ALiReZa4232/SCARA-Robot-Controller/تصاویر پروژه/IMG_20241123_105836.jpg

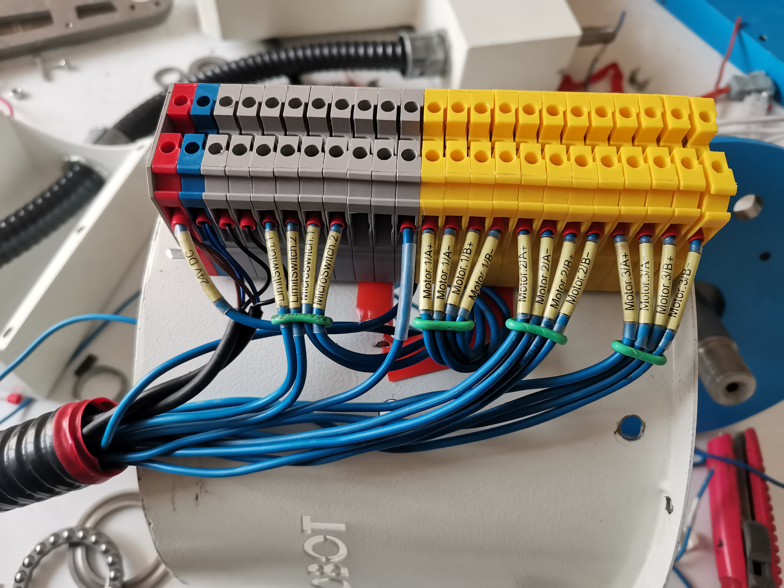
تصاویر پروژه/IMG_20241123_105836.jpg
