ALiReZa4232/SCARA-Robot-Controller/README.md

# SCARA-Robot-Controller
در این پایان‌نامه، به طراحی و پیاده‌سازی یک کنترلر پیشرفته برای ربات اسکارا پرداخته شده است. ربات‌های اسکارا به دلیل دقت و سرعت بالا در انجام وظایف صنعتی، به یکی از پرکاربردترین ربات‌ها در صنایع مختلف تبدیل شده‌اند. هدف اصلی این پروژه طراحی و پیاده‌سازی یک کنترلر پیشرفته برای ربات اسکارا می باشد که باعث افزایش دقت، سرعت، پایداری عملکرد و کارایی ربات در انجام وظایف صنعتی خواهد شد.
کنترلر طراحی شده از یک پردازنده اختصاصی STM32 استفاده می کند این پردازنده به عنوان هسته کنترلی ربات، وظیفه کنترل حرکت و مسیریابی خودکار بصورت خطی و زاویه ای بین موقعیت ها را داراست. همچنین این کنترلر دارای یک نمایشگر برای نمایش اطلاعات کنترلی به صورت محلی و یک وب سرور که امکان کنترل ربات از راه دور را فراهم می‌کند.
کنترلر طراحی شده برای ربات اسکارا یک سیستم الکترونیکی پیشرفته است که وظیفه دارد حرکات دقیق و سریع ربات را کنترل و هماهنگ کند. این کنترلر با استفاده از الگوریتم‌های پیشرفته و تکنیک‌های بهینه‌سازی، توانایی دارد به طور موثر به تغییرات محیطی پاسخ دهد و وظایف تکراری صنعتی را با دقت بالا اجرا کند. هدف اصلی این کنترلر افزایش کارایی، دقت، و پایداری ربات اسکارا در فرآیندهای تولیدی و مونتاژی است.
