ALiReZa4232/SCARA-Robot-Controller/پایان نامه/پایان نامه.pdf

دانشکده شهید منتظری
گروه برق و کنترل

پایان نامه کارشناسی رشته برق گرایش کنترل

عنوان

## طراحی و پیاده سازی کنترلر ربات اسکارا

استاد راهنما
جناب مهندس سید حسین لطفی

نگارش
علیرضا قمصری
محمدجواد محمدزاده

بهمن 1403

فهرست مطالب
فصل اول: معرفی و بررس ی ربات های صنعتی
.3-1 ویژگ ی های انواع ربات های صنعتی 6 |

فصل دوم: معرفی و بررس ی ربات اسکارا

.3-2 ویژگ ی های ربات اسکارا در صنعت 16 |

فصل سوم: معرفی و بررس ی اجزای ربات اسکارا

.2-1-1-3 نحوه تشخیص اتصاالت استپر موتور 26 |

3

فصل چهارم: معرفی و بررس ی کنترلر ربات اسکارا

.2-2-2-4 معرف ی پایه های LCD کاراکتر ی 46 |

4

.4-4 آموزش کار با رابط کاربری کنترلر 63 |
.1-4-4 معرفی منو ی اصلی کنترلر 64 |
.2-4-4 معرفی منو ی تنظیمات پایه 64 |
.3-4-4 معرفی منو ی تنظیمات پیشرفته 67 |
.4-4-4 معرفی منو ی تنظیمات برنامه 69 |
.1-1-5-4 نحوه ارتباط با ماژول 8266ESP 76 |
.2-1-5-4 ویژگی ها ی صفحات وب آنالین 76 |
.3-1-5-4 چالش های صفحات وب آنالین 76 |

5

6

فصل پنجم: س ینماتیک و پروفایلهای حرکتی ربات اسکارا

.2-5 معرفی و بررس ی پروفای ل های حرکتی 100 |
.1-2-5 پروفایل حرکت مثلث ی 100 |
.2-2-5 پروفایل حرکت ذوزنقه ای 101 |
.3-2-5 پروفایل حرکت Curve-S102 |
.4-2-5 مقایسه پروفایل حرکت Curve-S و ذوزنقه ای 104 |
.5-2-5 چالش های پروفایلهای حرکتی 106 |
.6-2-5 پیاده سازی پروفایل حرکت ذوزنقه ای برای استپرموتور 108 |
فصل ششم: برنامه نویسی کنترلر ربات اسکارا
.1-6 پیکربند ی م یکروکنترلر 32STM در محیط IDE Cube114 |
.2-6 معرف ی و بررس ی کتابخانه Configuration SCARA 128 |
.1-2-6 معرفی متغیرهای خارجی130 |
.2-2-6 معرفی متغیرهای داخلی130 |
.3-2-6 معرفی تابع ControllerSetup 130 |
.4-2-6 معرفی تابع ControllerSetting 133 |
.5-2-6 معرفی تابع ReadEncoder 135 |
.6-2-6 معرفی تابع Main137 |

7

.3-6 معرف ی و بررس ی کتابخانه Server 139 |
.1-3-6 معرفی متغیرهای خارجی139 |
.2-3-6 معرفی متغیرهای داخلی139 |
.3-3-6 معرفی تابع extractNumFromCode 140 |
141 | HAL_UART_RxCpltCallback | تابع | معرفی | .4-3-6
.5-3-6 معرفی تابع reseiveSetting142 |
.6-3-6 معرفی تابع reseiveMove145 |
.7-3-6 معرفی تابع reseiveCode146 |
.8-3-6 معرفی تابع sendProgram148 |
.9-3-6 معرفی تابع sendRun 149 |
.10-3-6 معرفی تابع sendPause149 |
.11-3-6 معرفی تابع sendClear151 |
.12-3-6 معرفی تابع sendOk152 |
.13-3-6 معرفی تابع sendSetting 152 |
.4-6 معرف ی و بررس ی کتابخانه Profile Motion153 |
.5-6 معرف ی و بررس ی کتابخانه Setting Basic153 |
.6-6 معرف ی و بررس ی کتابخانه Setting Advanced 153 |
.7-6 معرف ی و بررس ی کتابخانه Setting Program 153 |
.8-6 معرف ی و بررس ی کتابخانه Setting Homing 153 |
فصل هفتم: برنامه نویسی وب سرور کنترلر
.1-7 پیکربند ی ماژول 8266ESP در محیط IDE Arduino 155 |
.2-7 معرفی و بررس ی کدهای آردوینو 158 |
.1-2-7 معرفی تابع setup 158 |
.2-2-7 معرفی تابع loop160 |

8

.3-2-7 معرفی تابع processIncomingSerialData 162 |
.4-2-7 معرفی تابع processOkCommand 163 |
.5-2-7 معرفی تابعtrimDataBuffer 165 |
.6-2-7 معرفی تابع handleReceiveDataRequest166 |
.7-2-7 معرفی تابع handleSendDataRequest 170 |
.8-2-7 معرفی تابع handleCode 171 |
.9-2-7 معرفی تابع handlePositions 174 |
.10-2-7 معرفی تابع handleSetting 176 |
.11-2-7 معرفی تابع sendPositionToController 177 |
.12-2-7 معرفی تابع sendCodeToController 178 |
.13-2-7 معرفی تابع getResentSettingData 181 |
.14-2-7 معرفی تابع getResentPositionsData 182 |
.15-2-7 معرفی تابع extractValueFromCode 183 |
.16-2-7 معرفی تابع saveToEEPROM 184 |
.17-2-7 معرفی تابع readFromEEPROM186 |
.18-2-7 معرفی تابع handleRoot 187 |
.3-7 معرفی و بررس ی کدهای HTML188 |
.4-7 معرفی و بررس ی کدهای Script Java 188 |
.5-7 معرفی و بررس ی کدهای CSS 188 |

## 1 فصل اول: معرفی و بررسی ربات های صنعتی

فصل اول: معرفی و بررسی ربات های صنعتی

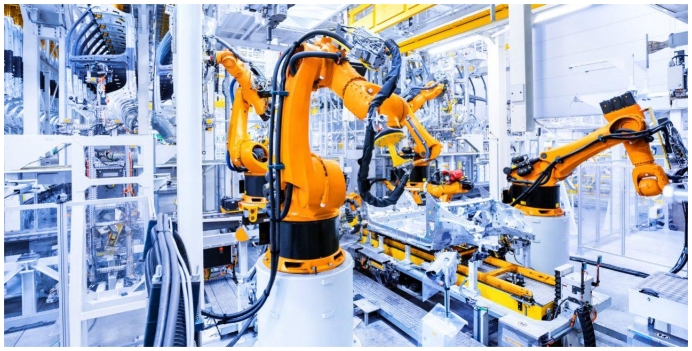
[picture p3: figure]
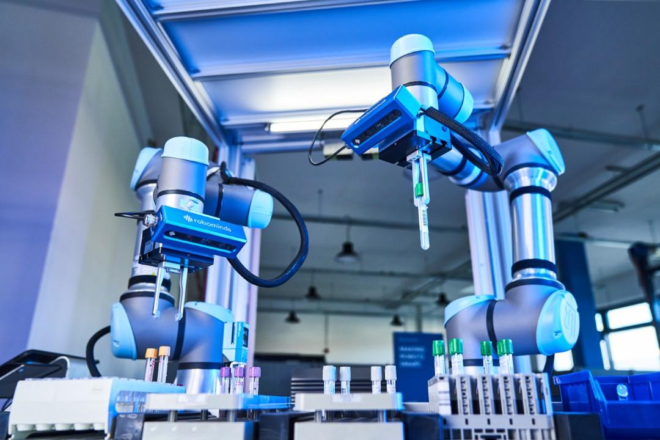
[picture p4: figure]

2

شکل -1 -1 معرفی و بررسی ربات های صنعتی

.1-1 ربات صنعتی چیست؟
رباتهای صنعتی ماشینهای خودکاری هستند که با داشتن قابلیتهای کنترل اتوماتیک، برنامه پذیری و چند منظوره بودن، بیشترین جایگاه را در صنایع گوناگون به خود اختصاص داده است. این رباتها معموالً دارای چندین محور حرکتی هستند و می توانند وظایفی مانند جوشکاری، مونتاژ، بسته بندی و بازرسی را با دقت و سرعت باال انجام دهند . این رباتها اغلب در صنعت و تولید انبوه کاربرد دارند و میتوانند به طور خودکار وظایف تکراری و پیچیده را انجام دهند همچنین آنها وابستگی انسان را کاهش می دهند و بهره وری و ظرفیت فرآیندی را نیز افزایش می دهند .

شکل -1 -2 ربات صنعتی چیست؟

فصل اول: معرفی و بررسی ربات های صنعتی

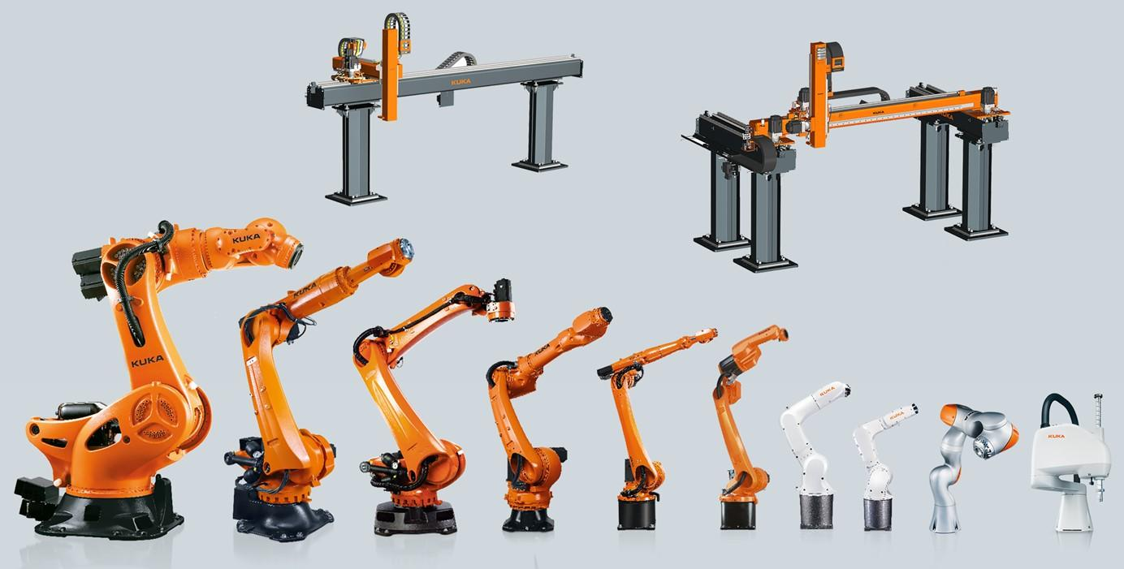
[picture p5: figure]
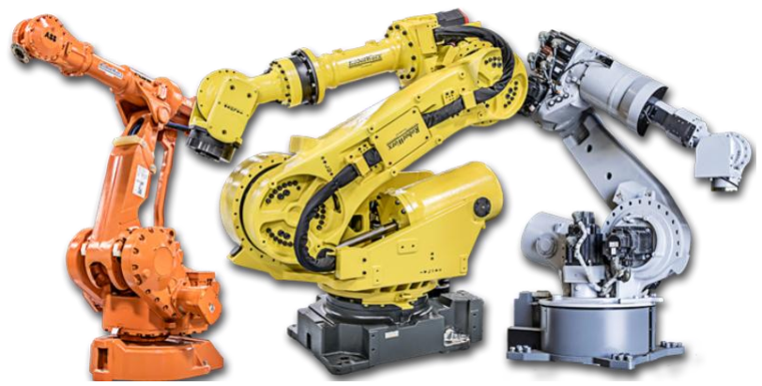
[picture p6: figure]

3

.2-1 انواع ربات های صنعتی
ربات های صنعتی به انواع مختلفی تقسیم می شوند که هر کدام برای کاربردهای خاصی طراحی شدهاند . در این بخش به بررسی مهم ترین انواع ربات های صنعتی می پردازیم:

شکل -1 -3 انواع ربات های صنعتی

.1-2-1 ربات بازویی )Robot Arm) ربات های بازویی یا بازوهای رباتیک، متنوع ترین و پرکاربردترین نوع از انواع ربات های صنعتی هستند . آنها از یک سری اتصاالت چرخشی تشکیل شده اند که توسط موتورهای سروو کار می کنند همچنین این مفاصل، انعطاف پذیری بازوی انسان را تقلید می کنند و فوقالعاده سریع هستند .

شکل -1 -4 ربات بازویی
این ربات ها به طور معمول، میتوانند سه تا شش محور حرکتی داشته باشند که به آنها اجازه می دهد در فضاهای محدود حرکت کنند و کارهای پیچیده را انجام دهند .

فصل اول: معرفی و بررسی ربات های صنعتی

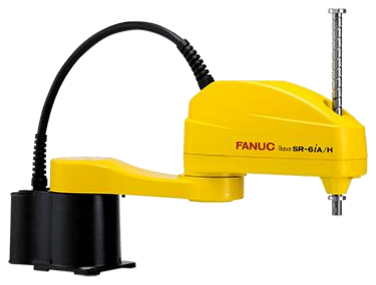
[picture p7: figure]
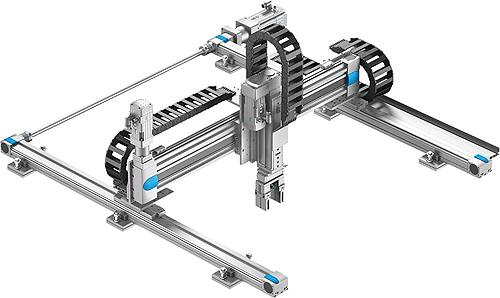
[picture p8: figure]

4

.2-2-1 ربات اسکارا )Robot SCARA) ربات اسکارا یکی از انواع ربات های بازویی می باشد که بدلیل طراحی خاص آن در دسته بندی مجزایی از بازو های رباتیک شناخته می شوند. ربات اسکارا دارای انعطاف پذیری کمتری نسبت به ربات های بازویی است، اما در برخی کاربردها مانند مونتاژ و جابه جایی قطعات کوچک بسیار کارآمد تر هستند.

شکل -1 -5 ربات اسکارا

.3-2-1 ربات کارتزین )Robot Cartesian)
1 | ربات کارتزین که به عنوان رباتهای خطی یا گانتری
نیز شناخته می شود، دارای سه محور خطی
است که به آن اجازه می دهد در یک فضای سه بعدی حرکت کند . هر محور، توسط یک محرک خطی مانند بال اسکرو یا موتور خطی هدایت می شود که امکان حرکت دقیق و مستقل را فراهم می کند .

شکل -1 -6 ربات کارتزین
این بازوها معموالً در کاربردهایی که نیاز به دقت باال و حرکات خطی دارند، مورد استفاده قرار می گیرند .

1 Gantry

فصل اول: معرفی و بررسی ربات های صنعتی

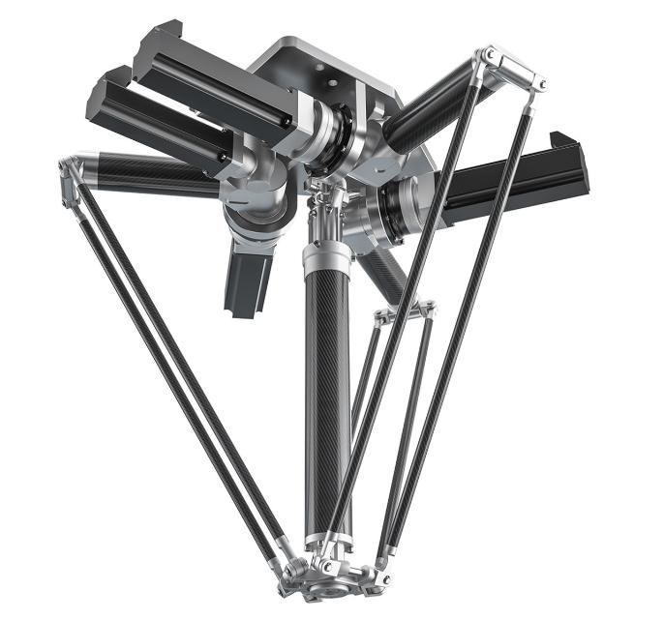
[picture p9: figure]
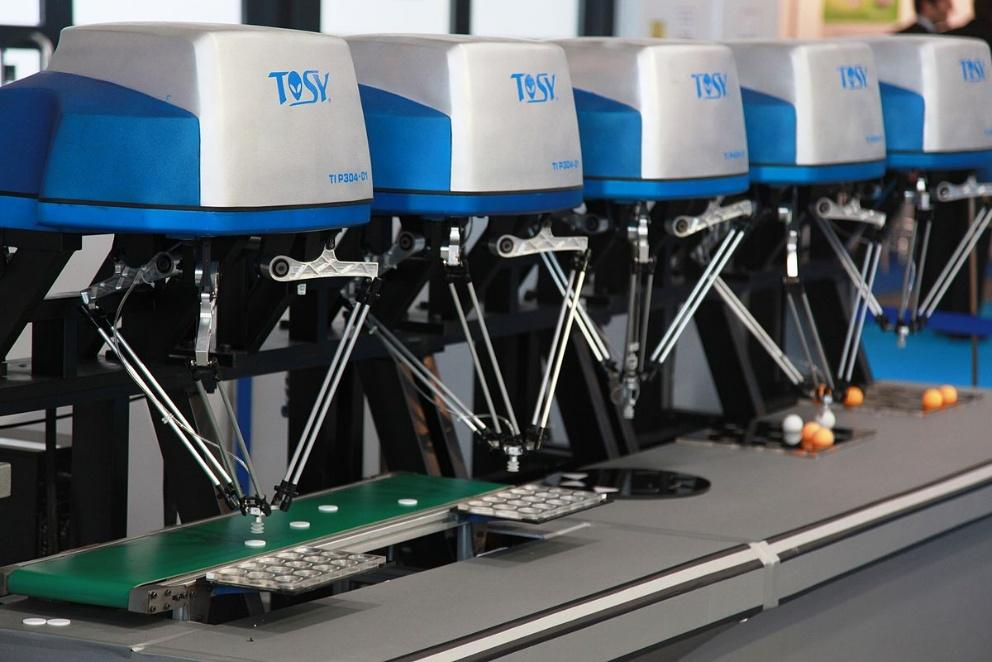
[picture p10: figure]

5

.4-2-1 ربات دلتا یا موازی

1
)Delta Robot(
ربات دلتا گونه ای از انواع ربات های صنعتی هستند که دارای چندین بازوی موازی متصل به یک جایگاه مثلثی شکل می باشند. این جایگاه در باالی محل کار نصب می شود و هر بازو میزبان یک سروو موتور با گشتاور باال می باشد . شفت موتور به بازویی متصل است که در جهت عمود بر محور چرخش موتور امتداد دارد.

شکل -1 -7 ربات دلتا
این بازوها به دلیل سرعت و دقت باال، درکاربردهایی مانند بسته بندی و مونتاژ قطعات کوچک بسیار مفید هستند .

شکل -1 -8 کاربرد ربات دلتا

1 Parallel Robot

فصل اول: معرفی و بررسی ربات های صنعتی

6

.3-1 ویژگی های انواع ربات های صنعتی ربات های صنعتی به دلیل قابلیتهای فراوان و انعطاف پذیری باال، مزایای بسیاری را برای صنایع مختلف به ارمغان می آورند. در این بخش به بررسی مزایای ربات های صنعتی می پردازیم:

- افزایش بهره وری
این ربات ها می توانند وظایف تکراری و زمان بر را با سرعت و دقت باال انجام دهند که منجر به افزایش تولید و کاهش زمان تولید میشود.
- بهبود کیفیت و دقت
این ربات ها میتوانند وظایفی مانند جوشکاری، مونتاژ و بسته بندی را با دقت باال انجام دهند و خطاهای انسانی را به حداقل برسانند .
- کاهش هزینه ها
استفاده از ربات های صنعتی می تواند هزینه های تولید را کاهش دهد . این ربات ها نیاز به استراحت ندارند و می توانند به صورت مداوم کار کنند که منجر به کاهش هزینه های نیروی انسانی و افزایش بهره وری می شود.
- افزایش ایمنی
این ربات ها میتوانند در محیط های خطرناک و با مواد خطرناک کار کنند و خطرات احتمالی را کاهش دهند .
- انعطاف پذیری بال
این ربات ها میتوانند به راحتی برنامه ریزی و تنظیم شوند تا وظایف مختلفی را انجام دهند و به تغییرات محیطی واکنش نشان دهند .
- کاهش زمان توقف
این ربات ها می توانند به صورت مداوم کار کنند و نیاز به تعمیرات و نگهداری کمتری دارند که منجر به افزایش بهره وری و کاهش هزینه ها می شود.
- افزایش سرعت تولید
ربات های صنعتی می توانند وظایف تولیدی را با سرعت باال انجام دهند که منجر به افزایش سرعت تولید و کاهش زمان تولید می شود.

فصل اول: معرفی و بررسی ربات های صنعتی

7

.4-1 چالش های انواع ربات های صنعتی ربات های صنعتی با چالش های متعددی مواجه هستند که می تواند تأثیرات قابل توجهی بر عملکرد و کارایی آنها داشته باشد . در این بخش به بررسی چالش های ربات های صنعتی می پردازیم:

- هزینه های اولیه بال
خرید و نصب ربات های صنعتی نیاز به سرمایه گذاری قابل توجهی دارد که ممکن است برای بسیاری از شرکت ها و صنایع کوچک چالشبرانگیز باشد .
- نیاز به نظارت مداوم
ربات های صنعتی نیاز به نظارت و نگهداری مداوم دارند تا از بروز خطاها و مشکالت مکانیکی جلوگیری شود. این نیاز به نظارت مداوم می تواند هزینه های اضافی برای شرکت ها ایجاد کند و بهره وری را کاهش دهد .
- محدودیت در تطبیق پذیری
ربات های صنعتی نمی توانند به اندازه دست انسان تطبیق پذیر باشند . این محدودیت در تطبیق پذیری
می تواند در برخی کاربردها مشکلساز باشد .
- خطر بیکاری
استفاده گسترده از ربات های صنعتی می تواند منجر به بیکاری کارگران انسانی شود. این موضوع
می تواند تأثیرات اجتماعی و اقتصادی منفی داشته باشد و نیاز به برنامه ریزی دقیق برای مدیریت این تغییرات دارد.
- توقف تولید در صورت خرابی در صورت خرابی ربات های صنعتی، کل خط تولید ممکن است متوقف شود. این توقف تولید می تواند هزینه های زیادی را به شرکتها تحمیل کند و بهره وری را کاهش دهد .
- محدودیت در ظرفیت بار
این محدودیت ها میتوانند در برخی کاربردها مشکل ساز باشند و نیاز به استفاده از ربات های قوی تر و گران تر را ایجاد کنند .
- محدودیت های اتصال
این محدودیت ها می توانند کارایی و انعطاف پذیری بازوها را کاهش دهند و نیاز به استفاده از تکنولوژی های پیشرفته تر را ایجاد کنند .

فصل اول: معرفی و بررسی ربات های صنعتی

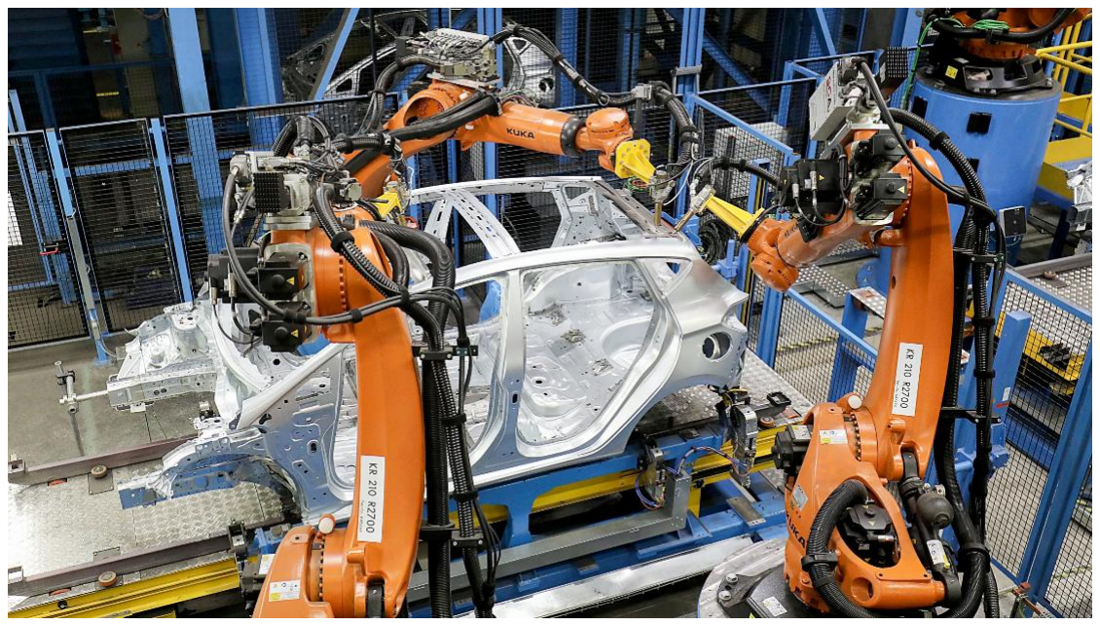
[picture p11: figure]
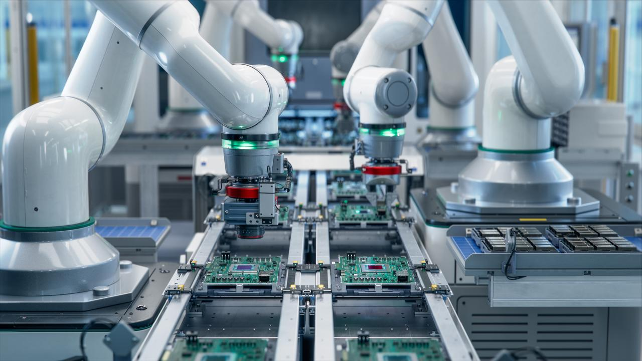
[picture p12: figure]

8

.5-1 کاربردهای ربات های صنعتی ربات های صنعتی به دلیل قابلیتهای فراوان و انعطاف پذیری باال، در صنایع مختلفی بکار گرفته می شوند . در این بخش به بررسی کاربردهای ربات های صنعتی می پردازیم:

- صنعت خودروسازی
این ربات ها می توانند وظایفی مانند جوشکاری، مونتاژ، رنگآمیزی و جابه جایی قطعات را با دقت و سرعت باال انجام دهند .

شکل -1 -9 کاربرد ربات های صنعتی در صنعت خودروسازی
- صنعت الکترونیک
ربات های صنعتی برای مونتاژ قطعات کوچک و حساس بکار می روند . این ربات ها می توانند با دقت باال و بدون خطا، قطعات الکترونیکی را مونتاژ کنند و کیفیت محصوالت نهایی را بهبود بخشند .

شکل -1 -10 کاربرد ربات های صنعتی در صنعت الکترونیک

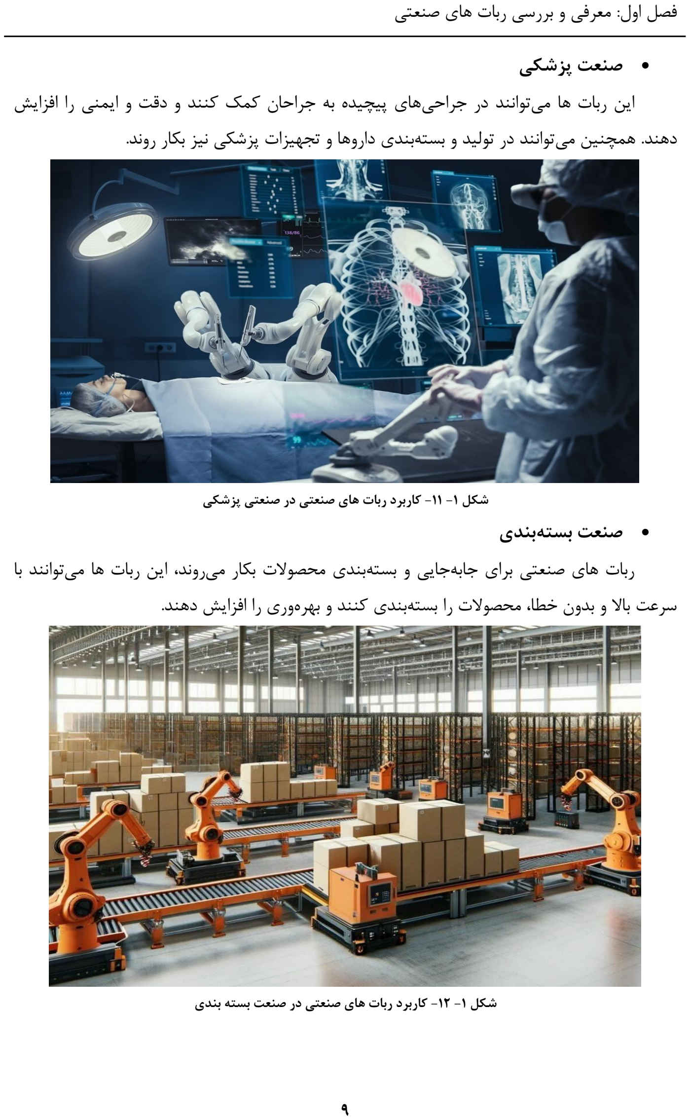
[picture p13: page 17]

فصل اول: معرفی و بررسی ربات های صنعتی

9

- صنعت پزشکی
این ربات ها می توانند در جراحیهای پیچیده به جراحان کمک کنند و دقت و ایمنی را افزایش دهند . همچنین می توانند در تولید و بسته بندی داروها و تجهیزات پزشکی نیز بکار روند .

شکل -1 -11 کاربرد ربات های صنعتی در صنعتی پزشکی
- صنعت بسته بندی
ربات های صنعتی برای جابه جایی و بسته بندی محصوالت بکار می روند ، این ربات ها می توانند با سرعت باال و بدون خطا، محصوالت را بسته بندی کنند و بهرهوری را افزایش دهند .

شکل -1 -12 کاربرد ربات های صنعتی در صنعت بسته بندی

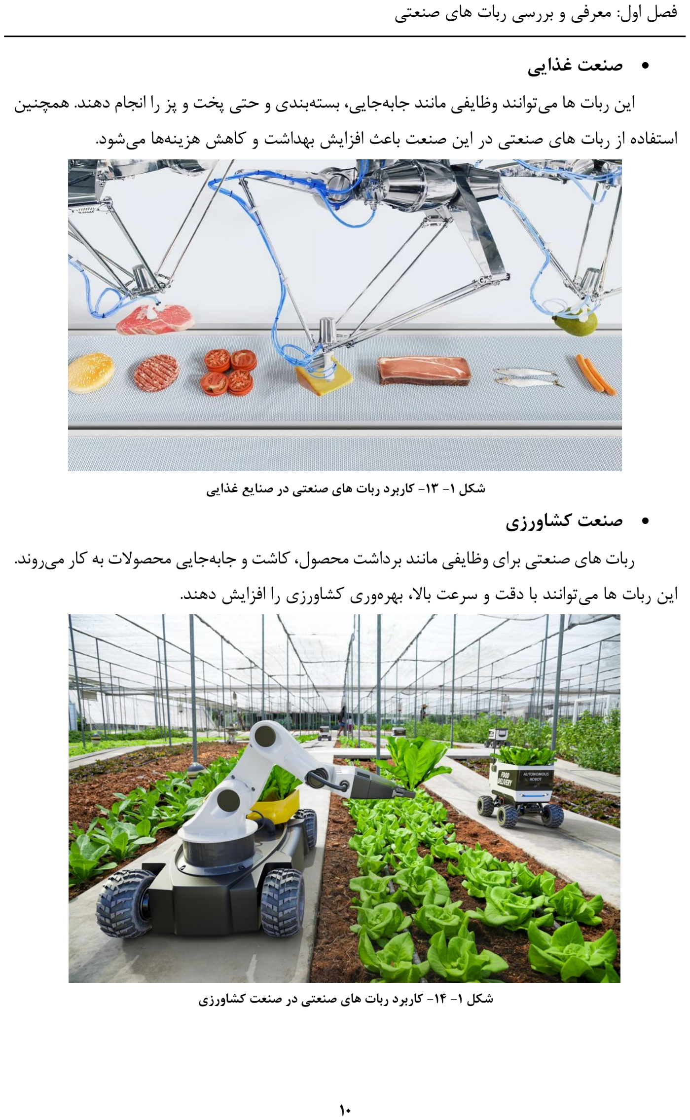
[picture p14: page 18]

فصل اول: معرفی و بررسی ربات های صنعتی

10

- صنعت غذایی
این ربات ها می توانند وظایفی مانند جابه جایی، بسته بندی و حتی پخت و پز را انجام دهند . همچنین استفاده از ربات های صنعتی در این صنعت باعث افزایش بهداشت و کاهش هزینه ها میشود.

شکل -1 -13 کاربرد ربات های صنعتی در صنایع غذایی
- صنعت کشاورزی
ربات های صنعتی برای وظایفی مانند برداشت محصول، کاشت و جابه جایی محصوالت به کار می روند . این ربات ها می توانند با دقت و سرعت باال، بهره وری کشاورزی را افزایش دهند .

شکل -1 -14 کاربرد ربات های صنعتی در صنعت کشاورزی

فصل اول: معرفی و بررسی ربات های صنعتی

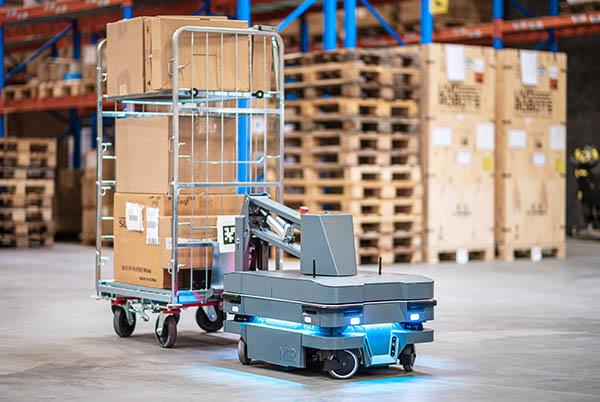
[picture p15: figure]

11

- صنعت حمل و نقل
ربات های صنعتی برای جابه جایی و بارگیری محموله ها به کار می روند . این ربات ها می توانند با دقت و سرعت باال، بهره وری حمل و نقل را افزایش دهند .

شکل -1 -15 کاربرد ربات های صنعتی در صنعت حمل و نقل

## 2 فصل دوم: معرفی و بررسی ربات اسکارا

فصل دوم: معرفی و بررسی ربات اسکارا

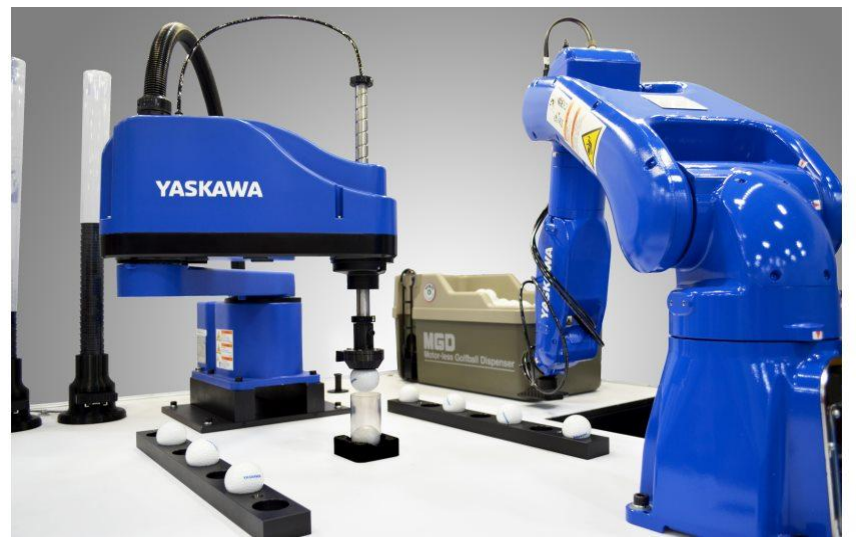
[picture p16: figure]
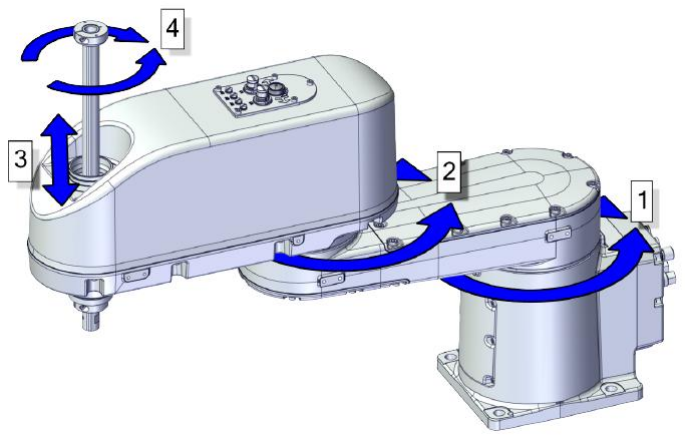
[picture p17: figure]

13

با ظهور فناوری رباتیک، جای تعجب نیست که صنایع بیشتری به ربات ها به عنوان راهی ساده برای افزایش بهره وری و ساده سازی اتوماسیون روی می آورند. از جمله این ربات ها میتوان به ربات اسکارا اشاره کرد که یکی از محبوب ترین و کاربرپسندترین آنها است.

شکل -2 -1 معرفی و بررسی ربات اسکارا
.1-2 ربات اسکارا چیست؟

نام SCARA مخفف Arm Robot Assembly Compliance Selective است به معنی بازوی رباتیک
مونتاژ با تطبیق پذیری انتخابی که به توانایی ربات برای حرکت آزادانه و حفظ صالبت در سه محور در حین سازگاری در محور نهایی اشاره دار د. این ربات ها معموالً دارای سه یا چهار محور هستند که به آنها اجازه می دهد وظایف را با سرعت و
دقت باال انجام دهند .

شکل -2 -2 محورهای ربات اسکارا

فصل دوم: معرفی و بررسی ربات اسکارا

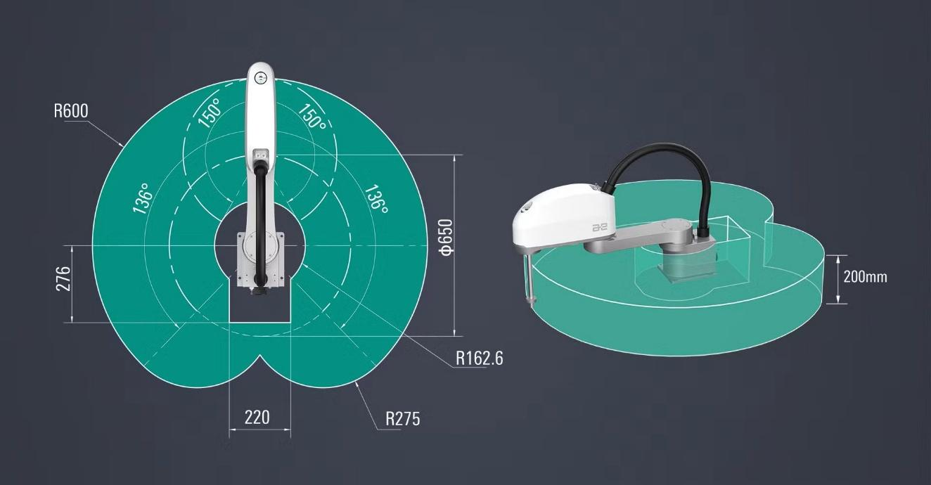
[picture p18: figure]

14

رباتهای اسکارا بدلیل دامنه حرکتی منحصر به فردشان، به ویژه در مختصات XY ، از دیگر رباتهای صنعتی متمایز هستند . این ربات ها می توانند در امتداد محورهای X و Y حرکت کنند این بدین معنا است که آن ها می توانند بین چپ و راست (X (و باال و پایین (Y (حرکت نمایند یا به زبان ساده، می توانند به صورت افقی در هر جهتی در فضای کاری خود حرکت کنن د . همچنین با وجود برخی محدودیت ها می توانند به صورت عمودی حرکت نیز داشته باشند اما در این حالت محور عمودی ثابت خواهد ماند.

شکل -2 -3 دامنه حرکتی ربات اسکارا

این رباتهای مونتاژی، قادر به انجام حرکات انعطاف پذیر و سخت هستند . این نوع انعطافپذیری آنها را برای کارهایی مانند انتخاب و مکان یابی، مرتب سازی و مونتاژ مناسب می کند و استفاده از این نوع ربات، مثل داشتن یک کارگر خط مونتاژ فوق العاده کارآمد است که هیچ وقت خسته نمی شود و اشتباه نمیکند .

فصل دوم: معرفی و بررسی ربات اسکارا

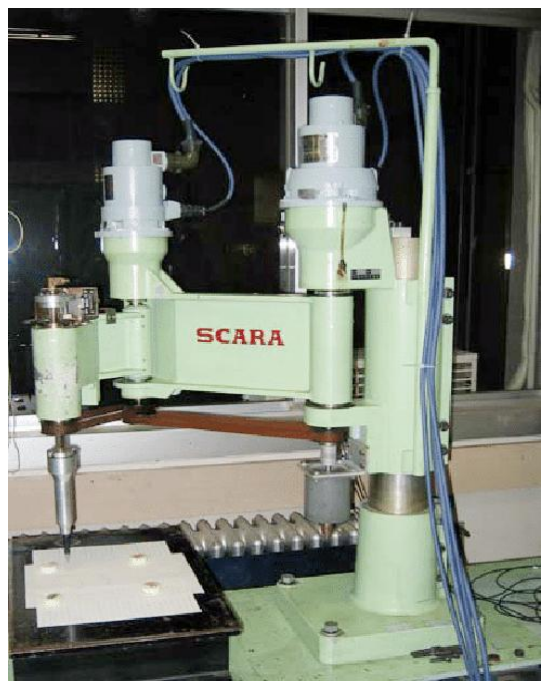
[picture p19: figure]

15

.2-2 تاریخچه ربات اسکارا
1 | رباتهای اسکارا سابقه ای طوالنی و قدیمی دارند . در سال ،1977 پروفسور هیروشی ماکینو
از
دانشگاه یاماناشی در سمپوزیوم بین المللی ربات های صنعتی در توکیو ژاپن شرکت کرد . در این رویداد، او شاهد یک اختراع انقالبی در ربات مونتاژ SIGMA بود. ماکینو با الهام از اولین ربات مونتاژکننده، کنسرسیوم ربات اسکارا را تشکیل داد که شامل 13 شرکت ژاپنی بود. هدف این گروه بهبود بیشتر ربات های مونتاژ از طریق تحقیقات اختصاصی بود. کنسرسیوم به سرعت کارکرد و اولین نمونه اولیه آن ها از ربات اسکارا یک سال بعد و در سال 1978 انجام شد . آن ها ساخته خود را بر روی طیف وسیعی از کاربردهای صنعتی آزمایش کردند و طراحی موجود را بیشتر بهبود بخشیدند و نسخه دوم را دو سال بعد منتشر کردند .

شکل -2 -4 یکی از نمونه های اولیه ربات اسکارا

هنگامی که اولین ربات تجاری اسکارا در سال 1981 عرضه شد، از آن به عنوان یک طراحی رباتیک پیشگامانه استقبال شد . این ربات ارائه شده، نسبت به قیمت، عملکرد بسیار مطلوبی داشت و فرآیندهای تولید صنعتی را در سراسر جهان متحول کرد.

1 Hiroshi Makino

فصل دوم: معرفی و بررسی ربات اسکارا

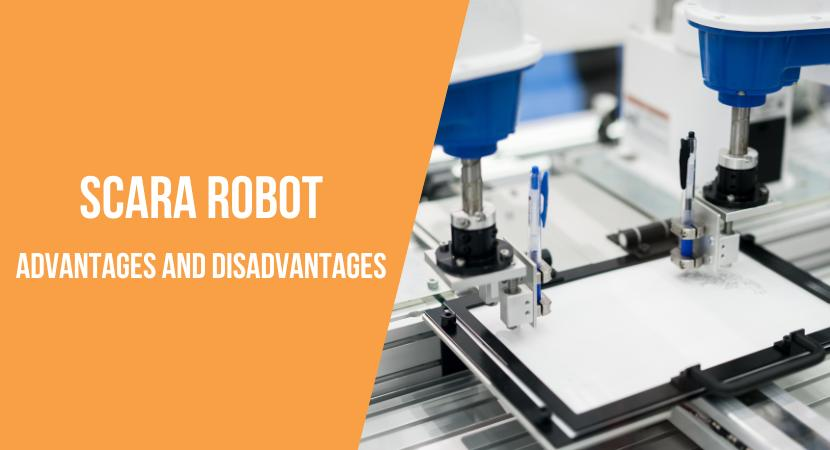
[picture p20: figure]

16

شکل -2 -5 مزایا و معایب ربات اسکارا
.3-2 ویژگی های ربات اسکارا در صنعت رباتهای اسکارا بدلیل قابلیتهایی که دارند، مزایای زیادی می توانند برای استفاده کنندگان داشته باشند . از جمله این مزایا می توان به موارد زیر اشاره کرد:
- دقت بال
ربات اسکارا به دلیل دقت باورنکردنی شناخته می شود که آن را برای کارهایی که نیاز به مونتاژ دقیق دارند، عالی می کند . محور ثابت Z آنها از حرکات غیرضروری باال و پایین جلوگیری میکند و کمک قابل توجهی به این دقت می کند .
- سرعت بال
رباتهای اسکارا از سریع ترین ربات ها در دنیای ربات های صنعتی هستند و پس از رباتهای دلتا در
رتبه دوم از لحاظ سرعت قرار دارند که این سرعت باال برای کارهای تولیدی که نیاز به پردازش سریع دارند مفید است.
- فشرده بودن و حجم کم
ربات اسکارا در مقایسه با سایر ربات ها نسبتاً کوچک است. این ربات محدوده عملیاتی کوچکی دارد
که آنرا برای فضاهای کاری محدودتر منحصر به فرد می کند .

فصل دوم: معرفی و بررسی ربات اسکارا

17

- مقرون به صرفه
یک ربات اسکارا، ارزش بسیار خوبی از نظر هزینه ارائه می دهد . اندازه جمع و جور آن به این معنی
است که به مواد زیادی برای ساخت نیاز ندارد و قطعات متحرک کمتری نسبت به سایر انواع ربات )به عنوان مثال ربات های بازویی( دارد که همه این عوامل باعث کاهش هزینه ها می شود و آن ها را به انتخاب هوشمندانهای برای تولیدکنندگان با بودجه کم، تبدیل میکند .
- ادغام آسان
رباتهای اسکارا میتوانند به راحتی در سیستم های خودکار موجود ادغام شوند و در کنار سایر ماشینها بهخوبی کار کنند . این رباتهای چهار محوره، چه در حال برداشتن و قرار دادن، مونتاژ، مراقبت از ماشینها یا توزیع مواد و غیره همه کارهای هستند که کار را آسان تر و کارآمدتر می کنند .
- برنامه نویسی و راه اندازی آسان عالوه بر این، برنامه نویسی این رباتها نیز بسیار آسان است، به خصوص اگر از نرم افزار RoboDK
به عنوان نرم افزار برنامه نویسی ربات خود استفاده می کنید . کتابخانه این نرم افزار شامل ده ها ربات محبوب اسکارا است.

فصل دوم: معرفی و بررسی ربات اسکارا

18

.4-2 چالش های ربات اسکارا در صنعت با تمام این مزایا، همانطورکه در باال ذکر شد، چالش های زیادی نیز می توانند برای استفاده کنندگان داشته باشند . از جمله این چالش ها را می توان به موارد زیر اشاره کرد:
- دامنه حرکت محدود
این نوع ربات به یک فضای کاری نسبتاً کوچک و خاص محدود می شود. همچنین به اندازه انواع دیگر رباتها مانند رباتهای صنعتی 6 محوره انعطاف پذیر نیستند .
- قابلیت های محدود
1 | از نظر قابلیت استفاده، آن ها بسیار عقبتر از ربات های مدرن )ربات های مشارکتی
( هستند که برای
کار در کنار انسانها طراحی شدهاند و معموالً 6 محور ارائه می دهند .
- ظرفیت بار محدود
با وجود اینکه این ربات ها سرعت باالیی را ارائه می دهند؛ تمایل دارند در اندازه بار خود محدود باشند . باالترین باری که رباتهای اسکارا میتوانند تحمل کنند در حدود 30 تا 50 کیلوگرم است، درحالی که بازوهای ربات های صنعتی 6 محوره می توانند تا 2000 کیلوگرم را تحمل کنند .

این چالش ها انواع وظایفی را که ربات اسکارا برای آنها مناسب است محدود می کنند و آنها را برای کارهایی که به انعطاف پذیری، دامنه حرکت یا سازگاری بیشتری نیاز دارند، نامناسب میسازند .

1 Collaborative Robot - Cobot

فصل دوم: معرفی و بررسی ربات اسکارا

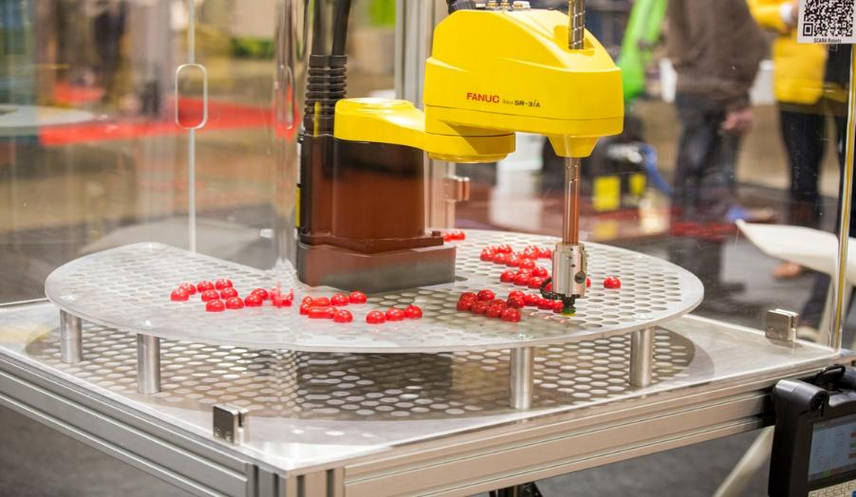
[picture p21: figure]
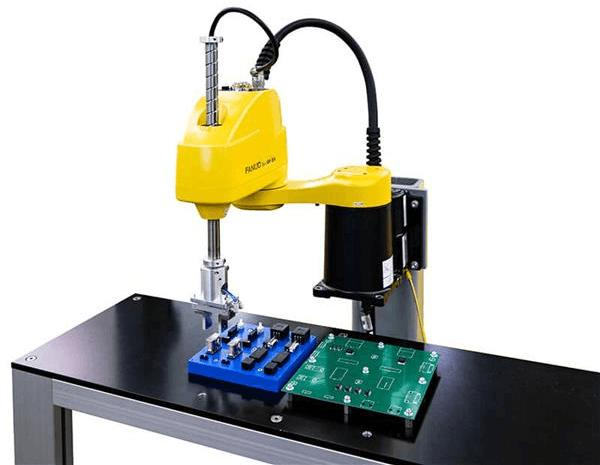
[picture p22: figure]

19

.5-2 کاربردهای ربات اسکارا در صنعت رباتهای اسکارا ماشینهایی هستند که به طور هدفمند ساخته شدهاند و دارای مکانیک منحصر به فردی هستند که آن ها را برای کاربردهای خاص ایده آل میکند . این کاربردها عبارت اند از:
- عملیات انتخاب و جاسازی
وقتی صحبت از مقرون به صرفه بودن و سرعت در کارهای انتخاب و جابه جایی به میان می آید، رباتهای اسکارا بیرقیب هستند . راهاندازی این نوع ربات فوقالعاده آسان است و شما می توانید از آنها انتظار داشته باشید که با استفاده از ابزارهای مختلف اثرگذار، محصوالت را به طرز ماهرانه ای انتخاب کنند .

شکل -2 -6 فرآیند انتخاب و جابجایی توسط ربات اسکارا
- مونتاژ
ربات اسکارا نقش مهمی در تولید و خطوط مونتاژ، از جابه جایی مواد و مرتب سازی اقالم گرفته تا جایگذاری قطعات در کنار هم دارند . آن ها در صنایعی مانند الکترونیک که شامل مونتاژ طرح های پیچیده هستند، بسیار محبوب می باشند .

شکل -2 -7 فرآیند مونتاژ توسط ربات اسکارا

فصل دوم: معرفی و بررسی ربات اسکارا

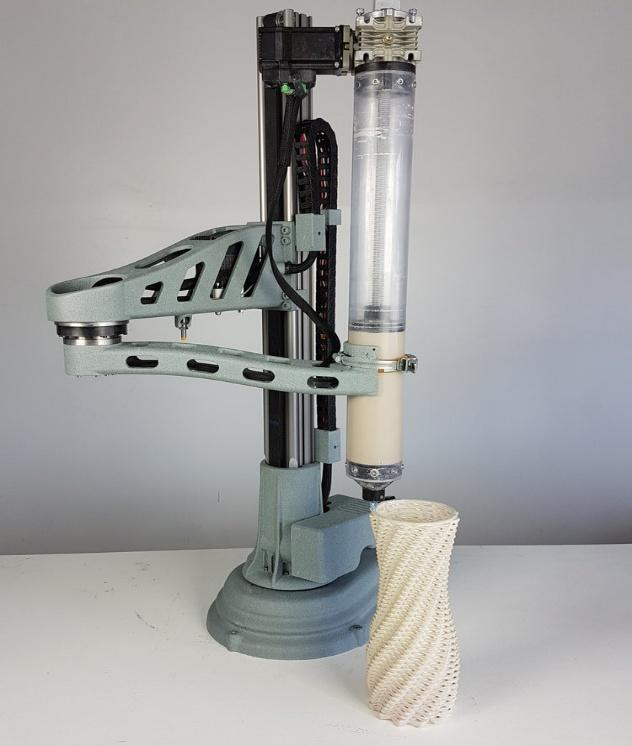
[picture p23: figure]

20

- پرینتر سه بعدی

با معرفی رباتیک، پرینترهای سه بعدی روز به روز در صنایع مختلف به ویژه در تولید، محبوبیت بیشتری پیدا کرده است. در حالی که ربات های 6 محوره اغلب می توانند برای پروژه های پرینت سه بعدی بزرگ تر استفاده می شوند، رباتهای اسکارا برای کاربردهای پرینت سه بعدی در مقیاس کوچک مفید هستند .

شکل -2 -8 فرآیند پرینت سه بعدی توسط ربات اسکارا
- بستهبندی و پالت سازی
عملیات جابهجایی مواد، مانند بسته بندی، پالت گذاری و برچسب زدن، معموالً یکنواخت هستند . رباتهای اسکارا می توانند این وظایف تکراری را به طور خودکار انجام دهند و درعین حال از مدیریت راحت و دقیق فرآیند اطمینان حاصل کنند .
- توزیع و پخش مواد
استفاده از چسبها، رنگ آمیزی، آب بندی، کارهایی است که همه از ربات اسکارا بهره می برند . این رباتها نه تنها این وظایف را بادقت و نتایج کلی بهتر انجام می دهند؛ بلکه به کاهش ضایعات و بهبود دقت کار در طول فرآیند توزیع کمک می کنند .

فصل دوم: معرفی و بررسی ربات اسکارا

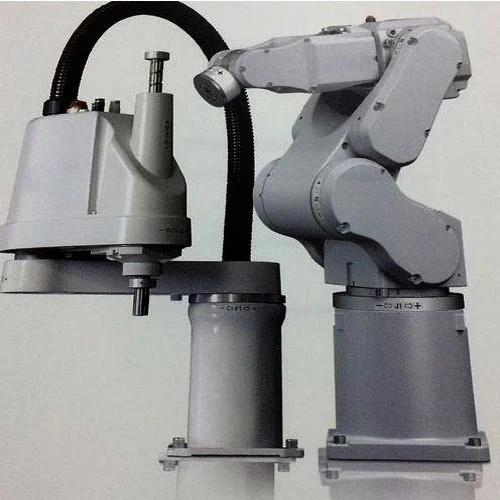
[picture p24: figure]

21

.6-2 تفاوت ربات اسکارا با سایر انواع رباتها رباتهای اسکارا از چند جهت با رباتهای صنعتی استاندارد 6 محوره متفاوت هستند . یکی از تفاوت های اصلی در نحوه طراحی آن ها است.

شکل -2 -9 تفاوت ربات اسکارا با سایر انواع ربات ها

واضحترین تفاوت این است که یک ربات 6 محوره دارای شش محور یا درجه آزادی است که به آن ها امکان می دهد در طیف گسترده ای از جهات حرکت کنند و وظایف خود را در محورهای مختصاتی مختلف انجام دهند؛ اما ربات های اسکار تنها چهار محور یا درجه آزادی دارند . از آنجایی که این رباتها فقط چهار محور برای کنترل دارند، در مقایسه با سایر انواع رباتهای صنعتی بسیار سریع هستند همچنین برنامه ریزی این ربات ها ساده می باشد؛ زیرا سینماتیک معکوس موجود در این رباتها، بسیار ساده تر از بازوهای رباتیک صنعتی با 6 درجه آزادی است. یکی دیگر از تفاوت های کلیدی بین ربات های اسکارا و رباتهای 6 محوره، دامنه حرکت آن ها است. رباتهای اسکارا دامنه حرکت محدودی در صفحه عمودی دارند؛ زیرا بازوی آن ها برای حرکت در درجه اول در صفحه افقی طراحی شده است که این باعث میشود برای کارهایی که نیاز به حرکات دقیق یا جابهجایی قطعات کوچک در یک فضای کاری خاص دارند، مناسب باشند؛ اما برای کارهایی که به دامنه وسیعی از حرکات عمودی یا حرکات پیچیده نیاز دارند، کمتر مناسب هستند . عالوه بر این، ربات های اسکارا معموالً کوچک تر و فشرده تر از رباتهای 6 محوره هستند و ادغام آن ها
در فضاهای کاری کوچک تر را آسانتر می کند . همچنین سریع تر و دقیق تر از ربات های 6 محور هستند که آنها را برای کارهایی که نیاز به مونتاژ با سرعت باال یا جابه جایی قطعات کوچک دارند، مناسب می کند .

## 3 فصل سوم: معرفی و بررسی اجزای ربات اسکارا

فصل سوم: معرفی و بررسی اجزای ربات اسکارا

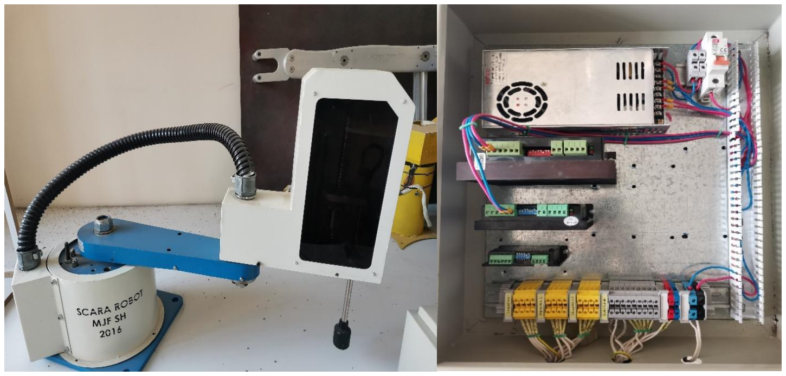
[picture p25: figure]

23

در فصل های پیشین بطور کامل درمورد ربات های صنعتی بخصوص ربات اسکارا بحث شد اما در
این فصل قرار هست بطور تخصصی درمورد ربات ساخته شده در دانشگاه بپردازیم. ربات اسکارا بطور کلی از دو بخش مکانیک ربات و تابلو کنترل یا فرمان ربات تشکیل می شود.

شکل -3 -1 تابلو فرمان و مکانیک ربات اسکارا
.1-3 مکانیک ربات اسکارا
مکانیک یا بدنه اصلی ربات اسکارا متشکل از سه محور می باشد که دو محور آن بصورت چرخشی
یا مفصلی هستند که به یکدیگر متصل شده اند و محور نهایی نیز یک محور خطی می باشد که به عنوان محور Z ربات شناخته می شود. در هر سه محور ربات از موتور های پله ای یا استپر موتور به عنواع محرک استفاده شده است که در
محور اول و دوم به صورت مستقیم کوپل شده است و در محور نهایی نیز از یک بال اسکرو استفاده شده که به واسطه پولی و تسمه به موتور متصل شده است. سنسورهای استفاده شده در این ربات به عنوان تنظیم کننده محدوده مجاز حرکت بازوهای ربات اسکارا می باشند که سنسور محدود کننده محور اول و آخر از نوع میکروسوئیچ می باشد و محور دوم نیز از سنسورهای القایی بهره گرفته شده است. در ادامه به بررسی کامل تری از مشخصات اجزای مکانیک ربات اسکارا می پردازیم. در ابتدا به تعاریف و مفاهیم اولیه این اجزا و سپس مشخصات دقیق هر یک خواهیم پرداخت.

فصل سوم: معرفی و بررسی اجزای ربات اسکارا

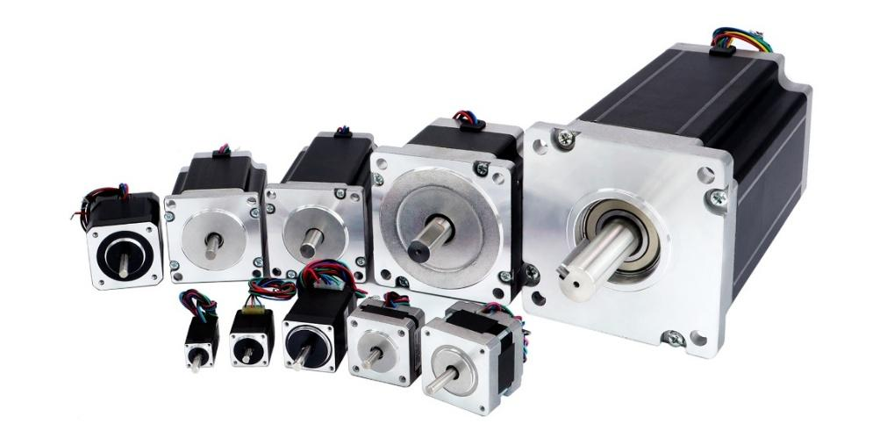
[picture p26: figure]
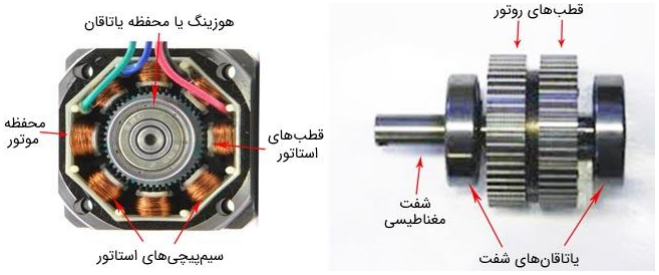
[picture p27: figure]

24

.1-1-3 معرفی و بررسی استپر موتور

1
2 | استپرموتور که به نام موتور پله ای هم شناخته می شود یک موتور براشلس
یا بدون جاروبک است
که یک دورکامل را به تعدادی پله تقسیم می کند و بدلیل وجود این پله ها توانایی حرکت گسسته یا پله به پله را دارد.

شکل -3 -2 معرفی و بررسی استپر موتور
استپر موتور از دو قسمت اصلی روتور و استاتور تشکیل شده است. روتور این موتورها معموال یک
آهن ربای مغناطیس دائم است. این روتورها توسط استاتورهای سیم پیچی شده احاطه شدهاند . هنگامی که سیم پیچها به صورت گام به گام و با یک ترتیب خاص فعال می شوند و جریان درون آنها روانه می شود، باعث خواهد شد استاتورها مغناطیسه شده و قطب های الکترومغناطیسی بر روی آن ایجاد شود و روتور دروان کند. این قطب های مغناطیس شده اساس کار موتورهای استپر می باشند .

شکل -3 -3 ساختار داخلی استپر موتور

1 Stepper Motor
2 BLDC Motor

فصل سوم: معرفی و بررسی اجزای ربات اسکارا

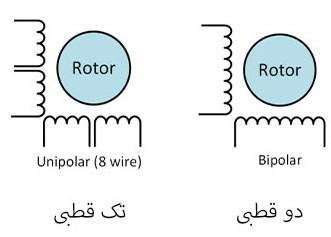
[picture p28: figure]
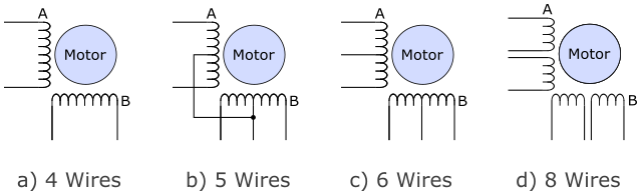
[picture p29: figure]

25

.1-1-1-3 سیم بندی استپر موتور
و تک قطبی | 1 | سیم بندی استپر موتور به دو دسته دو قطبی

2
تقسیم می شود. استپر موتورهای دو
قطبی دو سیم پیچ مجزا دارند که انتهای هر یک از آن ها به صورت دو رشته سیم از موتور بیرون آمده است؛ حال آنکه در موتورهای تک قطبی چهار سیم پیچ مجزا وجود دارند .

شکل -3 -4 انواع سیم بندی استپر موتور
در استپر موتورهای تک قطبی شارش جریان در سیم پیچها همیشه در یک جهت است ولی در استپر موتورهای دو قطبی باید به طور مداوم جهت جریان در سیم پیچها عوض شود و همین امر راه اندازی این گونه موتورها را کمی دشوارتر می کند . استپر موتورهای 4 سیمه را تنها می توان به صورت دو قطبی یا Bipolar راه اندازی کرد ولی موتورهای
5 و 6 و 8 سیمه به هر دو روش قابل راه اندازی هستند. قبل از راه اندازی هر نوع استپر موتور برای اجتناب از اتالف وقت با استفاده از یک اهم متر نحوه اتصاالت استپر موتور را تشخیص دهید .

شکل -3 -5 انواع روشهای اتصال سیمپیچها در استپر موتورها

1 Bipolar
2 Unipolar

فصل سوم: معرفی و بررسی اجزای ربات اسکارا

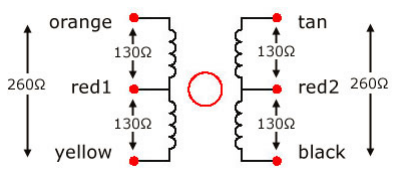
[picture p30: figure]

26

.2-1-1-3 نحوه تشخیص اتصالت استپر موتور در استپر موتورهای 8 سیمه )شکل6-3( که انعطاف پذیر ترین شکل سیم پیچی را دارند دو سر هر چهار سیم پیچ در دسترس می باشد. برای اینکه بفهمید کدام دو سیم مربوط به کدام سیم پیچ است با استفاده از اهم متر دو سر هر زوج سیمی را به طور مجزا به اهم متر وصل کنید در صورت مشاهده مقاومتی بین 10 تا 200 اهم می توان گفت که آن دو سیم مربوط به یک سیم پیچ هستند در غیر این صورت اگر مقدار مقاومت بینهایت یا بسیار زیاد بود آن دو رشته سیم مربوط به یک سیم پیچ نیست.

شکل -3 -6 استپر موتور 8 سیمه

در استپر موتورهای 6 سیمه سیم پیچ ها دو به دو با هم سری شده اند و سر وسط آن ها در دسترس
می باشد. برای تشخیص نحوه اتصاالت در استپر موتورهای 6 سیمه نیز به طریق مشابه می توان با استفاده از اهم متر عمل کرد. فقط توجه شود که در این حالت مقدار مقاوت بین سر مشترک و دو سر یکی از سیم پیچهای سری شده نصف مقدار مقاومت بین دو سر دو سیمپیچ سری شده با هم می باشد . )شکل7-3(

شکل -3 -7 نحوه تشخیص اتصالت در استپر موتور 6 سیمه

فصل سوم: معرفی و بررسی اجزای ربات اسکارا

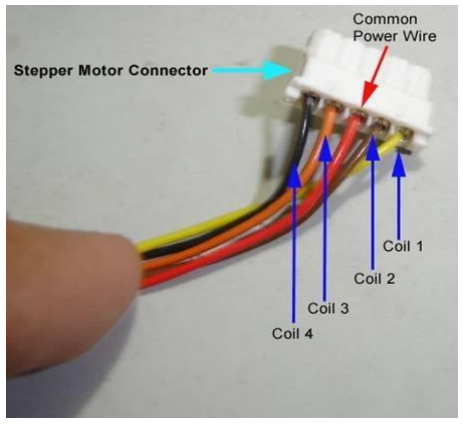
[picture p31: figure]

27

در استپر موتورهای 5 سیمه سرهای مشترک به هم وصل شده و به عنوان سیم پنجم از موتور بیرون کشیده شده است )شکل8-3( در این حالت به طور مشابه میتوان با استفاده از اهم متر اتصاالت را تشخیص داد. توجه کنید که در این حالت نیز مقدار مقاومت بین هر یک از سیم پیچ ها و سر مشترک نصف مقدار مقاومت بین دو سیم پیچ می باشد .

شکل -3 -8 استپر موتور 5 سیمه

در استپر موتورهای 4 سیمه که به صورت دو قطبی سیم بندی می شوند از ساده ترین روش اتصاالت
سیم بندی استپر موتور است. در این مدل استپر موتورها هم می توان با استفاده از اهم متر مقدار مقاومت بین هر یک از سیم پیچ ها را تشخیص داد.

شکل -3 -9 نحوه تشخیص اتصالت در استپر موتور 4 سیمه

همچنین می توان با گذاشتن مولتی متر بر روی تست دیود )حالتی که در صورت وصل کردن دو پراب به هم مولتی متر بوق می زند ( این تشخیص را داد. بد ین صورت که در صورت اتصال مولتی متر به یک س یم پیچ صدای بوق شنیده خواهد شد.

فصل سوم: معرفی و بررسی اجزای ربات اسکارا

28

.3-1-1-3 تعداد فاز استپر موتور در استپر موتورها ممکن است تعداد مختلفی سیم پیچ وجود داشته باشد. اما این سیم پیچ ها ب ه
شکل گروه هایی به نام فاز با هم در ارتباط هستند. تمامی سیم پیچ های یک فاز با یکدیگر شروع بکار می کنند. استپر موتور ها عموما دارای 2 فاز هستند، اما استپر موتورهای 3 فاز و 5 فاز هم موجود هستند. عموما فازهای بیشتر قدرت استپر موتور را بیشتر خواهند کرد.

جدول -3 -1 مقایسه انواع استپر موتورها از نظر تعداد فاز
استپر موتور دو فاز استپر موتور سه فاز استپر موتور پنج فاز
| سرعت کارکرد کم متوسط زیاد
| دقت کارکرد کم متوسط زیاد
| صرفه اقتصادی زیاد متوسط کم
| موجودی بازار زیاد کم متوسط
| گام حرکت پیش فرض 1.8 درجه 1.2 درجه 0.75 درجه

به طور معمول زمانیکه نیاز به دقت و سرعت باال داشته باشیم، از استپ موتور 5 فاز استفاده می کنیم.
زیرا این نوع از موتور پله ای، با درایور معمولی، لرزش بسیار کمی ایجاد می کند و نیازی به درایو میکرو استپ ندارد. از سوی دیگر اگر بخواهیم حرکت هایی با رفت و برگشت زیاد و سریع داشته باشیم، به سراغ استپ موتور 3 فاز می رویم. با این حال استپ موتور 2 فاز با درایور معمولی لرزش زیادی را ایجاد می کند و نیاز به استفاده از درایوهای پیشرفته با قابلیت میکرو استپ می باشد.

.4-1-1-3 سایز استپر موتور
استپر موتورها بر اساس سایز فلنج طبقه بندی می شوند بدین صورت در دو استاندارد قابل بیان
1 | هستند. اولین و پرکاربردترین استاندارد یا نماد تحت عنوان نیما یا
NEMA شناخته می شود که این
استاندارد به ابعاد خارجی فلنج بر حسب اینچ اشاره دارد بطور مثال یک استپر موتور 17 NEMA دارای ابعاد 1.7 اینچ مربع می باشد یا یک استپر موتور 34 NEMA دارای ابعاد 3.4 اینچ مربع می باشد.

1 National Electrical Manufacturers Association

فصل سوم: معرفی و بررسی اجزای ربات اسکارا

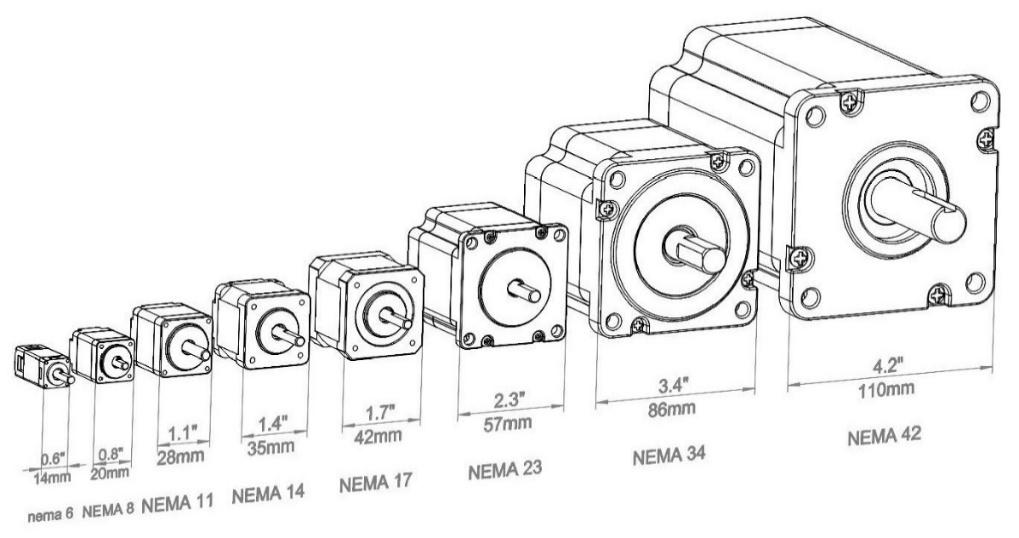
[picture p32: figure]

29

البته این استاندارد ها بر اساس اینچ درکدگذاری محصوالت جدید برندهای مختلف در حال کمتر
شدن می باشد و بیشتر ترجیح می دهند که بر حسب میلی متر آنرا بیان کنند . بطور مثال برای یک استپر موتور 17 NEMA که سایز فلنج آن 1.7 اینچ مربع می باشد با عدد 42 برحسب میلی متر بیان می کنند.

شکل -3 -10 ابعاد و اندازه های مختلف انواع استپر موتورها

.5-1-1-3 گام استپر موتور
منظور از گام، کوچک ترین چرخش قابل کنترل در استپر موتور است که بر حسب زاویه بیان می شود. استپ موتورها بسته به نوع کاربرد با گام های مختلف ی ساخته می شوند . بطور مثال اکثر استپر موتورها دارای گام 1.8 درجه می باشند بدین معنا که هر پله استپر موتور با پله دیگر به میزان 1.8 درجه اختالف زاویه دارد.
از آنجایی که استپر موتور برای چرخش یک دور کامل باید 360 درجه طی کند می توان با تقسیم
این عدد بر میزان گام استپر موتور تعداد پله ها را مشخص کرد در نتیجه می توان گفت یک استپر موتور با گام 1.8 درجه دارای 200 پله می باشد.

.6-1-1-3 گشتاور استپر موتور
1 | در استپر موتور از گشتاور به عنوان گشتاور نگهداری
یاد می شود که به حداکثر گشتاور استپر موتور
در حالت سکون اشاره دارد. این گشتاور در استپر موتور زمانی ایجاد می شود که موتور به درایو متصل است اما موتور حرکتی نمی کند. به همین دلیل مقدار این گشتاور در مقایسه با مقادیری که در زمان حرکت استپر موتور ایجاد می شود، بیشتر خواهد بود.

1 Holding Torque

فصل سوم: معرفی و بررسی اجزای ربات اسکارا

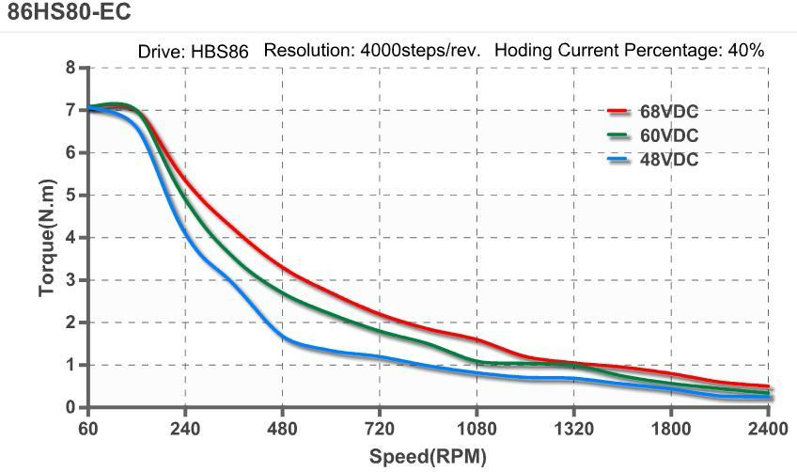
[picture p33: figure]

30

هرچه دور یا سرعت استپر موتور بیشتر شود، گشتاور نگهداری آن کمتر خواهد شد. به عبارت بهتر رابطه میان گشتاور و دور استپر موتورها بر اساس منحنی شکل 4-3 مشخص می شوند .

شکل -3 -11 منحنی گشتاور دور یک نمونه استپر موتور

البته روش اتصال سیم های استپر موتور در کنار ولتاژ اعمال شده بر روی آن، از متغیرهای تاثیرگذار
بر روی این منحنی است. با این حال نکته ای که به وضوح با استفاده از این منحنی به دست می آید، این است که پس از سرعت 200 تا 300 دور، گشتاور تولید شده توسط استپر موتور به شکل قابل توجهی افت پیدا می کند به همین خاطر از استپر موتورها بیشتر در سرعت های پایین استفاده می شود.

فصل سوم: معرفی و بررسی اجزای ربات اسکارا

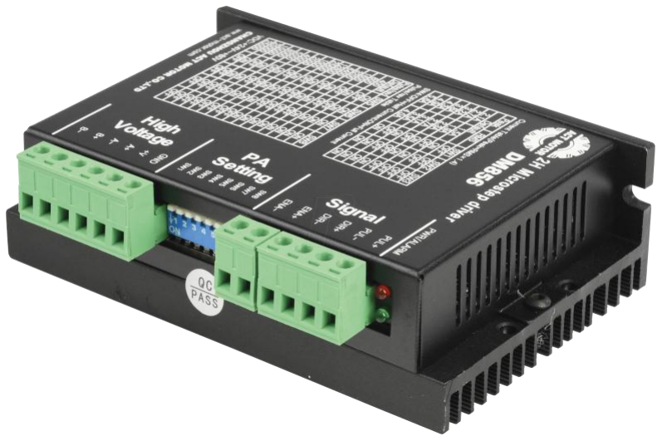
[picture p34: figure]

31

.2-3 تابلو فرمان ربات اسکارا در تابلو فرمان ربات اسکارا تجهیزاتی همچون درایو استپر موتور، منبع تغذیه، ترمینال ها و کنترلر
جای می گیرد که در ادامه به بررسی کامل تری از مشخصات اجزای تابلو فرمان ربات اسکارا می پردازیم. در ابتدا به تعاریف و مفاهیم اولیه این اجزا و سپس مشخصات دقیق هر یک خواهیم پرداخت.

.1-2-3 معرفی و بررسی درایو استپر موتور به منظور افزایش سرعت و دقت استپر موتورها معموالً با درایورهای مخصوصی کنترل میشوند که امکان تنظیم جریان و ولتاژ را فراهم می کنند، به این ترتیب به کاهش لرزش و افزایش گشتاور کمک می کنند .

شکل -3 -12 معرفی و بررسی درایو استپر موتور

درایورهای استپر موتور وظیفه دارند که پالسهای ولتاژ را به گونه ای به فازهای استپر موتور بدهند
که شفت استپر موتور حرکت کند . این پالس ها باید جریان کافی را برای س یم پیچ های موتور فراهم کند تا امکان حرکت استپر موتور با گشتاور کاف ی فراهم گردد. از طرفی هم باید کنترل جریان فازها به نحوی صورت پذ یرد که جر یان موتور بیش از حد زیاد نشود
که منجر به آس یب دیدن استپر موتور شود. عالوه بر این باید امکان رس یدن به حداکثر جریان در زمان کوتاه نیز برای س یم پیچ های موتور فراهم شود. همه این موارد بر عهده درایور استپر موتور می باشد. درایورها در اصل بخش کنترل و یا برنامه ریزی تولید سیگنال کنترل ی نیستند؛ بلکه واسطی برای دریافت سیگنال از کنترلر و تقویت آن در قالب پالس های جریانی به سمت استپر موتور ها هستند . لذا اساس راه اندازی درایورهای استپ موتور در چگونگی برنامه ریزی کنترلر می باشد.

فصل سوم: معرفی و بررسی اجزای ربات اسکارا

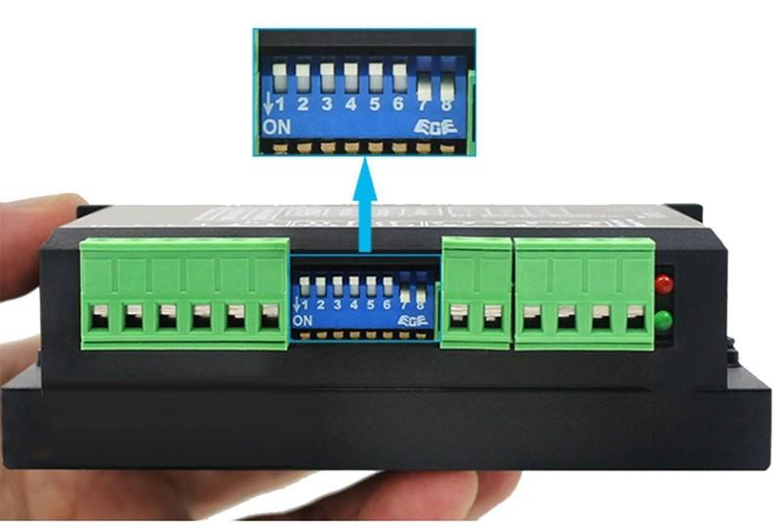
[picture p35: figure]

32

.1-1-2-3 مفهوم میکرو استپ

1
همانطور که می دانید استپر موتورها دارای یک زاویه گام پیشفرض هستند . در صورتیکه دقت حرکتی بیشتر از این مقدار نیاز باشد، می بایست از قابلیت میکرو استپ درایور که به صورت دیپ سوئیچ هایی روی درایور تعبیه شده استفاده نمود و با استفاده از کنترلر، فرمان های حرکتی را به آن منتقل کرد.

شکل -3 -13 دیپ سوئیچ های تنظیم میکرو استپ درایو استپر موتور

بنابراین میکرو استپ تکنیکی است که هر گام کامل استپر موتور را به گام های کوچکتر و دقیق تر تقسیم می کند . در این روش درایور، پالس ها را بین سیم پیچ های مختلف موتور به شکلی تقسیم می کند که استپ موتور توانایی حرکت بین استپ ها ب ه شکل دقیق پیدا می کند. برای مثال برای تقسیم شدن یک پله به 16 پله دیگر به یکی از سیم پیچ ها 1/16 و به سیم پیچ بعدی /16 15 از جریان را اختصاص می دهد، در مرحله بعدی /16 2 و 14/16 اختصاص داده می شود و همین روند ادامه خواهد داشت. درایوی که پله های استپر موتور را به میکرو استپ تبدیل می کند در حقیقت جریان الکتریکی را در محور یک موج سینوسی افزایش و کاهش می دهد. در این روش هیچ قطبی به شکل کامال خاموش یا روشن وجود ندارد. هرچه تعداد میکرو استپ ها بیشتر باشد، دقت حرکت استپر موتور هم باالتر می رود و تا حد زیادی
می توان لرزش ایجاد شده در استپ موتور را کنترل کرد. با این حال استفاده از این روش می تواند گشتاور موتور را کاهش دهد .

1 Micro Stepping

فصل سوم: معرفی و بررسی اجزای ربات اسکارا

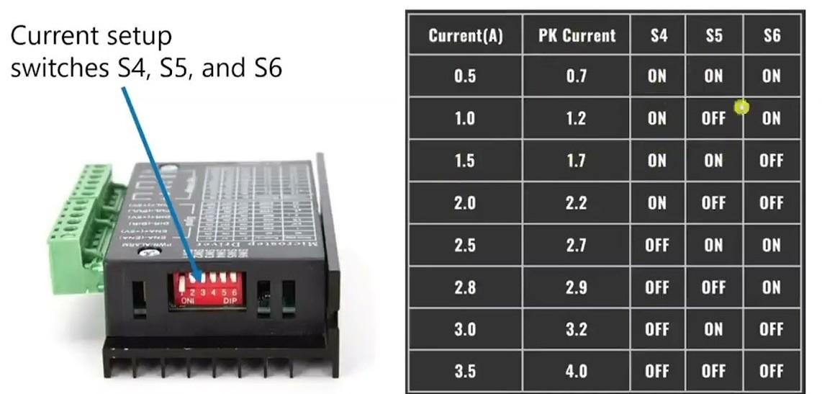
[picture p36: figure]

33

.2-1-2-3 تنظیم حد جریان مجاز برای تولید گشتاور در استپر موتور، باید سیم پیچ ها جریان الکتریکی دریافت کنند، پس جریان مصرفی توسط استپر موتور ارتباط مستقیمی با نوع کارکرد و گشتاور استپ موتور خواهد داشت و یکی از عوامل مهم در تعیین قدرت استپ موتور خواهد بود. همانند قابلیت میکرو استپ درایو برای تنظیم حد جریان استپر موتور نیز می توان از دیپ سوئیچ هایی که در کنار دیپ سوئیچ های تنظیم میکرو استپ درایو قرار دارند استفاده نمود . توجه داشته باشید که همیشه میزان حد جریان تنظیمی از حداکثر جریان قابل تحمل سیم پیچ های استپر موتور کم تر باشد.

شکل -3 -14 تنظیم حد جریان مصرفی استپر موتور

.3-1-2-3 انتخاب منبع تغذیه مناسب برای رسیدن به بهترین کارایی، انتخاب منبع تغذیه مناسب از اهمیت زیادی برخوردار است. اگر سرعت کار استپر موتور باال باشد باید ولتاژ خروجی تا سقف مجاز باال برود که ولتاژ باالتر برای تغذیه، باعث لرزش موتور در سرعت های پایین شده و احتمال خرابی را برای درایو افزایش می دهد اما اگر سرعت مورد نیاز زیاد نیست بهتر است ولتاژ تغذیه پایین تر انتخاب شود که باعث کاهش نویز و حرارت و افزایش کارایی می شود
اگر بار تحمیل شده به استپر موتور زیاد باشد باید جریان خروجی منبع تغذیه باال باشد تا گشتاور بیشتری ایجاد شود که این عوامل باعث گرم شدن زیاد موتور و درایو خواهد شد و سیستم خنک کننده مورد نیاز می باشد.

فصل سوم: معرفی و بررسی اجزای ربات اسکارا

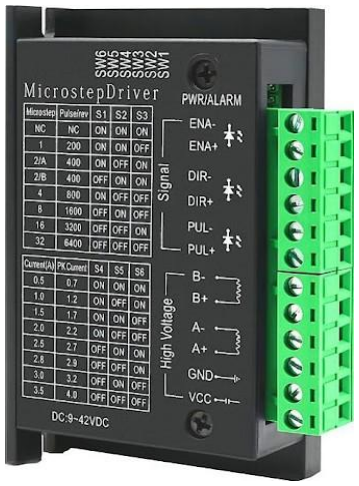
[picture p37: figure]

34

جدول -3 -2 ولتاژ مورد نیاز استپر موتور متناسب با سایز آن
| سایز استپر موتور ولتاژ مورد نیاز
| استپر موتور 8 NEMA الی 17 NEMA VDC 24 – 12
| استپر موتور 23 NEMA VDC 48 – 24
48 – 100 VDC / 30 – 70 VAC | NEMA 34 موتور استپر
| استپر موتور 42 NEMA VAC 220 – 110

.4-1-2-3 ترمینال های سیگنال ورودی درایو ترمینال های درایو استپر موتور در تمامی مدل ها به سه بخش اتصاالت کنترلر و اتصاالت موتور و اتصاالت منبع تغذیه تقسیم بندی می شوند.

شکل -3 -15 ترمینال های درایو استپر موتور
- ترمینال سیگنال ENA
این ورودی برای فعال و غیر فعال کردن درایو استپر موتور کاربر دارد. در صورت دریافت ولتاژ توسط
این ورودی، استپر موتور آزاد خواهد شد و چراغ سبز روی درایو چشمک خواهد زد و در صورت آزاد بود این ترمینال، استپر موتور زیر بار خواهد رفت و چراغ سبز ثابت روشن خواهد بود. سطح صفر پالس بین 0 الی 0.5 ولت بوده و سطح یک پالس نیز بین 4 الی 5 ولت می باشد. اگر ولتاژ ورودی باالتر از 5 ولت باشد باید یک مقاومت محدود کننده جریان بصورت سری با ورودی قرار گیرد.

فصل سوم: معرفی و بررسی اجزای ربات اسکارا

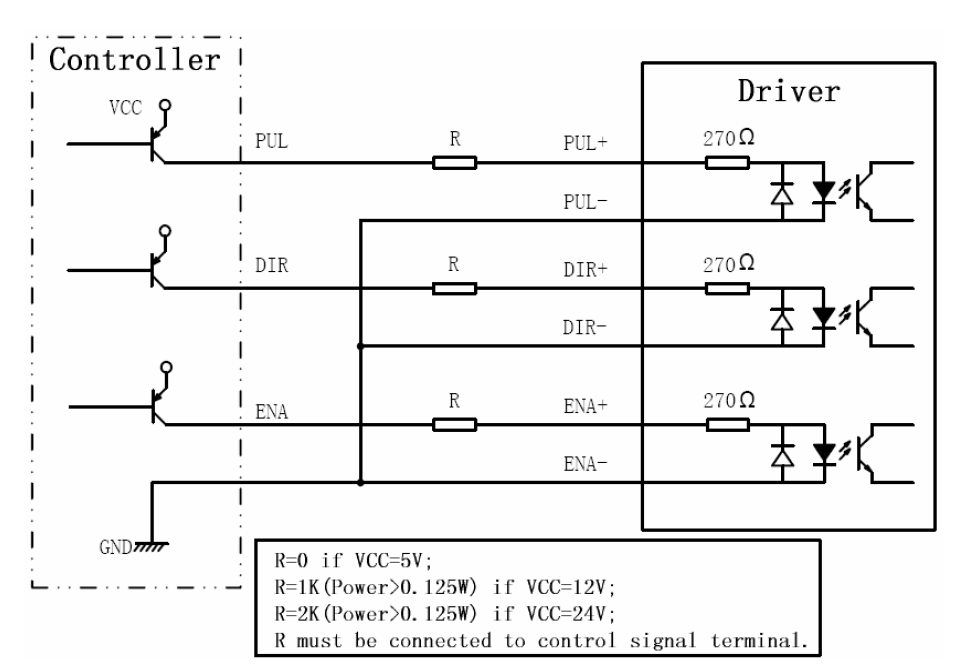
[picture p38: figure]

35

- ترمینال سیگنال DIR
این ورودی برای تعیین و تغییر جهت چرخش استپر موتور کاربرد دارد، برای تغییر جهت چرخش باید این ترمینال یک ولتاژ در محدوده 4 الی 5 ولت دریافت کند که البته جهت مثبت و منفی ولتاژ ورودی باید حتما رعایت شود. اگر ولتاژ ورودی باالتر از 5 ولت باشد باید یک مقاومت محدو د کننده جریان بصورت سری با ورودی قرار گیرد.
- ترمینال سیگنال PUL
این ورودی برای ارسال تعداد پالس الزم از طرف کنترلر برای چرخش استپر موتور می باشد، که با
توجه به سرعت و دقت مورد نیاز فرکانس پالس ورودی و تنظیم میکرو استپ محاسبه می شود. سطح صفر پالس بین 0 الی 0.5 ولت بوده و سطح یک پالس نیز بین 4 الی 5 ولت می باشد. اگر ولتاژ ورودی باالتر از 5 ولت باشد باید یک مقاومت محدود کننده جریان بصورت سری با ورودی قرار گیرد. همچنین برای عملکرد بهتر، پهنای پالس ورودی از 1.5 میکروثانیه کمتر نباشد.

.5-1-2-3 انواع اتصالت کنترلر به درایو بطور کلی دو نوع اتصال بین کنترلر و درایو استپر موتور وجود دارد یکی اتصال PNP و دیگری اتصال
NPN ، حال تفاوتی که بین این دو نوع اتصال وجود دارد به این شکل هست که در اتصال PNP پایه های منفی ترمینال های سیگنال درایو به یکدیگر متصل می شوند و توسط یک سیم مشترک به زمین کنترلر متصل می شود و به پایه های مثبت ترمینال های سیگنال درایو سطح ولتاژ 5 ولت اعمال می شود.

شکل -3 -16 اتصال PNP یا کاتد مشترک

فصل سوم: معرفی و بررسی اجزای ربات اسکارا

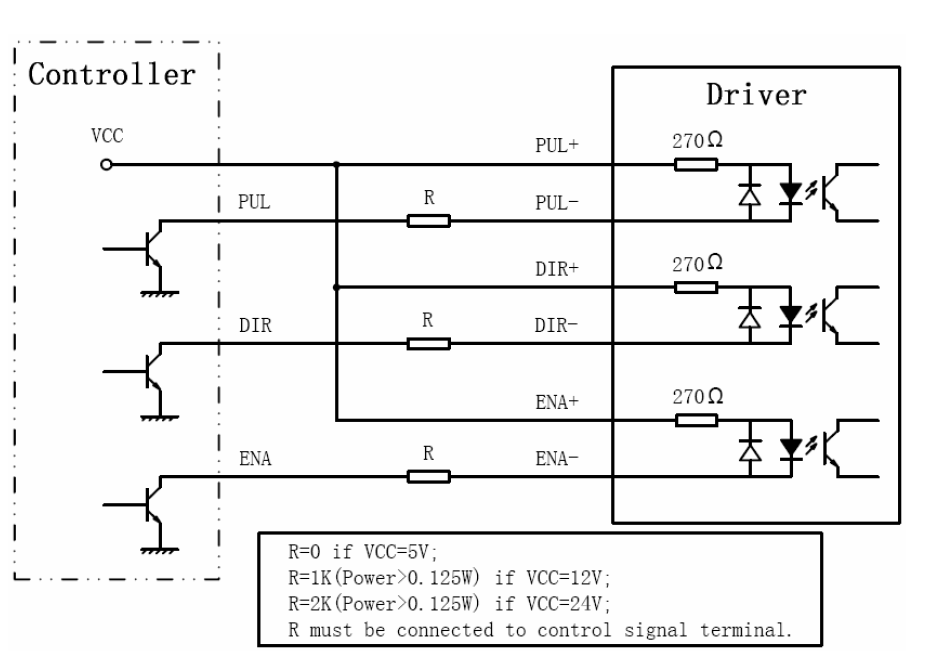
[picture p39: figure]

36

در اتصال NPN پایه های مثبت ترمینال های سیگنال درایو به یکدیگر متصل می شوند و توسط
یک سیم مشترک به 5 ولت کنترلر متصل می شود و به پایه های منفی ترمینال های سیگنال درایو سطح ولتاژ 0 ولت یا زمین اعمال می شود.

شکل -3 -17 اتصال NPN یا آند مشترک

فصل سوم: معرفی و بررسی اجزای ربات اسکارا

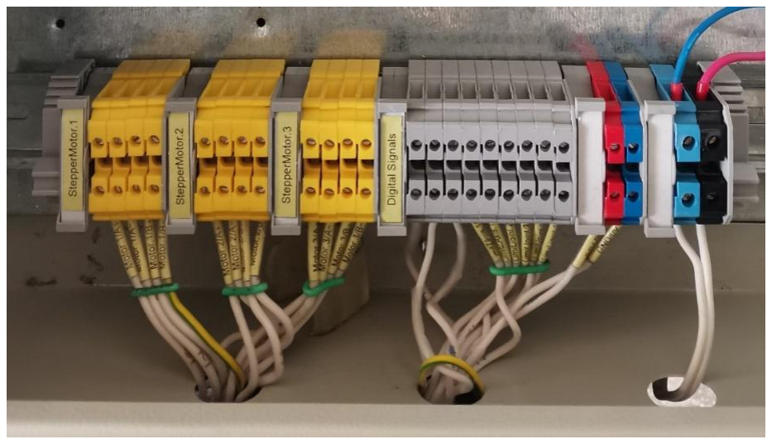
[picture p40: figure]

37

.3-3 اتصالت بین تابلو فرمان و ربات اسکارا اتصاالت بین تابلو فرمان و ربات اسکارا به سه بخش اتصاالت استپر موتور، سنسورها و تغذیه تقسیم
می شود. همانطورکه در شکل -3 18 مشخص است ترمینال های زرد به عنوان اتصاالت استپر موتور به سه بخش تقسیم می شود ک هر بخش مربوط به فازهای استپر موتور می باشد. از آنجایی که استپر موتورهای ربات اسکارا از نوع دو فاز می باشد بنابراین به چهار سیم برای اتصال
هر استپر موتور نیاز خواهیم داشت و در مجموع 12 ترمینال به این عنوان اختصاص داده شده است.

شکل -3 -18 ترمینال های سیگنال و قدرت تابلو فرمان ربات اسکارا

گروه دیگر از ترمینال ها تحت عنوان ترمینال های سیگنال برای اتصاالت سنسورهای ربات اسکارا تعبیه شده است. بر روی هر محور ربات اسکارا دو سنسور تعبیه شده است که هر سنسور دارای یک خروجی سیگنال 24 ولت می باشد و در مجموع 6 خروجی سیگنال 24 ولت از سنسورهای ربات اسکارا به ترمینال های تابلو فرمان متصل شده است. در شکل -3 18 ترمینال های خاکستری به همین عنوان اختصاص داده شده اند که در مجموع 9 ترمینال تعبیه شده و 3 عدد آن به عنوان ترمینال رزرو در نظر گرفته شده است. همچنین در سمت مکانیک ربات اسکارا نیز این ترمینال ها به همین ترتیب تعبیه شده است. در انتها نیز ترمینال های تغذیه قرار داردند که به این ترتیب به دو بخش تغذیه DC و AC تقسیم
بندی می شوند. بخش تغذیه DC با دو ترمینال قرمز و آبی مشخص شده اند که به عنوان ترمینال های 24 ولت در نظر گرفته شده اند و برای مصارف داخلی نظیر تغذیه سنسورها از این ترمینال استفاده می شود. بخش AC نیز تغذیه اصلی تابلو می باشد که با دو ترمینال آبی و مشکی در شکل -3 18 مشخص شده اند که به عنوان ترمینال های فاز و نول در نظر گرفته شده اند.

فصل سوم: معرفی و بررسی اجزای ربات اسکارا

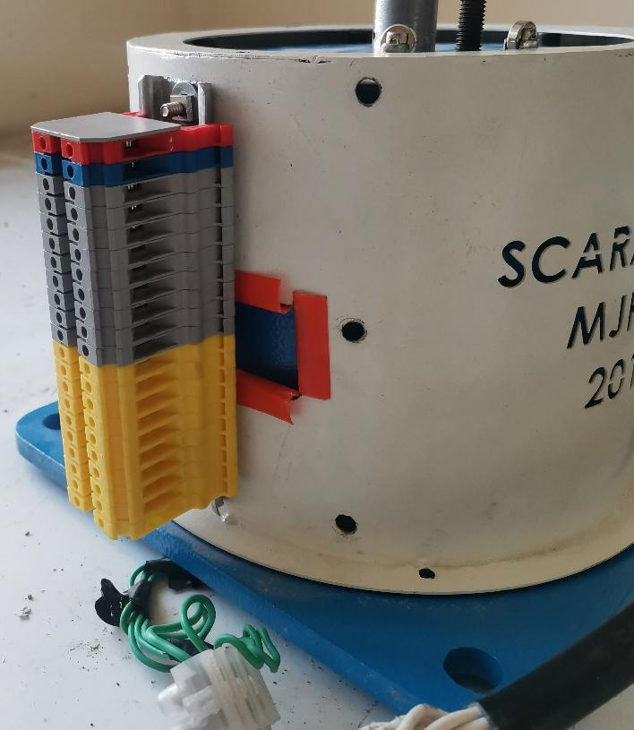
[picture p41: figure]
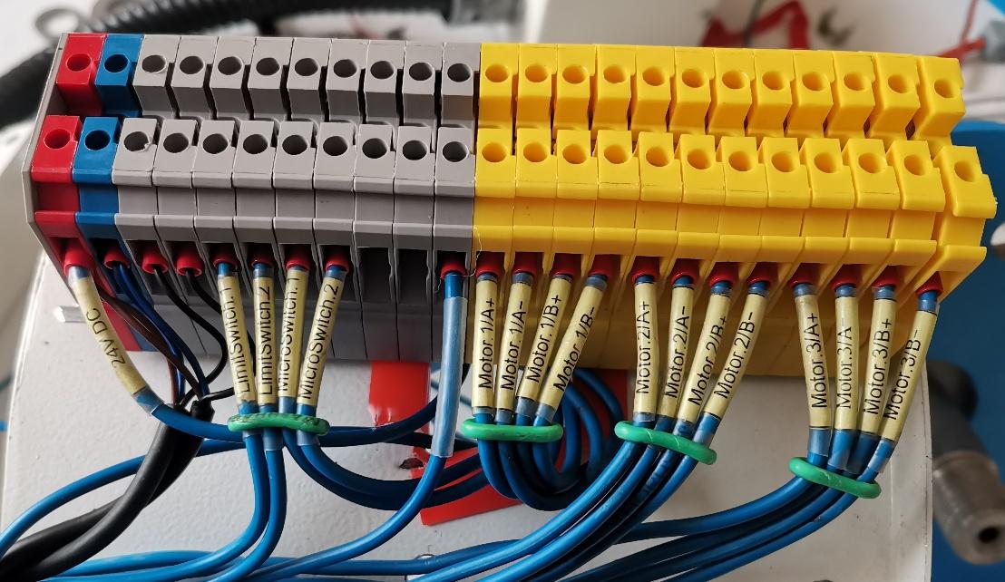
[picture p42: figure]

38

در بخش مکانیک ربات اسکارا نیز به همین ترتیب ترمینال های سیگنال، قدرت و تغذیه که در تابلو فرمان تعبیه شده است در این قسمت نیز در نظر گرفته شده است.

شکل -3 -19 ترمینال های سیگنال، قدرت و تغذیه ربات اسکارا

شکل -3 -20 اتصالت ترمینال های تعبیه شده بر روی ربات اسکارا

## 4 فصل چهارم: معرفی و بررسی کنترلر ربات اسکارا

فصل چهارم: معرفی و بررسی کنترلر ربات اسکارا

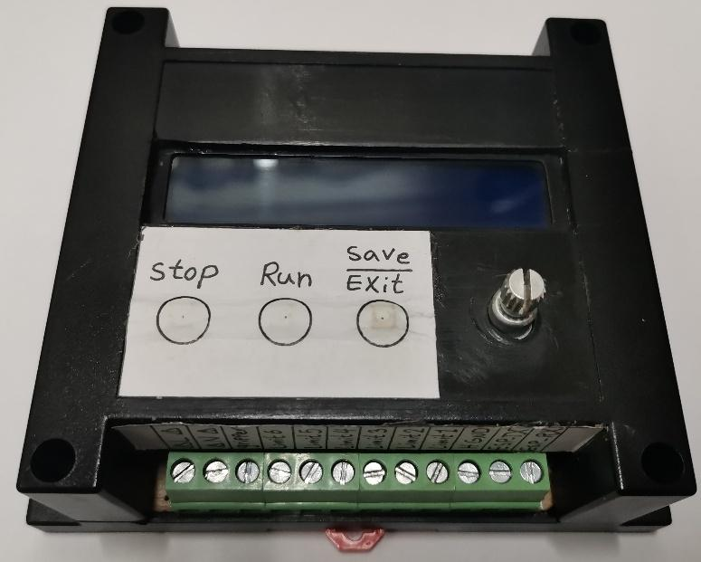
[picture p43: figure]

40

.1-4 معرفی کنترلر ربات اسکارا در این پایاننامه، به طراحی و پیاده سازی یک کنترلر پیشرفته برای ربات اسکارا پرداخته شده است. رباتهای اسکارا به دلیل دقت و سرعت باال در انجام وظایف صنعتی، به یکی از پرکاربردترین رباتها در صنایع مختلف تبد یل شده اند. هدف اصلی این پروژه طراح ی و پیاده سازی یک کنترلر پیشرفته برای ربات اسکارا می باشد که باعث افزایش دقت، سرعت، پایداری عملکرد و کارایی ربات در انجام وظایف صنعتی خواهد شد.
کنترلر طراحی شده از یک پردازنده اختصاصی 32STM استفاده می کند این پردازنده به عنوان هسته کنترلی ربات، وظیفه کنترل حرکت و مسیریابی خودکار بصورت خطی و زاویه ای بین موقعیت ها را
1 | داراست. همچنین این کنترلر دارای یک نمایشگر برای نمایش اطالعات کنترلی به صورت محلی
و یک
وب سرور که امکان کنترل ربات از راه دور

2
را فراهم می کند .

شکل -4 -1 نمونه اولیه کنترلر ربات اسکارا

کنترلر طراحی شده برای ربات اسکارا یک س یستم الکترون یکی پیشرفته است که وظیفه دارد حرکات دقیق و سریع ربات را کنترل و هماهنگ کند. این کنترلر با استفاده از الگوریتم های پیشرفته و تکنیک های بهینه سازی، توانایی دارد به طور موثر به تغییرات مح یطی پاسخ دهد و وظایف تکراری صنعتی را با دقت باال اجرا کند. هدف اصلی این کنترلر افزایش کارایی، دقت، و پایداری ربات اسکارا در فرآیندهای تولیدی و مونتاژی است.

1 Local
2 Remote

فصل چهارم: معرفی و بررسی کنترلر ربات اسکارا

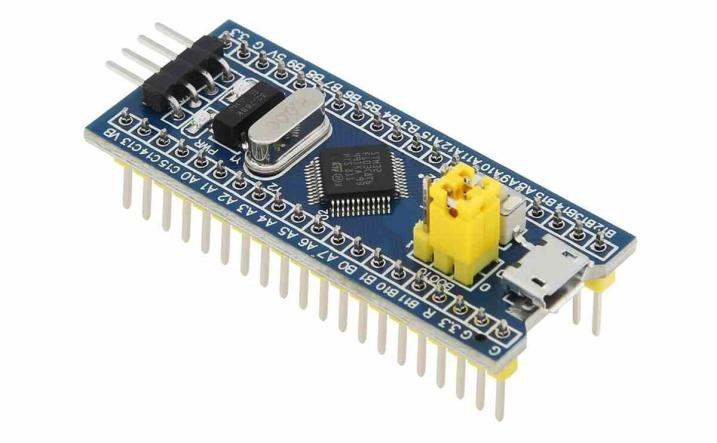
[picture p44: figure]

41

.2-4 اجزای کنترلر ربات اسکارا کنترلر طراحی شده از اجزای مختلفی تشکیل شده است. بطور کلی بخش های اصلی کنترلر شامل موارد زیر می باشد که در ادامه به بررسی کامل تر هر یک خواهیم پرداخت.
STM32 | میکروکنترلر |
- ال س ی د ی کاراکتر ی و رابط C2I
- ماژول وای فای 8266ESP
PC817 | اپتوکوپلر |
- آی سی الین درایو 31LS26AM
- روتاری انکودر ولومی

.1-2-4 معرفی میکروکنترلر 32STM خانواده 32STM میکروکنترلرهای 32 بیتی شرکت ST هستند. این محصول با ترکیب عملکرد بسیار قوی، ولتاژ کاری پایین، پردازش س یگنال دیجیتال و سهولت در توسعه، محبوبیت بس یار زیادی را کسب کرده است.
میکروکنترلرهای 32STM از پروتکل های ارتباطی گسترده ای پشتیبانی می کنند و همچنین میکروکنترلرهای خانواده 32STM شامل زیر مجموعه ها ی مختلفی هستند و به دلیل زیاد بودن تعداد پردانده های این خانواده، فقط میکروکنترلر 6T8C103F32STM را معرفی میکنیم.

شکل -4 -2 برد توسعه میکروکنترلر 6T8C103F32STM
سری 1F32STM جز پردازنده های میان رده این خانواده است، اما این سری دارای قدرت پردازش ی بسیار باالیی می باشد . سری 1F32STM اولین گروه م یکروکنترلرهای 32STM مبتن ی بر هسته ARM

.است Cortex-M3

فصل چهارم: معرفی و بررسی کنترلر ربات اسکارا

42

شکل -4 -3 پردازنده برد توسعه 6T8C103F32STM

سری 1F با افزایش سرعت پردازنده، اندازه حافظه داخلی ، انواع لوازم جانبی با گذشت زمان تکامل یافته است. هرکدام از زیر مجموعه های خانواده 32STM شامل زیر مجموعه های بسیاری می شوند . از محبوب ترین زیر مجموعه این خانواده ، پردازنده های سر ی 6T8C103F32STM می باشد. از ویژگی های این پردازنده می توان به موارد زیر اشاره نمود:
- حداکثر فرکانس کاری 72 مگاهرتز
- 64 کیلوبایت حافظه Flash و 20 کیلوبایت حافطه SRAM
- پشتیبانی از 7 کانال Controller DMA
- پشتیبانی ازپروتکل های ارتباطی SPI و C2I و USART
- پشتیبانی از 4 تایمر خارجی
- دارای 37 پورت GPIO

.1-1-2-4 معرفی محیط های برنامه نویسی 32STM محیط های مختلف ی برای برنامه نویسی میکروکنترلرهای 32STM وجود دارد. MDK Keil و CubeIDE32STM از محبوب ترین محیط های برنامه نو یسی این خانواده از میکروکنترلرها هستند .
- محیط برنامه نویسی MDK Keil نرم افزار MDK Keil یکی از قدرتمندترین محیط های برنامه نویسی برای ویرایش و کامپایل کد است. امکانات جانبی این نرمافزار ازجمله محیط د یباگ، آنالیز زمانی عملکرد میکروکنترلر، ارتباط با پروگرامرهای مختلف، انتخاب کامپایلر و غیره شما را از هر نرم افزار دیگری بی نیاز می کند . این محیط برنامه نویسی نیز به عنوان کامپایلر نیز شناخته می شود چراکه از کامپایلر اختصاصی
خود یعنی Keil بهره می برد همچنین الزم به ذکر است که این محیط برنامه نویسی برای پیکربندی سخت افزار نیاز به یک نرم افزار دیگر تحت عنوان CubeMX32STM دارد که باید آنرا نصب داشته باشد.

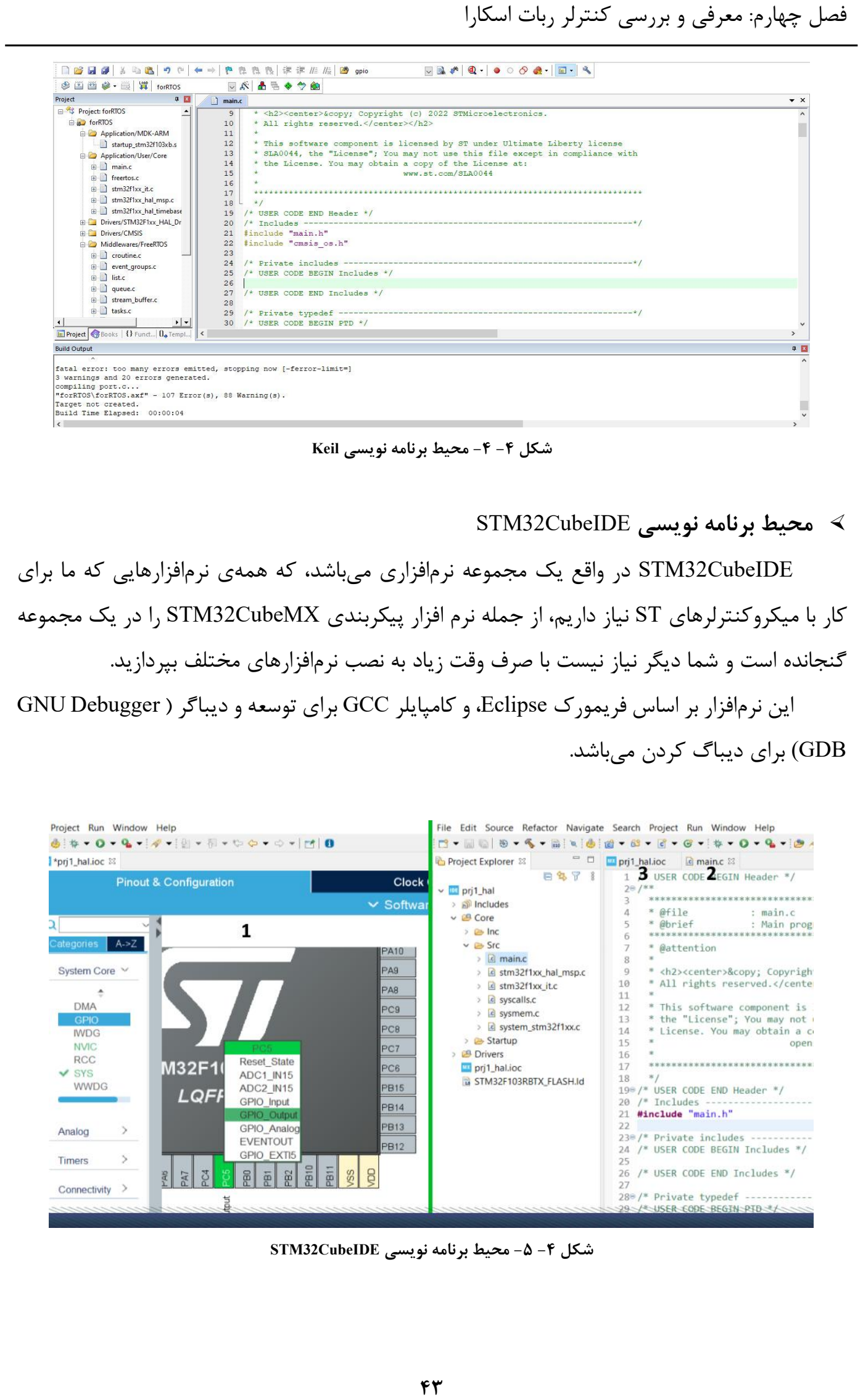
[picture p45: page 51]

فصل چهارم: معرفی و بررسی کنترلر ربات اسکارا

43

شکل -4 -4 محیط برنامه نویسی Keil

- محیط برنامه نویسی CubeIDE32STM CubeIDE32STM در واقع یک مجموعه نرم افزاری می باشد، که همه ی نرم افزارهایی که ما برای
کار با میکروکنترلر های ST نیاز داریم، از جمله نرم افزار پیکربندی CubeMX32STM را در یک مجموعه گنجانده است و شما دیگر نیاز نیست با صرف وقت زیاد به نصب نرم افزارهای مختلف بپردازید . این نرم افزار بر اساس فریمورک Eclipse، و کامپایلر GCC برای توسعه و دیباگر ) Debugger GNU
GDB (برای د یباگ کردن م یباشد .

شکل -4 -5 محیط برنامه نویسی CubeIDE32STM

فصل چهارم: معرفی و بررسی کنترلر ربات اسکارا

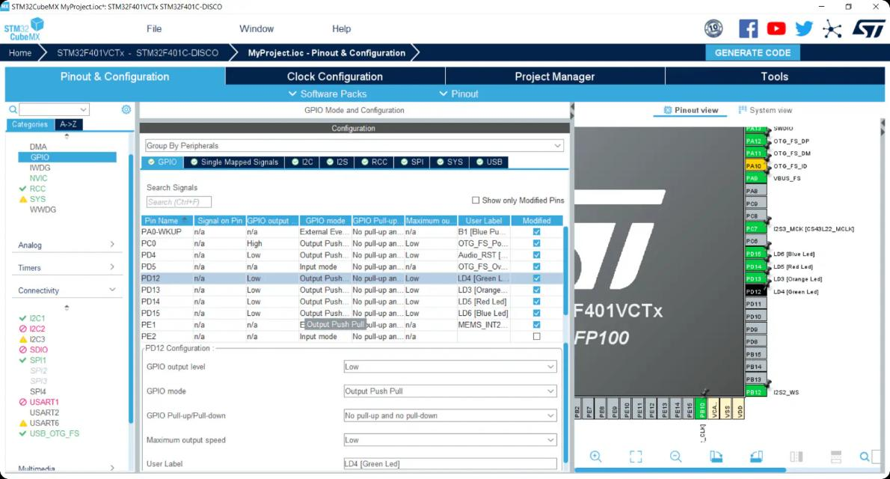
[picture p46: figure]

44

STM32CubeMX | پیکربندی | محیط |
این نرمافزار از سمت شرکت ST برای پیکره بندی اول یه کد در نظر گرفته شده است. نرمافزار CubeMX32STM یک محیط گرافیکی بسیار زیبا و کاربرپسند دارد که فقط با استفاده از چند کلیک می توانید میکروکنترلر خود را پیکره بندی اولیه کنید .

شکل -4 -6 محیط پیکربندی میکروکنترلر 32STM

.2-1-2-4 معرفی پروگرامر 32STM معموال میکروکنترلرهای ST را به دو روش JTAG و SWD پروگرام می کنند . در روش SWD نیاز
به پروگرامر Link-ST و در روش JTAG نیاز به پروگرامر Link-J داریم. البته با پروگرامر Link-J به روش SWD هم م ی توانیم عمل پروگرام را انجام بدهیم. درواقع تفاوت اصلی در این دو روش تعداد س یم هایی است که برا ی پروگرام کردن از آن استفاده
می کنند . پروتکل SWD به تعداد س یم های کمتری برای عمل پروگرام نیاز دارد. JTAG روش
این روش که مخفف Group Action Test Joint است در واقع یک روش استاندارد در ب ین همه میکروکنترلرهای سر ی ARM است که برا ی برنامه ریزی و اشکال زدایی به وس یله دیباگر یا پروگرامر JLINK استفاده می شود.
SWD روش

در روش SWD ما فقط از دو پایه به اسم های SWDIO و SWCLK استفاده می کنیم که در واقع
این پایه ها در پروتکل JTAG هم وجود دارند. در این روش از پروگرمرهای LINK-ST شرکت ST استفاده می کنیم که در مجموع 4 پایه استفاده می شود.

فصل چهارم: معرفی و بررسی کنترلر ربات اسکارا

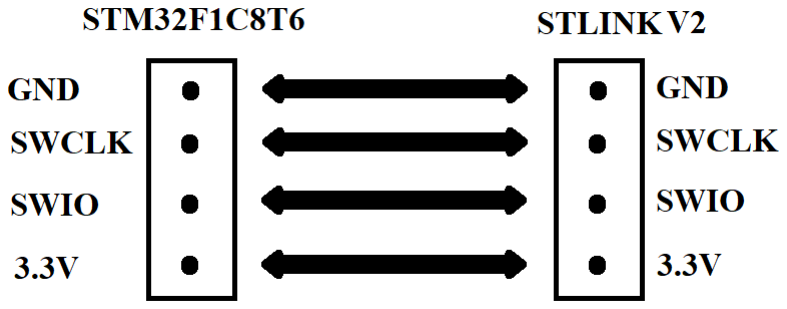
[picture p47: figure]
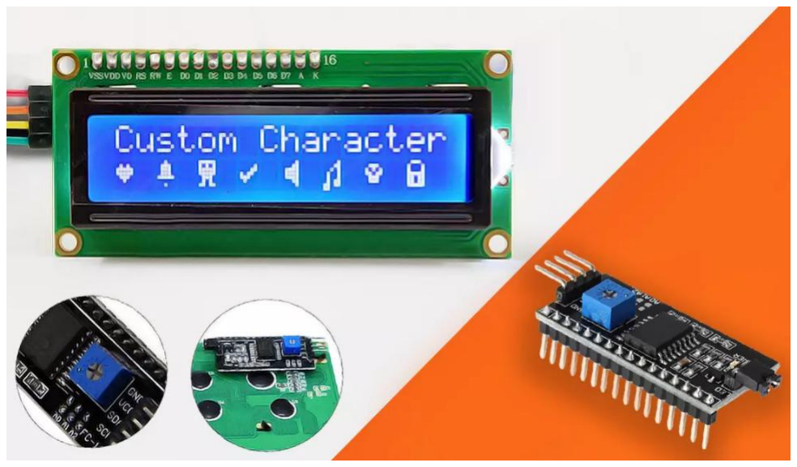
[picture p48: figure]

45

این روش چون از پایه های کمتری استفاده می کند مرسوم تر و محبوب تر است. در شکل -4 7 نحوه اتصال میکروکنترلر به پروگرامر STLINK مشخص شده است.

شکل -4 -7 نحوه اتصال پروگرامر به میکروکنترلر

.2-2-4 معرفی LCD کاراکتری و رابط C2I ال س ی د ی کاراکتری، نمایشگرهای ساده ای هستند که برای نمایش حروف، اعداد و نمادهای ساده طراحی شده اند. این نمایشگرها به دلیل سادگ ی، قیمت مناسب و مصرف کم انرژی، در بسیاری از دستگاههای الکترون یکی روزمره مورد استفاده قرار م ی گیرند .

شکل -4 -8 معرفی LCD کاراکتری و رابط C2I

.1-2-2-4 انواع ال سی د ی کاراکتری از نظر سطر و ستون ال س ی د ی 2×:16 رایجترین نوع ال س ی دی کاراکتری، ال س ی د ی 2×16 است که 2 سطر و 16 ستون دارد. این نوع ال س ی د ی برای نمایش اطالعات ساده و کوتاه بسیار مناسب است. ال س ی د ی 4× :20 این نوع ال س ی د ی دارا ی 4 سطر و 20 ستون است و برای نمایش اطالعات بیشتر نسبت به ال س ی دی 2×16 مناسب است.

فصل چهارم: معرفی و بررسی کنترلر ربات اسکارا

46

.2-2-2-4 معرفی پایه های LCD کاراکتری این نوع ال س ی د ی ها بسته به اینکه دارای نور پشت زمینه باشند یا نه دارای 14 یا 16 پایه هستند
که در جدول زیر این پایه ها معرفی شده اند .

جدول -4 -1 معرفی پایه های LCD کاراکتری
| | توضیح نماد پایه
| | زمین منبع تغذیه VSS 1
| | ولتاژ 5 ولت منبع تغذیه VDD 2
| | ولتاژ کنترل شدت نور صفحه VEE 3
4 | RS | اگر 0 = RS باشد رجیستر دستور انتخاب می شود. اگر 1 = RS باشد رجیستر داده انتخاب می شود.
5 | R/W | 0 = W/R برای نوشتن اطالعات 1 = W/R برای خواندن اطالعات
| | فعال ساز LCD E 6
| | بیت 0 باس داده 0D 7
| | بیت 1 باس داده 1D 8
| | بیت 2 باس داده 2D 9
| | بیت 3 باس داده 3D 10
| | بیت 4 باس داده 4D 11
| | بیت 5 باس داده 5D 12
| | بیت 6 باس داده 6D 13
| | بیت 7 باس داده 7D 14
| | آنود LED پشت زمینه LCD BLA 15
| | کاتود LED پشت زمینه LCD BLK 16

فصل چهارم: معرفی و بررسی کنترلر ربات اسکارا

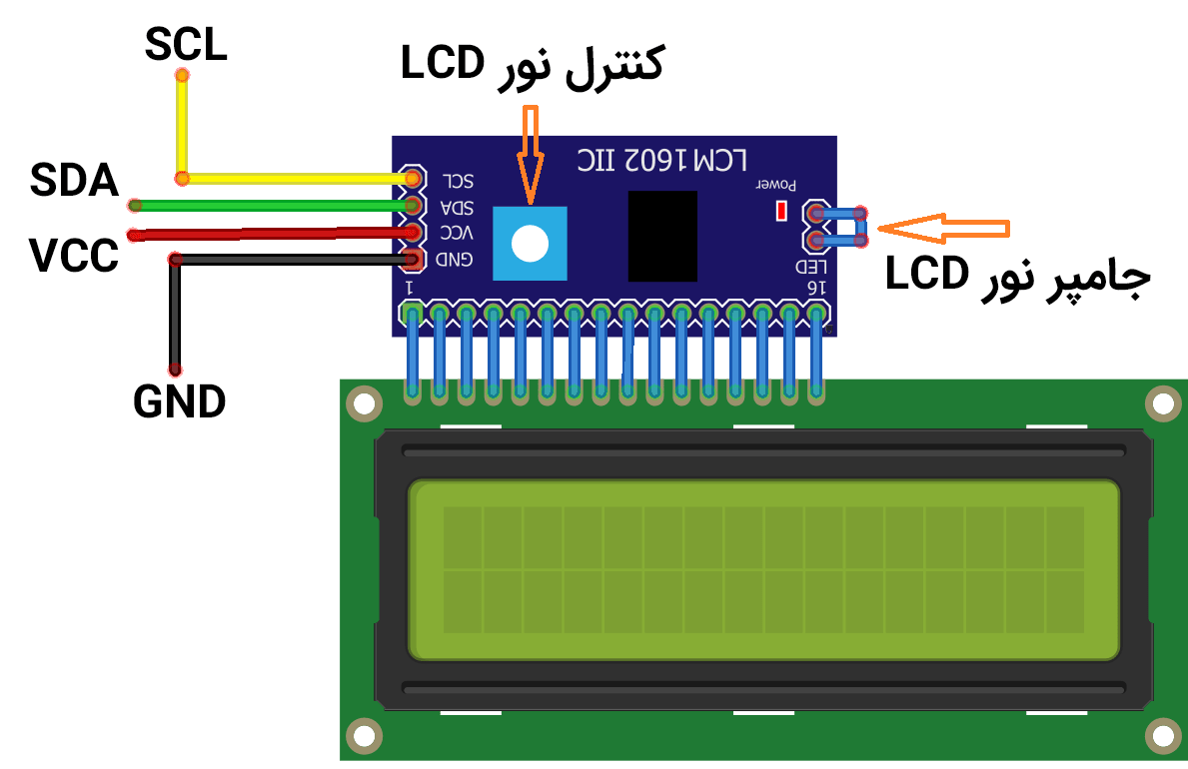
[picture p49: figure]

47

RS پایه
در داخل ال سی دی دو ریجستر وجود دارد که توسط پایه RS انتخاب می شوند. اگر این پایه صفر
1 | شود، ریجستر دستور
انتخاب می شود تا فرمان هایی مانند پیکربندی LCD ، پاک کردن آن، جابجایی
2 | مکان نما و ... برای ال سی دی ارسال می شود. در صورتی که اگر این پایه یک شود، ریجستر داده
انتخاب
می شود تا کاربر بتواند اطالعاتی را که می خواهد روی ال سی دی بنویسد، برای ال سی دی ارسال کند. R/W پایه
به کمک این پایه، کاربر مشخص می کند که می خواهد اطالعات را روی ال سی دی بنویسد یا از
روی آن بخواند. اگر این پایه یک شود، اطالعات از روی ال سی دی خوانده می شود و در صورتی که صفر شود، اطالعات روی آن نوشته می شود. E پایه
اگر در این پایه، پالسی از یک به صفر قرار داده شود، اطالعاتی که روی پایه های 0D تا 7D قرار دارد
درون یکی از ریجستر هایی که توسط پایه RS مشخص می شود جای می گیرد. حداقل زمانی که این پایه باید صفر باشد، 450 نانوثانیه است.

.3-2-2-4 نحوه اتصال LCD به رابط C2I برای اتصال ال سی دی به میکروکنترلر بدلیل اینکه از تعداد پایه های کمتری استفاده نماییم از رابط C2I برای این نوع ال سی دی استفاده می نماییم.

شکل -4 -9 نحوه اتصال LCD به رابط C2I

1
Instruction Register
2 Data Register

فصل چهارم: معرفی و بررسی کنترلر ربات اسکارا

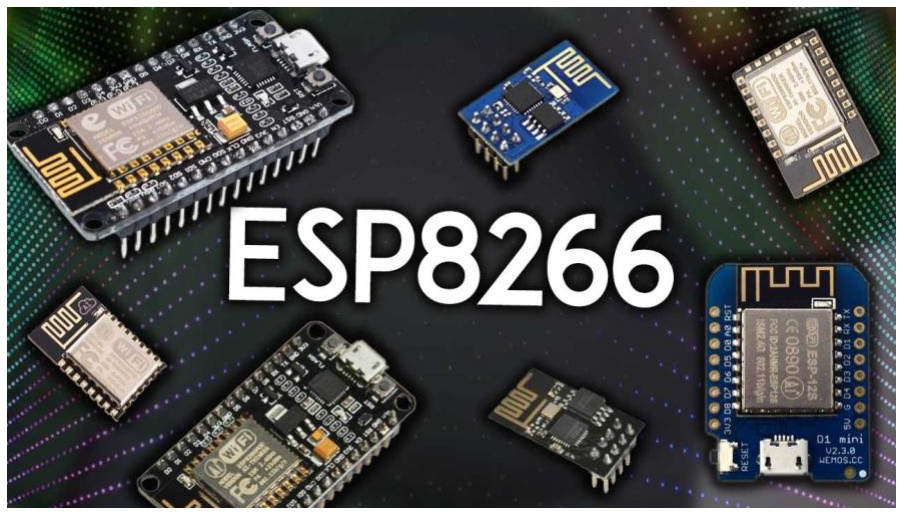
[picture p50: figure]

48

.3-2-4 معرفی ماژول وای فای 8266ESP ماژول 8266ESP در حقیقت نوعی میکروکنترلر با قابل یت برنامه نویسی مستقل است که توسط شرکت Systems Espressif توسعه داده شده است. این ماژول امکان اتصال دستگاه ها به شبکه های بی سیم را فراهم می کند و از معماری کوچک و قدرتمند خود برا ی ایجاد برنامه های قابل اجرا بر روی خود استفاده می کند .

شکل -4 -10 معرفی ماژول وای فای 8266ESP

ماژول 8266ESP دارای یک پردازنده 106LX Xtensa Tensilica با فرکانس 80 مگاهرتز است که
با حافظه فلش داخلی 4 مگابایت قابل برنامه ریزی است. عالوه بر این، این برد دارا ی چیپ Fi-Wi با استاندارد n/g/b 802.11 است که به دستگاهها امکان اتصال به شبکه های بی سیم را م یدهد .

شکل -4 -11 تراشه ماژول 8266ESP

ماژول 8266ESP دارای پورتهای UART، C2I و SPI است که به کاربر امکان اتصال به سنسورها
و ماژول های دیگر را م ی دهد که این قابلیت ها، تعامل با دستگاههای خارجی را برای پروژههای مختلف بسیار آسان می کند . این برد از پروتکل های رمزنگاری 2WPA/WPA و WEP برای اتصال امن به شبکه های بیسیم استفاده م ی کند و قابلیت احراز هویت و رمزگذاری را فراهم م ی کند .

فصل چهارم: معرفی و بررسی کنترلر ربات اسکارا

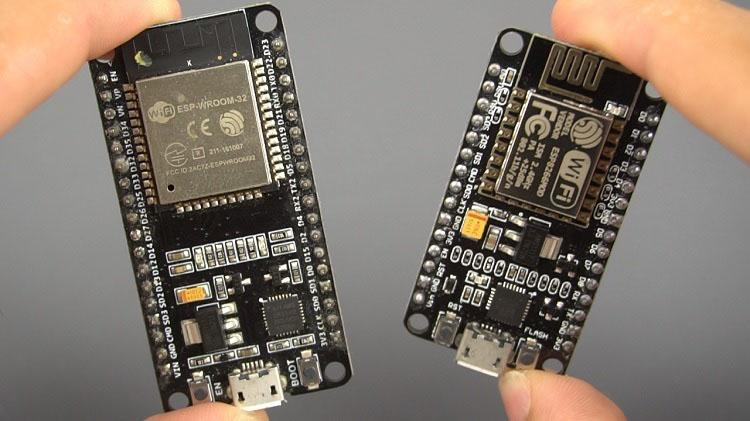
[picture p51: figure]

49

تراشه های خانواده ESP در بردهای مختلفی استفاده شده اند و امروزه کاربرد بسیار گسترده ای را پیدا
1 | کرده اند . برد NodeMCU یکی از پرمصرف ترین بردهای امبدد در زمینه اینترنت اش یاء
هستند . هسته
NodeMCU دارای دو نسخه ی مختلف است. یکی دارا ی چیپ 8266ESP ورژن 12ESP و د یگری دارا ی چیپ 32ESP است.

شکل -4 -12 برد NodeMCU ماژول 8266ESP و 32ESP

.1-3-2-4 تفاوت ماژول های 8266ESP و 32ESP ماژول 8266ESP یک میکروکنترلر با قابلیت Fi-Wi است و ماژول 32ESP عالوه بر قابلیت Fi-Wi دارای قابلیت اتصال بلوتوث نیز است. لذا تفاوت اولیه بین این ماژول ها در نوع میکروکنترلر استفاده شده در آنها است. ماژول 32ESP نسبت به 8266ESP قدرت پردازش بیشتری دارد. بدین معنا که 32ESP قادر به اجرای عملیات پیچیده تر، محاسبات متقدم و پردازش داده های بیشتر است. ماژول 32ESP دارای حافظه فلش و حافظه SRAM بیشتری نسبت به 8266ESP است. بدین معنا
که 32ESP قادر به ذخیره و پردازش حجم بیشتری از دادهها است. 32ESP دارا ی تعداد بیشتری پورت و واحد ارتباطی است که امکان اتصال به سایر ماژول ها را م یدهد . ماژول 32ESP دارای قابلیت بلوتوث است که به شما امکان ارتباط با دستگاههای بلوتوث ی را می دهد .
این ویژگی برا ی کاربردهایی مانند اتصال به دستگاه های پرینتر بلوتوث، سنسورهای بلوتوث و دیگر دستگاههای هوشمند کاربرد دارد. هر دو ماژول 8266ESP و 32ESP دارا ی قابلیت اتصال به شبکه Fi-Wi هستند. اما 32ESP از ویژگیهای پیشرفته تری مانند حالتهای آنتن داخلی و خارجی و پشتیبانی از مد روتر ی پیشرفته )WDS )برخوردار است.

1
Internet of Things (IoT)

فصل چهارم: معرفی و بررسی کنترلر ربات اسکارا

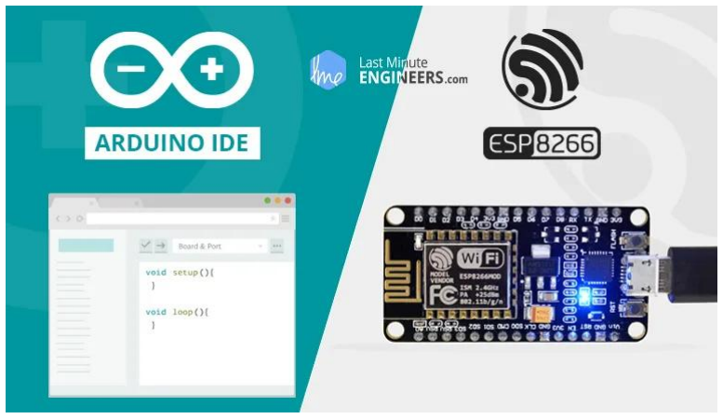
[picture p52: figure]

50

.2-3-2-4 زبان برنامه نویسی ماژول 8266ESP ماژول 8266ESP با استفاده از زبان برنامه نویسی ++C و با استفاده از ابزار توسعه IDE Arduino برنامه ریزی می شود. این زبان برنامه نویسی بر اساس زبان C است و به توسعه دهندگان اجازه می دهد کدهای کامپایل شده را بر روی برد 8266ESP اجرا کنند.

شکل -4 -13 برنامه نویسی ماژول 8266ESP توسط نرم افزار IDE Arduino

ماژول 8266ESP عالوه بر زبان ++C، دارای قابلیت برنامه ریزی با استفاده از زبان های برنامه نویسی دیگری نظ یر MicroPython و Lua نیز است. اما برای برنامه ریزی اصلی و پرکاربرد 8266ESP، استفاده از زبان ++C و IDE Arduino توصیه می شود. با استفاده از IDE Arduino و زبان ++C می توانید کدهای بر نامه ریزی را برای کنترل دستگاهها، ارتباط با شبکه Fi-Wi، خواندن و نوشتن داده ها، کنترل پینها و توابع دیگر بر روی 8266ESP نوشته و اجرا کنید . همچنین، بسته به نیاز پروژه، می توانید از کتابخانه های آماده مربوط به 8266ESP استفاده کنید تا توسعه را سریع تر و آسانتر کنید .

.3-3-2-4 نحوه پروگرام کردن ماژول 8266ESP بردها و تراشه های ESP توسط ارتباط سریال یا همان UART قابلیت اتصال به کامپیوتر را دارند. بنابراین برای پروگرام کردن مستقیم آن ها بایستی از یک م بدل USB به سریال استفاده نمود. در مدل هایی از ESP که صرفا تراشه نیستند و رو ی برد خاصی قرار گرفته اند از جمله بردهای NodeMCU این قابلیت در برد فراهم شده است. کافیست از درگاه USB روی برد استفاده کرده و به کامپیوتر اتصال دهید .

فصل چهارم: معرفی و بررسی کنترلر ربات اسکارا

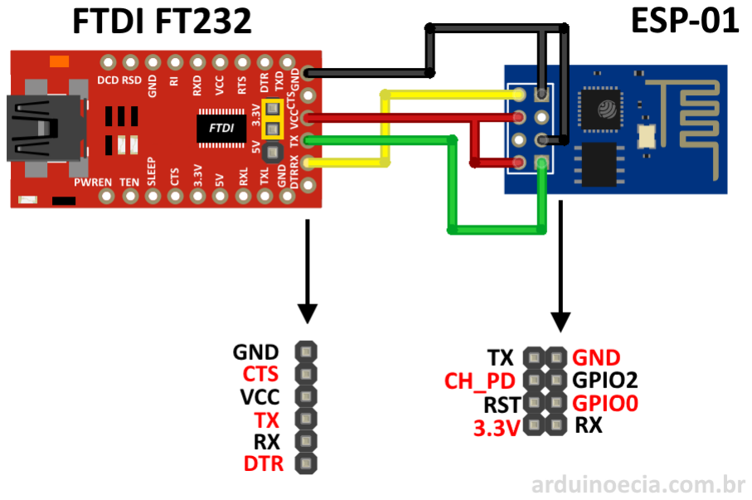
[picture p53: figure]
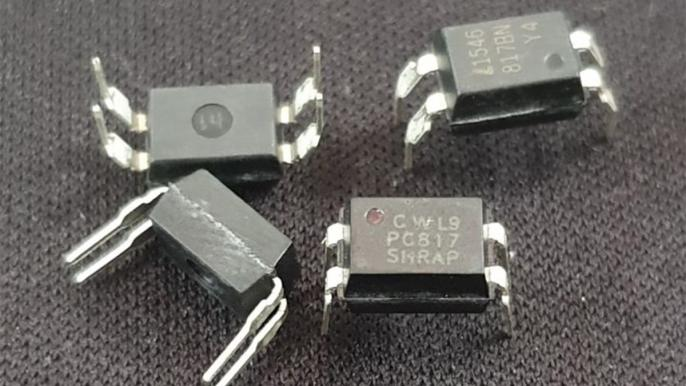
[picture p54: figure]

51

شکل -4 -14 نحوه اتصال مستقیم ماژول 8266ESP به مبدل USB به سریال

برای پروگرام کردن ماژول 8266ESP ابتدا مانند شکل 14-4 اتصاالت بین ماژول و مبدل USB به سریال را برقرار کنید و سپس مبدل را به کامپیوتر خود متصل کنید. در مرحله بعد پایه 0GPIO ماژول را به زمین متصل کرده و سپس پایه RESET ماژول را برای لحظه ای زمین کنید . درنهایت هر دو پایه 0GPIO و RESET را به حالت اولیه برگردانید )از حالت زمین خارج کنید(. در این حالت ماژو ل 8266ESP به حالت بوت یا پروگرام شدن وارد م ی شود و به راحتی با انجام مراحل و اتصاالت باال از طریق نرم افزار آردوینو م ی توانید ماژول را پروگرام نمایید .

.4-2-4 معرفی اپتوکوپلر 817PC 1 اپتوکوپلر
یا اپتوایزوالتور

2
یک قطعه الکترونیکی است که با استفاده از نور، س یگنال های الکتریکی
را بین دو مدار مجزا انتقال م ی دهد و برای جدا کردن و محافظت از مدار در برابر آس یب های الکتریکی یا نویزهای ناخواسته به ویژه در مدارهای با ولتاژ پایین و مدارهای حساس به نویز استفاده می شود.

شکل -4 -15 معرفی اپتوکوپلر 817PC

1 Optocoupler
2 Optoisolator

فصل چهارم: معرفی و بررسی کنترلر ربات اسکارا

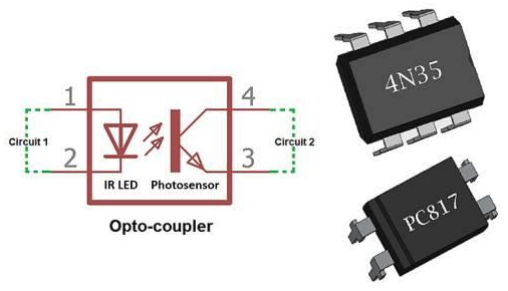
[picture p55: figure]

52

.1-4-2-4 نحوه کار اپتوکوپلر 817PC همانطورکه در شماتیک مربوط به اپتوکوپلر 817PC در شکل 16-4 مشخص است، پین های 1 و 2 مربوط به LED هستند. LED نور مادون قرمز را به سمت یک گیرنده نوری )فوتوترانزیستور( ساطع می کند و فوتوترانزیستور نور ساطع شده از LED را دریافت م ی کند. فوتوترانزیستور شبیه یک ترانزیستور BJT
1 | عمل کرده و مدار خروجی را با استفاده از پایه های کلکتور
2 | و امیتر
سوئیچ می کند .
فضای بین فوتوترانزیستور و LED، از جنس یک ماده شفاف و غیر رسانا ساخته شده که در واقع نارسانای الکتریکی ولی رسانای نوری است مثل ش یشه، هوا یا پالستیک شفاف. این ماده دو مدار مختلف را از نظر الکتریکی از هم جدا و ا یزوله م ی کند. ایزوالسیون الکتریکی به طور معمول در محدوده 10 کیلو ولت یا باالتر است.

شکل -4 -16 نحوه کار اپتوکوپلر 817PC

1 Collector
2 Emitter

فصل چهارم: معرفی و بررسی کنترلر ربات اسکارا

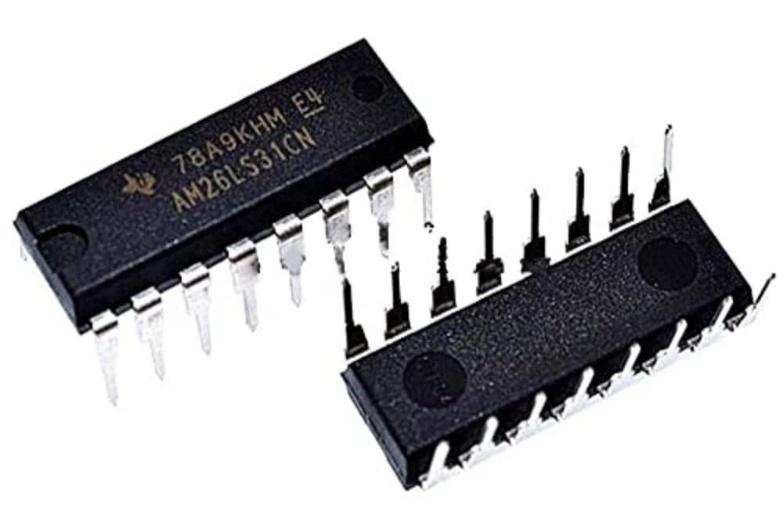
[picture p56: figure]
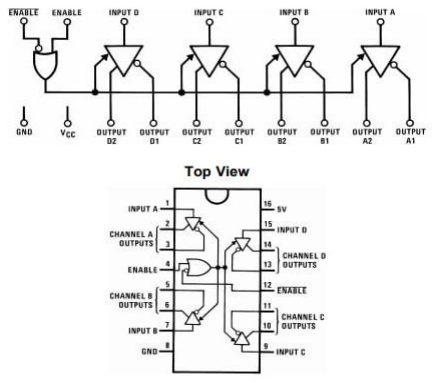
[picture p57: figure]

53

.5-2-4 معرفی آی سی لین درایو 31LS26AM 1 الین درایو
نوعی مدار الکترونیکی است که برای تقویت س یگنالهای ورودی و انتقال آن ها به
فاصلههای طوالنی یا برای تطبیق س یگنالهای مختلف با دستگاههای ورود ی و خروجی دیگر استفاده می شوند . این نوع درایورها معموالً به صورت آ ی س ی های خاصی طراحی می شوند که قادر به تقویت و اصالح س یگنالها هستند تا اطمینان حاصل شود که س یگنال ها به درستی و بدون کاهش کیفیت منتقل می شوند.

شکل -4 -17 آی سی لین درایو 31LS26AM

شکل -4 -18 شماتیک آی سی لین درایو 31LS26AM

1 Line Drive

فصل چهارم: معرفی و بررسی کنترلر ربات اسکارا

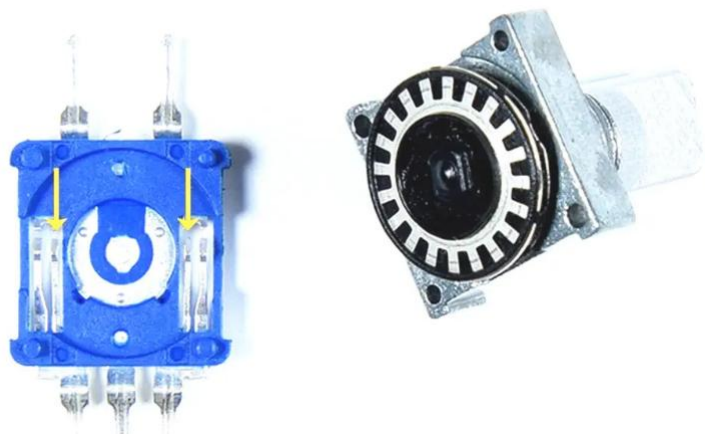
[picture p58: figure]

54

.6-2-4 معرفی روتاری انکودر ولومی روتاری انکودر ولومی نوعی سنسور موقعیت است که موقعیت زاویه شفت را به دیتای د یجیتال تبد یل
می کند . این انکودر از نوع افزاینده بوده که ساده ترین روش برای اندازه گیری موقعیت زاویه ای به شمار می رود. این انکودر همچنین دارای یک سوئیچ است که فشردن شفت را تشخیص می دهد .

شکل -4 -19 یک نمونه روتاری انکودر ولومی

.1-6-2-4 نحوه کار روتاری انکودر ولومی در داخل روتار ی انکودر یک عدد دیسک ش یار دار وجود دارد که این دیسک رسانا است و به پایه
GND روتاری انکودر متصل می شود. همچنین دو عدد پایه بین ش یارها قرار دارند که در حال عادی با دیسک برخوردی ندارند . در شکل 20-4 ساختار داخلی یک روتاری انکودر را مشاهده می ک نید .

شکل -4 -20 ساختار داخلی یک روتاری انکودر ولومی

فصل چهارم: معرفی و بررسی کنترلر ربات اسکارا

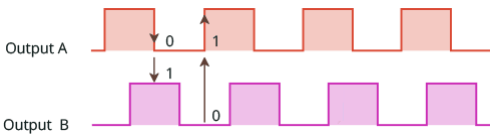
[picture p59: figure]

55

همانطور که در باال گفته شد دو عدد پایه با نام های A و B وجود دارند که با چرخش انکودر یکی
پس از دیگری با دیسک تماس پیدا کرده و یک لحظه سطح ولتاژ آنها صفر می شود که بر اساس همین ترتیب اتصال پایه های A و B به زمین ، جهت چرخش را تشخیص می دهیم.

شکل -4 -21 دیسک شیار دار روتاری انکودر

همان طور که در شکل 21-4 مشاهده می کنید با چرخش دیسک در جهت عقربه های ساعت ابتدا پایه A و سپس پایه B با بخش رسانی دیسک یعنی GND برخورد می کند و در صورت ی که برعکس بچرخد یعنی خالف عقربه های ساعت بچرخد ابتدا پایه B و سپس پایه A با زمین تماس پیدا خواهند کرد. پایه های A و B به ش یوه ای قرار داده شده اند که چرخش شفت روتاری انکودر با ترتیب خاصی به
GND وصل شوند که دو س یگنال خروجی از A و B با یکدیگر اختالف فاز 90 درجه داشته باشند . به عنوان مثال اگر س یگنال پایه A تغییر کند و مقدار خروج ی A با B برابر نباشد یعنی روتاری انکودر در جهت عقربه های ساعت چرخانده شده است.

شکل -4 -22 خروجی پالس انکودر با چرخش در جهت عقربه های ساعت

و اگر س یگنال پایه A تغییر کند و مقدار خروجی A با B برابر باشد یعنی روتاری انکودر در جهت عکس عقربه های ساعت چرخانده شده است

فصل چهارم: معرفی و بررسی کنترلر ربات اسکارا

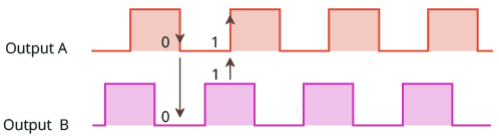
[picture p60: figure]
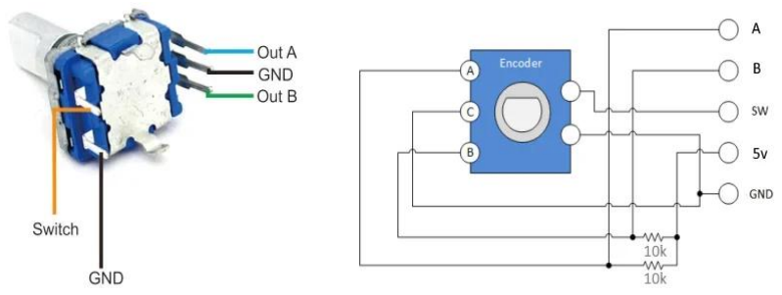
[picture p61: figure]

56

شکل -4 -23 خروجی پالس انکودر با چرخش در جهت عکس عقربه های ساعت

در صورتی که بخواهید از خود قطعه استفاده کن ید ترتیب پایه ها مانند شکل 24-4 می باشد و برای اتصال به 32STM یا هر نوع میکروی دیگری باید طبق شماتیک موجود در تصویر زیر آن را پیاده کنید .

شکل -4 -24 شماتیک روتاری انکودر ولومی

فصل چهارم: معرفی و بررسی کنترلر ربات اسکارا

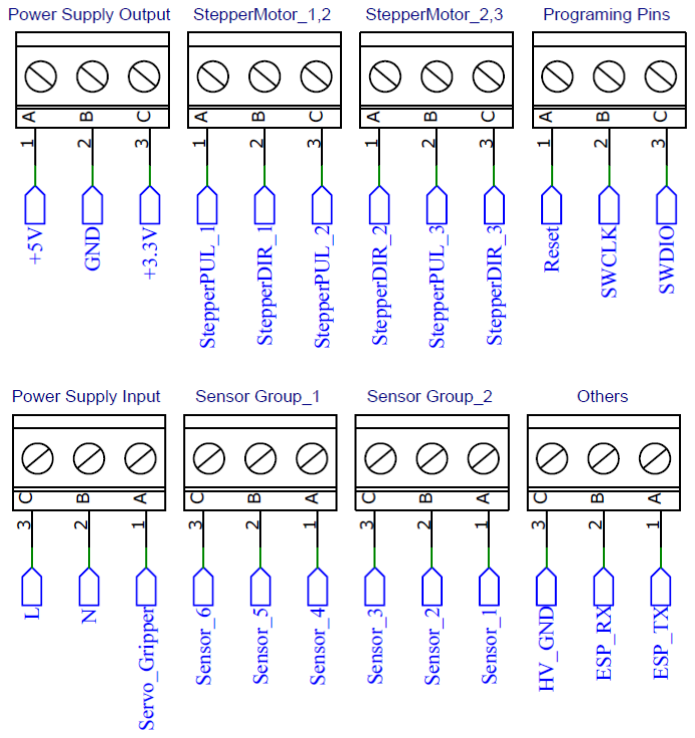
[picture p62: figure]

57

.3-4 بررسی شماتیک کنترلر ربات اسکارا شماتیک کنترلر ربات اسکارا دارای ورودی و خروجی های متعددی می باشد که بخش اعظم آن مربوط به ترمینال خروجی تولید پالس و ترمینال وروردی سیگنال سنسورها است. در شکل 25-4 تمام ترمینال های ورودی و خروجی کنترلر مشخص شده است.

شکل -4 -25 ترمینال های ورودی و خروجی کنترلر

همانطور که در شکل -4 25 مشاهده می کنید ترمینال ها به دو بخش باال و پایین کنترلر تقسیم
شده است که هر بخش شامل 12 ترمینال و در مجموع این کنترلر دارای 24 ترمینال ورودی و خروجی می باشد.

فصل چهارم: معرفی و بررسی کنترلر ربات اسکارا

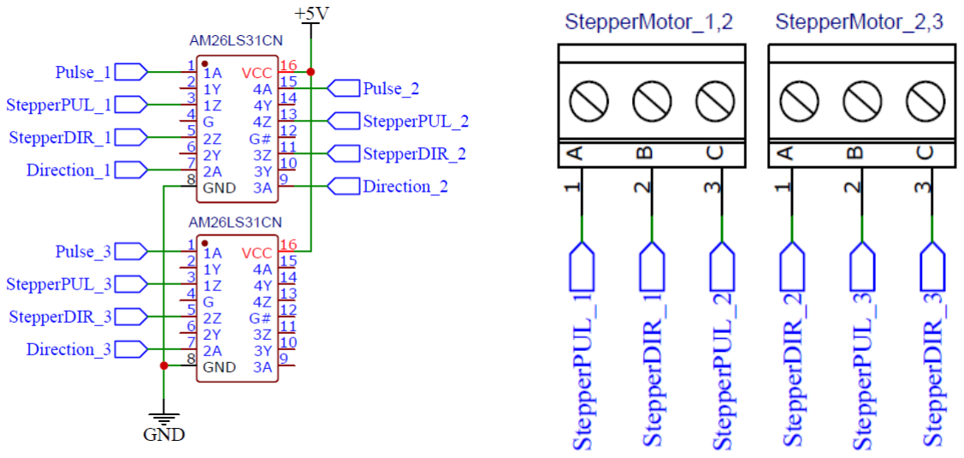
[picture p63: figure]

58

در بخش باالیی کنترلر سه ترمینال برای پروگرام کردن میکروکنترلر 32SM تعبیه شده است که مستقیم به برد توسعه 6T8C103F32STM متصل شده اند.

شکل -4 -26 ترمینال های پروگرام کردن میکرو 32STM

در بخش باالیی کنترلر 6 ترمینال برای کنترل استپر موتورهای سه محور ربات اسکارا تعبیه شده
است که به واسطه آی سی الین درایو 31LS26AM که قبال آنرا معرفی کردیم به برد توسعه
.اند شده | متصل | STM32F103C8T6

شکل -4 -27 ترمینال های کنترل استپر موتور و اتصالت آی سی لین درایو

در بخش باالیی کنترلر سه ترمینال به عنوان منبع تغذیه خروجی برای مصارف خارج از کنترلر تعبیه
شده است که خروجی 3.3 ولت آن از برد توسعه 6T8C103F32STM استفاده شده است و خروجی 5 ولت آن از منبع تغذیه ورودی کنترلر استفاده می کند.

فصل چهارم: معرفی و بررسی کنترلر ربات اسکارا

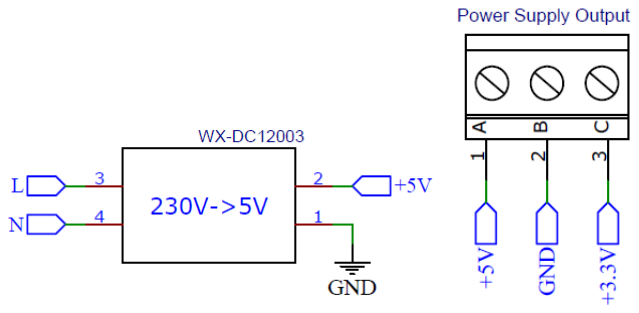
[picture p64: figure]
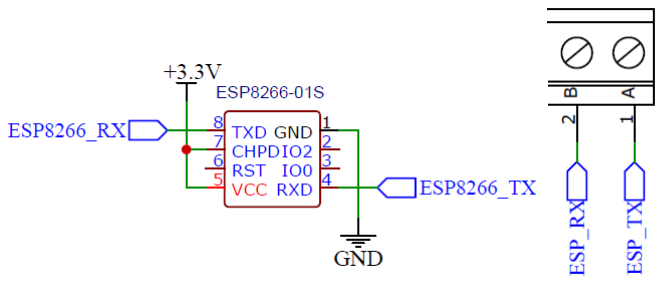
[picture p65: figure]

59

شکل -4 -28 ترمینال منبع تغذیه خروجی و ماژول منبع تغذیه ورودی کنترلر

در بخش پایینی کنترلر دو ترمینال برای اتصال ماژول 8266ESP از طریق پورت سریال تعبیه شده
است که البته این ماژول میتواند در داخل کنترلر تعبیه شود و از این ترمینال ها برای مصارف دیگر استفاده نمود اما در حال حاضر ماژول 8266ESP خارج از کنترلر استفاده شده است و به این دو ترمینال برای ارتباط با کنترلر نیاز مندیم.

شکل -4 -29 ترمینال های ارتباط سریال و اتصالت ماژول 8266ESP

در بخش پایینی کنترلر 7 ترمینال برای دریافت سیگنال خروجی از سنسورهای واقع بر روی ربات اسکارا تعبیه شده است که به واسطه اپتوکوپلرهای 817PC به برد توسعه 6T8C103F32STM متصل شده اند. خروجی های این اپتوکوپلر با مقاومت 10 کیلو اهم با تغذیه 3.3 ولت پول آپ شده اند و آرایش اتصال اپتوکوپلرها به میکروکنترلر بصورت NPN برقرار شده است. به این نکته توجه کنید که ولتاژ ورودی قابل تحمل این اپتوکوپلرها حداکثر 5.5 ولت است و برای اتصال سنسورهای ربات اسکارا بدلیل اینکه سیگنال خروجی آنها 24 ولت است باید حتما از یک مقاومت 2.2 کیلو اهم بصورت سری برای هر ورودی سنسور استفاده نمایید.

فصل چهارم: معرفی و بررسی کنترلر ربات اسکارا

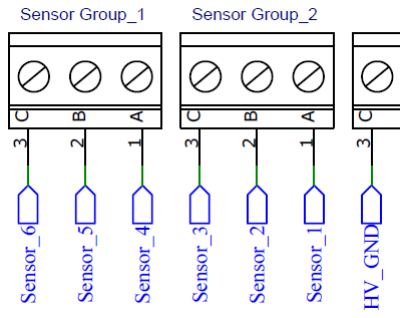
[picture p66: figure]
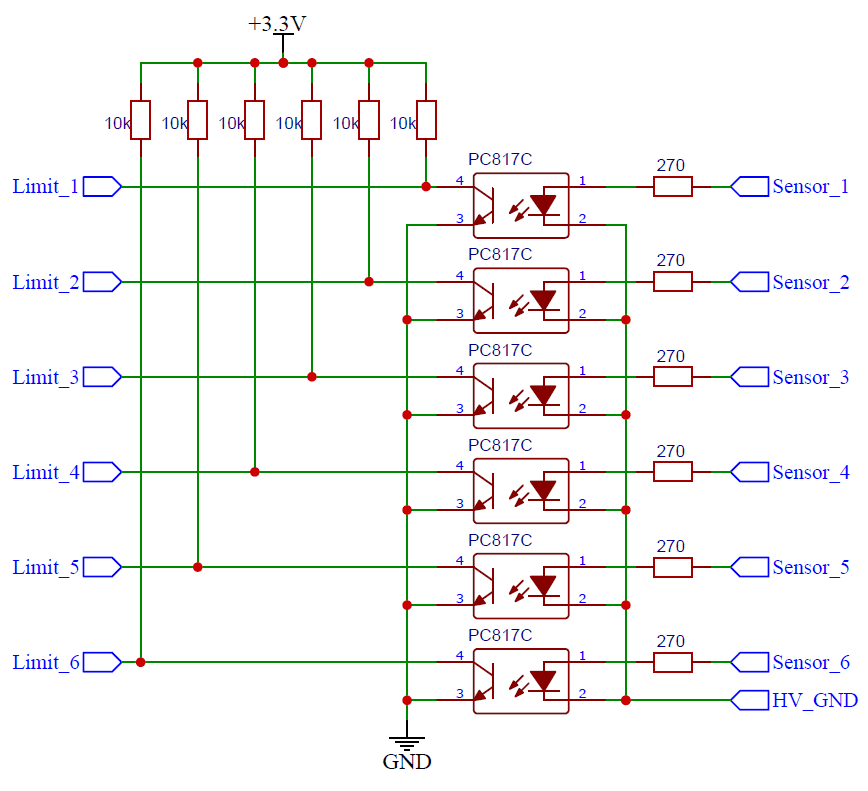
[picture p67: figure]

60

شکل -4 -30 ترمینال های ورودی سنسور

شکل -4 -31 شماتیک اتصالت اپتوکوپلر به برد توسعه 6T8C103F32STM

در بخش پایینی کنترلر سه ترمینال یکی به عنوان کنترل سرو موتور برای اتصال گریپر و دو ورودی
فاز و نول برای منبع تغذیه اصلی کنترلر تعبیه شده است که ترمینال کنترلر سروگریپر به صورت مستقیم به برد توسعه 6T8C103F32STM متصل شده است و دو ورودی فاز و نول به ماژول منبع تغذیه 230 ولت به 5 ولت برای تغذیه میکروکنترلر و دیگر مصارف متصل می شود.

فصل چهارم: معرفی و بررسی کنترلر ربات اسکارا

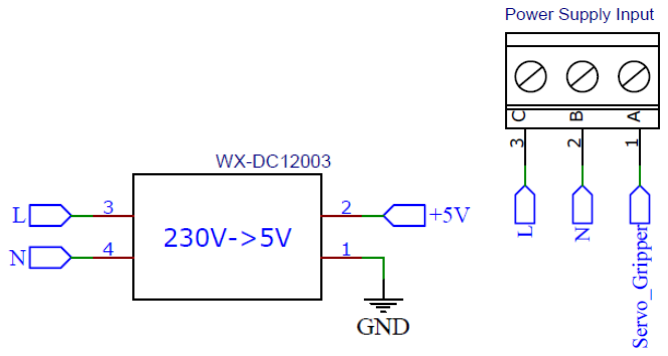
[picture p68: figure]
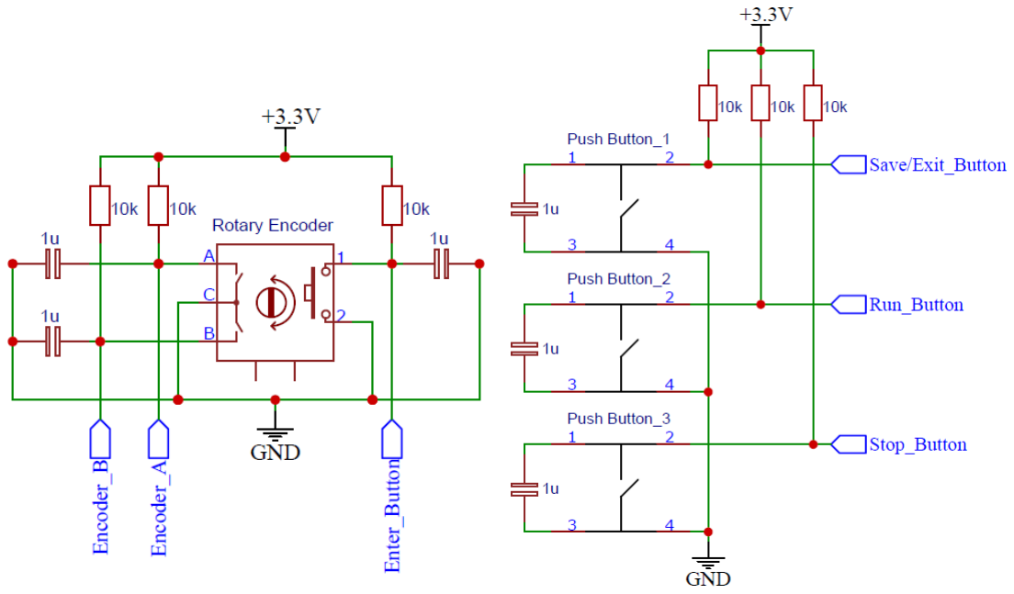
[picture p69: figure]

61

شکل -4 -32 ترمینال کنترل سرو موتور و ورودی منبع تغذیه کنترلر

در بخش داخلی کنترلر ربات اسکارا اتصاالت دکمه ها و روتاری انکودر بصورت پول آپ به برد توسعه 3T8C103F32STM متصل شده است. همچنین از یک خازن 1 میکروفاراد بین پایه ها برای کاهش نویز نیز تعبیه شده است.

شکل -4 -33 شماتیک اتصالت کلیدها و روتاری انکودر به برد توسعه 6T8C103F32STM

همانطور که قبال توضیح دادیم LCD کاراکتری نیز به واسطه یک ماژول رابط C2I به میکروکنترلر متصل شده است. همچنین شماتیک برد توسعه 6T8C103F32STM در شکل 35-4 مشخص شده است.

فصل چهارم: معرفی و بررسی کنترلر ربات اسکارا

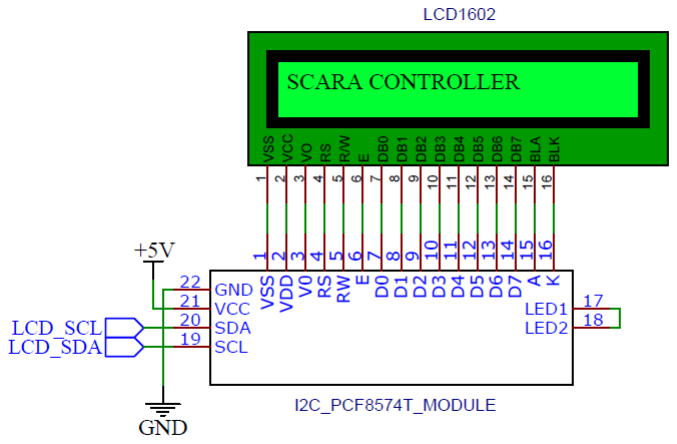
[picture p70: figure]
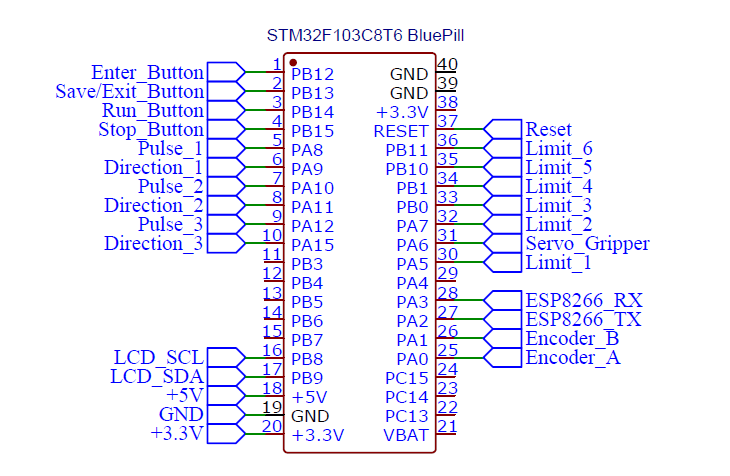
[picture p71: figure]

62

شکل -4 -34 شماتیک اتصال LCD کاراکتری همراه با رابط C2I

شکل -4 -35 شماتیک اتصالت برد توسعه 6T8C103F32STM

فصل چهارم: معرفی و بررسی کنترلر ربات اسکارا

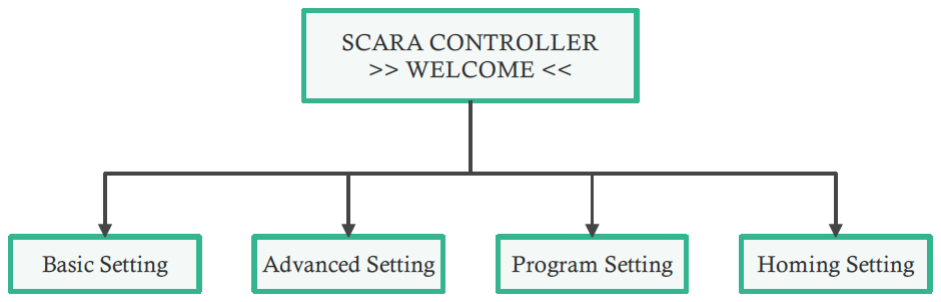
[picture p72: figure]

63

.4-4 آموزش کار با رابط کاربری کنترلر رابط کاربری کنترلر به چهار بخش اصلی تقسیم می شود که کاربر می تواند به راحتی عملکرد دستگاه را مشاهده و تنظیمات الزم را انجام دهد .

شکل -4 -36 منوی اصلی کنترلر ربات اسکارا

عالوه بر این، بر روی کنترلر سه دکمه و یک روتاری انکودر ولومی تعبیه شده است که برای هر یک وظیفه خاصی در نظر گرفته شده است و با استفاده از اینها می توان بین منو ها جابجا شد، وارد تنظیمات هر بخش شد و تغییرات الزم را برای هر یک اعمال نمود.

شکل -4 -37 دکمه های واقع بر روی کنترلر ربات اسکارا

همانطور که در شکل 37-4 مشاهده می نمایید از چپ به راست، دکمه STOP به عنوان یک شستی
1 | استپ اضطراری
در نظر گرفته شده است بدین معنا که با استفاده از این دکمه میتوان ربات را در هر لحظه
از برنامه متوقف نمود اما توجه شود که در صورت استفاده از این دکمه، ربات موقعیت خود را از دست می دهد و نیاز هست که مجدد ربات عملیات Homing را انجام دهد. دکمه RUN به عنوان یک شستی استارت در نظر گرفته شده است بدین معنا که با استفاده از این دکمه میتوان برنامه ای که برای ربات نوشته شده است را اجرا نمود و فقط در منوی Setting Program میتوان از آن استفاده نمود.

1 Emergency Stop

فصل چهارم: معرفی و بررسی کنترلر ربات اسکارا

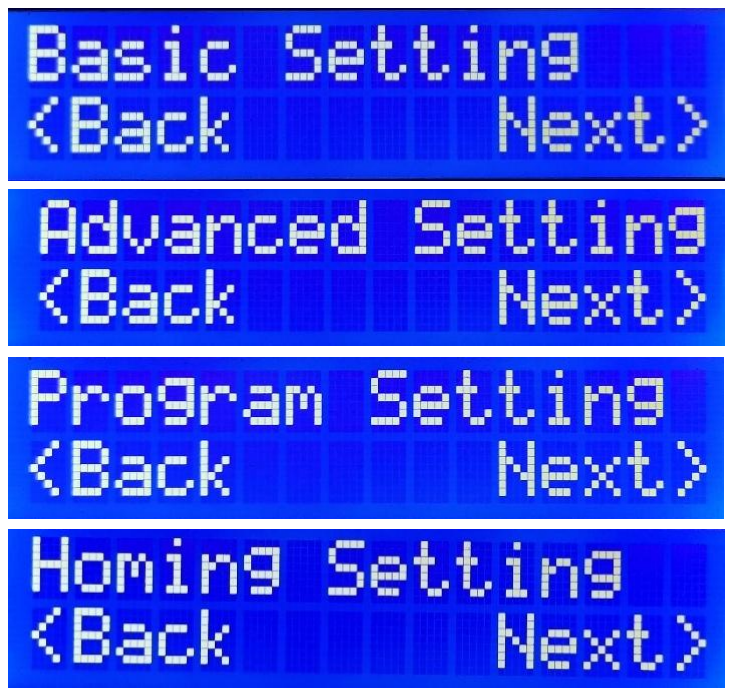
[picture p73: figure]

64

دکمه EXIT / SAVE برای ذخیره اطالعات تنظیم شده در هر بخش و خارج شدن از بخش مربوطه
در نظر گرفته شده است و دکمه ENTER که در واقع همان دکمه فشاری روتاری انکودر ولومی می باشد، میتوان وارد هر بخش از منوی کنترلر شد. همچنین با چرخش روتاری انکودر نیز میتوان بین منوها یا زیر منوها نیز جابجا شد.

.1-4-4 معرفی منوی اصلی کنترلر

1
منوی اصلی کنترلر شامل چهار بخش تنظیمات می باشد که با چرخش روتاری انکودر میتوان بین این تنظیمات جابجا شد و با فشردن دکمه روتاری انکودر نیز میتوان وارد این تنظیمات شد.

شکل -4 -38 معرفی منوی اصلی کنترلر

.2-4-4 معرفی منوی تنظیمات پایه

2
بخش اول منوی اصلی، تنظیمات پایه می باشد که در این بخش میتوان یکسری پارامترها را بصورت
کلی و همگانی تنظیم نمود. در شکل 39-4 تمام زیر مجموعه های این منو را مشاهده می کنید. این منو
3 | شامل سه بخش تنظیم سرعت، انتخاب نوع سینماتیک ربات و تعیین تعداد پالس بر دور
بر اساس میزان
تنظیمی روی درایو استپر موتور می باشد.

1 Main Menu
2 Basic Setting Menu
3 Pulse pre-Revolution

فصل چهارم: معرفی و بررسی کنترلر ربات اسکارا

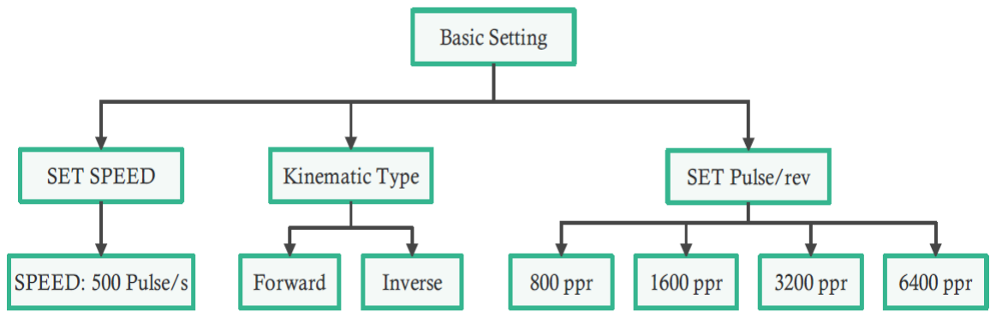
[picture p74: figure]

65

شکل -4 -39 زیر مجموعه های منوی تنظیمات پایه

SET SPEED بخش
در این بخش شما می توانید سرعت حرکت ربات را بر حسب پالس بر ثانیه تعیین کنید این میزان بیانگر فرکانس پالس تولیدی توسط کنترلر می باشد که به واسطه درایو به استپرموتور اعمال می شود.

شکل -4 -40 تنظیم سرعت حرکت ربات

در این بخش سرعت، توسط کاربر می تواند بطور معمول از مقدار حداقلی 10 تا حداکثر 9999 پالس
بر ثانیه تنظیم شود، اما باید توجه کنید که بدلیل محدودیت های مکانیکی ربات، حداقل سرعت قابل تنظیم در این بخش باید 200 هرتز یا پالس بر ثانیه و حداکثر سرعت مجاز نیز باید در محدوده 800 پالس بر ثانیه باشد، در غیر اینصورت موتور دچار لرزش شده و پالس گم می کند. برای تنظیم سرعت باید از روتاری انکودر استفاده نمایید ، بدین صورت که از چرخش آن برای افزایش
و کاهش اعداد و از دکمه فشاری آن برای جابجا شدن بین ارقام که در باال سمت راست با یک ضریب از 10 تا 1000 طبق شکل 40-4 مشخص می شود، استفاده کرد. دقت شود که برای خروج نیز طبق توضیحات پیشین باید از دکمه EXIT / SAVE استفاده نمایید، همچنین باید گفت که این مقدار تنظیمی برای همه استپر موتورهای ربات اسکارا تنظیم می شود.

فصل چهارم: معرفی و بررسی کنترلر ربات اسکارا

66

Kinematic Type بخش
در این بخش شما می توانید نوع سینماتیک ربات را انخاب نمایید. البته الزم به ذکر است که در
فصل بعدی در مورد این موضوع بیشتر توضیح خواهیم داد اما برای شناخت اولیه باید بدانید که ما دو نوع سینماتیک داریم، یکی سینماتیک مستقیم و دیگری سینماتیک معکوس. در سینماتیک مستقیم موقعیت های حرکتی ربات بر حسب زاویه مفصل ها بیان می شود یعنی با
1 | تنظیم زاویه هر مفصل، موقعیت نهایی
ربات، بدون دانستن موقعیت کارتزین یا XY انجام می شود. اما در
سینماتیک معکوس موقعیت های حرکتی ربات بدون دانستن مقدار زاویه مفاصل و با دانستن موقعیت نهایی بر حسب XY بیان می شود یعنی با تعیین موقعیت نهایی ربات بصورت کارتزین میتوان میزان زوایه قرارگیری مفاصل ربات را پیش بینی کرد.

شکل -4 -41 تعیین نوع سینماتیک ربات

برای انتخاب نوع سینماتیک ربات نیز باید از چرخش روتاری انکودر برای جابجایی بین گذینه ها و دکمه EXIT / SAVE برای ذخیره و خروج از این بخش استفاده کرد.

SET Pulse/rev بخش
در این بخش شما می توانید تعداد پالس بر دوری که بر روی درایو استپر موتور تنظیم کرده اید را
در اینجا تعیین نمایید. همانطور که در فصل قبل توضیح دادیم استپر موتور متناسب با ساختاری که دارد دارای یک میزان گام می باشد که بر حسب زاویه بیان می شود یعنی با توجه به اینکه گام همه استپر موتورهای این ربات، 1.8 درجه است برای چرخش یک دورکامل 360 درجه به میزان 200 پالس احتیاج خواهیم داشت و از آنجاییکه این تعداد پالس، دقت بسیار پایینی را در اختیار استفاده کننده قرار می دهد نیاز هست که بواسطه درایو این میزان را با قابلیت میکرو استپینگ به واحد های ریزتر تبدیل نماییم، در این حالت هرچه تعداد پالس بر دور بیشتر باشد میزان دقت حرکت ربات نیز افزایش می یابد ، در عوض احتمال از دست رفتن پالس های اعمالی به ربات نیز افزایش پیدا می کند.

1 End Effector

فصل چهارم: معرفی و بررسی کنترلر ربات اسکارا

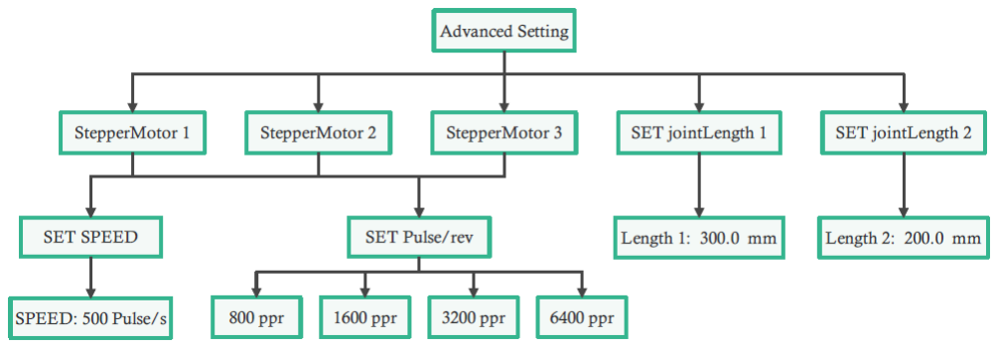
[picture p75: figure]

67

برای مثال فرض کنید که مقدار پالس بر دور را روی مقدار 3200 تنظیم نموده اید این بدین معناست
که برای چرخش هر دور کامل استپر موتور این میزان پالس مورد نیاز است، حال با تقسیم 360 بر این تعداد پالس، میزان زاویه چرخش استپر موتور به ازای هر پالس بدست می آید یعنی گام استپر موتور با این روش از 1.8 درجه به میزان 0.1125 درجه به ازای هر پالس کاهش پیدا کرده است.

شکل -4 -42 تعیین تعداد پالس بر دور ربات

برای انتخاب تعداد پالس بر دور ربات نیز باید از چرخش روتاری انکودر برای جابجایی بین گذینه ها
و دکمه EXIT / SAVE برای ذخیره و خروج از این بخش استفاده کرد. همچنین باید گفت که این مقدار تنظیمی برای همه استپر موتورهای ربات اسکارا تنظیم می شود.

.3-4-4 معرفی منوی تنظیمات پیشرفته

1
بخش دوم منوی اصلی، تنظیمات پیشرفته می باشد که در این بخش میتوان پارامترهایی که در
بخش تنظیمات پایه بصورت کلی تنظیم می شد را در این بخش بصورت جزئی تر تنظیم نمود. در شکل 43-4 تمام زیر مجموعه های این منو را مشاهده می کنید. این منو شامل پنج بخش تنظیم پارامترهای سرعت و پالس بر دور برای هر سه استپر موتور و تنظیم طول هر دو بازو یا مفصل ربات اسکارا می باشد.

شکل -4 -43 زیر مجموعه های منوی تنظیمات پیشرفته

1 Advanced Setting Menu

فصل چهارم: معرفی و بررسی کنترلر ربات اسکارا

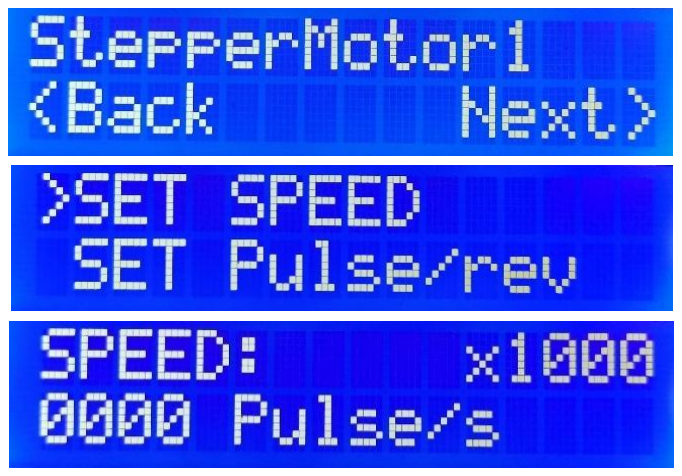
[picture p76: figure]

68

Stepper Motor 1 , 2 , 3 بخش
در این بخش شما می توانید همانند بخش تنظیمات پایه کلیه پارامترهای سرعت و پالس بر دور را بصورت اختصاصی و جداگانه برای هر یک از استپر موتورها تنظیم نمایید.

شکل -4 -44 تنظیم پارامترهای سرعت و پالس بر دور برای هر استپر موتور

SET joint Length 1 , 2 بخش
در این بخش شما می توانید طول هر یک از لینک ها یا مفاصل ربات را تنظیم کنید. این مقدار در محاسبات سینماتیک معکوس استفاده خواهد شد به همین خاطر ما به طول دقیق هر بازو احتیاج خواهیم داشت.

شکل -4 -45 تنظیم طول هر بازوی ربات اسکارا

برای تنظیم طول هر بازو همانند بخش های دیگر تنظیمات باید از روتاری انکودر استفاده نمایید،
بدین صورت که از چرخش آن برای افزایش و کاهش اعداد و از دکمه فشاری آن برای جابجا شدن بین ارقام که در باال سمت راست با یک ضریب از 0.1 تا 100 طبق شکل 45-4 مشخص می شود، استفاده کرد. برای خروج نیز طبق توضیحات پیشین باید از دکمه EXIT / SAVE استفاده نمایید. دقت کنید که این بخش پارامترها بصورت پیشفرض تعیین شده اند و نیازی به تنظیم هر بار آنها
بعد از روشن شدن کنترلر و ربات نیست. بنابراین اگر شرایط عملکردی و ساختاری ربات تغییر پیدا کرد در صورت لزوم می توانید این پارامترها را بر حسب نیاز خود تغییر دهید.

فصل چهارم: معرفی و بررسی کنترلر ربات اسکارا

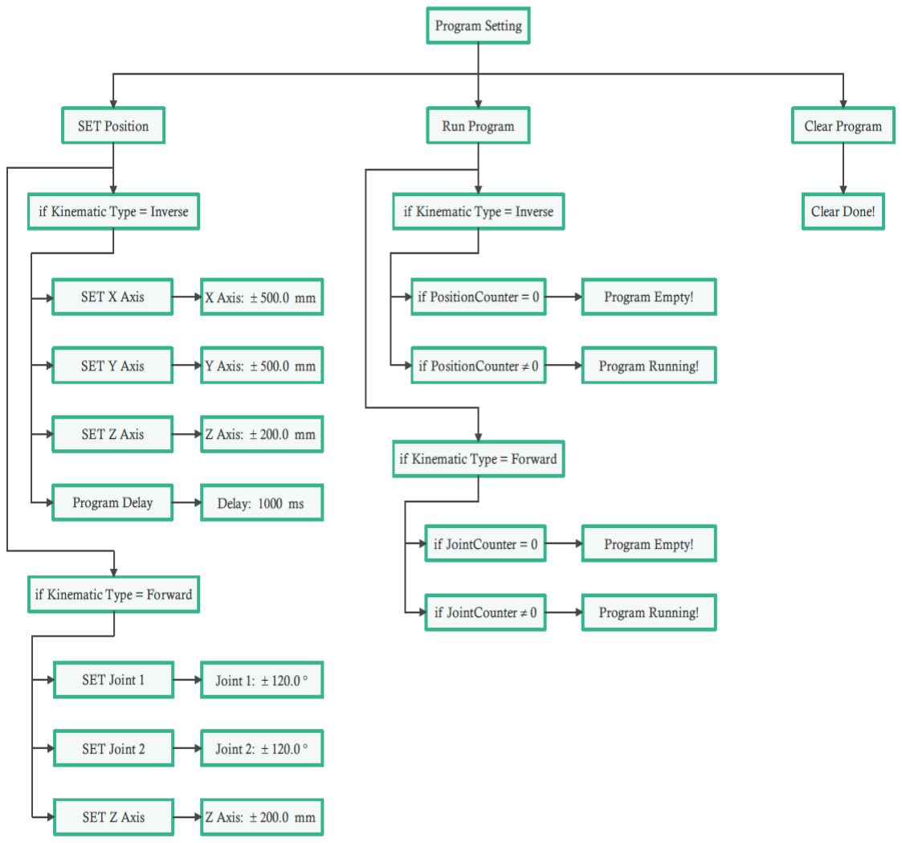
[picture p77: figure]

69

.4-4-4 معرفی منوی تنظیمات برنامه

1
بخش سوم منوی اصلی، تنظیمات برنامه می باشد که در این بخش میتوان موقعیت های ربات را متناسب با نوع سینماتیک ربات تنظیم و برنامه تنظیمی ربات را اجرا نمود. در شکل -4 46 تمام زیر مجموعه های این منو را مشاهده می کنید. این منو شامل سه بخش تنظیم موقعیت های ربات، اجرای برنامه تنظیمی ربات و پاک کردن برنامه یا کلیه موقعیت های تنظیم شده ربات می باشد .

شکل -4 -46 زیر مجموعه های منوی تنظیمات برنامه

1 Program Setting Menu

فصل چهارم: معرفی و بررسی کنترلر ربات اسکارا

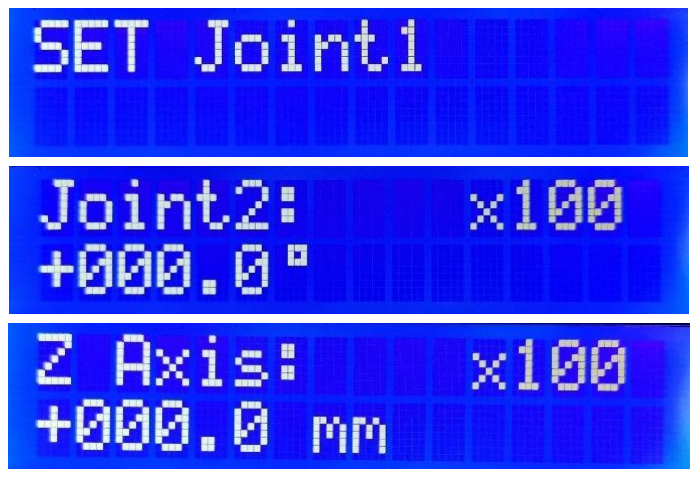
[picture p78: figure]

70

SET Position بخش
در این بخش شما می توانید موقعیت های ربات را متناسب با نوع سینماتیک ربات که در بخش تنظیمات پایه انتخاب شد تنظیم نمایید. در ابتدا که وارد این بخش می شود با شماره موقعیت مربوطه مواجه خواهید شد که اگر سینماتیک مستقیم را انتخاب کرده باشید ، این شمارش از صفر و اگر سینماتیک معکوس را انتخاب کرده باشید، این شمارش از یک شروع می شود. همچنین بصورت پیشفرض می توانید تا 25 موقعیت را در این بخش ثبت نمایید.

شکل -4 -47 تنظیم موقعیت های ربات

پس از وارد شدن به هر یک از موقعیت ها، اگر نوع سینماتیک ربات را از نوع مستقیم انتخاب کرده باشید، می توانید زوایای مفاصل یک و دو و همچنین میزان جابجایی محور Z ربات را تنظیم نمایید.

شکل -4 -48 تنظیم زوایای مفاصل یک و دو و میزان جابجایی محور Z ربات

در این بخش زوایا، توسط کاربر می تواند بطور معمول از مقدار حداقلی 0.1 تا حداکثر 999 درجه تنظیم شود، اما باید توجه کنید که بدلیل محدودیت های مکانیکی ربات، حداقل زاویه قابل تنظیم در این بخش باید 0.1 درجه و حداکثر زاویه مجاز نیز باید در محدوده ای که در بخش هومینگ تعیین شده است باشد. در بخش تنظیمات هومینگ توضیحات بیشتری در این مورد خواهیم داد. برای تنظیم زوایا همانند بخش های دیگر تنظیمات باید از روتاری انکودر استفاده نمایید، بدین صورت که از چرخش آن برای افزایش و کاهش اعداد و از دکمه فشاری آن برای جابجا شدن بین ارقام که در باال سمت راست با یک ضریب از 0.1 تا 100 طبق شکل 48-4 مشخص می شود، استفاده کرد و همچنین از دکمه RUN نیز می توانید برای تغییر عالمت زاویه استفاده نمایید.

فصل چهارم: معرفی و بررسی کنترلر ربات اسکارا

71

همانند تنظیم زوایا، میزان جابجایی محور Z نیز توسط کاربر می تواند بطور معمول از مقدار حداقلی
0.1 تا حداکثر 999 میلی متر تنظیم شود، اما باید توجه کنید که بدلیل محدودیت های مکانیکی ربات، حداقل میزان جابجایی قابل تنظیم در این بخش باید 0.1 میلی متر و حداکثر میزان جابجایی مجاز نیز باید در محدوده ای که در بخش هومینگ تعیین شده است باشد. اگر نوع سینماتیک ربات را از نوع معکوس انتخاب کرده باشید، می توانید مختصات کارتزین یا XYZ
و همچنین میزان تاخیر بین هر برنامه یا موقعیت را تنظیم نمایید.

شکل -4 -49 تنظیم مختصات کارتزین یا XYZ

این بخش نیز همانند بخش قبل تنظیم می شود، اما باید توجه کنید که بدلیل محدودیت های مکانیکی ربات، باید حداقل یکی از مختصات X یا Y ، در محدوده 200 تا 500 میلی متر تنظیم شده باشد در غیر اینصورت با خطا مواجه خواهید شد و موقعیت شما ثبت نمی شود. در بخش تنظیم تاخیر می توانید یک فاصله زمانی بر حسب میلی ثانیه بین هر برنامه یا موقعیت تنظیمی اختصاص دهید. همچنین برای تنظیم تاخیر باید از روتاری انکودر استفاده نمایید، بدین صورت که از چرخش آن برای افزایش و کاهش اعداد و از دکمه فشاری آن برای جابجا شدن بین ارقام که در باال سمت راست با یک ضریب از 10 تا 1000 طبق شکل 50-4 مشخص می شود، استفاده کرد.

شکل -4 -50 تنظیم تاخیر بین برنامه ها یا موقعیت ها

فصل چهارم: معرفی و بررسی کنترلر ربات اسکارا

72

Run Program بخش
در این بخش شما می توانید برنامه تنظیم شده در مرحله قبل را بر روی ربات اجرا نمایید و با دکمه
RUN واقع بر روی کنترلر این کار را انجام دهید. همانطور که قبال توضیح دادیم دکمه STOP نیز به عنوان
1 | یک شستی استپ اضطراری
در نظر گرفته شده است بدین معنا که با استفاده از این دکمه میتوان ربات
را در هر لحظه از برنامه متوقف نمود اما توجه شود که در صورت استفاده از این دکمه، ربات موقعیت خود را از دست می دهد و نیاز هست که مجدد ربات عملیات Homing را انجام دهد.

شکل -4 -51 اجرای برنامه تنظیمی بر روی ربات

دقت کنید که اگر هیچ برنامه ای در این بخش تنظیم نشده باشد، خطای شکل 52-4 بر روی صفحه LCD نمایش داده می شود.

شکل -4 -52 خطای عدم وجود برنامه برای اجرا

زمانی که برنامه ای در این بخش نیز تنظیم شده باشد، هشدار شکل 53-4 بر روی صفحه LCD نمایش داده می شود. همچنین توجه شود در هنگام اجرای برنامه هیچ تغییراتی را نمی توانید در کنترلر به غیر از متوقف کردن برنامه توسط دکمه STOP اعمال نمایید.

شکل -4 -53 هشدار اجرای برنامه

1 Emergency Stop

فصل چهارم: معرفی و بررسی کنترلر ربات اسکارا

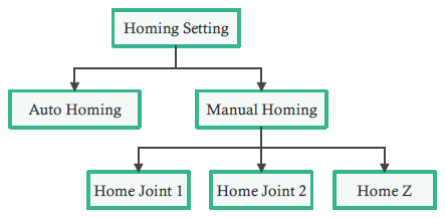
[picture p79: figure]

73

Clear Program بخش
در این بخش شما می توانید تمام برنامه یا موقعیت هایی که برای ربات تنظیم نموده اید را پاک و از ابتدا موقعیت یا برنامه جدیدی را تنظیم نمایید.

شکل -4 -54 پاک کردن برنامه تنظیمی ربات

برای پاک کردن برنامه یا موقعیت ها، فقط کافیست از دکمه فشاری روتاری انکودر استفاده نمود و پس از فشردن دکمه مربوطه، هشدار شکل 54-4 بر روی صفحه LCD نمایش داده می شود.

شکل -4 -55 هشدار پاک شدن موقعیت یا برنامه ها

.5-4-4 معرفی منوی تنظیمات هومینگ

1
بخش چهارم منوی اصلی، تنظیمات هومینگ می باشد که در این بخش میتوان موقعیت صفر و محدوده مجاز حرکت محورهای ربات را تعیین نمود. در شکل 56-4 تمام زیر مجموعه های این منو را مشاهده می کنید. این منو شامل دو بخش هومینگ خودکار و هومینگ دستی می باشد.

شکل -4 -56 زیر مجموعه های منوی تنظیمات هومینگ

1 Homing Setting Menu

فصل چهارم: معرفی و بررسی کنترلر ربات اسکارا

74

Auto Homing بخش
در این بخش شما می توانید تنها با استفاده از دکمه فشاری روتاری انکودر عملیات هومینگ را بصورت خودکار انجام دهید. این عملیات بدین صورت انجام می شود که بازوهای ربات به ترتیب از بازوی اول در هر موقعیتی که قرار داشته باشند، ابتدا در جهت ساعتگرد حرکت می کنند تا زمانی که توسط سنسور اول تشخیص داده شو ند، این بیانگر آن است که بازو یا مفصل ربات نمی تواند از زاویه مشخص شده بیشتر بچرخد. پس از برخورد بازوی ربات با سنسور اول، جهت آن معکوس شده و در جهت پاد ساعتگرد شروع به حرکت می کند تا زمانی که توسط سنسور بعدی تشخیص داده شود، در این حالت نیز مانند حالت قبل یک محدودیت زاویه ای برای بازوی ربات تعیین می شود و در نهایت بازوی ربات در موقعیت صفر یا هم راستا با محور X قرار می گیرد.

شکل -4 -57 انجام عملیات هومینگ بصورت خودکار

Manual Homing بخش
زمانی که در این بخش وارد شوید شما می توانید عملیات هومینگ برای تمام محورهای ربات اسکارا که در حالت خودکار انجام می شد، بصورت دستی انجام دهید.

شکل -4 -58 انجام عملیات هومینگ بصورت دستی

در این بخش نیز تنها با استفاده از دکمه فشاری روتاری انکودر می توانید عملیات هومینگ را بصورت دستی برای هر یک از محورهای ربات اسکارا انجام دهید.

فصل چهارم: معرفی و بررسی کنترلر ربات اسکارا

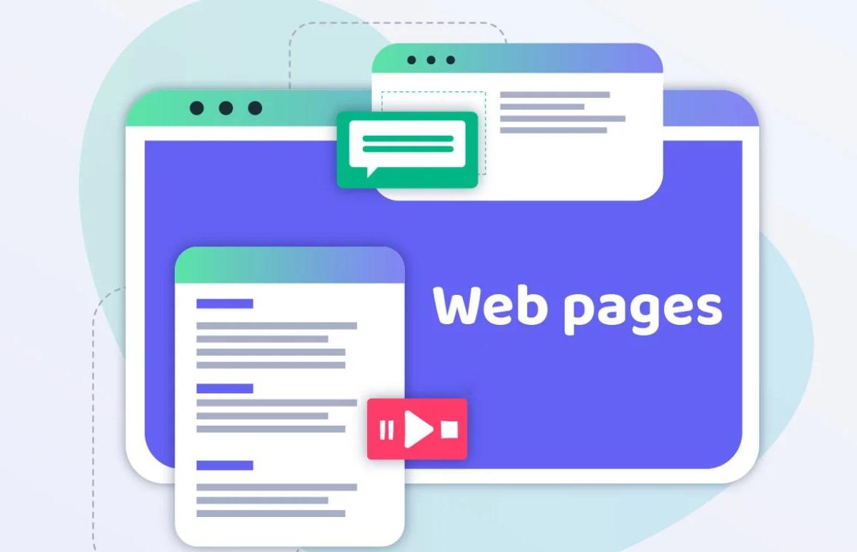
[picture p80: figure]

75

.5-4 معرفی انواع صفحات وب و پروتکل های ارتباطی استفاده از صفحه وب به کاربران این امکان را می دهد که با هر دستگاهی که دارای مرورگر است )مانند گوش ی هوشمند، تبلت یا کامپیوتر( به سادگی ربات را کنترل کرده یا وضعیت آن را مشاهده کنند . ترکیب قابلیت های صفحه وب و ماژول 8266ESP، نه تنها ارتباط بالدرنگ و پایدار را فراهم م ی کند ، بلکه توسعه و شخصی سازی پروژه ها را نیز آسان می سازد.

شکل -4 -59 معرفی انواع صفحات وب

ماژول 8266ESP، به دلیل توانایی اتصال به شبکه های Fi-Wi، پشتیبانی از پروتکل های استاندارد
وب و قیمت مناسب به ابزاری ایده آل برای ایجاد ارتباط بین ربات و وب سرور تبد یل شده است. این ماژول می تواند به عنوان یک سرور عمل کند و دستورات را از طری ق مرورگر در یافت کرده و به کنترلر منتقل کند یا داده های کنترلی ربات را در صفحه وب نمایش دهد .

.1-5-4 صفحات وب آنالین

1
صفحات وب آنالین به صفحاتی گفته می شود که برای عملکرد به اتصال دائمی به اینترنت و ارتباط
با یک سرور خارجی نیاز دارند . این صفحات به کاربران اجازه می دهند از طریق یک مرورگر وب، دستگاه هایی مانند رباتها یا سختافزارهایی که از ماژول هایی مانند 8266ESP استفاده می کنند را کنترل کنند . در این روش، تمام تبادل داده ها بین صفحه وب و ماژول 8266ESP از طریق سرور انجام می شود، که به کاربران امکان کنترل ربات یا دستگاه خود از هر نقطه جهان را میدهد . این صفحات ب ه ویژه برای پروژه هایی که نیاز به کنترل از راه دور یا اشتراک گذاری داده ها با چندین کاربر را دارند، ایده آل هستن د.

1 Online Web Pages

فصل چهارم: معرفی و بررسی کنترلر ربات اسکارا

76

.1-1-5-4 نحوه ارتباط با ماژول 8266ESP 1( ابتدا ماژول 8266ESP به یک شبکه Fi-Wi متصل می شود، سپس از پروتکل هایی مانند HTTP ، WebSocket و یا MQTT برای برقراری ارتباط با سرور استفاده می کند . 2( دستورات کاربر از طریق صفحه وب به سرور ارسال می شوند . 3( سرور این دستورات را به ماژول 8266ESP منتقل می کند . 4( پاسخهای ماژول 8266ESP به سرور ارسال شده و سپس به صفحه وب بازمی گردد.

.2-1-5-4 ویژگی های صفحات وب آنالین
- کنترل از راه دور
امکان کنترل دستگاه یا ربات از هر نقطه جهان با اتصال اینترنت.
- دسترسی چند کاربره
چندین کاربر می توانند به صورت هم زمان با صفحه وب متصل شوند .
- ادغام با سرویسهای ابری
امکان ذخیره سازی داده ها و ارائه گزارشات در سرورهای ابری مانند Firebase یا Cloud Google
- ارتباط بالدرنگ
با استفاده از WebSocket یا MQTT ، می توان داده ها را بدون تأخیر به روزرسانی کرد.

.3-1-5-4 چالش های صفحات وب آنالین
- نیاز به اتصال پایدار اینترنت در صورت قطع اینترنت، کنترل ربات امکان پذیر نیست.
- مشکالت امنیتی
به دلیل دسترسی از راه دور و قابلیت ارتباط از هر نقطه، صفحات وب آنالین باید از اقدامات امنیتی پیشرفته مانند رمزنگاری دادهها و احراز هویت قوی برخوردار باشند ، در غیر این صورت ممکن است در معرض حمالتی مانند هک یا نفوذ قرار بگیرند .
- وابستگی به سرور
اگر سرور از دسترس خارج شود، ارتباط با ماژول 8266ESP قطع می شود.
- پیچیدگی بیشتر
پیادهسازی نیازمند مهارت در مدیریت سرور و پروتکل های ارتباطی است.

فصل چهارم: معرفی و بررسی کنترلر ربات اسکارا

77

.2-5-4 صفحات وب آفالین

1
این نوع صفحات برای زمانی مناسب هستند که نیاز به اتصال به اینترنت نباشد و کاربر فقط در محدوده شبکه Fi-Wi محلی که توسط ماژول 8266ESP ارائه می شود، کنترل ربات را انجام دهد . این صفحات تمام عملکرد خود را به صورت آفالین و بدون نیاز به اتصال به سرور خارجی انجام می دهند .

.1-2-5-4 نحوه ارتباط با ماژول 8266ESP 1( کاربر به شبکه Fi-Wi که توسط 8266ESP ایجاد شده، متصل می شود. 2( یک صفحه وب شامل HTML ، CSS و JavaScript در خود ماژول 8266ESP میزبانی می شود. 3( دستورات کاربر به طور مستقیم از طریق صفحه وب به ماژول 8266ESP ارسال می شوند و نیازی به سرور خارجی نیست.

.2-2-5-4 ویژگی های صفحات وب آفالین
- بدون نیاز به اینترنت
این سیستم در محیط هایی که اینترنت در دسترس نیست، کاربرد دارد.
- ساده تر از صفحات آنالین
به دلیل عدم نیاز به سرور خارجی، پیاده سازی ساده تر است.
- عملکرد سریع تر
بدلیل اینکه ارتباطات به طور مستقیم بین صفحه وب و 8266ESP انجام می شود و نیازی به ارسال درخواست به سرور نیست عملکرد، بسیار سریع تر از صفحات آنالین خواهد بود.

.3-2-5-4 چالش های صفحات وب آفالین
- محدودیت در دسترسی
2 | از آنجایی که ماژول 8266ESP به عنوان نقطه دسترسی
عمل می کند، کاربر باید در محدوده شبکه
Fi-Wi که توسط ماژول 8266ESP ایجاد شده قرار داشته باشد .
- ارتباط تک کاربره
در این حالت، فقط یک دستگاه می تواند به طور همزمان به ماژول 8266ESP متصل شود. این موضوع می تواند محدودیت هایی را در کاربردهای چند کاربره ایجاد می کند .

1 Offline Web Pages
2 Access Point

فصل چهارم: معرفی و بررسی کنترلر ربات اسکارا

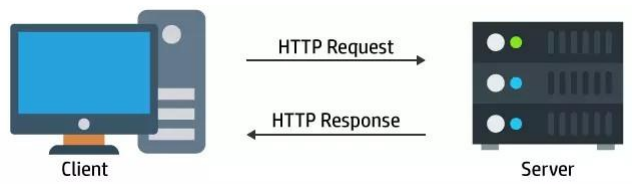
[picture p81: figure]

78

.3-5-4 روش های ارتباطی ماژول 8266ESP با صفحه وب ماژول هایESP مانند 8266ESP و 32ESP قابلیت های متعددی برای ارتباط با صفحات وب دارند.
این ارتباطات معموالً از طریق پروتکل های مختلف شبکه انجام می شوند. در ادامه، انواع روش های ارتباط این ماژول ها با صفحات وب توضیح داده شده است.

.1-3-5-4 ارتباط HTTP( سرور و کالینت( HTTP یک پروتکل استاندارد و رایج برای تبادل اطالعات در وب است که بر اساس مدل درخواست و پاسخ

1
عمل می کند . ماژول 8266ESP می تواند در دو نقش مختلف )کالینت یا سرور( در این پروتکل فعالیت کند .

شکل -4 -60 ارتباط HTTP
- حالت کالینت
ماژول 8266ESP به عنوان یک کالینت HTTP عمل می کند و درخواستهایی مانند GET یا POST را به یک سرور ارسال می کند .
- حالت سرور
در این حالت، ماژول 8266ESP به عنوان یک سرور HTTP عمل میکند و صفحات وب یا داده ها را در پاسخ به درخواست های کاربران )مرورگرها( ارائه می دهد .

.2-3-5-4 ارتباط WebSocket
WebSocketیک پروتکل ارتباطی است که امکان برقراری ارتباط مداوم و دوطرفه بین سرور و کالینت را فراهم می کند. برخالف HTTP که مبتنی بر ارسال درخواست و دریافت پاسخ است، WebSocket یک ارتباط دائمی ایجاد می کند که در آن هر دو طرف ) ماژول 8266ESP و مرورگر یا سرور( می توانند به صورت مستقل داده ارسال یا دریافت کنند .

1 Request / Response

فصل چهارم: معرفی و بررسی کنترلر ربات اسکارا

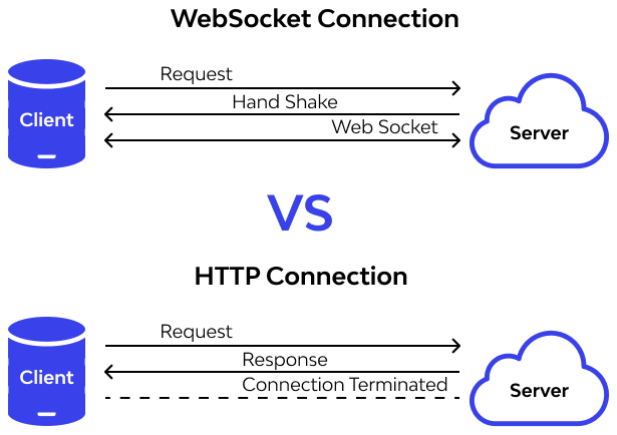
[picture p82: figure]
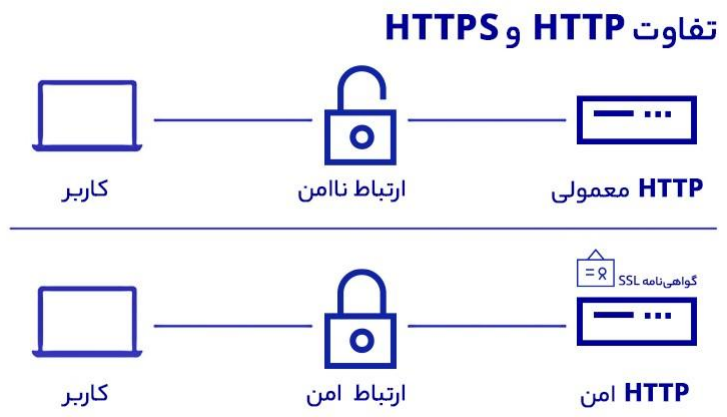
[picture p83: figure]

79

شکل -4 -61 ارتباط HTTP در مقابل ارتباط WebSocket

این روش برای مواردی که به انتقال بالدرنگ داده نیاز است، بسیار مناسب است. ارتباط WebSocket معموالً در پروژه هایی بکار می رود که نیاز به بروزرسانی لحظه ای اطالعات یا کنترل سریع دستگاهها وجود دارد.

.3-3-5-4 ارتباط HTTPS
HTTPS نسخه امن از پروتکل HTTP است که از رمزنگاری SSL برای ایمن سازی دادههای در حال انتقال استفاده می کند . این پروتکل به ویژه برای مواقعی که اطالعات حساس )مانند رمزهای عبور یا داده های خصوصی( باید منتقل شوند، بسیار حیاتی است.

شکل -4 -62 ارتباط HTTP در مقابل ارتباط HTTPS

فصل چهارم: معرفی و بررسی کنترلر ربات اسکارا

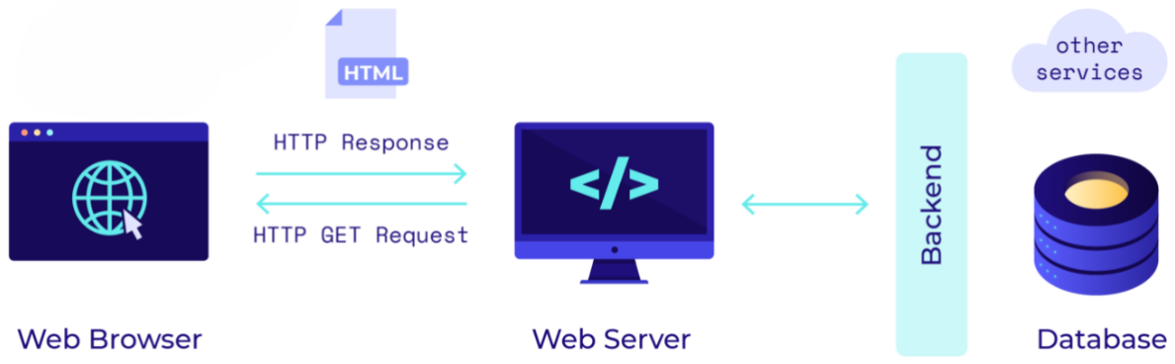
[picture p84: figure]

80

در ارتباط HTTPS ، داده ها قبل از ارسال، رمزگذاری شده و تنها توسط گیرنده قابل رمزگشایی هستند. ماژول 8266ESP می تواند به عنوان کالینت HTTPS عمل کرده و به سرورهای امن متصل شود یا داده های امن را از آن ها دریافت کند . پیاده سازی HTTPS نیازمند تنظیم گواهینامه های SSL و استفاده از کتابخانه های مناسب است که حجم و توان پردازشی ماژول 8266ESP را نیز در نظر می گیرند .

.6-4 معرفی و بررسی صفحه وب کنترلر در این پروژه، برای کنترل ربات از یک صفحه وب آفالین استفاده شده است و ارتباط بین ماژول 8266ESP و صفحه وب از طریق پروتکل HTTP برقرار میشود. در این ساختار، ماژول 8266ESP به عنوان سرور HTTP عمل می کند و صفحه وب نیز به عنوان کالینت به آن متصل می شود.

شکل -4 -63 ارتباط صفحه وب با ماژول 8266ESP

زمانی که صفحه وب فعال شده و درخواست هایی به ماژول ارسال میکند، ماژول 8266ESP داده ها
را پردازش کرده و اطالعات مورد نظر را به صفحه وب ارسال می کند یا دستورات کالینت را اجرا می کند . ویژگی های این طراحی عبارت اند از:
- کاهش پردازش در سمت ماژول 8266ESP به دلیل اینکه ماژول 8266ESP فقط زمانی داده ها را ارسال یا پردازش می کند که صفحه وب درخواست مشخصی را ارسال کرده باشد ، بار پردازشی ماژول کاهش می یابد .
- عملکرد مستقل کنترلر
ماژول 8266ESP و کنترلر حتی بدون فعال سازی صفحه وب نیز قادر به انجام وظایف اصلی خود هستند و عملکرد سیستم وابسته به صفحه وب نیست.
- سادگی پیاده سازی
استفاده از پروتکل HTTP به عنوان یک روش استاندارد، فرآیند ارتباط و مدیریت داده ها را ساده و کارآمد می سازد.

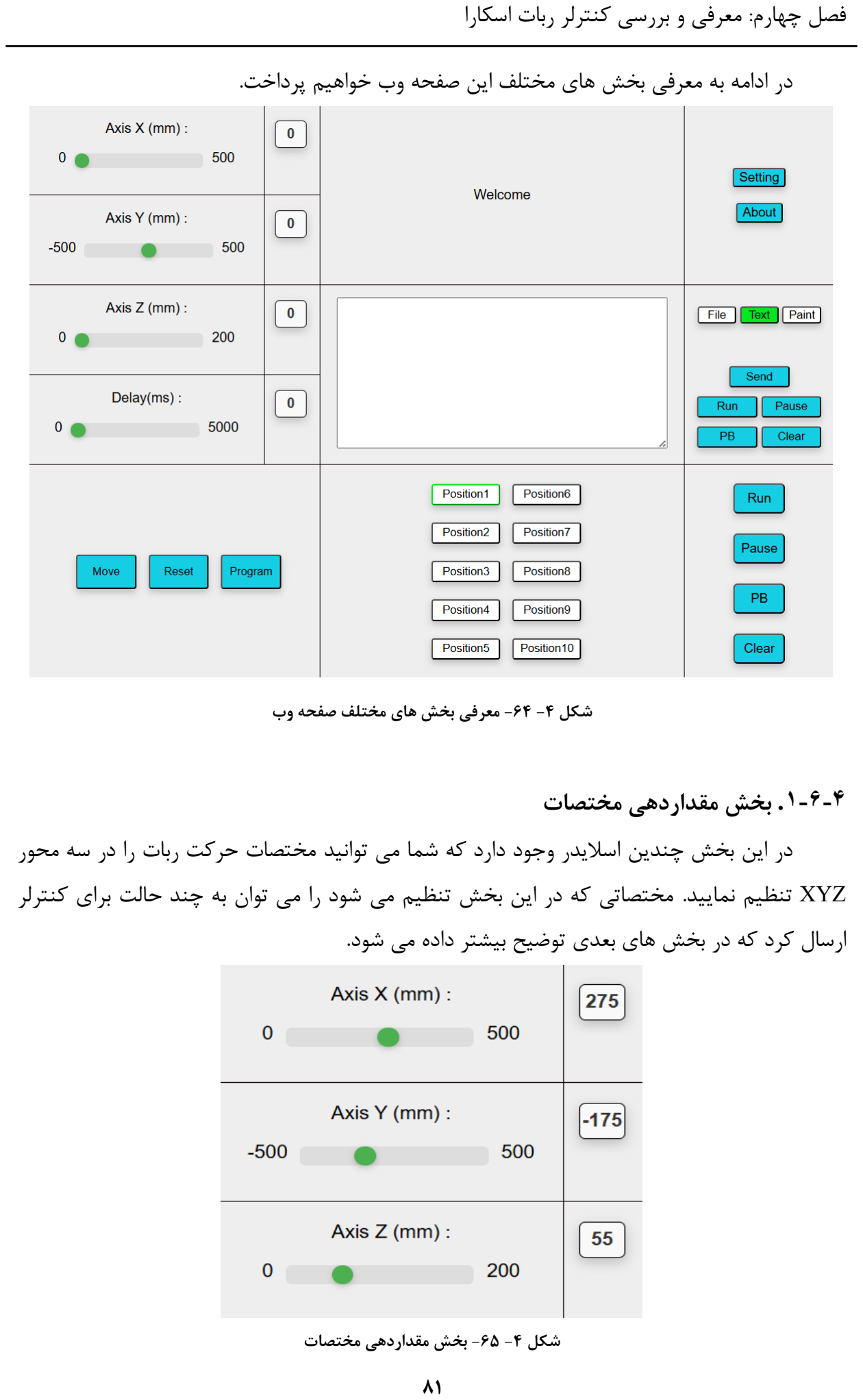
[picture p85: page 89]

فصل چهارم: معرفی و بررسی کنترلر ربات اسکارا

81

در ادامه به معرفی بخش های مختلف این صفحه وب خواهیم پرداخت.

شکل -4 -64 معرفی بخش های مختلف صفحه وب

.1-6-4 بخش مقداردهی مختصات در این بخش چند ین اسالیدر وجود دارد که شما می توانید مختصات حرکت ربات را در سه محور
XYZ تنظیم نمایید . مختصاتی که در این بخش تنظیم می شود را می توان به چند حالت برای کنترلر ارسال کرد که در بخش های بعدی توضیح بیشتر داده می شود.

شکل -4 -65 بخش مقداردهی مختصات

فصل چهارم: معرفی و بررسی کنترلر ربات اسکارا

82

.2-6-4 بخش دکمه های عملکردی در این بخش چند دکمه وجود دارد که عملکرد آنها در ادامه توضیح داده شده است.

شکل -4 -66 بخش دکمه های عملکردی

- عملکرد دکمه Move
با استفاده از این دکمه، مختصاتی که در بخش قبل تنظیم شده اند، مستقیماً به کنترلر ربات ارسال می شوند و کنترلر، ربات را به مختصات تنظیم شده حرکت می دهد .

شکل -4 -67 عملکرد دکمه Move

- عملکرد دکمه Reset
با استفاده از این دکمه، مختصاتی که در بخش قبل تنظیم شدهاند ، به حالت پیش فرض باز می گردند یا مقادیر آنها به صفر تغییر میکنند .

شکل -4 -68 عملکرد دکمه Reset

- عملکرد دکمه Program
با استفاده از این دکمه، مختصاتی که در بخش قبل تنظیم شده اند ، در یکی از موقعیت ها ذخیره می شوند . سپس می توانید ربات را متناسب با موقعیت های ذخیره شده، به حرکت درآورید .

شکل -4 -69 عملکرد دکمه Program

فصل چهارم: معرفی و بررسی کنترلر ربات اسکارا

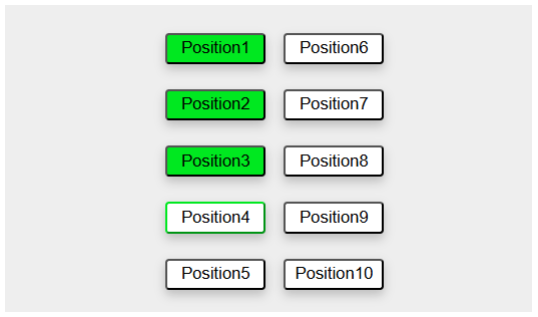
[picture p86: figure]

83

.3-6-4 بخش نمایش موقعیت های ذخیره شده موقعیت هایی که در بخش مقداردهی مختصات ذخیره میکنید، در یکی از خانه های این بخش نمایش داده می شود. هر خانه ای که مختصات در آن ذخیره شود، رنگ آن تغییر می کند و با کلیک روی خانههای سبز )موقعیت های ذخیره شده( می توانید مقادیر تنظیم شده برای آنها را در بخش مقداردهی مختصات نیز مشاهده کنید .

شکل -4 -70 نمایش موقعیت های ذخیره شده

.4-6-4 دکمه های کنترلی
در این بخش با استفاده از دکمه های موجود، می توانید موقعیت های ذخیره شده را به ترتیب اجرا کنید، متوقف کنید، ادامه حرکت را از سر بگیرید یا حتی تمامی موقعیتهای ذخیره شده را پاک کنید .

شکل -4 -71 دکمه های کنترلی

فصل چهارم: معرفی و بررسی کنترلر ربات اسکارا

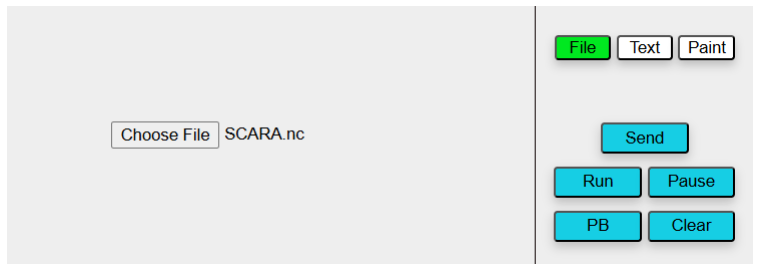
[picture p87: figure]

84

.5-6-4 بخش مدیریت کدها
در این بخش، می توانید نوع یا نحوه نوشتن کدها را تعیین کنید. این کار از طریق روش های زیر امکانپذیر اس ت:
- بارگذاری فایل Gcode
در این حالت شما می توانید فایل Gcode خود را از منابع دیگر وارد کنید و از داده های آن، برای کنترل ربات استفاده نمایید.

شکل -4 -72 محل بارگذاری فایل Gcode

- نوشتن دستی کدها
در این حالت شما می توانید با دانستن دستورات Gcode آنها را بصورت دستی وارد نمایید و با ارسال آنها به کنترلر ، فرمان مورد نظرتان را بر روی ربات اجرا کنید.

شکل -4 -73 محل نوشتن دستی کدها

- استفاده از بخش طراحی
در این حالت شما وارد محیط جدیدی خواهید شد که با استفاده از طراحی 2 بعدی می توانید ربات را کنترل نمایید. در ادامه به توضیحات بیشتری درمورد این بخش خواهیم پرداخت.

الزم به ذکر است که با استفاده از دکمه های موجود در این بخش مانند ارسال، اجرا، توقف و ... می توانید مانند بخش موقعیت ها، کدها را نیز مدیریت کنید.

فصل چهارم: معرفی و بررسی کنترلر ربات اسکارا

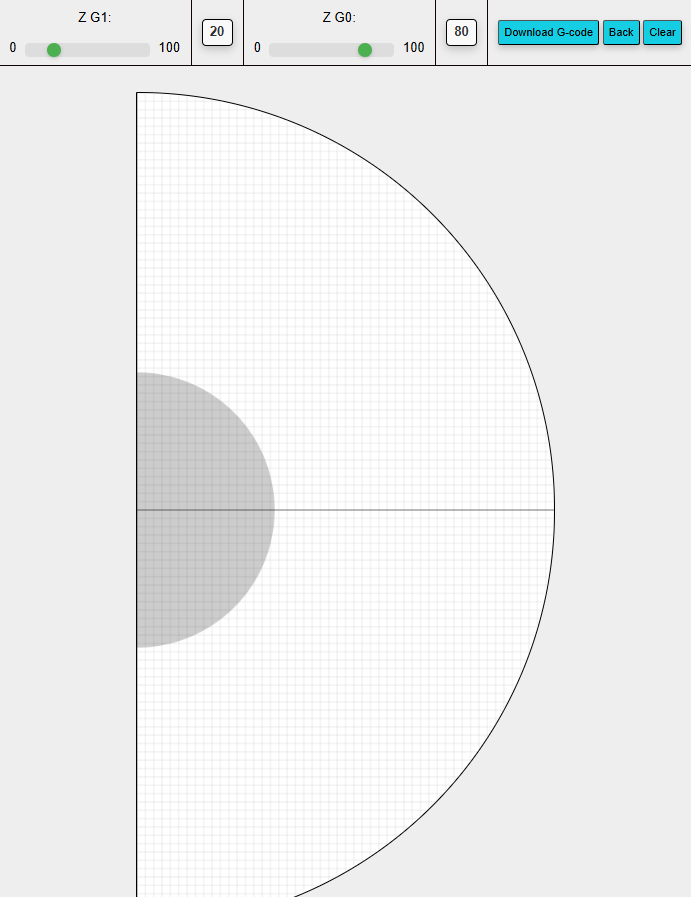
[picture p88: figure]

85

.6-6-4 بخش طراحی )Paint)
در این بخش، همانطور که در شکل 74-4 مشاهده می کنید یک صفحه مختصات به شکل نیم دایره قرار دارد. نقاطی که ربات توانایی حرکت به آنها را دارد، در این نیم دایره مشخص شدهاند . همچنین، با استفاده از اسالیدرهای باال، میتوانید ارتفاع بازوی ربات را در نقاط خط کشیشده )حرکت همراه با انجام کار« 1G Z )« یا مسیرهای آزاد )حرکت سریع ربات « 0G Z )« تنظیم کنید .

شکل -4 -74 محیط طراحی 2 بعدی

- عملکرد دکمه Clear
این دکمه به شما امکان می دهد تا طرح ها و خطوطی که ایجاد کرده اید را پاک کنید .

شکل -4 -75 عملکرد دکمه Clear

فصل چهارم: معرفی و بررسی کنترلر ربات اسکارا

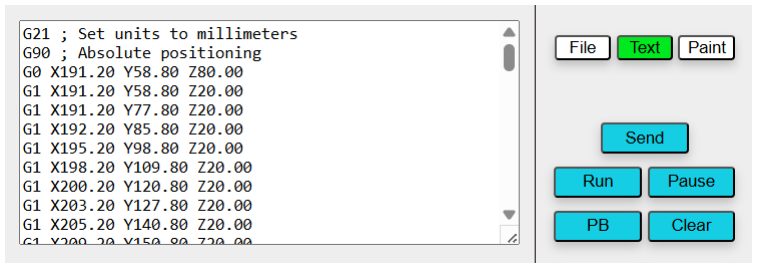
[picture p89: figure]

86

- عملکرد دکمه Back
با استفاده از این دکمه، می توانید به صفحه قبل یا صفحه اصلی بازگردید .

شکل -4 -76 عملکرد دکمه Back

Download Gcode | دکمه | عملکرد |
زمانی که طراحی یا مشخص کردن مسیرهای حرکتی روی صفحه به اتمام رسید، می توانید از این دکمه استفاده کنید. این دکمه صفحه وب را وادار می کند تا یک Gcode متناسب با طرح شما ایجاد کرده و در اختیار شما قرار دهد .

شکل -4 -77 عملکرد دکمه Gcode Download

همچنین شما می توانید کدهای تولید شده از بخش طراحی را در صفحه اصلی وب مشاهده و در صورت نیاز ویرایش نمایید .

شکل -4 -78 نمایش کدهای تولید شده در بخش طراحی

فصل چهارم: معرفی و بررسی کنترلر ربات اسکارا

87

.7-6-4 بخش نمایش پیامهای وضعیت این بخش با نمایش پیام های متنی کوتاه، شما را از وضعیت عملکرد ربات مطلع می کند. به عنوان مثال، زمانی که ربات بر اساس موقعیت های تعریف شده در حال حرکت باشد، پیام running is Positions نمایش داده می شود.

.8-6-4 بخش تنظیمات و اطالعات این بخش شامل دو بخش اصلی تنظیمات )Setting )و درباره ما )About )می باش د .
- بخش درباره ما ) About)
در این بخش، اطالعاتی مانند نام دانشگاه، اسامی دانشجویان، استاد راهنما، زمان ایجاد پروژه و همچنین لینک دریافت فایل های پروژه قرار گرفته است. این اطالعات به دانشجویانی که عالقه مند به ادامه کار و پژوهش در این حوزه هستند، کمک می کند تا با ربات و کنترلر طراحی شده بیشتر آشنا شوند .

شکل -4 -79 بخش درباره ما

- بخش تنظیمات (Setting(
این قسمت شامل مجموعه ای از پارامترهای کنترلی ربات است. کاربران می توانند مقادیر تنظیم شده
را مشاهده کرده یا مقادیر جدیدی برای آن ها تعیین کنند . دقت کنید که پارامترهای تنظیمی در این بخش همانند پارامترهای تنظیمی در کنترلر می باشد، بنابراین تغییرات بصورت لحظه ای و هماهنگ در هر دو طرف انجام خواهد شد.

شکل -4 -80 بخش تنظیمات

فصل چهارم: معرفی و بررسی کنترلر ربات اسکارا

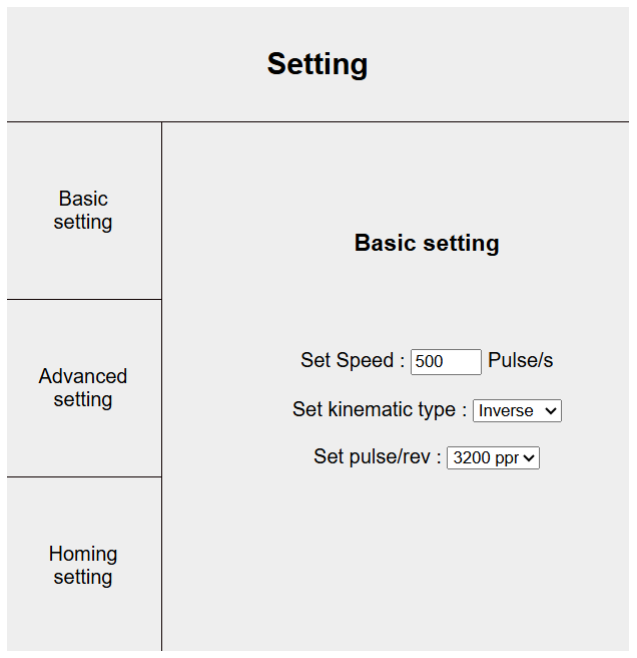
[picture p90: figure]

88

شکل -4 -81 پارامترهای بخش تنظیمات پایه

.9-6-4 بخش تنظیم تاخیر در موقعیت ها تأخیرهای تنظیم شده برای موقعیت ها به این منظور هستند که ربات در هر نقطه برای مدت زمان مشخصی توقف کند. این تأخیر توسط ماژول 8266ESP اعمال میشود. به عبارت دیگر، هنگام ارسال موقعیت ها، پس از دریافت پیام از کنترلر مبنی بر اتمام حرکت )یعنی رسیدن ربات به موقعیت فعلی( موقعیت بعدی با تأخیر مشخصشده به کنترلر ارسال می شود.

شکل -4 -82 تنظیم فاصله زمانی بین موقعیت ها

فصل چهارم: معرفی و بررسی کنترلر ربات اسکارا

89

.7-4 بررسی وظایف ماژول 8266ESP با صفحه وب در این پروژه، ماژول 8266ESP وظیفه دارد که داده ها، مختصات، تنظیمات و اطالعات مختلف را از
صفحه وب و کنترلر دریافت کرده و ذخیره نماید. سپس در مواقع ضروری، این داده ها را به کنترلر یا صفحه وب ارسال کند. وظایف اصلی این ماژول به شرح زیر است:

.1-7-4 ذخیره موقعیت های حرکت ربات یکی از وظایف اصلی ماژول 8266ESP این است که تمامی موقعیت هایی که توسط کنترلر یا صفحه
1 | وب تنظیم می شوند را در حافظه رم
خود ذخیره نماید . به محض نیاز، ماژول می تواند این موقعیت ها را به
ترتیب، با تأخیرهای معین و به صورت خط به خط، برای کنترلر ارسال کند .

.1-1-7-4 ویژگی های ذخیره موقعیت ها در حافظه رم
- افزایش حافظه ذخیره سازی کنترلر این امر باعث می شود که کنترلر بتواند موقعیت ها را بدون نیاز به ذخیره سازی آنها در حافظه فلش مدیریت کند .
- دسترسی سریع تر و راحت تر صفحه وب به موقعیت ها صفحه وب می تواند به طور مستقیم موقعیت ها و پارامترهای مرتبط با آنها را مشاهده و تغییر دهد .
- بروز بودن وضعیت سیستم
وضعیت ماژول 8266ESP و صفحه وب همواره همگام با وضعیت کنترلر و ربات خواهد بود.

.2-1-7-4 چالش های ذخیره موقعیت ها در حافظه رم
- وابستگی دائمی به ماژول 8266ESP در صورتی که ارتباط با ماژول 8266ESP قطع شود، کنترلر از دریافت موقعیت ها و اطالعات الزم محروم خواهد شد .
- تأخیر در ارسال اطالعات
اگرچه تأخیر این فرآیند بسیار کم است، اما در موارد خاص ممکن است منجر به تأخیر در حرکت ربات شود.

1 Random Access Memory (RAM)

فصل چهارم: معرفی و بررسی کنترلر ربات اسکارا

90

.3-1-7-4 علت ذخیره موقعیت ها در حافظه رم ذخیره سازی موقعیت ها در حافظه رم ماژول 8266ESP بدلیل سرعت باالی این حافظه در مقایسه
1 | با حافظه فلش
ضروری است. اگر موقعیت ها در حافظه فلش ذخیره شوند، زمان الزم برای خواندن اطالعات
افزایش یافته و این تأخیر می تواند موجب مشکالت در حرکت ربات شود. همچنین، بدلیل تغییرات مداوم موقعیت ها توسط اپراتور یا سیستم، استفاده از حافظه رم به عنوان محل ذخیره سازی، از لحاظ عمر و کارایی برای ماژول مناسبتر است، چراکه استفاده مکرر از حافظه فلش می تواند باعث کاهش عمر مفید آن شود.

.2-7-4 دریافت پارامتر حرکت Move از صفحه وب زمانی که دستور حرکت Move برای ربات صادر می شود، وظیفه ماژول 8266ESP این است که مختصات مربوطه را دریافت و آنها را به فرمت استاندارد تبدیل کند و برای کنترلر ارسال نماید. سپس کنترلر از این مختصات برای حرکت دادن ربات به نقطه مورد نظر استفاده خواهد کرد.

.3-7-4 دریافت و پردازش کدهای حرکتی زمانی که صفحه وب، کدهای حرکتی (Gcode (تولید می کند و دکمه ارسال فعال می شود، کدهای تولیدشده به ترتیب برای ماژول 8266ESP ارسال خواهند شد. وظیفه ماژول این است که این کدها را در متغیرهای مربوطه ذخیره کرده و هنگام نیاز، آن ها را به کنترلر ارسال کند. همچنین، هنگامی که دکمه Clear فعال شود، ماژول 8266ESP باید تمامی متغیرهای ذخیره کننده کدها را خالی کرده و آماده دریافت و ارسال مجدد کدها گردد.

.4-7-4 ارسال موقعیت ها و کدهای حرکتی به کنترلر یکی از وظایف کلیدی ماژول 8266ESP ارسال دقیق و به موقع موقعیت ها و کدهای حرکتی به کنترلر برای اجرای دستورات حرکتی ربات است. مراحل ارسال موقعیت ها به شرح زیر اس ت:

1( پس از دریافت دستور حرکت، ماژول 8266ESP اولین موقعیت را به کنترلر ارسال می کند . 2( ماژول منتظر می ماند تا کنترلر پس از به حرکت درآوردن ربات و رسیدن به موقعیت اول، پیامی مبنی بر اتمام حرکت به ماژول ارسال کند . 3( پس از دریافت پیام اتمام حرکت، ماژول 8266ESP موقعیت بعدی را به کنترلر ارسال می کند و این فرآیند تا ارسال تمامی موقعیتها ادامه پیدا می کند.

1 FLASH

فصل چهارم: معرفی و بررسی کنترلر ربات اسکارا

91

.5-7-4 دریافت تنظیمات از کنترلر به صفحه وب یکی از چالشهای موجود در کنترلر این است که پارامترها و مقادیر تنظیمی در کنترلر قابل مشاهده نیستند . به عبارت دیگر، اپراتور تنها می تواند تغییرات جدید را اعمال کند، اما نمی تواند مقادیر قبلی تنظیم شده را مشاهده نماید . برای رفع این مشکل، تمامی پارامترها و مقادیر تنظی می در کنترلر به ماژول 8266ESP ارسال می شود تا ماژول این این پارامتر ها را برای نمایش در صفحه وب ارسال کند . بدین ترتیب، مقادیر جدید به طور دقیق در صفحه وب قابل مشاهده خواهند بود.

.6-7-4 ارسال تنظیمات از صفحه وب به کنترلر یکی از ویژگی های مهم این پروژه، امکان تغییر تنظیمات کنترلر از طریق صفحه وب است. به این معنا که عالوه بر مشاهده تنظیمات اعمالشده، کاربران قادر به تغییر و اصالح تنظیمات از طریق صفحه وب خواهند بود. ماژول 8266ESP مسئول دریافت تغییرات تنظیمات اعمالشده از صفحه وب و ارسال آن ها به کنترلر از طریق ارتباط سریال است تا این تغییرات در تنظیمات کنترلر اعمال شوند .

.8-4 نحوه ارتباط ماژول 8266ESP با کنترلر برای برقراری ارتباط بین ماژول 8266ESP و کنترلر، از پروتکل UART استفاده شده که یکی از سریعترین و بهینه ترین روش های ارتباطی محسوب می شود.

.1-8-4 ویژگی های استفاده از ارتباط سریال
- سادگی و کارایی بال
1 | ارتباط سریال نیازی به پروتکلهای پیچیده ندارد و برای انتقال داده ها در سیستمهای نهفته
بسیار
مناسب است.
- انعطاف پذیری
ارتباط سریال می تواند با سرعتهای مختلفی کار کند و تنظیمات مختلفی مانند بیتهای داده، بیتهای توقف و بیت های توازن را پشتیبانی کند.
- امکان ارسال و دریافت داده ها در لحظه ارتباط دو طرفه بین کنترلر و ماژول 8266ESP باعث می شود که داده های حرکتی به صورت بالدرنگ پردازش شوند .

1 Embedded Systems

فصل چهارم: معرفی و بررسی کنترلر ربات اسکارا

92

.2-8-4 پیاده سازی ارتباط سریال
1 | در این پروژه، ارتباط سریال به صورت دستی
طراحی شده است. بدین معنا که داده های ارسالی و
دریافتی دارای قالب مشخصی هستند که در قالب کدهای سریال تبادل می شوند . این کدها بر اساس نیازهای حرکتی ربات طراحی شده اند و شامل دستورات کنترلی مانند ذخیره موقعیت ها، ارسال فرامین حرکتی و تأیید دریافت داده ها می باشند .

جدول -4 -2 معرفی بخشی از تبادل کدهای سریال بین کنترلر و ماژول 8266ESP
توضیحات | ارسال از طرف | دریافت از طرف | کد سریال
ذخیره موقعیت ها در ماژول 8266ESP و نمایش انها در صفحه وب | کنترلر | ESP | Positions I— = X— Y— Z— T—
ارسال موقعیت ها به کنترلر جهت حرکت ربات | ESP | کنترلر | Positions I— = X— Y— Z— T—
| | | Run Positions ESP کنترلر شروع حرکت
توقف موقت حرکت | | ESP کنترلر | Positions Pause
| | کنترلر ESP
توقف و امکان ادامه حرکت از نقطه اول | | ESP کنترلر | Positions pBack
| | کنترلر ESP
| | ESP کنترلر پاک کردن تمام موقعیت های ذخیره کنترلر ESP شده | Positions Clear
تایید دریافت و اتمام حرکت بر اساس اطالعات ارسال شده | کنترلر | ESP | Ok

1 Custom Serial Protocol

## 5 فصل پنجم: سینماتیک و پروفایلهای حرکتی ربات اسکارا

فصل پنجم: سینماتیک و پروفایلهای حرکتی ربات اسکارا

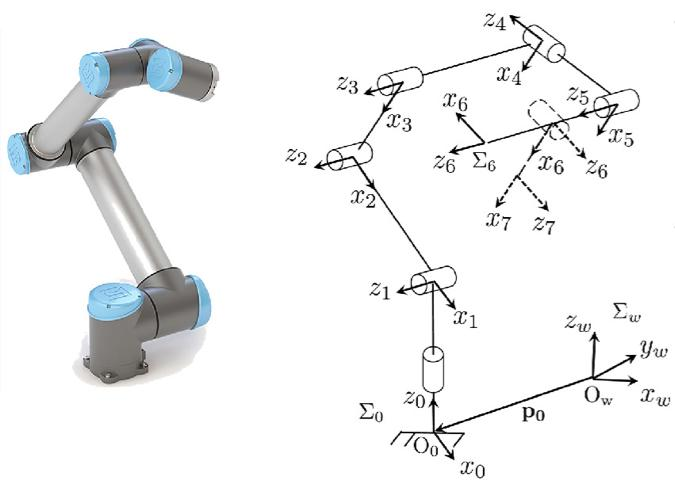
[picture p91: figure]

94

.1-5 معرفی و بررس ی مدلسازی سینماتیکی سینماتیک در رباتیک علمی است که به بررس ی حرکت و موقعیت اجزای ربات ها میپردازد. این حوزه
از ریاضیات و فیزیک، با استفاده از مدلسازی ریاضی، نحوه جابجایی، سرعت و شتاب اجزا را توصیف می کند . مدلسازی س ینماتیکی ربات به معنای تعریف رابطه های ریاضی بین اجزا ی مکانیکی ی ک ربات است. برای مدلسازی س ینماتیک، از مفاصل و ارتباطات بین قطعات استفاده م ی شود و با توجه به نوع ربات و ساختار آن، از روش های مختلفی برای مدلسازی استفاده می شود؛ این مدلسازی کمک م ی کند رباتها را برنامه ریزی کرد و حرکات دقیق و مورد ن یاز برای انجام وظایف مشخ ص را ایجاد نمود.

شکل -5 -1 مدلسازی یک ربات شش محور

به طور کلی، س ینماتیک تکنیکی است که به ما امکان می دهد تعیین کن یم چگونه چیزی را از یک موقعیت به موقعیت دیگر منتقل کنیم. وقتی م ی خواهید یک لیوان آب رو ی میز بگ یرید، مغز شما اساساً شکل پیچیدهای از س ینماتیک را انجام م ی دهد تا بفهمد چگونه مفصل شانه، مفصل آرنج و مچ دست خود
1 | را بچرخانید تا دست خود را به سمت لیوان حرکت دهید . س ینماتیک ربات به دو دسته، س ینماتیک مستقیم
و س ینماتیک معکوس

2
تقسیم بند ی می شود که هرکدام وظایف و نقش های مختلفی در فهم و کنترل
حرکت ربات ها دارند.

1 Forward Kinematic

2
Inverse Kinematic

فصل پنجم: سینماتیک و پروفایلهای حرکتی ربات اسکارا

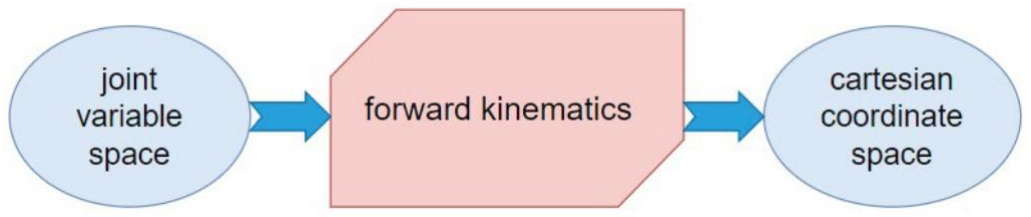
[picture p92: figure]
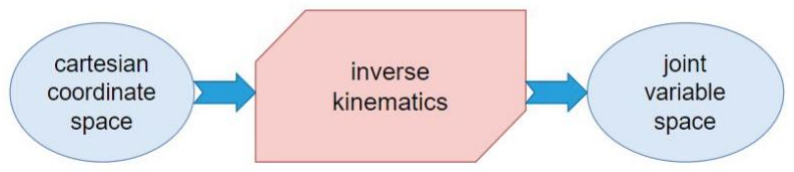
[picture p93: figure]

95

.1-1-5 معرفی سینماتیک مستقیم در س ینماتیک مستقیم، تالش برای تعیین حرکت و موقعیت اجزا بر اساس پارامترهای ورود ی انجام
می شود. این پارامترها معموالً شامل زوایا و ابعاد مکانیکی مانند طول اعضا و اتصاالت م یشوند . با استفاده از این اطالعات، می توان حرکت و موقعیت اجزا را به صورت ریاضی و دقیق مدل کرد. بنابراین هدف از س ینماتیک مستقیم، بدست آوردن موقعیت و جهت گ یری مجری نهایی

1
با توجه به پیکربندی رابط های
میانی ربات است. همانطور که در شکل 2-5 مشاهده می کن ید، از س ینماتیک مستق یم برا ی تبد یل متغیرهای مفصل به موقعیت مجری نهایی استفاده م ی شود.

شکل -5 -2 سینماتیک مستقیم

.2-1-5 معرفی سینماتیک معکوس سینماتیک معکوس به معنای تعیین ورودی های مورد نیاز برای رس یدن به حرکت یا موقع یت مشخص است. با داشتن حرکت یا موقعیت مورد نظر، این نوع از س ینماتیک امکان محاسبه و یافتن ورود ی های الزم برای دستیابی به آن را فراهم می کند . این امر بسیار مهم است زیرا در کنترل ربات ها و ماش ینها، ممکن است بخواهیم به طور مستقیم یک موقع یت یا حرکت خاص را بدست آوریم و نیاز داریم تا ورودی های مورد نیاز برای رس یدن به آن را محاسبه کنیم. بنابراین هدف از س ینماتیک معکوس، بدست آوردن موقعیت و جهت گیری رابط های میانی ربات با توجه به موقعیت و جهت گیری مجری نهایی است. همانطور که در شکل 3-5 مشاهده می کنید، از س ینماتیک معکوس برای یافتن متغیرهای مفصل از موقعیت مجری نهایی استفاده می شود.

شکل -5 -3 سینماتیک معکوس

1 End Effector

فصل پنجم: سینماتیک و پروفایلهای حرکتی ربات اسکارا

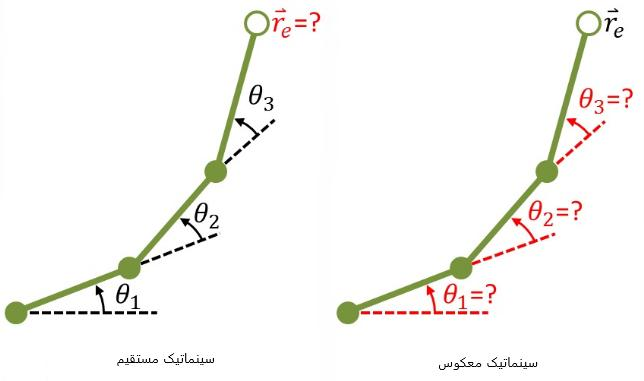
[picture p94: figure]
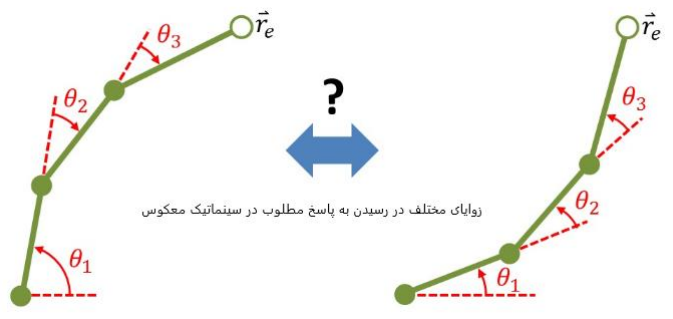
[picture p95: figure]

96

حال فرض کنید ما یک بازوی ربات دو بعد ی داریم که از چند ین مفصل چرخشی تشکیل شده است
که به یک مجری نهایی منته ی می شود. عامل پایانی ممکن است یک گیره یا نوعی ابزار باشد . هر مفصل با یک زاویه مشترک تعریف م ی شود که با θ نشان داده م ی شود و مجری نهایی در مکان ی در فضای فی زیکی قرار دارد که با بردار موقعیت re نشان داده می شود. س ینماتیک مستقیم م ی پرسد، اگر زوایای مفصل را بدانیم، مختصات re چیست؟ از سوی دیگر، س ینماتیک معکوس می پرسد، اگر ما یک موقعیت مؤثر انتهایی مطلوب داریم که عبارت است از re آنگاه، زوایای مشترک مورد نیاز برای رس ید ن به آن موقعیت چیست؟

شکل -5 -4 فرم تبدیل سینماتیک مستقیم و معکوس

بر خالف س ینماتیک مستقیم، پاسخ به سوال س ینماتیک معکوس به دلیل این واقعیت پیچیده است
که همیشه یک راه حل واحد ندارد. معموالً چند ین جهت یا موقعیت وجود دارد که به س یستم اجازه می دهد به همان موقع یت مجری نهایی هدف برسد. برای بررس ی ب یشتر این موضوع، ابتدا باید تصمیم بگ یریم که چگونه بازو ی ربات خود را بصورت ریاضی توصیف کنیم.

شکل -5 -5 موقعیت قرارگ یری مجر ی نهایی در سینماتیک معکوس

فصل پنجم: سینماتیک و پروفایلهای حرکتی ربات اسکارا

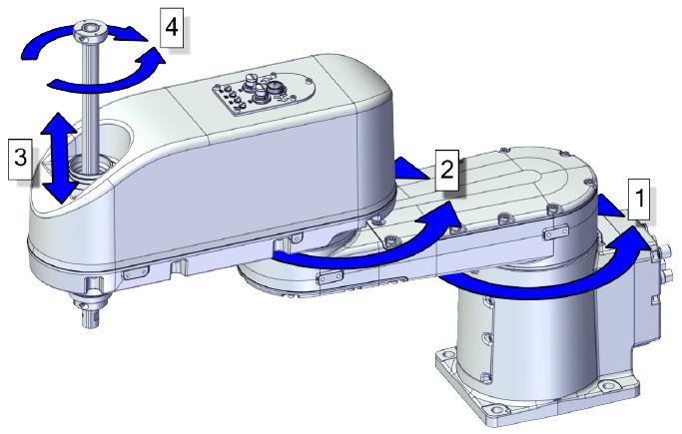
[picture p96: figure]
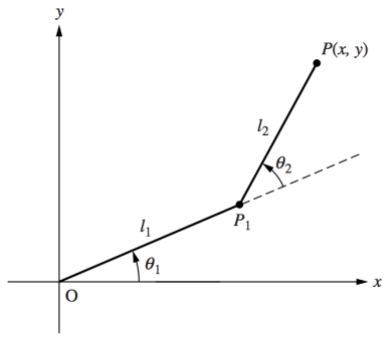
[picture p97: figure]

97

.3-1-5 مدلسازی سینماتیکی ربات اسکارا همانطورکه در فصل های پیشین گفته شد، ربات اسکارا سه محور عمودی برای حرکت دورانی دارد
)در شکل زیر محورها ی 1 و 2 و 4( که از این سه محور یکی حول محور Z و دو محور دیگر ن یز بصورت زانویی حول محور Z چرخش انجام می دهند. و درنهایت محور 3 نیز حرکت خطی در راستای محور Z انجام می دهد.

شکل -5 -6 تقسیم بندی محورهای ربات اسکارا

.1-3-1-5 پیاده سازی سینماتیک مستقیم پیاده سازی س ینماتیک مستق یم ربات اسکارا نسبتاً ساده است و به راحتی قابل انجام است. در این بخش، پیاده سازی سینماتیک مستق یم به روش گرافیکی ارائه شده است.

شکل -5 -7 پیاده سازی سینماتیک مستقیم ربات اسکارا

فصل پنجم: سینماتیک و پروفایلهای حرکتی ربات اسکارا

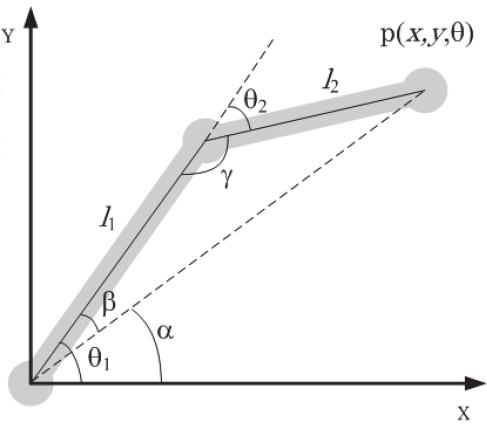
[picture p98: figure]

98

در این روش از جبر بردار ی برای محاسبه مختصات کارتزین ربات اسکارا و موقع یت مجری نهایی استفاده می شود. بد ین صورت مختصات X و Y با استفاده از زوایا و طول لینک مفاصل بصورت زیر بدست خواهد آمد.

x = l1 cos(θ1

) + l2 cos(θ1 + θ2

)
y = l1 sin(θ1

) + l2 sin(θ1 + θ2

)

.2-3-1-5 پیاده سازی سینماتیک معکوس به طورکلی، راه حلهای سینماتیک معکوس غیرخطی هستند و پیدا کردن این معادالت می تواند پیچیده باشد. در این بخش، پیاده سازی س ینماتیک معکوس به روش هندس ی ارائه شده است. این روش یکی از ساده ترین راه ها برای پیاده سازی س ینماتیک معکوس ربات اسکارا می باشد که میتوان از قانون کسینوس ها استفاده نمود.

شکل -5 -8 پیاده سازی سینماتیک معکوس ربات اسکارا

قانون کسینوس ها برای به دست آوردن سه زاویه مثلث در صورت داشتن سه ضلع کاربرد دارد. در واقع قانون کسینوس ها بیان م ی کند، مربع اندازه هر ضلع برابر است با مجموع مربعات دو ضلع دیگر منهای دو برابر حاصل ضرب آن دو ضلع در کسینوس زاویه بین آنها.

c

2 = a

2 + b

2 − 2ab × cos(θ)

همانطور که از رابطه باال نیز معلوم است، با داشتن دو ضلع و زاویه بینشان، می توان ضلع مقابل زاویه مذکور را بدست آورد. اما برخالف این رابطه ما نیازه داریم که زاویه ب ین اضالع یا مفاصل ربات را محاسبه نماییم بد ین صورت ابتدا قانون کسینوس ها را برا ی شکل 8-5 م ی نویسیم.

x

2 + y

2 = l1

2 + l2

2 − 2l1l2 cos(180 − θ2
)

فصل پنجم: سینماتیک و پروفایلهای حرکتی ربات اسکارا

99

2)cos − قرار می دهیم و بصورت زیر

2 − 180)cos را برابر با (

حال برای ساده سازی معادله باال، ( بازنویسی می کنیم.

x

2 + y

2 = l1

2 + l2

2 + 2l1l2 cos(θ2
)

2)cos بازنویسی می کنیم.

از آنجایی که ما به زاویه 2 نیازمندیم پس معادله فوق را برحسب (

cos(θ2

) =

x

2 + y

2 − l1

2 − l2

2
2l1l2

حال برای بدست آوردن زاویه 2 ، تنها کاف یست کسینوس معکوس معادله فوق را محاسبه نماییم.

θ2 = cos⁻¹ (
x

2 + y

2 − l1

2 − l2

2
2l1l2

)

تا اینجای کار ما زاویه 2 را از طریق قانون کسینوس ها پیدا کردیم حال با بررس ی مجدد شکل 8-5 میتوان رابطه زیر را حاصل کرد.
sin(β)
l2

=

sin(γ)
√x
2 + y

2

حال برای بدست آوردن زاویه ، نیاز داریم که معادله فوق را بر حسب ()sin باز نویسی کنیم و س یسنوس

sin(180 − θ2

معکوس معادله حاصله را نیز بدست آوریم. از طرفی اگر دقت کنید، ()sin برابر است با ( 2)sin پس با جایگذاری آن، معادله زیر بر حسب زاویه حاصل خواهد شد.

و همچنین برابر است با (

β = sin⁻¹ (
l2 sin θ2
√x
2 + y

2

)

زاویه را نیز میتوان از تانژانت معکوس ضلع مقابل به ضلع مجاور در شکل 8-5 بدست آورد.

α = tan⁻¹

(

y
x

)

درنهایت زاویه 1 با حاصل جمع زوایای و بدست می آید و معادله زیر حاصل می شود.

θ1 = sin⁻¹ (
l2 sin θ2
√x
2 + y

2

) + tan⁻¹
(

y
x

)

اگر به معادله فوق توجه کنید، مشاهده می کنید که مقدار زاویه 1 به مقدار زاویه 2 وابسته است بنابراین با تغییر عالمت زاویه 2 ، دو مقدار متفاوت برای زاویه 1 حاصل می شود.

فصل پنجم: سینماتیک و پروفایلهای حرکتی ربات اسکارا

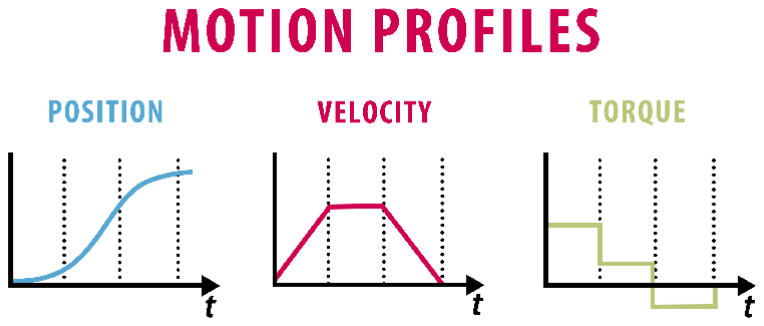
[picture p99: figure]

100

.2-5 معرفی و بررس ی پروفایل های حرکتی پروفایلبندی حرکت، تکن یکی است که به ما امکان می دهد تا پارامترها ی حرکت ربات را به دقت تنظیم کنیم و بد ین ترتیب، حرکات آنرا بهینه و کارآمد کنترل کنیم. این روش موجب می شود تا از مشکالت ی مانند لغزش و حرکات ناهموار که می تواند به ربات آس یب برساند، جلوگیری شود و حرکت مکانیزم های ربات نیز بصورت نرم تر و یکنواختتر انجام گیرد. در نتیجه، عملکرد کلی س یستم بهبود یافته و ربات با کارایی بیشتری به وظایف خود می پردازد.

شکل -5 -9 معرفی و بررسی پروفایل های حرکتی

یک پروفایل حرکتی اطالعات حرکت فیزیکی را ارائه م ی دهد و به صورت گرافیکی نشان می دهد که موتور باید در حین حرکت از نظر موقعیت، سرعت و شتاب چگونه رفتار کند یا به زبان ساده یک پروفایل حرکتی، نحوه رفتار موتور را از نظر موقع یت، سرعت و شتاب در طول حرکت تعریف می کند . اگرچه پروفایلهای حرکتی بسیاری وجود دارد که می توانند یک حرکت فیزیکی خاص را تحقق بخشند، اما دو نوع رایج ترین پروفایل حرکت، مثلثی و ذوزنقه ای هستند. این نامها به دلیل شکلی که وقتی سرعت به عنوان تابعی از زمان ترس یم و نمایش داده می شود، انتخاب شدهاند.

.1-2-5 پروفایل حرکت مثلث ی اصل اساس ی پروفایل حرکت مثلثی این است که با حداکثر سرعت شتاب بگ یریم و سپس بالفاصله کاهش سرعت دهیم، با این تفاوت که شتاب و کاهش سرعت از نظر زمان و مسافت برابر هستند. به عبارتی، زمان حرکت به دو قسمت مساوی تقسیم می شود. در نیمه اول، موتور شتاب می گیرد تا به حداکثر سرعت برسد و در نیمه دوم، تا زمانیکه موتور توقف کند سرعت کاهش می یابد . این تقسیم زمانی به طراحان این امکان را می دهد تا به راحتی شتاب و سرعت حرکت را محاسبه کنند. این باعث م یشود که محاسبات سرعت و شتاب بر اساس هندسه یک مثلث ساده تر شوند .

فصل پنجم: سینماتیک و پروفایلهای حرکتی ربات اسکارا

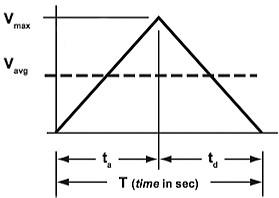
[picture p100: figure]
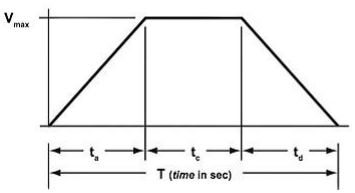
[picture p101: figure]

101

شکل -5 -10 پروفایل حرکت مثلثی

همانطورکه در شکل 10-5 مشاهده می کنید، ارتفاع مثلث نشان دهنده سرعت حداکثر است و شتاب
با تقسیم سرعت حداکثر بر زمان شتاب، که نصف زمان کل حرکت است، به دست می آید . پروفایل حرکت مثلثی به عنوان سریع ترین گزینه برای حرکت از یک موقعیت به موقعیت دیگر است، این ویژگی باعث می شود پروفایل حرکت مثلث ی برا ی کاربردهایی که نیاز به حداقل زمان برای حرکت دارند مناسب باشد. همچنین این پروفایل بطور معمول برای کاربردهایی استفاده م ی شود که ن یاز به سرعت ثابت ندارند مانند حمل و نقل، جابجایی و جاگذاری زیرا سریع ترین حرکت بین دو موقعیت را فراهم می کنند .

.2-2-5 پروفایل حرکت ذوزنقه ای برخالف پروفایل حرکت مثلث ی، پروفایل حرکت ذوزنقه ای زمان مشخصی )یا فاصله( را برای حرکت
با سرعت ثابت اختصاص میدهد که باعث می شود محاسبات حرکت برای پروفایل حرکت ذوزنقه ای کمی پیچیدهتر از پروفایل حرکت مثلثی باشد . بهترین روش برای تحلیل یک پروفایل حرکت ذوزنقه ای، تقسیم آن به دو مثلث )برا ی دوره های شتاب و کاهش سرعت حرکت( و یک مستطیل )برای دوره سرعت ثابت( است.

شکل -5 -11 پروفایل حرکت ذوزنقهای

فصل پنجم: سینماتیک و پروفایلهای حرکتی ربات اسکارا

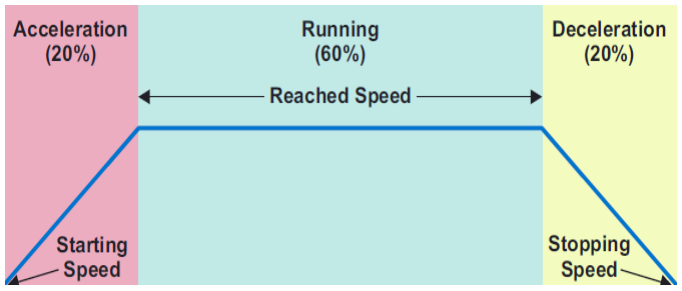
[picture p102: figure]

102

سادهترین روش برای ایجاد پروفایل حرکت ذوزنقه ای، همانند شکل 11-5 تقسیم کل زمان حرکت
به سه قسمت مساو ی است، بدین شکل در یک سوم اول، موتور شتاب می گیرد تا به حداکثر سرعت حرکت برسد و در یک سوم دوم، موتور با سرعت ثابت حرکت م یکند و در یک سوم آخر، تا زمانیکه موتور توقف کند سرعت کاهش می یابد . این تقسیم زمانی به طراحان این امکان را می دهد تا به راحت ی شتاب و سرعت حرکت را محاسبه کنند. اما معموالً پروفایل حرکت ذوزنقه ای از مدت زمان ب یشتری برای سرعت ثابت استفاده می کند و نرخ های شتاب و کاهش سرعت کمتری ن یز دارد. به همین دلیل، روش دیگری برای ایجاد پروفایل حرکت ذوزنقه ای وجود دارد که کل زمان حرکت را به درصدهایی از هر منطقه خاص پروفایل حرکت ذوزنقه ای تقسیم می کند. بد ین شکل می توان 20 درصد از کل زمان را برای شتابگیری موتور، 60 درصد را برای حرکت موتور با سرعت ثابت و 20 درصد باق یمانده را برا ی کاهش سرعت موتور انتخاب کرد.

شکل -5 -12 روش دوم برای ایجاد پروفایل حرکت ذوزنقهای

پروفایل حرکت ذوزنقه ای شا ید متداول ترین نوع پروفایل در کاربردهای کنترل حرکت باشد، زیرا برای کاربردهایی که از یک دوره سرعت ثابت بهره مند م ی شوند، یک پروفایل حرکت ذوزنقه ای مزیت داشتن حداکثر سرعت کمتر نسبت به پروفایل حرکت مثلثی را ارائه می دهد . این ویژگی می تواند به کاهش فشار و سایش رو ی س یستم کمک کند و برای کاربردهایی مانند ماش ین کاری، توزیع، چاپ و رنگآمیزی که نیاز به حفظ سرعت ثابت برا ی مدت زمان مشخص دارند، بسیار مفید باشد.

.3-2-5 پروفایل حرکت Curve-S در واقعیت، هیچ کدام یک از پروفایلهای حرکتی که به توضیح آنها پرداختیم برای س یستم های حرکتی به ویژه س یستم هایی که به حرکت صاف، دقت باال ی موقعیت یابی یا پایداری در پایان حرکت نیاز دارند، مناسب نیستند . این به این دلیل است که فرآیند شتابگیری و کاهش سرعت منجر به پدیده ای به 1 نام جهش
می شود.

1
Jerk

فصل پنجم: سینماتیک و پروفایلهای حرکتی ربات اسکارا

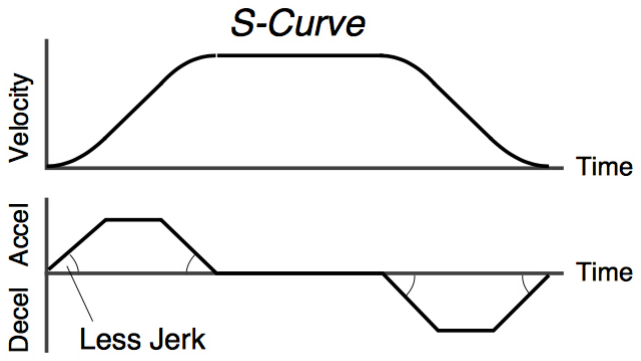
[picture p103: figure]

103

همانطورکه سرعت مشتق جابجایی است و شتاب مشتق سرعت، جهش نیز مشتق شتاب است. به عبارتی جهش، نرخ افزایش یا کاهش شتاب است. جهش بطور کلی نامطلوب است زیرا باعث ایجاد حرکات ناگهانی و ناپایدار می شود. در کاربردهای صنعتی مانند ماش ین ابزار، ربات اسکارا و س یستمهای پخش کننده، تغییر سریع در شتاب )یعنی جهش( باعث لرزش س یستم می شود. هرچه جهش بیشتر باشد، لرزش ن یز
1 | بیشتر است و این لرزش ها، دقت موقعیت یابی را کاهش و زمان نشست
را افزایش م ی دهند .

شکل -5 -13 پروفایل حرکت ذوزنقهای با حداکثر نرخ جهش

برای اجتناب از جهش، باید نرخ افزایش یا کاهش شتاب را کاهش دهیم. در س یستم های کنترل حرکت، اینکار با استفاده از پروفایل حرکت curve-S بجای پروفایل حرکت ذوزنقه ای انجام م ی شود. همانطور که در شکل 13-5 مشاهده م ی کنید در یک پروفایل حرکت ذوزنقه ای، شتاب گیری بالفاصله اتفاق می افتد و نرخ جهش حداکثر است. برای کاهش میزان جهشی که در حین حرکت ایجاد می شود، تغییرات سرعت در ابتدا و انتهای شتابگیری به شکل S هموار می شوند . بد ین صورت پروفایل حاصله به عنوان پروفایل حرکت curve-S شناخته می شود.

شکل -5 -14 پروفایل حرکت curve-S با حداقل نرخ جهش

1 Settling time

فصل پنجم: سینماتیک و پروفایلهای حرکتی ربات اسکارا

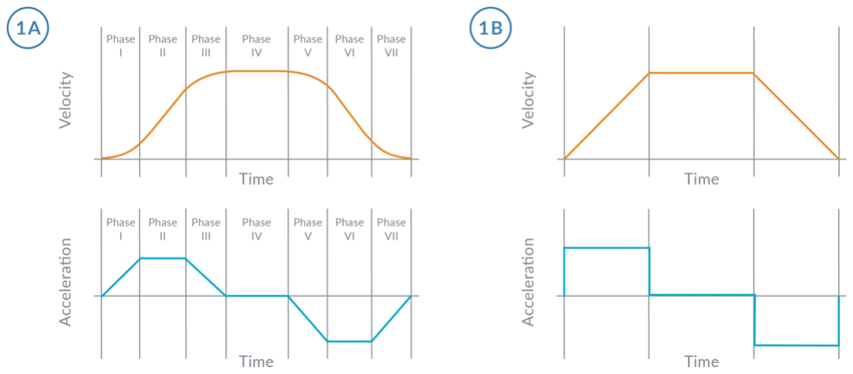
[picture p104: figure]

104

.4-2-5 مقایسه پروفا یل حرکت Curve-S و ذوزنقه ای پروفایل حرکت curve-S بر اساس یک س یستم مرتبه سوم ایجاد می شود که باعث پیچیده تر شدن معادالت حرکت برای شتاب، سرعت و مسافت )جابجایی( نسبت به پروفیل حرکت ذوزنقه ای می شود. استفاده از پروفایل حرکت curve-S در مقایسه با پروفایل حرکت ذوزنقه ای باعث طوالن یتر شدن زمان کلی حرکت م ی شود. دلیل این امر آن است که زمان شتاب گیری و کاهش سرعت در پروفیل حرکت curve-S بیشتر از شتابگیری لحظه ای در پروفایل حرکت ذوزنقه ای طول می کشد . با این حال، مزیت زمانی که با استفاده از پروفایل حرکت ذوزنقه ای به دست م ی آید، ممکن است به دل یل طوالنی تر شدن زمان نشست به علت لرزش های ناش ی از سطوح باالی جهش خنث ی شود و به دلیل اینکه جهش فشار زیادی به اجزا ی مکانیکی وارد می کند، حتی اگر از پروفایل حرکت ذوزنقه ای استفاده شود، معموالً مقداری صافسازی در مراحل شتابگیری و کاهش سرعت اعمال میشود، که باعث می شود پروفایل حرکت به شکل S باشد.

شکل -5 -15 مقایسه پروفایل حرکت Curve-S و ذوزنقهای

همانطورکه در شکل -5 15 بخش A1 مشاهده می نمایید، یک پروفایل حرکت curve-S شامل 7 مرحله متمایز از حرکت است. از طرفی، یک پروفایل حرکت ذوزنقه ای دارا ی 3 مرحله است که فقط دارای مراحل مربوط به شماره 2 )شتاب ثابت(، شماره 4 )سرعت ثابت( و شماره 6 )کاهش سرعت ثابت( از پروفایل curve-S است. در یک پروفایل حرکت ذوزنقه ا ی، نرخ جهش )تغییر شتاب( حداکثر است، در حالیکه در یک پروفایل حرکت curve-S، جهش یک مقدار ثابت است و تغییرات شتاب را در طول یک دوره زمانی پخش می کند . اما از آنجایی که پروفایل حرکت ذوزنقه ای زمان خود را صرف شتاب کامل یا کاهش سرعت کامل می کند، از دیدگاه اجرای پروفایل حرکت، سر یع تر از پروفایل حرکت curve-S عمل می کند.

فصل پنجم: سینماتیک و پروفایلهای حرکتی ربات اسکارا

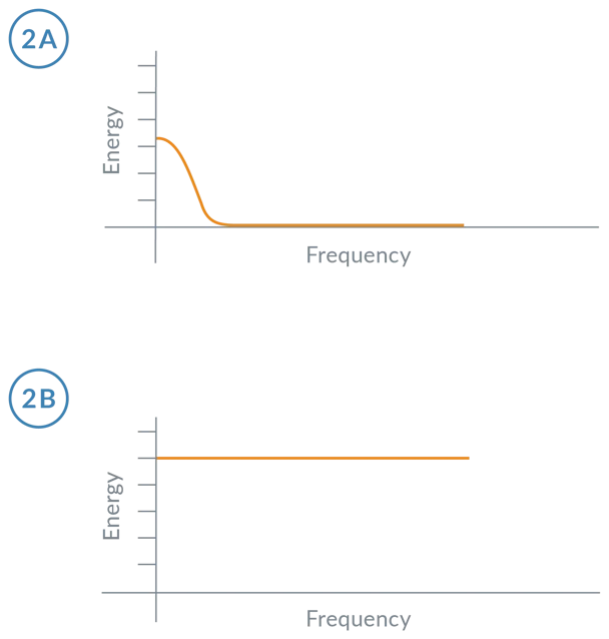
[picture p105: figure]

105

اینکه یک پروفایل حرکت curve-S نسبت به یک پروفایل حرکت ذوزنقه ای نرم تر است، از منحنی
های باال مشخص است. اما چرا پروفایل حرکت curve-S باعث کاهش نوسانات بار م ی شود؟ پاسخ به این سوال به این واقعیت برم ی گردد که برای یک بار معین، هرچه جهش بیشتر باشد، مقدار انرژی ار تعاشی ناخواسته بیشتری تولید می شود و طیف فرکانسی گسترده تری از انرژ ی ارتعاش ی ایجاد م ی شود. این بدان معناست که هرچه تغییر شتاب سریع تر باشد، ارتعاشات قو یتر خواهند بود و از آنجاییکه انرژ ی ارتعاش ی در مکانیک س یستم جذب م ی شود، ممکن است باعث افزایش زمان نشست یا کاهش دقت شود.

شکل -5 -16 ارتعاشات القایی برای پروفایل حرکت (A2 (curve-S و پروفا یل حرکت ذوزنقهای )B2)

همانطورکه در شکل -5 16 مشاهده می کن ید، پروفایل حرکت curve-S به دلیل داشتن جهش یکنواخت و تغییرات نرم تر در شتاب، ارتعاشات کمتری القا می کند در حالی که پروفایل حرکت ذوزنقه ای به دلیل تغییرات آنی بین مراحل شتاب و کاهش سرعت، ارتعاشات بیشتری ایجاد می کند . این تفاوت د ر ارتعاشات القایی به ما کمک می کند تا بفهمیم چرا پروفایل حرکت curve-S برای کاربردهایی که نیاز به حرکات نرم تر و کاهش ارتعاشات دارند، مناسب تر است. انتخاب پروفایل حرکت مناسب، بستگ ی به نیازها و مشخصات عملکردی س یستم شما دارد.

فصل پنجم: سینماتیک و پروفایلهای حرکتی ربات اسکارا

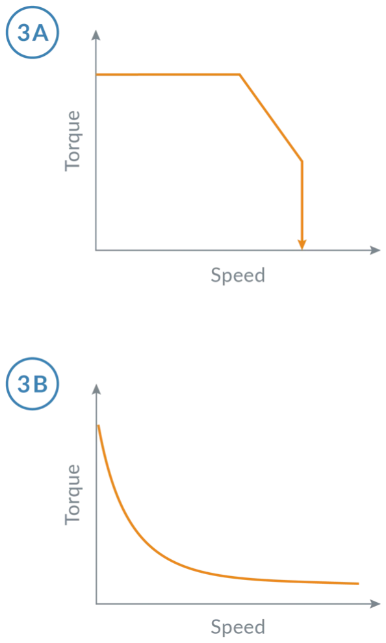
[picture p106: figure]

106

.5-2-5 چالش های پروفایل های حرکتی هدف نهایی هر پروفایل حرکتی، تطبیق ویژگی های س یستم حرکت با کاربرد مورد نظر است. پروفایل
حرکت curve-S و ذوزنقه ای زمانیکه منحن ی گشتاور دور س یستم حرکت به طور نسبی ثابت است، به خوبی کار م ی کنند به عبارتی، گشتاور خروجی در طول محدوده سرعتهایی که س یستم تجربه خواهد کرد، تغییر زیادی نم ی کند . این برای اکثر سروو موتورها صادق است. اما استپر موتورها منحنی گشتاور دور ثابتی ندارند
1 کاهش | و خروجی گشتاور آنها غیرخطی است و گاهی اوقات در مکانی به نام ناپایداری میانی
زیادی دارند
و بطور کلی در سرعتهای باالتر نیز کاهش م ی یابد .

شکل -5 -17 منحنی گشتاور دور سروو موتور )A3 )و استپرموتور )B3)

2 | ناپایداری میانی در فرکانس گام
زمانی رخ می دهد که فرکانس رزونانس طبیعی موتور با نرخ گام
فعلی مطابقت داشته باشد. در این حالت، ارتعاشات و نوسانات ناخواستهای در س یستم ایجاد می شود که منجر به کاهش دقت و عملکرد موتور می گردد. فرکانس گام به تعداد پله هایی اشاره دارد که یک استپرموتور در واحد زمان برمی دارد. به عبارتی، فرکانس گام نشان می دهد که استپرموتور با چه سرعتی م ی تواند بین موقعیت های مختلف جابجا شود. فرکانس گام معموالً بر حسب هرتز )Hz )اندازه گیری می شود.

1 Mid-range Instability
2 Step frequency

فصل پنجم: سینماتیک و پروفایلهای حرکتی ربات اسکارا

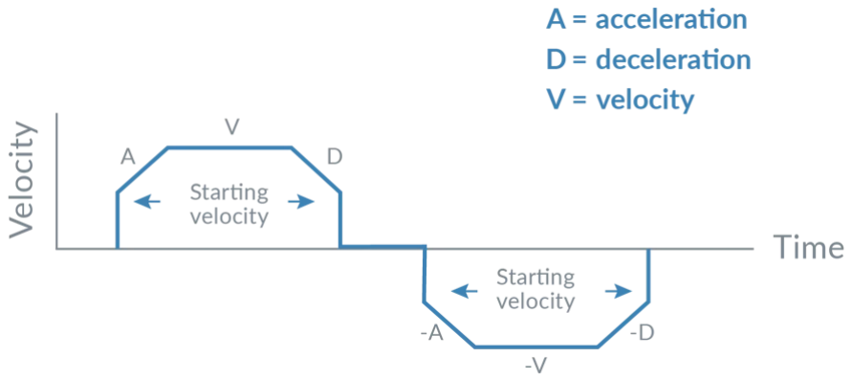
[picture p107: figure]
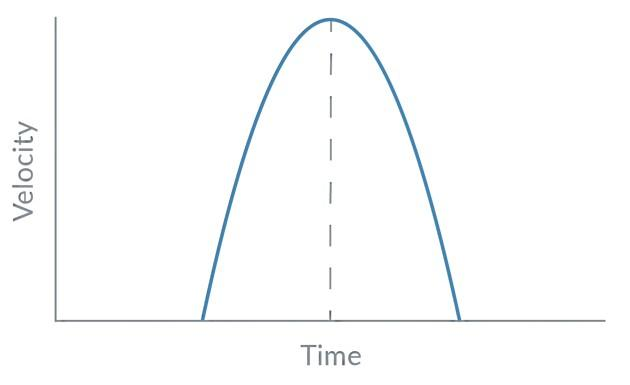
[picture p108: figure]

107

برای رفع ناپایداری میانی، تکنیکهای مختلفی وجود دارد. یکی از رایج ترین تکنیک ها استفاده از
سرعت اولیه غیرصفر است، که به معنی شروع به حرکت با سرعتی مشخص بجای شروع از حالت ایستاده است. اینکار میتواند به کاهش تأثیرات ناپایداری میانی کمک کند و باعث بهبود عملکرد س یستم شود. اگرچه این روش نسبتاً غیر استاندارد است، اما گاهی اوقات نتایج بهتری نسبت به ش یب صاف برای سرعت اولیه صفر ارائه می دهد .

شکل -5 -18 منحنی سرعت اولیه غ یرصفر

برای مقابله با کاهش گشتاور در سرعت های باالتر نیز می توان از پروفایل حرکت پارابولیک استفاده
کرد که در شکل 19-5 نشان داده شده است. این پروفایل حرکتی با استپر موتورها سازگاری خوب ی دارد، زیرا گشتاور در سرعت های باالتر کمتر است. اما توجه داشته باش ید که شتابگیری شروع و پایان بسیار باال است و هیچ یک از مراحل پروفایل حرکت curve-S که در آن شتاب بطور نرم به صفر انتقال یابد وجود ندارد. بنابراین، اگر نوسانات بار مشکل اصلی باشد، پروفایل حرکت پارابولیک ممکن است به خوبی پروفایل حرکت curve-S عمل نکند، علیرغم اینکه یک پروفایل حرکت curve-S نیز از دیدگاه منحنی گشتاور دور برای یک استپرموتور بهینه نشده است.

شکل -5 -19 پروفایل حرکت پارابول یک

فصل پنجم: سینماتیک و پروفایلهای حرکتی ربات اسکارا

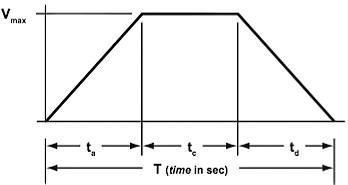
[picture p109: figure]

108

.6-2-5 پیاده سازی پروفایل حرکت ذوزنقه ای برا ی استپرموتور همانطورکه قبال گفتیم بهترین روش برای تحلیل یک پروفایل حرکت ذوزنقه ای، تقسیم آن به دو مثلث )برای دوره های شتاب و کاهش سرعت حرکت( و یک مستطیل )برای دوره سرعت ثابت( است. بد ین صورت ما با دانستن فرمول های مساحت مثلث و مستطیل می توانیم پارامترهای سرعت، شتاب و مسافت را محاسبه نماییم.

شکل -5 -20 پروفایل حرکت ذوزنقهای

برای شروع، ابتدا نیاز داریم پارامترهای کل ی پروفایل حرکت ذوزنقه ای را بدست آوریم. بد ین صورت طبق شکل 20-5 ، زمان کل بصورت زیر محاسبه می شود.

T = ta + tc + td

با توجه به اینکه زمان کل از جمع زمان های بخش شتاب، سرعت ثابت و کاهش سرعت حاصل م ی شود، میتوان نتیجه گرفت که مسافت کل ن یز به سه قسمت تقس یم می شود و بصورت زیر محاسبه می شود.

D = da + dc + dd

حال برای محاسبه مسافت سه بخش شتاب، سرعت ثابت و کاهش سرعت، باید همانطورکه گفتیم مساحت مثلث )برای دوره های شتاب و کاهش سرعت حرکت( و مساحت مستطیل )برای دوره سرعت ثابت( بدست آوریم. مساحت مثلث برابر است با قاعده ضربدر ارتفاع تقسیم بر دو و مساحت مستطیل نیز برابر است با طول ضرب در عرض.

شکل -5 -21 تقسیم پروفایل حرکت ذوزنقهای به دو مثلث و یک مستطیل

فصل پنجم: سینماتیک و پروفایلهای حرکتی ربات اسکارا

109

با محاسبه مساحت مثلث و مستطیل طبق شکل 21-5 ، مسافت هر بخش بصورت زیر بدست خواهد آمد.

da = dd =

1
2
× b × ℎ | , | dc = A × B

da =

1
2
× ta × Vmax | , | dc = tc × Vmax | , | dd =

1
2

× td × Vmax

مسافت کل ن یز بصورت زیر محاسبه می شود.

D = (

1
2

× ta × Vmax) + (tc × Vmax) + (

1
2

× td × Vmax)

خب حاال برای اینکه بتوانیم تشخیص دهیم کدام نقطه از پروفایل، نقطه انتهای شتاب گ یری می باشد، باید مسافت بخش شتاب را محاسبه نماییم.

da =

1
2

× ta × Vmax

همانطورکه در معادله فوق مشاهده می کنید، برای محاسبه مسافت بخش شتاب باید پارامتر t یا زمان شتاب گیری را بدانیم. همانطورکه می دانید به میزان تغییر سرعت در واحد زمان، شتاب گفته م ی شود، پس بد ین صورت می توانیم پارامتر t را از فرمول شتاب بدست می آوریم.

a =

∆v
ta

=

v2 − v1
ta

→ v2 = Vmax , v1 = 0 → a =

| | | Vmax
ta

→ ta =

Vmax
a

سپس با جایگذاری پارامتر t در معادله مسافت بخش شتاب، فرمول زیر حاصل می شود.

da =

1
2

× (

Vmax
a

) × Vmax =

| | (Vmax)
| | 2
2a

حال طبق فرمول فوق، م ی توانیم نقطه انتهای شتاب گیری را تعیین نماییم و از این نقطه به بعد وارد بخش سرعت ثابت خواهیم شد. همانند نقطه انتهای شتاب گیری، ما نیاز به نقطه شروع کاهش سرعت یا حرکت با شتاب منفی را نیز داریم که این نقطه بعد از به اتمام رس یدن بخش سرعت ثابت شروع می شود. برای اینکار باید مسافت کل را از مسافت بخش شتاب کم کنیم تا نقطه انتهای بخش سرعت ثابت یا نقطه شروع کاهش سرعت بدست آید .

dc = D − da

فصل پنجم: سینماتیک و پروفایلهای حرکتی ربات اسکارا

110

خب حاال با توجه به تعاریفی که انجام شد ما دو سناریو متفاوت خواهیم داشت، اولین سناریو این
| است که اگر

بزرگتر از d باشد بد ین معناست که پروفایل حرکت ذوزنقه ای ایجاد خواهد شد و بخش
d کوچکتر از d باشد
سرعت ثابت در این پروفایل وجود خواهد داشت. دومین سناریو این است که اگر بد ین معناست که پروفایل حرکت ذوزنقه ای ایجاد نخواهد شد و بخش سرعت ثابت نیز در این پروفایل وجود نخواهد داشت پس پروفایل حرکت ایجاد شده، پروفایل حرکت مثلثی خواهد بود و در این حالت باید محاسبات جد یدی بدست آید .

شکل -5 -22 پروفایل حرکت مثلثی

طبق شکل -5 22 ، زمان کل برابر است با حاصل جمع زمان بخش شتاب و زمان بخش کاهش سرعت. پس برای محاسبه زمان هر یک از بخش های شتاب و کاهش سرعت، فقط نیاز دار یم که کل زمان رو بر دو تقسیم کنیم.

T = ta + td → ta =

T
2

, td =

T
2

در پروفایل حرکت مثلثی بر خالف پروفایل حرکت ذوزنقه ای سرعت حداکثر برا ی ما مجهول است و نیاز داریم از طریق فرمول سرعت متوسط، سرعت حداکثر را محاسبه نماییم.

Vavg =

Vmax
2

→ Vmax = 2 × Vavg

سرعت متوسط نیز از حاصل تقسیم مسافت کل به زمان کل بدست می آید، پس برا ی محاسبه سرعت متوسط ابتدا نیاز داریم زمان کل را بدست آوریم. همچنین زمان کل نیز از فرمول شتاب محاسبه می شود.

a =

Vmax
ta

, ta =

T
2

→ a =

Vmax
T
2

=

2 × Vmax
T

→ T =

2 × Vmax
a

فصل پنجم: سینماتیک و پروفایلهای حرکتی ربات اسکارا

111

حال بصورت زیر، سرعت حداکثر را از طریق فرمول سرعت متوسط محاسبه م ی نماییم.

Vavg =

D
T

=

D

2 × Vmax
a

=

a × D

2 × Vmax

→ Vmax = 2 × Vavg =

a × D

Vmax

→ (Vmax)

2 = a × D

Vmax = √a × D

از طرفی نقاط انتهای شتاب گیری و ابتدای کاهش سرعت نیز با تقسیم مسافت کل بر دو مجددا محاسبه خواهد شد. این نقاط همان مسافت بخش شتاب و بخش کاهش سرعت پروفایل حرکت مثلثی می باشند.

da =

D
2

, dc =

D
2

خب تا اینجای کار ما مسافت بخش های شتاب، سرعت ثابت و کاهش سرعت یک پروفایل حرکت ذوزنقه ای را محاسبه کردیم اما اگر متوجه شده باش ید این پروفایل برای استپرموتور پیاده سازی شده بود پس مسافت های هر بخش برحسب تعداد گام ها یا پله ها ی استپرموتور محاسبه خواهد شد. حاال در ادامه وارد قسمت مهم کار می شویم، در اینجا ما نیاز داریم که سرعت را برای هر پله محاسبه نماییم بد ین صورت سرعت لحظه ای باید برای هر بخش شتاب، سرعت ثابت و کاهش سرعت بدست آید . سرعت لحظه ای یا سرعت هر پله برای بخش شتاب بصورت ز یر محاسبه می شود.

da =

(Vmax)

2
2a
| → (Vmax) 2 = da × 2a → Vmax = √da × 2a → Vaccel = √da × 2a

همچنین سرعت لحظه ای برا ی بخش سرعت ثابت نیز با سرعت حداکثر برابر است.

Vconst = Vmax

سرعت لحظه ای برای بخش کاهش سرعت نیز از طریق فرمول مسافت کل بصورت زیر بدست خواهد آمد.

D = da + dc + dd → dd = D − da − dc
(

1
2

× td × Vmax) = D − (

1
2

× ta × Vmax) − dc

با توجه به اینکه زمان های t و t را قبال محاسبه کرده بودیم، حال با جایگذاری آنها در معادله فوق فرمول زیر بدست می آید. اما قبل از آن باید توجه داشته باشید، زمان t که از فرمول شتاب محاسبه می شود برخالف زمان t دارای مقدار منفی است چون در بخش کاهش سرعت شتاب منفی خواهد بود.

a =

∆v
td

=

v2 − v1 td | → v2 = 0 , v1 = Vmax → a = −

Vmax
td

→ td = −

Vmax
a
(

1
2

× (−

Vmax
a

) × Vmax) = D − (

1
2

× (

Vmax
a

) × Vmax) − dc

فصل پنجم: سینماتیک و پروفایلهای حرکتی ربات اسکارا

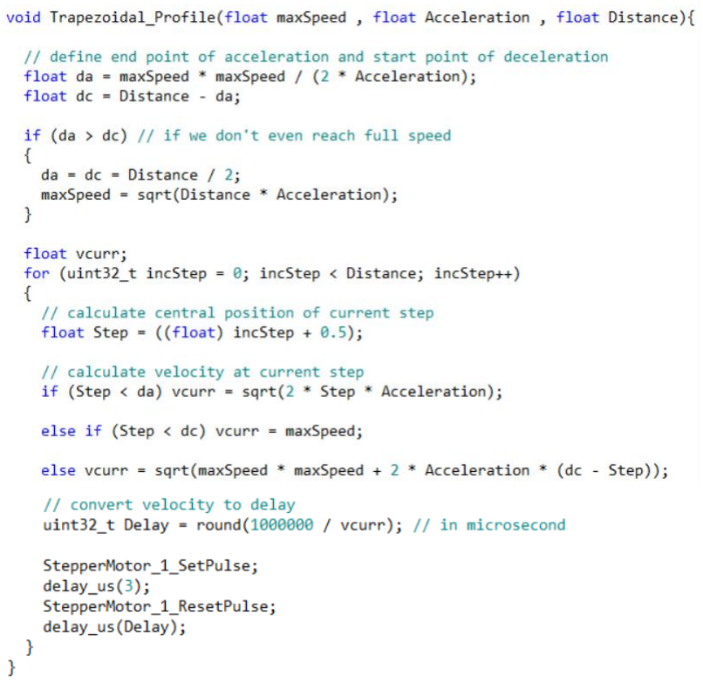
[picture p110: figure]

112

حال با کمی ساده سازی معادله فوق، سرعت لحظه ای برای بخش کاهش سرعت بصورت زیر محاسبه خواهد شد.

(Vmax)

2
2a

=

(Vmax)

2
2a

+ dc − D → (Vmax)

2 = (Vmax)

2 + 2a(dc − D)

Vdecel = √(Vmax)
2 + 2a(dc − D)

تا به االن تمام محاسبات پیاده سازی پروفایل حرکت ذوزنقه ای برای استپرموتور انجام شد حال نوبت
به آن می رسد که این فرمول ها را در یکی از محیط های برنامه نویسی میکروکنترلر پیاده کنیم. نمونه برنامه ایجاد شده توسط فرمول های فوق به شکل زیر خواهد بود.

در فصل آینده که به معرفی و بررسی کدهای کنترلر ربات اسکارا خواهیم پرداخت، خواهید دید که در کتابخانه Profile Motion از این تابع برای کنترل حرکت ربات اسکارا استفاده می کنیم.

## 6 فصل ششم: برنامه نویسی کنترلر ربات اسکارا

فصل ششم: برنامه نویسی کنترلر ربات اسکارا

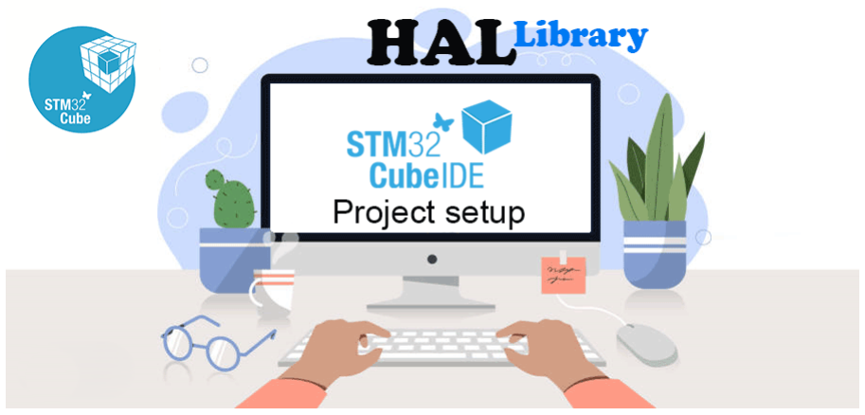
[picture p111: figure]

114

.1-6 پیکربندی میکروکنترلر 32STM در محیط IDE Cube برای شروع برنامه نویسی میکروکنترلر 32STM ، ابتدا باید این میکروکنترلر پیکربندی شود و برای پیکربندی میکروکنترلر ما به نرم افزار MX Cube نیاز خواهیم داشت. البته همانطور که در فصل قبل در مورد آن بحث شد ، شرکت ST ، نرم افزاری تحت عنوان IDE Cube بصورت رایگان در اختیار کاربران قرار داد که میتوان هم به عنوان یک محیط برنامه نویسی و هم به عنوان یک محیط گرافیکی برای پیکربندی میکروکنترلر استفاده نمود.

شکل -6 -1 پیکربندی میکروکنترلر 32STM در محیط IDE Cube

برای شروع پیکربندی میکروکنترلر 32STM ، ابتدا باید آخرین نسخه این نرم افزار را از سایت ST دانلود نمایید که البته بدلیل مشکالت فیلترینگ این سایت برای کاربران ایرانی، پیشنهاد می شود که از سایت های معتبر ایرانی همچون 98Soft و سیسوگ برای دانلود آخرین نسخه این نرم افزار استفاده نمایید. پس از نصب نرم افزار IDE Cube ، اولین کاری که باید انجام دهید این است که فریمورک یا همان پکیج نرم افزاری میکروکنترلری که می خواهید با آن کار کنید را دانلود نمایید . در اینجا چون ما از میکروکنترلر 6T8C103F32STM استفاده می کنیم، پس نیاز است که فریمورک مربوط به سر ی 1F32STM را دانلود نماییم. دقت کنید که برا ی هر سری از میکروکنترلرهای شرکت ST یک فر یمورک وجود دارد که آن فریمورک قابل استفاده برای تمامی میکروکنترلرهای موجود در آن سری است. برای دانلود فریمورک می توانید از داخل خود نرم افزار نیز اقدام نمایید اما مجددا به دلیل مشکل فیلترنیگ، پیشنهاد می شود از سایت سیسوگ آخرین نسخه پکیج نرم افزاری میکروکنترلر مربوطه را دانلود نمایید. برای نصب این پکیج نیز می توانید طبق مراحل زیر اینکار را انجام دهید.

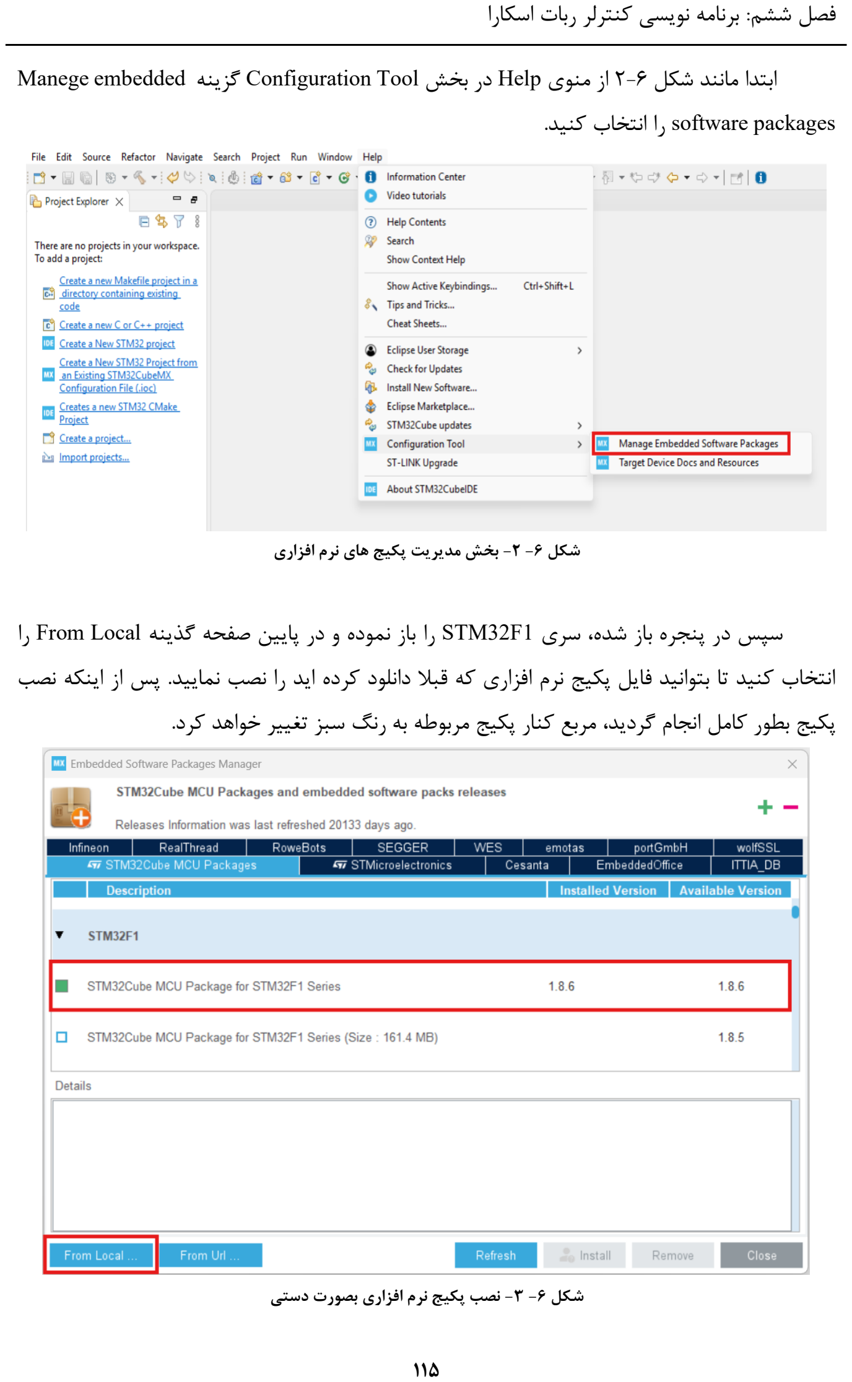
[picture p112: page 123]

فصل ششم: برنامه نویسی کنترلر ربات اسکارا

115

ابتدا مانند شکل 2-6 از منو ی Help در بخش Tool Configuration گزینه embedded Manege

packages software را انتخاب کنید .

شکل -6 -2 بخش مدیریت پکیج های نرم افزاری

سپس در پنجره باز شده، سر ی 1F32STM را باز نموده و در پایین صفحه گذینه Local From را انتخاب کنید تا بتوانید فایل پکیج نرم افزاری که قبال دانلود کرده اید را نصب نمایید . پس از اینکه نصب پکیج بطور کامل انجام گردید، مربع کنار پکیج مربوطه به رنگ سبز تغییر خواهد کرد.

شکل -6 -3 نصب پکیج نرم افزاری بصورت دستی

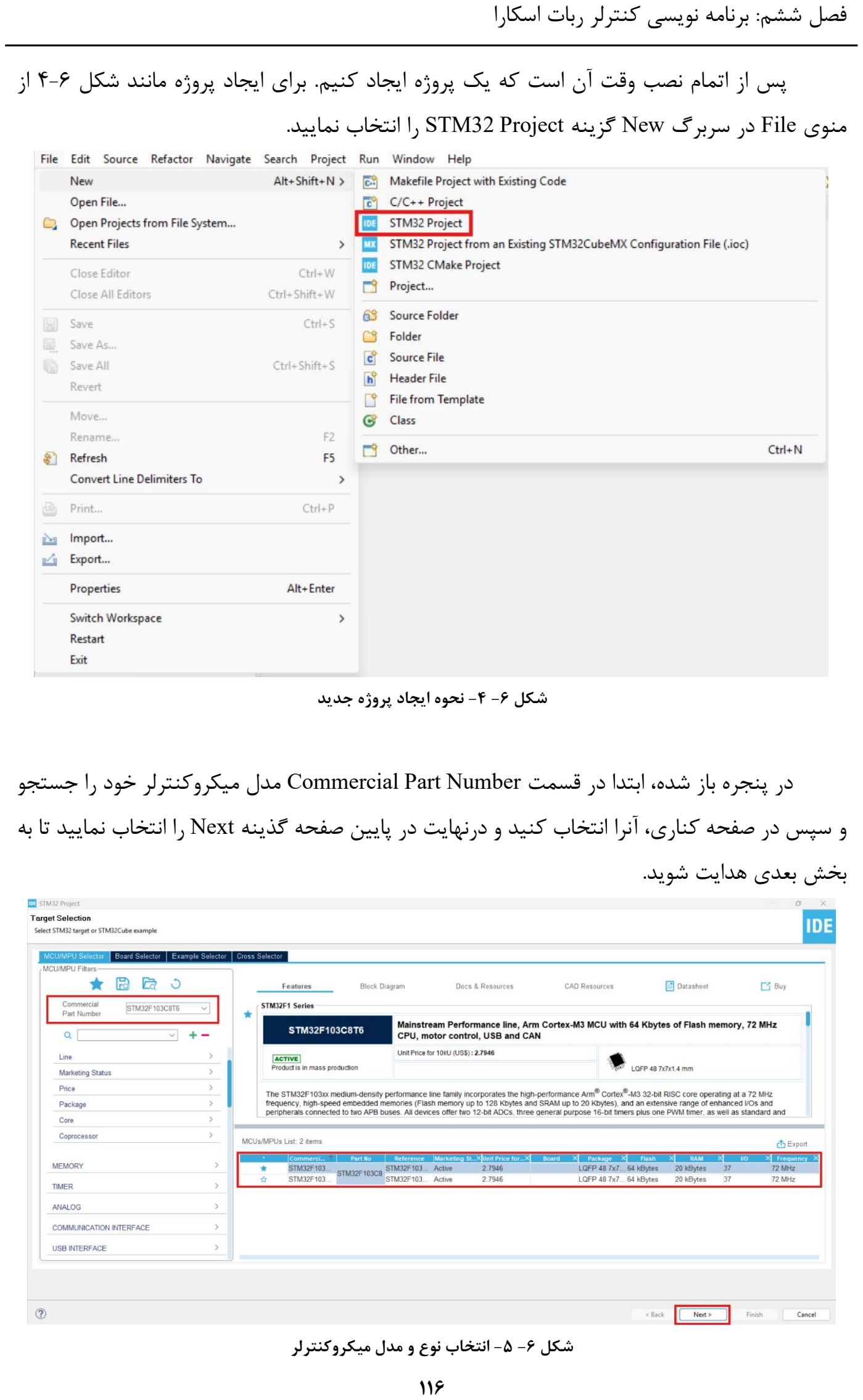
[picture p113: page 124]

فصل ششم: برنامه نویسی کنترلر ربات اسکارا

116

پس از اتمام نصب وقت آن است که یک پروژه ایجاد کن یم. برا ی ایجاد پروژه مانند شکل -6 4 از منوی File در سربرگ New گزینه Project 32STM را انتخاب نمایید .

شکل -6 -4 نحوه ایجاد پروژه جدید

در پنجره باز شده، ابتدا در قسمت Number Part Commercial مدل میکروکنترلر خود را جستجو
و سپس در صفحه کناری، آنرا انتخاب کنید و درنهایت در پایین صفحه گذینه Next را انتخاب نمایید تا به بخش بعدی هدایت شوید.

شکل -6 -5 انتخاب نوع و مدل میکروکنترلر

فصل ششم: برنامه نویسی کنترلر ربات اسکارا

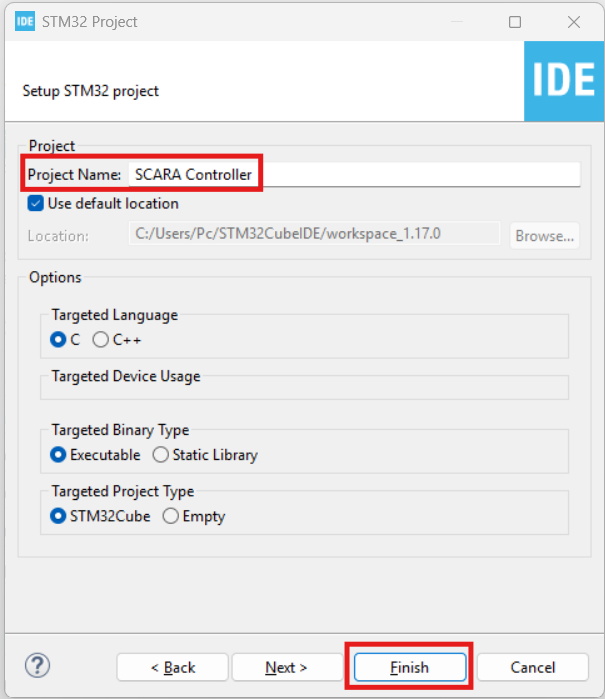
[picture p114: figure]
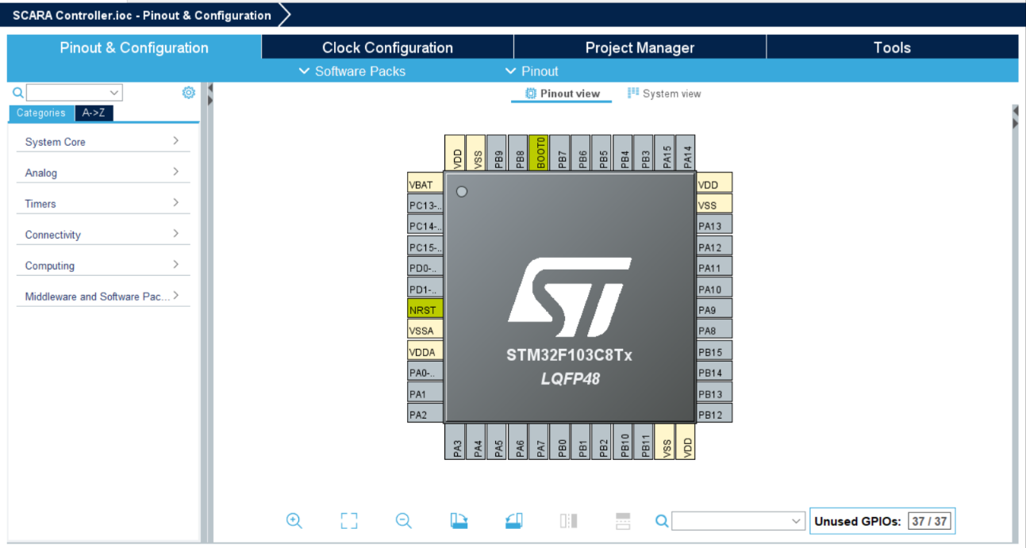
[picture p115: figure]

117

در بخش بعدی، نیاز به تغییرات خاصی نیست و فقط با انتخاب نام پروژه و انتخاب گذینه Finish پروژه شما ساخته خواهد شد و وارد محیط پیکربندی میکروکنترلر 32STM می شود.

شکل -6 -6 تعیین نام برای ایجاد پروژه

شکل -6 -7 محیط پیکربندی میکروکنترلر

همانطور که در شکل 7-6 مشاهده می کنید این محیط شامل بخش های مختلفی است که در ادامه
به توضیح هر کدام از بخش های مهم و مورد نیاز برای ساخت پروژه کنترلر ربات اسکارا پرداخته خواهد شد، البته پیشنهاد می شود که ابتدا از منابع تصویری و ویدیویی موجود در اینترنت برای آموزش کامل این محیط استفاده نمایید سپس در ادامه با ما همراه باشید.

فصل ششم: برنامه نویسی کنترلر ربات اسکارا

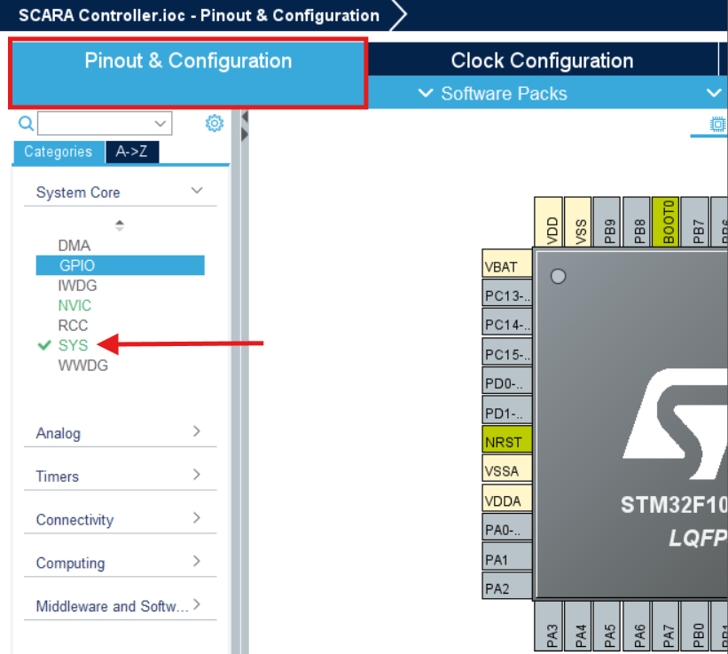
[picture p116: figure]

118

برای شروع ابتدا در سربرگ Configuration & Pinout وارد بخش SYS شوید، این بخش مربوط به تنظیم نوع یا روش پروگرام کردن میکروکنترلر می باشد.

شکل -6 -8 انتخاب روش پروگرام کردن میکروکنترلر

معموال میکروکنترلرهای ST را به دو روش JTAG و SWD پروگرام می کنند . در روش SWD نیاز
به پروگرامر Link-ST و در روش JTAG نیاز به پروگرامر Link-J داریم، توضیحات بیشتر در فصل قبل داده شده است. همانطور که در شکل 9-6 مشاهده می کنید ، باید گزینه Debug را بر روی Wire Serial تنظیم کنید تا بتوانیم از روش SWD برای پروگرام کردن میکروکنترلر استفاده نماییم.

شکل -6 -9 تنظیم روش SWD یا Wire Serial

فصل ششم: برنامه نویسی کنترلر ربات اسکارا

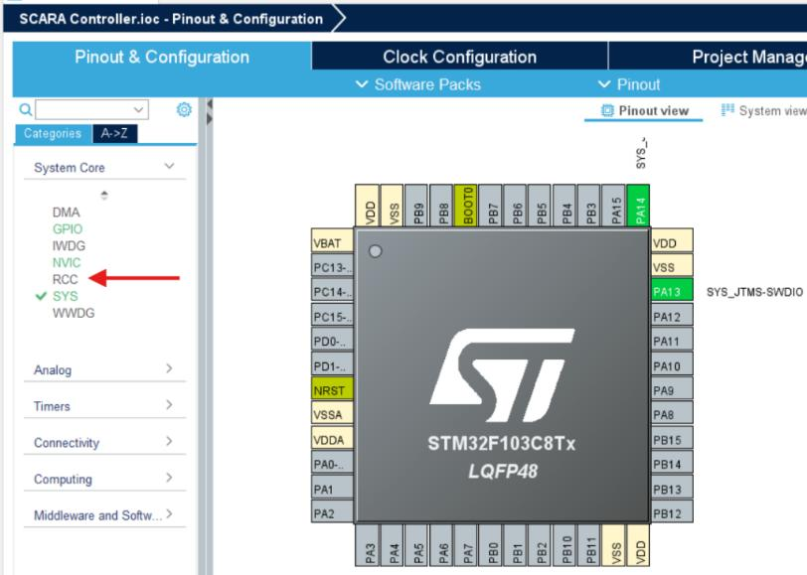
[picture p117: figure]
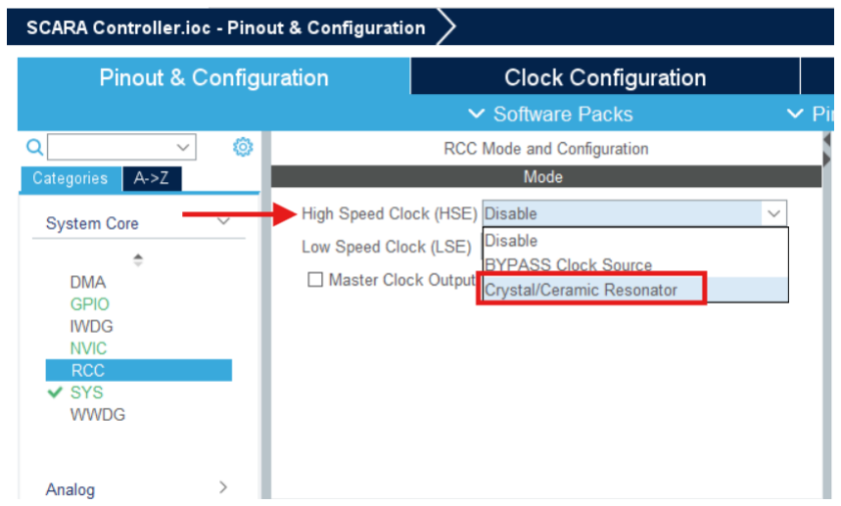
[picture p118: figure]

119

پس از تنظیم نوع پروگرامر به سراغ تنظیمات کالک میکروکنترلر رفته و در بخش Core System گذینه RCC یا همان Control Clock and Reset را انتخاب می کنیم.

شکل -6 -10 تنظیمات کالک میکروکنترلر

در صورت ی که بخواهیم از کریستال خارجی استفاده کنیم تنظیمات زیر را انجام می دهیم. البته
توجه داشته باش ید که در حالت عادی تنظیمات کالک میکروکنترلر روی گزینه HSI یا همان کالک سریع داخلی با فرکانس 8 مگاهرتز می باشد و حداکثر می تواند تا فرکانس 64 مگاهرتز تنظیم شود، به همین دلیل برای افزایش آن به فرکانس 72 مگاهرتز باید از کریستال خارجی 8 مگاهرتز که بر روی برد توسعه 32STM تعبیه شده است استفاده نمایید. بدین منظور بعد از وارد شدن به بخش RCC ، گز ینه High
. | نمایید | تنظیم | Crystal/Ceramic Resonator | روی بر را Speed Clock (HSE)

شکل -6 -11 انتخاب کریستال خارجی به عنوان کالک میکروکنترلر

فصل ششم: برنامه نویسی کنترلر ربات اسکارا

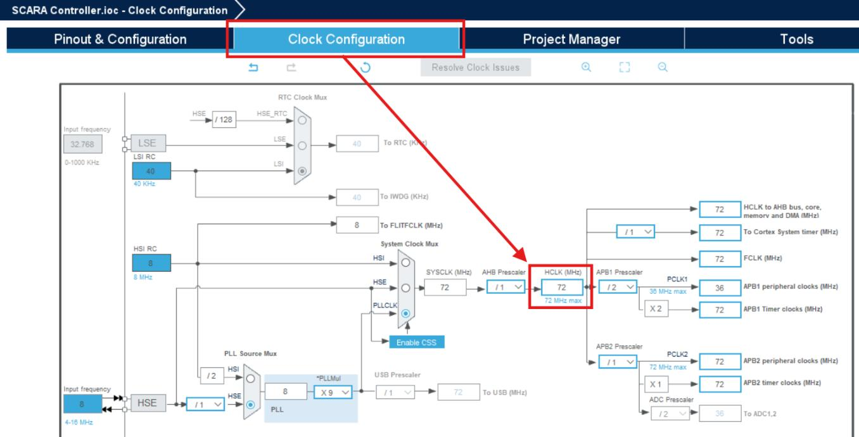
[picture p119: figure]
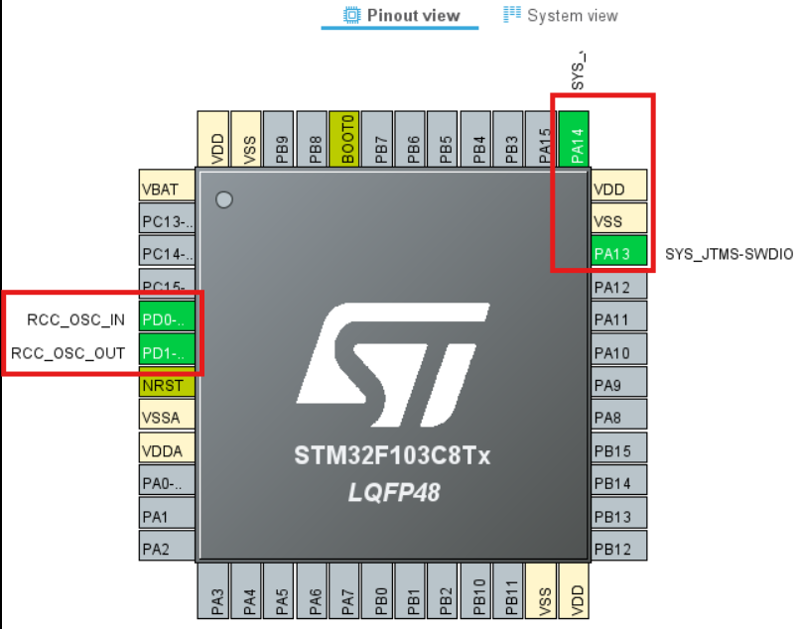
[picture p120: figure]

120

پس از اینکه تنظیمات فوق را انجام دادید وارد بخش Configuration Clock شوید و در کادر HCLK حداکثر فرکانس میکروکنترلر را بر روی 72 مگاهرتز قرار دهید.

شکل -6 -12 تنظیم حداکثر فرکانس میکروکنترلر

درنهایت می توانید نتیجه تنظیمات انجام شده را در بخش view Pinout بر روی میکروکنترلر خود مشاهده نمایید. همانطور که در شکل 13-6 مشخص است، پایه های 13PA و 14PA برای اتصال پروگرامر و پایه های 0PD و 1PD برای اتصال کریستال خارجی در نظر گرفته شده اند.

شکل -6 -13 پایه های میکروکنترلر پس از اعمال تنظیمات

فصل ششم: برنامه نویسی کنترلر ربات اسکارا

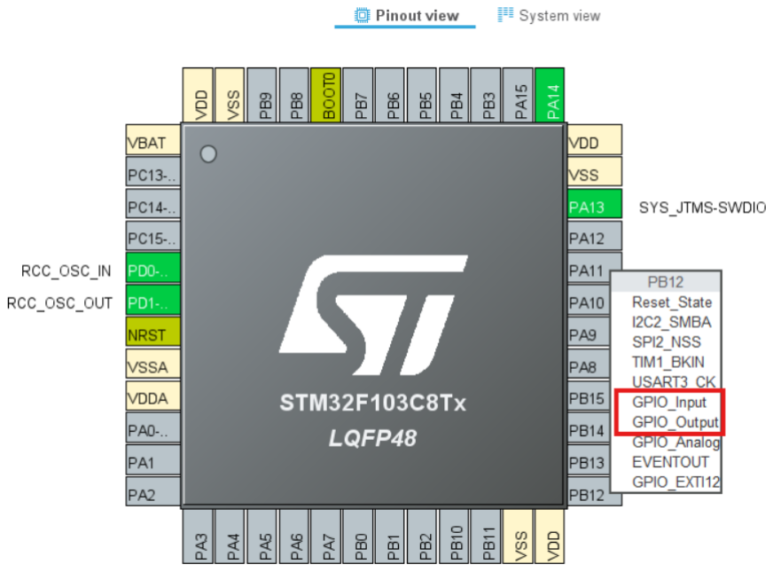
[picture p121: figure]
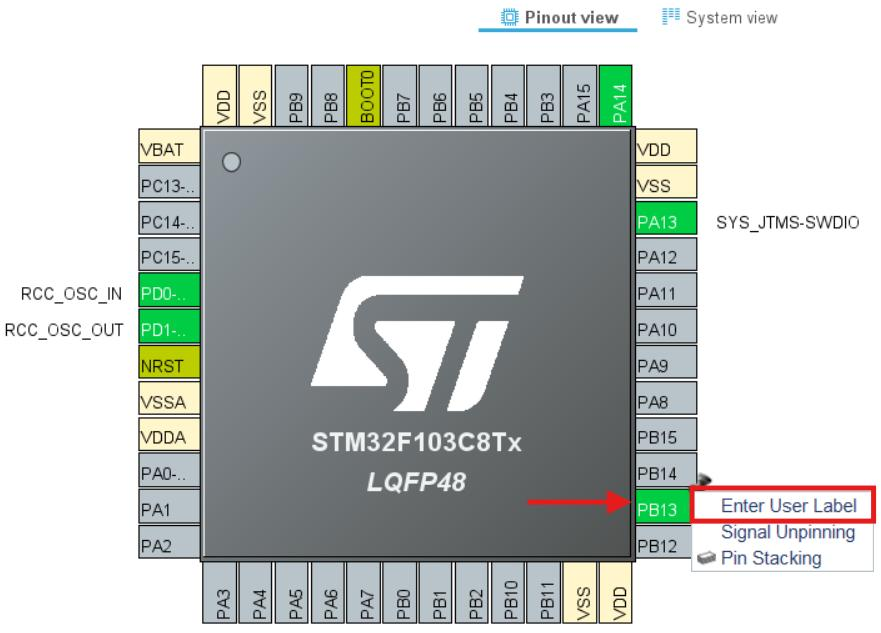
[picture p122: figure]

121

با توجه به مدل میکروکنترلری که انتخاب می کنید ، تعداد مشخص ی GPIO در اختیار شما است که
می توانید این GPIO ها را به صورت ورودی و یا خروجی تعریف کنید . برای تعریف GPIO بصورت ورودی و یا خروج ی بایستی بر روی یکی از پایه های میکروکنترلر کل یک کنید تا گزینه های قابل تنظیم GPIO را مشاهده نمایید . سپس با کلیک بر روی Output_GPIO پایه مورد نظر خروجی و با انتخاب Input_GPIO پایه بصورت ورود ی تعریف م یشود.

شکل -6 -14 تنظیم پایه مورد نظر به عنوان ورودی یا خروجی

بهتر است برای هر پایه ای که استفاده می کنید یک نام یا لیبل انتخاب کنید تا در بخش کدنویسی راحتتر بتوان از پایه ها استفاده نمود. برای انتخاب نام بایستی بر رو ی پایه ای که استفاده نموده اید راست کلیک و گزینه Label User Enter را انتخاب کنید و سپس نام مورد نظر را وارد نمایید و Enter بزنید .

شکل -6 -15 انتخاب نام حذبرای پایه انتخاب شده

فصل ششم: برنامه نویسی کنترلر ربات اسکارا

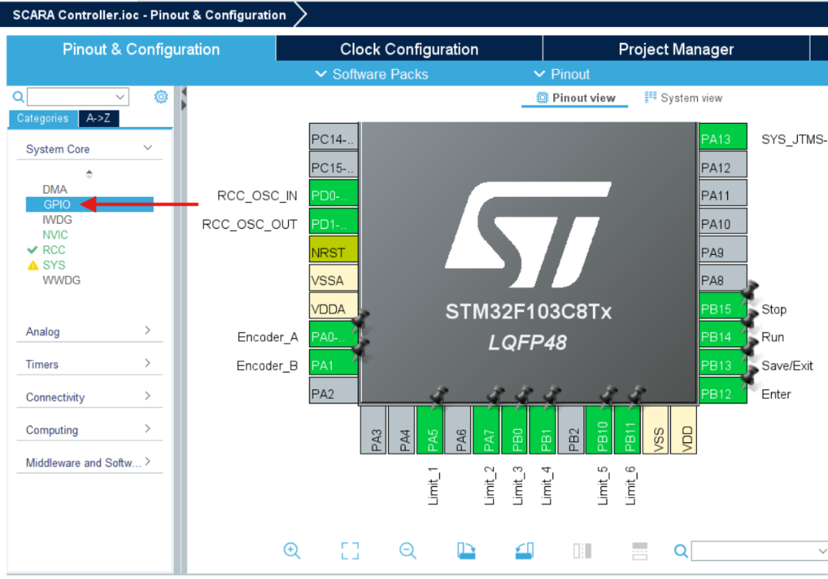
[picture p123: figure]
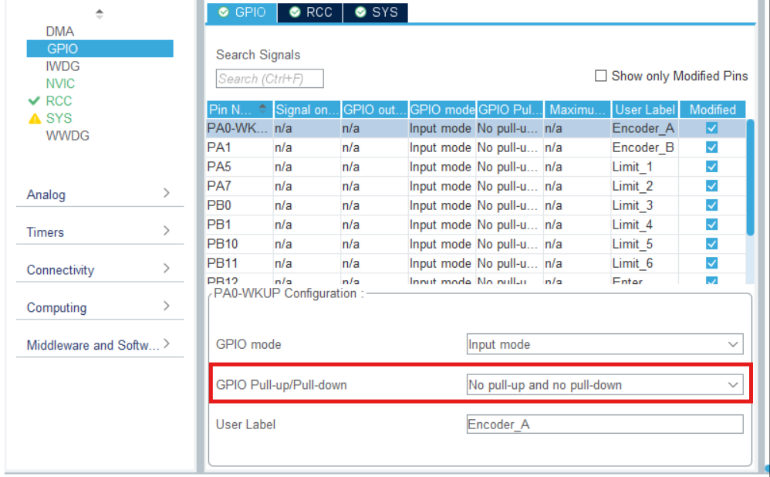
[picture p124: figure]

122

در این پروژه ما از پایه های 12PB تا 15PB را برای کلیدهای کنترلی و پایه های 0PA و 1PA را
برای روتاری انکودر و پایه های 5PA و 7PA و 0PB و 1PB و 10PB و 11PB را برای سنسورها به عنوان ورودی میکروکنترلر در نظر می گیریم.

شکل -6 -16 تعیین پایه های ورودی میکروکنترلر

پس از تنظیم پایه های میکروکنترلر به عنوان ورودی، می توانید در بخش GPIO تنظیمات تکمیلی
را نیز انجام دهید. بدین منظور تنها پارامتری که میتوان در این بخش تغییر داد مربوط به تعیین حالت ورودی به صورت up-Pull یا down-Pull می باشد و چون در کنترلر این پایه ها بصورت فیزیکی up-Pull شده اند نیازی به تغییر این تنظیمات در این بخش نخواهیم داشت.

شکل -6 -17 تنظیم نوع ورودی میکروکنترلر

فصل ششم: برنامه نویسی کنترلر ربات اسکارا

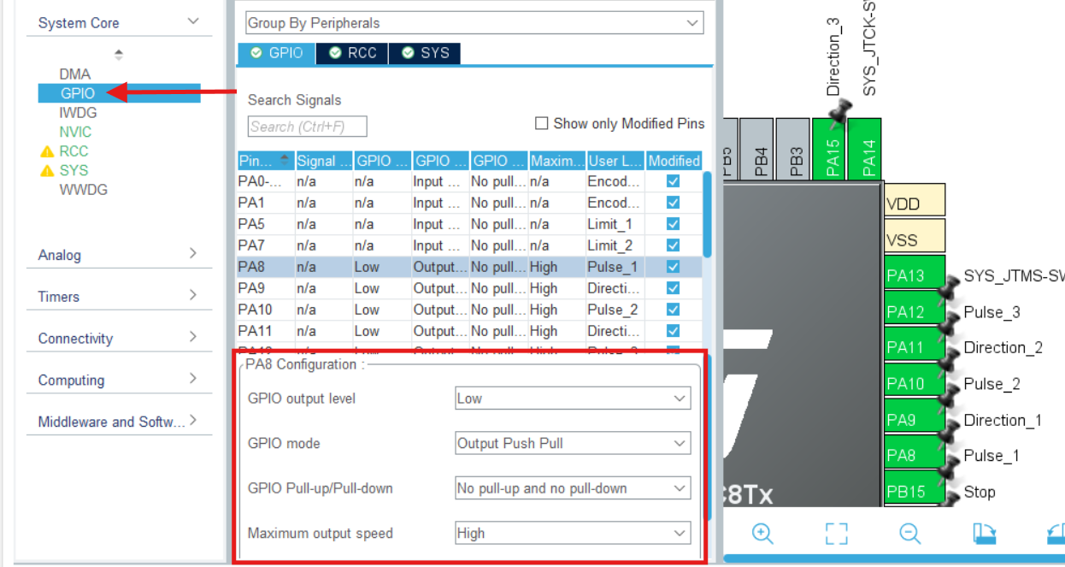
[picture p125: figure]
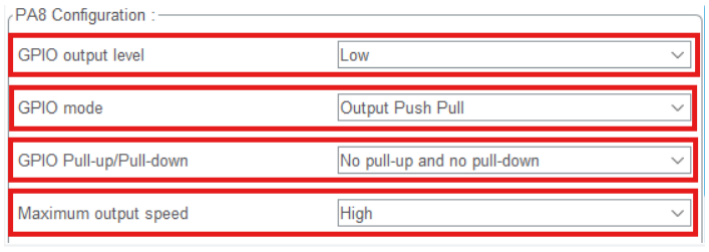
[picture p126: figure]

123

در این پروژه ما از پایه های 8PA تا 15PA را برای ارسال پالس به درایو استپرموتور به عنوان خروجی میکروکنترلر در نظر می گیریم. بدین صورت ما به سه گروه خروجی Pulse و Direction برای کنترل سه استپر موتور یا سه محور ربات اسکارا نیاز خواهیم داشت.

شکل -6 -18 تعیین پایه های خروجی میکروکنترلر

پس از تنظیم پایه های میکروکنترلر به عنوان خروجی، می توانید در بخش GPIO تنظیمات تکمیلی
را نیز انجام دهید. همانطور که در شکل -6 19 مشاهده می کنید ، این تنظیمات شامل چهار بخش می باشد که اولین پارامتر آن مربوط به تنظیم سطح سیگنال پیشفرض خروجی می باشد که باید بر روی Low قرار داشته باشد و دومین پارامتر مربوط به تعیین حالت خروجی بصورت Pull Push یا Drain Open می باشد که باید بر روی Pull Push قرار داشته باشد و سومین پارامتر نیز همانند تنظیمات ورودی، نیازی به تغییر نیست و چهارمین پارامتر مربوط به تعیین سرعت سوئیچینگ می باشد که باید بر روی High قرار داشته باشد.

شکل -6 -19 تنظیمات پایه خروجی میکروکنترلر

فصل ششم: برنامه نویسی کنترلر ربات اسکارا

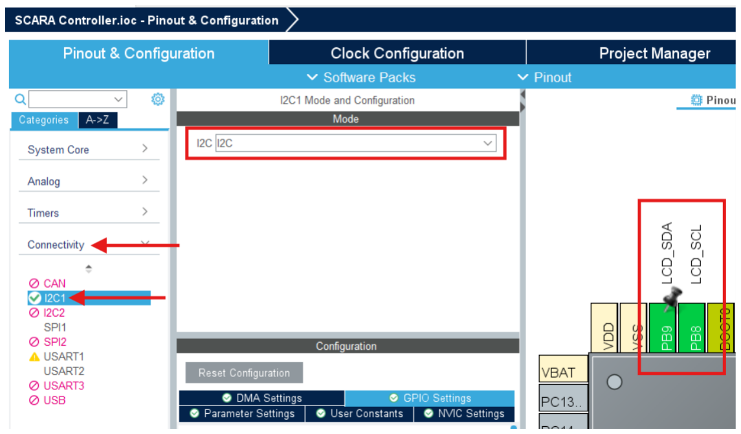
[picture p127: figure]
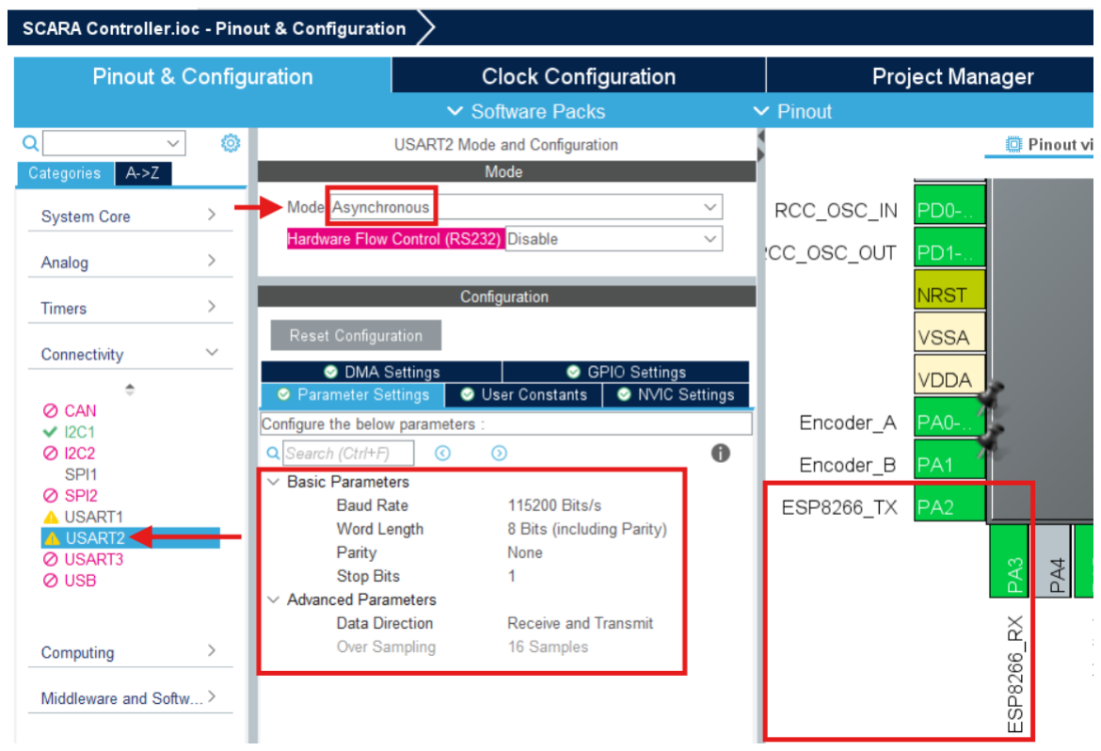
[picture p128: figure]

124

برای اتصال LCD کاراکتری به میکروکنترلر نیاز به فعالسازی واحد C2I خواهید داشت، بدین صورت برای فعالسازی این واحد باید از سربرگ Connectivity در بخش 1C2I اقدام کنید . پس از فعالسازی می توانید تغییرات اعمال شده بر روی پایه های میکروکنترلر را مشاهده نمایید .

شکل -6 -20 فعالسازی واحد C2I میکروکنترلر

برای اتصال ماژول 8266ESP به میکروکنترلر نیاز به فعالسازی واحد USART خواهید داشت، بدین صورت برای فعالسازی این واحد باید از سربرگ Connectivity در بخش 2USART اقدام کنید. پس از وارد شدن به این بخش باید گذینه Mode را بر روی Asynchronous یا آسنکرون قرار دهید.

شکل -6 -21 فعالسازی واحد USART میکروکنترلر

فصل ششم: برنامه نویسی کنترلر ربات اسکارا

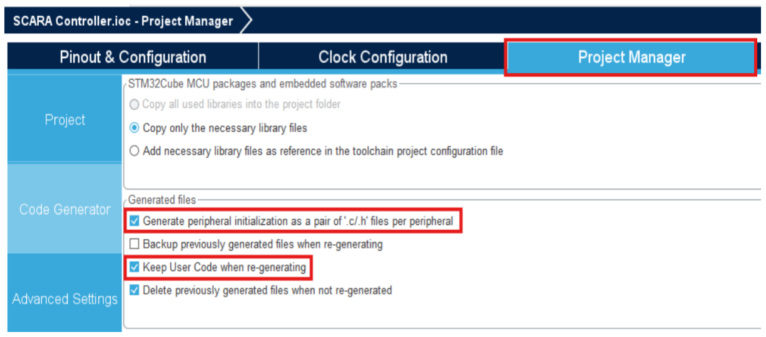
[picture p129: figure]

125

همانطور که در شکل 21-6 مشاهده می کنید در سربرگ Settings Parameter یکسری پارامترهای پایه برای ارتباط سریال وجود دارد که الزم است آنها را متناسب با نیاز خود تنظیم نمایید. درنهایت حتما گذینه interrupt global 2USART در سربرگ Settings NVIC را نیز انتخاب کنید تا واحد وقفه برای ارتباط سریال فعالسازی شود.

شکل -6 -22 فعالسازی وقفه سراسری برای واحد USART

به این نکته نیز حتما توجه کنید که علت انتخاب واحد 2USART به این دلیل است که سطح ولتاژ منطقی آن 3.3 ولت است و مابقی واحد های USART با ولتاژ 5 ولت کار می کنند و چون ماژول 8266ESP با ولتاژ 3.3 ولت کار می کند نیاز هست که از واحد 2USART استفاده نماییم. آخرین مرحله ای که نیاز به اعمال تغییرات در آن هستیم مربوط به بخش Manager Project می باشد، بدین منظور وارد بخش Generator Code از سربرگ Manager Project شده و گذینه Generate initialization peripheral انتخاب کنید تا نرم افزار IDE Cube برای هر واحد فعالسازی شده در محیط پیکربندی مانند واحد GPIO و C2I و USART یک کتابخانه مجزا در نظر بگیرد تا دسترسی سریع تر و سازماندهی شده به کدهای مربوط به این واحدها داشته باشیم. در قدم بعدی گذینه Code User Keep generating-re when را نیز انتخاب نمایید تا با هر بار تنظیم و پیکره بندی دوباره در این محیط ، کدهایی که در محیط برنامه نویسی توسط کاربر نوشته می شوند حذ ف نشوند.

شکل -6 -23 تنظیمات بخش Manager Project

فصل ششم: برنامه نویسی کنترلر ربات اسکارا

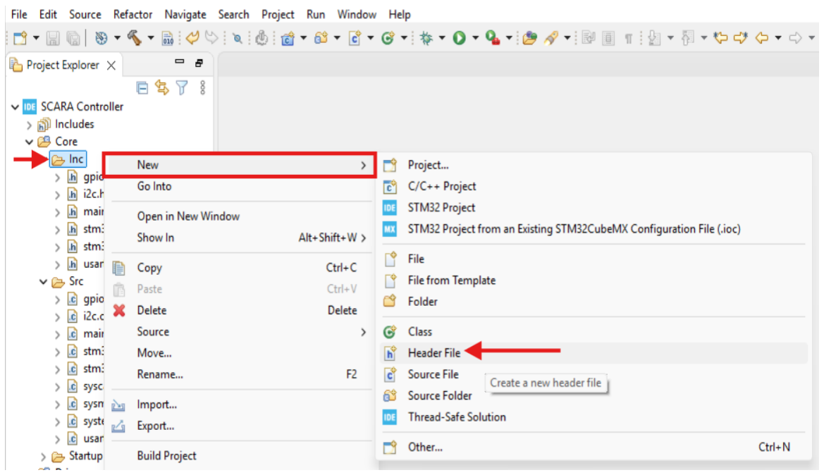
[picture p130: figure]

126

با انجام تنظیمات فوق، تمام تنظیمات مربوط به پیکربندی میکروکنترلر 32STM را در نرم افزار
IDE Cube را انجام دادیم ، درنهایت باید این پروژه را ذخیره کنیم تا تغییرات بخش پیکربندی بر روی کل پروژه اعمال شود. برا ی این منظور از طریق نوار ابزار باالی صفحه گذینه All Save را انتخاب نمایید.

شکل -6 -24 ذخیره تمام تغییرات اعمال شده

برای شروع برنامه نویسی اولین کاری که الزم است انجام دهیم ایجاد کتابخانه برای هر بخش برنامه
می باشد، اینکار عالوه بر سازماندهی کدها باعث می شود حجم برنامه نیز کاهش پیدا کند. برای ایجاد کتابخانه ما به دو فایل با پسوند h. و c. نیاز خواهیم داشت، به فایل هایی که با پسوند h. ساخته می شوند اصطالحاً file Header و به فایل هایی که با پسوند c. ساخته می شوند اصطالحاً file Source می گویند. بدین معنا که در هدر فایل، معموال پیکربندی و مقداردهی اولیه نظیر فراخوانی کتابخانه های دیگر، ایجاد ماکروها و نمونه اولیه توابع قرار می گیرند و در سورس فایل نیز کد اصلی شامل متغیرها و توابع قرار دارند. برای ایجاد کتابخانه در محیط IDE Cube باید از منوی Explorer Project بر روی پوشه Inc کلیک
راست کنید و در بخش New ، گذینه File Header را انتخاب کنید.

شکل -6 -25 نحوه ایجاد هدر فایل

فصل ششم: برنامه نویسی کنترلر ربات اسکارا

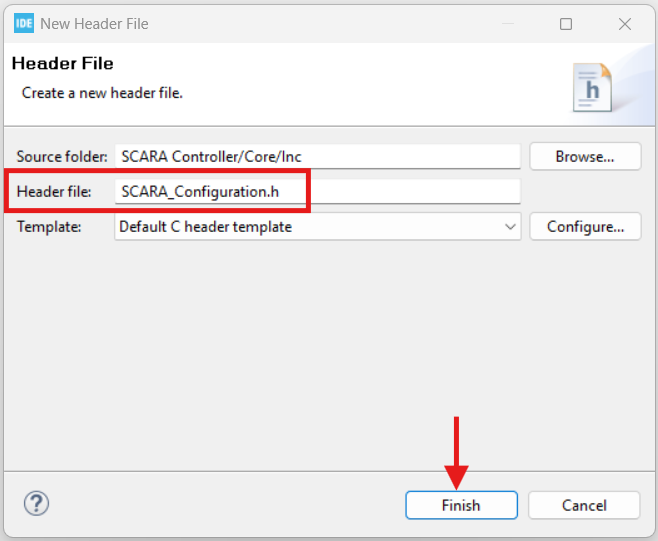
[picture p131: figure]

127

سپس در پنجره باز شده باید یک نام برای هدر فایل خود انتخاب نمایید. دقت کنید حتما در انتهای
نام انتخابی پسوند h. را نیز قرار دهید، پس از آن می توانید با کلیک بر روی گذینه Finish فایل خود را ایجاد کنید.

شکل -6 -26 انتخاب نام برای ایجاد هدر فایل

پس از ایجاد هدر فایل، می توانید فایل خود را در پوشه Inc مشاهده نمایید و در کادر عالمت زده شده در شکل -6 27 نیز می توانید کدهای خود بنویسید.

شکل -6 -27 محیط هدر فایل

برای ایجاد سورس فایل نیز می توانید طبق مراحل قبل از منوی Explorer Project ، این بار بر روی
پوشه Src کلیک راست کرده و در بخش New ، گذینه File Source را انتخاب کنید . همچنین در پنجره باز شده نیز باید یک نام برای سورس فایل خود با پسوند c. انتخاب نمایید.

فصل ششم: برنامه نویسی کنترلر ربات اسکارا

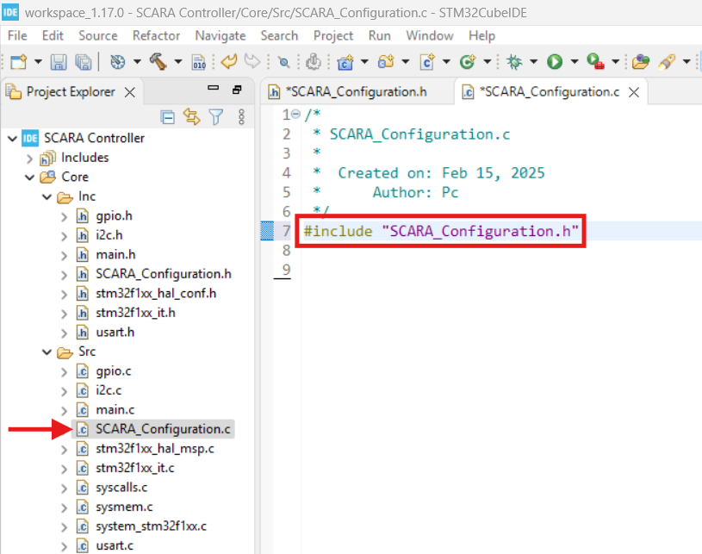
[picture p132: figure]

128

پس از ایجاد سورس فایل، می توانید فایل خود را در پوشه Src مشاهده نمایید و حتما قبل از اینکه کدهای خود را در این محیط بنویسید، طبق شکل 28-6 هدر فایل خود را با پیشوند include# فراخوانی کنید.

شکل -6 -28 محیط سورس فایل

.2-6 معرفی و بررسی کتابخانه Configuration SCARA همانطورکه قبال گفتیم برای شروع برنامه نویسی نیاز به ایجاد کتابخانه برای سازماندهی برنامه داریم
و برای اینکار ما کتابخانه Configuration SCARA را ایجاد کردیم. این کتابخانه یک کتابخانه جامع برای جایگذاری کدهای اصلی و پیکربندی بخش های مهم برنامه می باشد . برای شروع کار ابتدا نیاز است که یکسری کتابخانه داخلی را فراخوانی کنیم. این کتابخانه ها بصورت پیشفرض در پروژه قرار دارند و نیازی به ایجاد آنها نیست.

سپس کتابخانه های خارجی که توسط خودمون ساخته شده است را نیز فراخوانی می کنیم. این کتابخانه ها حتما باید به پروژه اضافه شوند، در ادامه به معرفی و بررسی هر کتابخانه خواهیم پرداخت.

فصل ششم: برنامه نویسی کنترلر ربات اسکارا

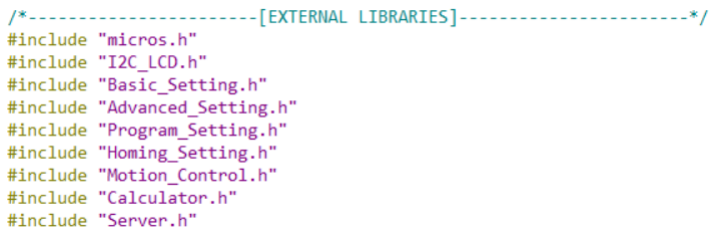
[picture p133: figure]
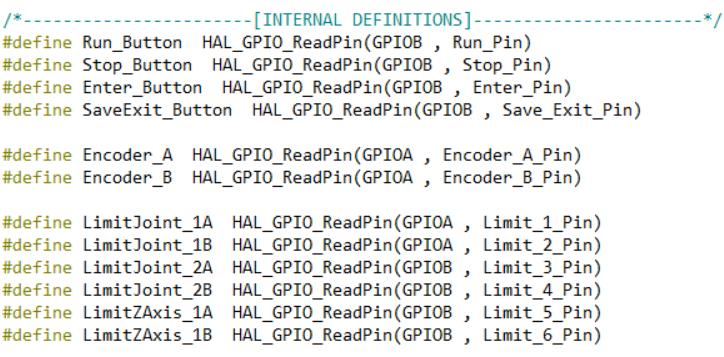
[picture p134: figure]
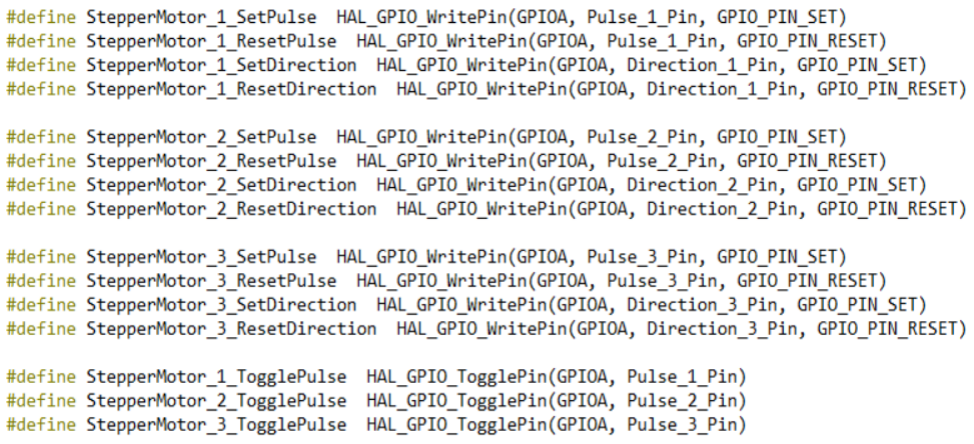
[picture p135: figure]

129

پس از فراخوانی کتابخانه ها نیاز داریم که پایه های ورودی میکروکنترلر را در برنامه تعریف نماییم،
برای اینکار می توانیم از ماکروها یا دستورات پیش پردازنده استفاده کنیم تا کدها تمیز و خوانا باشند. برای اینکه مقدار ورودی را از میکروکنترلر بخوانیم باید از تابع ReadPin_GPIO_HAL استفاده کنیم، بدین صورت پایه های ورودی میکروکنترلر را به شکل زیر در برنامه وارد می کنیم.

برای اینکه بتوانیم وضعیت پایه های خروجی میکروکنترلر را تغییر دهیم این بار هم باید از توابع
هال استفاده نماییم، این تابع WritePin_GPIO_HAL نام دارد که در دو حالت SET و RESET استفاده می شود ، بنابراین پایه های خروجی میکروکنترلر بصورت زیر در برنامه تعریف خواهند شد.

فصل ششم: برنامه نویسی کنترلر ربات اسکارا

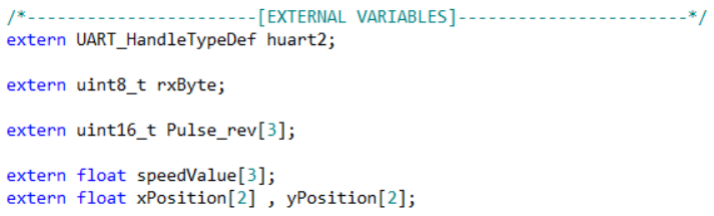
[picture p136: figure]
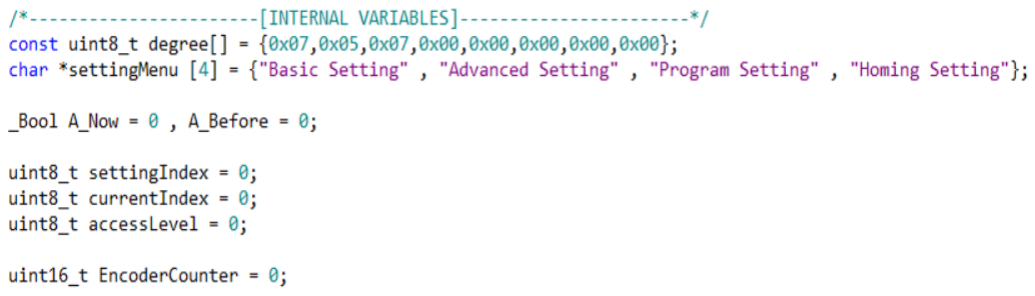
[picture p137: figure]

130

درنهایت توابعی که در سورس فایل نیز برای نوشتن کدهای اصلی برنامه به آنها نیاز خواهیم داشت را در این بخش تعریف می نماییم.

.1-2-6 معرفی متغیرهای خارجی متغیرهای خارجی، متغیرهایی هستند که در کتابخانه های دیگر تعریف و مقداردهی اولیه شدند و
در اینجا برای خواندن و تغییر مقدار آنها استفاده می شوند. این متغیرها بوسیله دستور extern به این کتابخانه فراخوانی می شوند.

.2-2-6 معرفی متغیرهای داخلی متغیرهای داخلی، متغیرهایی هستند که در این کتابخانه تعریف و مقداردهی اولیه شدند . این متغیرها می توانند در این کتابخانه یا کتابخانه های دیگر نیز استفاده شوند.

.3-2-6 معرفی تابع ControllerSetup
این تابع برای راه اندازی و پیکربندی های اولیه کنترلر تعبیه شده است، بدین صورت با روشن شدن کنترلر ابتدا این تابع اجرا شده و پارامترهای مهم برنامه مقداردهی اولیه می شوند. در ادامه محتویات موجود در این تابع را به ترتیب معرفی می نماییم.

فصل ششم: برنامه نویسی کنترلر ربات اسکارا

131

- دریافت و ذخیره اطالعات از طریق سریال

در ابتدا نیاز هست که تابع IT_Receive_UART_HAL را فراخوانی کنید، این تابع برای دریافت اطالعات از طریق ارتباط سریال و ذخیره اطالعات در بافر rxByte استفاده می شود. ورودی های این تابع بصورت زیر می باشد که huart *تعیین کننده کانال پورت سریال و pData *بافر دریافت بسته اطالعاتی و Size نیز حجم بافر دریافتی یا تعداد خانه های آرایه ای که می خواهد دریافت شود می باشد.

HAL_UART_Receive_IT(UART_HandleTypeDef *huart, uint8_t *pData, uint16_t Size)

- پیکربندی و راه اندازی LCD

در این بخش تابع فعالسازی LCD را فراخوانی می کنیم که ورودی های این تابع به ترتیب س تون و سطرهای LCD را تعیین می کنند. در ادامه نیز توابع فعالسازی بک الیت و نمایشگر LCD فراخوانی می شوند تا در زمان راه اندازی LCD آماده بکار شود. درنهایت تابع ساخت یک کاراکتر خاص و سفارشی فراخوانی می شود، این تابع یک آرایه که از قبل توسط کاربر ساخته شده است را با شماره ردیف به عنوان ورودی دریافت می کند تا در زمانی که نیاز به استفاده از این کاراکتر باشد از آن استفاده کرد. الزم به ذکر است که این کاراکتر سفارشی یک عالمت درجه است که در کتابخانه Setting_Program برای نمایش زاویه تنظیمی مفاصل ربات استفاده می شود.

- نمایش پیام خوش آمدگویی

در این بخش با استفاده از تابع WriteString_LCD_C2I یک پیام خوش آمدگویی بر روی LCD نمایش می دهیم. ورودی های این تابع بصورت زیر می باشد که Col شماره ستون LCD می باشد که می تواند از عدد 0 تا 15 تنظیم شود و همچنین Row نیز شماره سطر LCD می باشد که می تواند بین عدد 0 و 1 تنظیم شود و درنهایت Str *رشته یا آرایه رشته مورد نظر می باشد که میخواهید آنرا بر روی LCD در مکان مورد نظر نمایش دهید.

void I2C_LCD_WriteString(uint8_t Col, uint8_t Row, char *Str)

فصل ششم: برنامه نویسی کنترلر ربات اسکارا

132

- مقداردهی اولیه پارامترهای سرعت و پالس بر دور

در این بخش یک حلقه for ایجاد می کنیم تا بتوانیم آرایه های سرعت و پالس بر دور را مقداردهی پیشفرض نماییم. همانطور که باید بدانید پارامترهای سرعت و پالس بر دور، برای سه استپرموتور تنظیم می شود پس برای ذخیره سازی مقادیر آنها از آرایه استفاده شده است و برای اینکه بتوان بصورت یکسان برای همه درایه ها یک مقدار تنظیم نمود باید حتما از حلقه for استفاده نماییم، بدین صورت برای پارامتر سرعت مقدار پیشفرض 500 پالس بر ثانیه و برای پارامتر پالس بر دور نیز مقدار پیشفرض 3200 پالس تنظیم می شود.

- مقداردهی اولیه موقعیت های اولیه و ثانویه

برای اینکه بتوانیم مسیریابی خطی بین موقعیت های ربات داشته باشیم نیاز هست که موقعیت اولیه
و ثانویه محورهای X و Y را در اختیار داشته باشیم، موقعیت ثانویه همیشه توسط کاربر تنظیم می شود و موقعیت اولیه نیز زمانی که موقعیت جدیدی ثبت می شود با موقعیت قبلی جایگزین خواهد شد اما زمانیکه هنوز موقعیتی توسط کاربر به ثبت نرسیده باید مقدار موقعیت اولیه بصورت پیشفرض تنظیم شود که در این دو آرایه مختصات قرارگیری پیشفرض بازوهای ربات تنظیم شده است.
- مقداردهی اولیه شمارنده انکودر

مقدار متغیر EncoderCounter را برابر صفر قرار می دهیم که اگر تا قبل از آن دارای مقدار باشد، مقدار آن به حالت اولیه خود بازگردد. سپس یک تاخیر 3 ثانیه ای ایجاد می کنیم تا پیام خوش آمدگویی به این مدت بر روی صفحه LCD نمایش داده شود و بعد از آن توسط دستور پاکسازی صفحه LCD را برای نمایش منوی اصلی آماده سازی می نماییم.

فصل ششم: برنامه نویسی کنترلر ربات اسکارا

133

.4-2-6 معرفی تابع ControllerSetting
این تابع برای منوی اصلی کنترلر تعبیه شده است، بطوریکه با استفاده از این تابع می توانید منوی
اصلی را بر روی LCD نمایش دهید و بواسطه دکمه های روی کنترلر که قبال درمورد آنها صحبت شده بود وارد تنظیمات هر بخش شد و پارامترهای موجود در هر کدام را تنظیم و تغییر داد.
- محدودسازی شمارنده انکودر برای جابجایی بین پارامترهای منو

بطور کلی در همه توابعی که به عنوان یک منو استفاده می شوند، متغیری تعریف شده است که مقدار EncoderCounter را متناسب با تعداد پارامترهای منو محدود و در خود ذخیره می کند، بدین وسیله می توانید از این متغیر برای جابجایی بین منوها استفاده کنید. در اینجا از متغیر settingIndex استفاده شده است و همانطور که گفتیم مقدار EncoderCounter بدلیل حافظه ای که برای این متغیر درنظر گرفته شده است باید بین یک بازه عددی مورد نیاز محدود شود چراکه مقدار EncoderCounter می تواند از عدد 0 تا 65535 تغییر کند و از آنجایی که منوی اصلی کنترلر شامل چهار بخش تنظیمات می باشد باید مقدار settingIndex بین عدد 0 تا 3 تغییر کند پس برای اینکار می توانیم از عملگر % استفاده نماییم، این عملگر در زبان برنامه نویسی باقی مانده حاصل تقسیم را محاسبه و در اختیار کاربر قرار می دهد. پس بدین صورت می توانیم با محاسبه باقی مانده حاصل تقسیم EncoderCounter بر عدد مورد نظر، مقدار settingIndex را در هر بازه دلخواهی محدود نماییم.

- پاکسازی صفحه LCD در هر جابجایی بین پارامترهای منو

برای جابجایی بین پارامترهای منو نیاز است که متن قبلی از روی صفحه LCD پاک شود تا بتوانیم
متن بعدی را نمایش دهیم برای اینکار از یک دستور if استفاده شده است، بدین صورت زمانیکه مقدار settingIndex مخالف currentIndex بود، صفحه LCD پاک شود درنهایت مقدار settingIndex را با متغیر currentIndex برابر می کنیم تا فقط زمانی که تغییرات داشتیم اینکار انجام شود.

فصل ششم: برنامه نویسی کنترلر ربات اسکارا

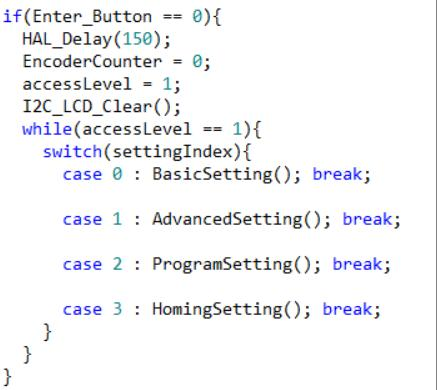
[picture p138: figure]

134

- نمایش پارامترهای منو بر روی صفحه LCD

در این بخش باید رشته های آرایه settingMenu که در بخش متغیرهای داخلی تعریف کردیم را بر
روی LCD نمایش دهیم، برای اینکار می توانیم از تابع WriteString_LCD_C2I استفاده کنیم. بدین صورت متغیر settingIndex به عنوان اندیس آرایه settingMenu قرار می گیرد تا با هر بار چرخش روتاری انکودر منوی جدید نمایش داده شود.
- فراخوانی توابع دستورات کنترلی از وب سرور

در این بخش سه تابع فراخوانی می شود که بوسیله آنها میتوان دستورات کنترلی ربات را از وب سرور دریافت کرد. توضیحات بیشتر این توابع را در کتابخانه Setting_Program داده خواهد شد.

- نحوه وارد شدن به هر بخش منوی اصلی

بعد از اینکه توانستیم بین منوها با روتاری انکودر جابجا شویم حال نوبت آن است که وارد هر یک
از این منوها شد، برای اینکار باید طبق گفته های پیشین از دکمه فشاری روتاری انکودر استفاده نمود. بدین صورت با دستور if وضعیت این دکمه یعنی Button_Enter بررسی می شود که چون ورودی ها بصورت پول آپ به میکروکنترلر متصل شده اند پس باید مقدار Button_Enter به صفر منطقی تغییر یابد،

فصل ششم: برنامه نویسی کنترلر ربات اسکارا

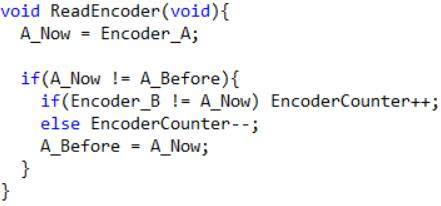
[picture p139: figure]

135

پس از تغییر یا فشرده شدن دکمه روتاری انکودر ابتدا یک تاخیر برای گرفتن دیبانس دکمه در نظر گرفته می شود و پس از آن باید مقدار EncoderCounter به حالت اولیه خود بازگردد. درنهایت باید عدد 1 را در متغیری تحت عنوان accessLevel به معنای سطح دسترسی قرار دهیم؛ بطورکلی برای طبقه بندی شدن منوها، ما از الگوریتمی استفاده کردیم که برای دسترسی به طبقه زیرین هر منو باید ابتدا یک مقدار متناسب با هر طبقه به متغیر accessLevel اختصاص داده شود. بدین صورت برای وارد شدن به طبقه زیرین منو از یک حلقه while استفاده شده است که شرط ورود آن نیز مقدار accessLevel می باشد، این مقدار نیز همانطور که گفتیم متناسب با هر طبقه در نظر گرفته می شود، بطور مثال اگر در منوی اصلی قرار داشته باشیم و بخواهیم وارد منوی بعدی یعنی داخل منوی مورد نظر شویم نیاز هست که عدد 1 را به این متغیر اختصاص دهیم و به همین شکل اگر زیر منویی وجود داشته باشد به ترتیب اعداد 2 ، 3 و 4 شماره گذاری می شود. اینکار باعث می شود تا زمانیکه شرط accessLevel برقرار باشد نتوان از حلقه while خارج شد و همچنین برای خارج شدن از این حلقه نیز که در ادامه توضیح خواهیم داد باید مقدار accessLevel را به مقدار قبلی آن تغییر داد. حال پس از وارد شدن به این حلقه، میتوان بوسیله دستور سوئیچ کیس تعیین کرد که متناسب با مقدار settingIndex وارد کدام منو شوید. که در ادامه توابع این منوها را نیز بررسی خواهیم کرد.

.5-2-6 معرفی تابع ReadEncoder
این تابع برای خواندن تعداد پالس های شمارش شده توسط روتاری انکودر تعبیه شده است، بطوریکه
با چرخش روتاری انکودر به چپ و راست میتوان مقدار متغیر EncoderCounter را افزایش و کاهش داد.

در این تابع دو متغیر با نام های Now_A و Before_A وجود دارند که وضعیت پایه A روتاری انکودر را در دو حالت قبل و بعد می خوانند. همانطور که در فصل قبل در بخش معرفی روتاری انکودر توضیح داده شده بود، وضعیت پایه های A و B روتاری انکودر در هر چرخش بواسطه پله هایی که در ساختار داخلی آن وجود دارد، بصورت صفر و یک تغییر می کنند یعنی پالس هایی با فاصله زمانی مشخص تولید می شوند که این پالس های تولید شده از هر پایه روتاری انکودر با یکدیگر 90 درجه اختالف فاز الکتریکی دارند، بدین صورت میتوان جهت چرخش انکودر را تشخیص داد. پس در نتیجه برای اینکه بتوان

فصل ششم: برنامه نویسی کنترلر ربات اسکارا

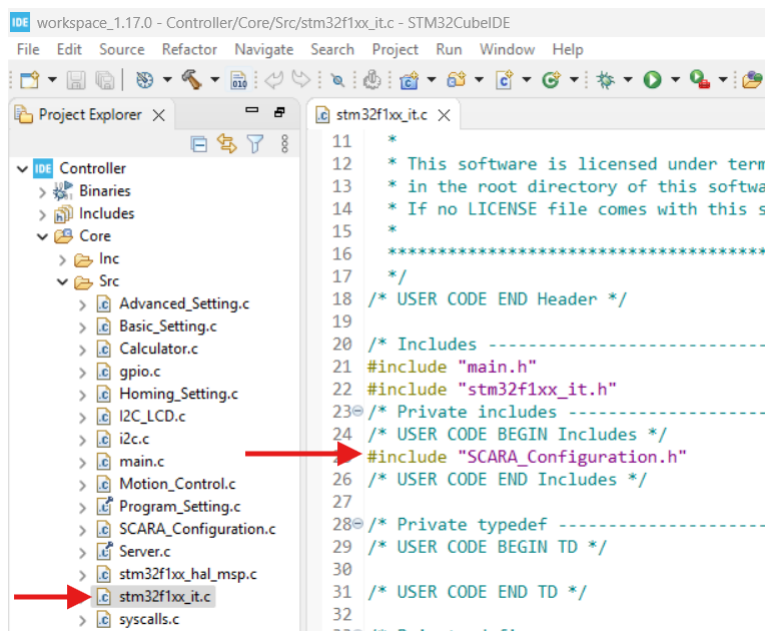
[picture p140: figure]

136

تشخیص داد که انکودر درحال چرخش است باید وضعیت قبل و بعد آنرا در یک متغیر ذخیره کنیم. حال پس از دانستن وضعیت قبل و بعد پایه A میتوان با یک دستور if تعیین نمود که آیا انکودر چرخیده است یا خیر، بدین صورت حتما باید دو وضعیت پایه A با یکدیگر نامساوی باشند یعنی زمانی که وضعیت این پایه از مقدار صفر منطقی به یک منطقی تغییر کند نیاز داریم که مقدار متغیر EncoderCounter را افزایش یا کاهش دهیم. برای اینکه جهت چرخش را نیز تشخیص دهیم همانطور که گفتیم زمانی که وضعیت پایه A و B برابر نباشد یعنی ر وتاری انکودر در جهت عقربه های ساعت چرخانده شده و مقدار متغیر EncoderCounter باید افزایش یابد و زمانی که وضعیت پایه A و B برابر باشد یعنی روتاری انکودر در جهت عکس عقربه های ساعت چرخانده شده و مقدار متغیر EncoderCounter باید کاهش یابد . اینکار با یک دستور if دیگر در داخل دستور if قبلی انجام می شود، بدین صورت که وضعیت B_Encoder که قبال به عنوان ماکرو تعریف شده بود با وضعیت Now_A مقایسه می شود. در نهایت نیز مقدار Now_A در Before_A ریخته می شود تا این تابع برای چرخش بعدی روتاری انکودر آماده باشد. این تابع درنهایت در کتابخانه it_xx1f32stm فراخوانی خواهد شد. همانطور که در شکل 29-6 مشاهده می نمایید ابتدا باید کتابخانه Configuration_SCARA را در این مکان قرار دهیم تا بتوانیم تابع ReadEncoder را فراخوانی نماییم.

شکل -6 -29 فراخوانی کتابخانه Configuration_SCARA

همانطور که در شکل 30-6 مشاهده می کنید، تابع ReadEncoder در تابع Handler_SysTick فراخوانی شده است اما چرا؟ برای اینکه بتوانیم وضعیت پایه های A و B روتاری انکودر را در هر لحظه از میکروکنترلر بدون هیچ تاخیری بخوانیم باید از توابعی استفاده کنیم که واحد وقفه برای آنها فعالسازی

فصل ششم: برنامه نویسی کنترلر ربات اسکارا

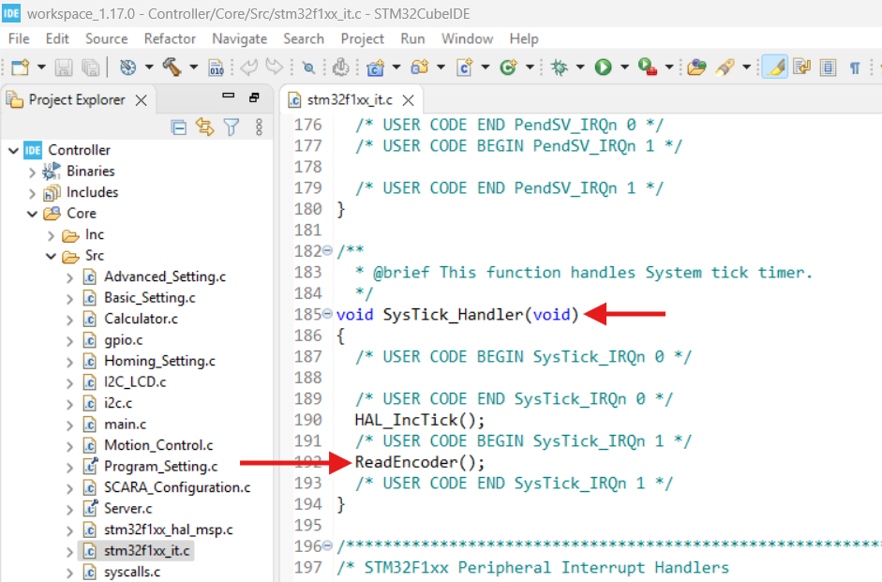
[picture p141: figure]
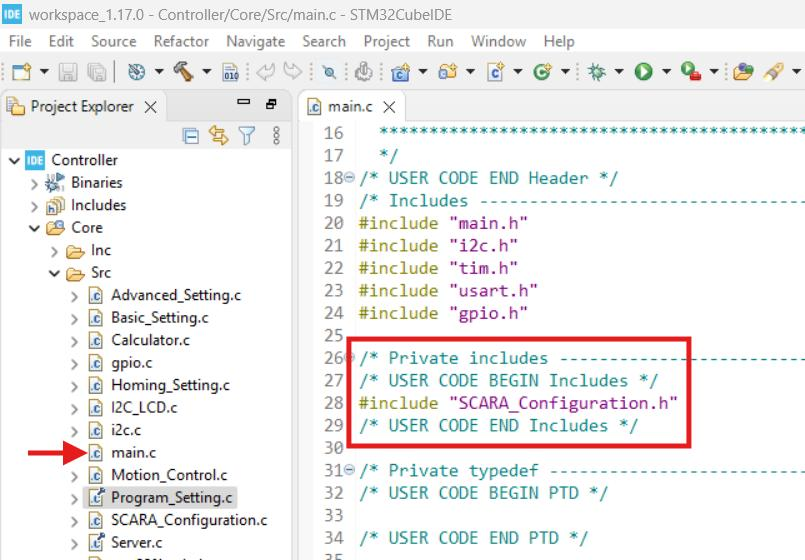
[picture p142: figure]

137

شده است. از آنجایی که تابع ReadEncoder یک تابعی است که واحد فقه برای آن فعالسازی نشده است نیاز داریم که آنرا در یک تابع دیگر که واحد وقفه برای آن فعالسازی شده فراخوانی نماییم. البته دقت شود که این روش استانداردی نیست و ممکن است در طوالنی مدت بر عملکرد سیستم تاثیر بگذارد بنابراین توصیه می شود که برای اینکار حتما واحد وقفه را برای یکی از ورودی ها انکودر فعالسازی کنید و از تابع مخصوص آن استفاده نمایید.

شکل -6 -30 فراخوانی تابع ReadEncoder
.6-2-6 معرفی تابع Main
این تابع، تابع اصلی پروژه شناخته می شود که درنهایت تمامی کتابخانه ها و توابع موجود در پروژه
باید در این تابع فراخوانی شوند تا در زمان کامپایل شدن، کدها به زبان ماشین تبدیل شوند و شما بتوانید برنامه را بر روی میکروکنترلر خود دانلود نمایید. کدهایی که در این تابع قرار می گیرند به شرح زیر است.

شکل -6 -31 فراخوانی کتابخانه Configuration_SCARA در تابع اصلی

فصل ششم: برنامه نویسی کنترلر ربات اسکارا

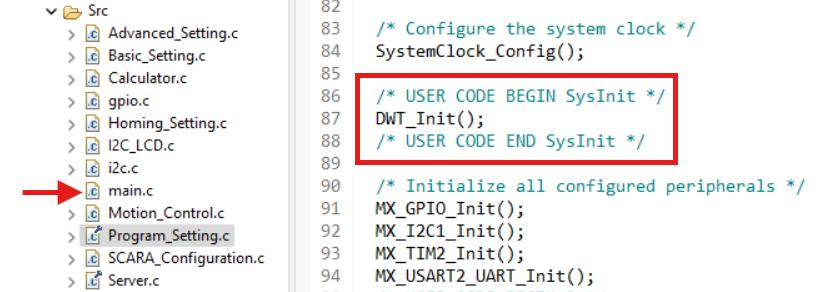
[picture p143: figure]
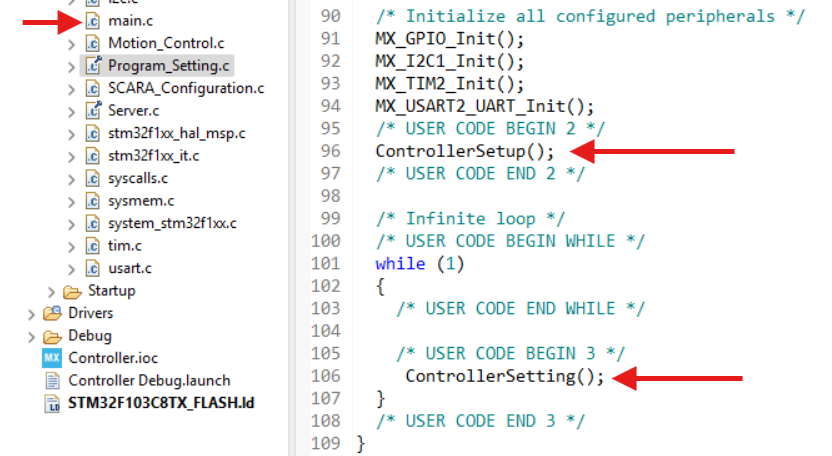
[picture p144: figure]

138

در ابتدا کتابخانه Configuration_SCARA که قبال ایجاد کرده بودیم را در این مکان فراخوانی می
1 | نماییم و سپس در ادامه تابع فعالساز
DWT را در محل عالمت زده شده شکل 32-6 قرار می دهیم، این
تابع فعالسازی برای کتابخانه Micros می باشد که بصورت دستی به پروژه اضافه شده است. از آنجایی که توابع هال فقط تاخیرها و زمان سنج ها را برحسب میلی ثانیه ارائه می دهند برای استفاده از تاخیرهایی برحسب میکروثانیه باید آنها را بصورت دستی ساخت این کتابخانه نیز به همین منظور به پروژه اضافه شده است.

شکل -6 -32 جایگذاری تابع فعالساز DWT در تابع اصلی

درنهایت توابع ControllerSetup و ControllerSetting نیز به ترتیب در مکان های عالمت زده شده در شکل 33-6 فراخوانی می شوند تا برنامه بدرستی اجرا شود.

شکل -6 -33 فراخوانی توابع ControllerSetup و ControllerSetting

1 Debug Watchpoint & Trace

فصل ششم: برنامه نویسی کنترلر ربات اسکارا

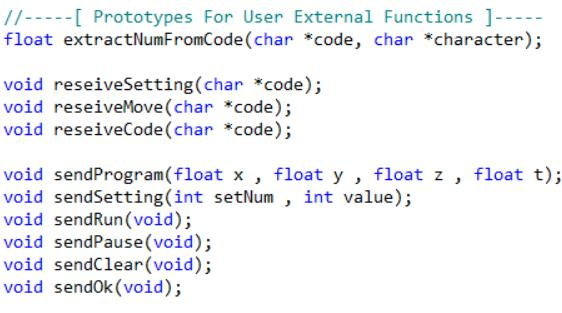
[picture p145: figure]

139

.3-6 معرفی و بررسی کتابخانه Server این کتابخانه برای تبادل اطالعات بصورت دوطرفه همزمان بین کنترلر و صفحه وب ایجاد شده است،
در این کتابخانه توابعی وجود دارد که با استفاده از آنها می توانید موقعیت های تنظیم شده ربات را کنترل و پارامترهای هر تنظیمات را به صفحه وب ارسال یا از صفحه وب دریافت نمایید. این توابع نیز در هدر فایل تعریف شده اند تا از آنها در سورس فایل، برای نوشتن کدهای اصلی برنامه استفاده نماییم.

.1-3-6 معرفی متغیرهای خارجی متغیرهای خارجی، متغیرهایی هستند که در کتابخانه های دیگر تعریف و مقداردهی اولیه شدند و
در اینجا برای خواندن و تغییر مقدار آنها استفاده می شوند. این متغیرها بوسیله دستور extern به این کتابخانه فراخوانی می شوند.

.2-3-6 معرفی متغیرهای داخلی متغیرهای داخلی، متغیرهایی هستند که در این کتابخانه تعریف و مقداردهی اولیه شدند. این متغیرها می توانند در این کتابخانه یا کتابخانه های دیگر نیز استفاده شوند.

فصل ششم: برنامه نویسی کنترلر ربات اسکارا

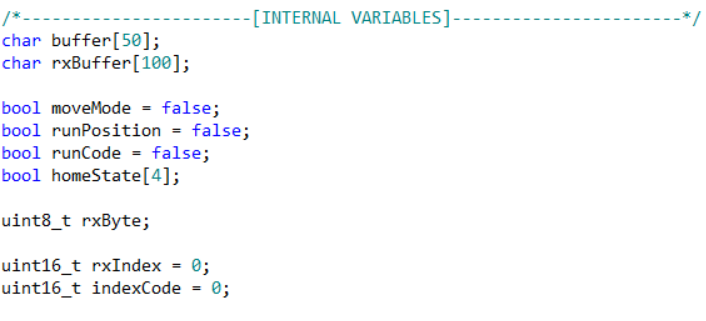
[picture p146: figure]
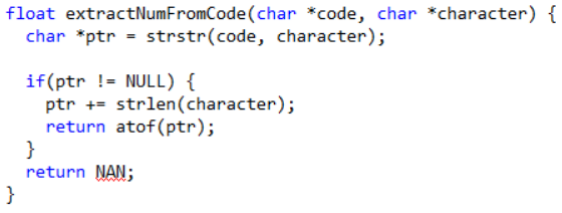
[picture p147: figure]

140

.3-3-6 معرفی تابع extractNumFromCode
این تابع برای استخراج یک عدد اعشاری از یک رشته کد استفاده می شود. اینکار را بر اساس یک کاراکترکه به عنوان ورودی داده می شود انجام م ی دهد . به زبان ساده، این تابع به دنبال یک کاراکتر در رشته مورد نظر می گردد و هر چیزی که بعد از آن کاراکتر قرار دارد را به عدد اعشار ی تبد یل می کند و برمی گرداند .

در ابتدا، تابع strstr به دنبال اولین تطابق character در رشته code می گردد و آدرس آن را برمی گرداند . این آدرس در متغیر ptr ذخیره می شود. اگر متغیر ptr برابر NULL نباشد )یعنی character در code پیدا شود(، متغیر ptr را به اندازه طول character جلو می بریم تا به اولین کاراکتر بعد از character برس یم. سپس، تابع

1

2 | atof مقدار عددی را که از موقعیت فعلی متغیر ptr شروع م ی شود به عدد اعشاری
تبد یل می کند و آنرا برمی گرداند . اگر متغیر ptr برابر NULL باشد )یعنی character در code پیدا نشود(، 3 تابع مقدار
NAN را برمی گرداند. بطور مثال فرض کنید متغیر code برابر با "125.5Y 225.5X 0G "و
متغیر character برابر با "X "باشد. تابع ابتدا به دنبال کاراکتر "X "می گردد و وقتی آن را پیدا کرد، اشاره گر را به بعد از "X "جلو م ی برد و از موقعیت "225.5" شروع به تبد یل می کند که نتیجه نهایی عدد 225.5 به صورت float خواهد بود.

1 ASCII to float

2
float
3 Not A Number

فصل ششم: برنامه نویسی کنترلر ربات اسکارا

141

HAL_UART_RxCpltCallback | تابع | معرفی | .4-3-6
این تابع درواقع وظیفه دارد تا بایتهای دریافتی از طر یق UART را تجزیه و تحلیل کند و بر اساس محتوای آن ها اقدامات مختلفی را انجام دهد. این اقدامات می تواند شامل پردازش تنظیمات، حرکتها، پایان عملیات، دریافت کدها و افزایش شمارنده موقعیت باشد. ورودی این تابع بصورت زیر می باشد که huart * تعیین کننده کانال پورت سریال می باشد.

HAL_UART_RxCpltCallback(UART_HandleTypeDef *huart)

- بررسی پا یان خط بایت دریافتی

اگر بایت دریافتی n \باشد، به معنای پایان خط است. اینجا متغیر rxBuffer را با کاراکتر پایان 0\ کامل می کند و rxIndex را صفر م ی کند تا از اول شروع کند.

- بررسی محتوای پ یام دریافتی

اگر پیام حاوی "setting "باشد ، تابع reseiveSetting با محتوای rxBuffer فراخوان ی م ی شود تا تنظیمات مربوطه پردازش شوند.

اگر پیام حاوی "Move "باشد ، تابع reseiveMove با محتوا ی rxBuffer فراخوانی م ی شود تا حرکت مورد نظر پردازش شود.

اگر پیام حاو ی "End "باشد ، متغیرهای runPosition و runCode غیر فعال می شوند )false شده( و متغیر indexCode نیز صفر می شود.

فصل ششم: برنامه نویسی کنترلر ربات اسکارا

142

اگر پیام حاوی "Position "یا "Code "باشد ، تابع reseiveCode با محتوای rxBuffer فراخوانی می شود تا کد مورد نظر پردازش شود.

اگر پیام حاو ی " ++" باشد ، شمارنده PositionCounter افزایش می یابد .

- اضافه کردن بایت دریافتی به بافر )در صورت عدم پایان خط(

اگر بایت دریافتی n \نباشد، با یت دریافتی به rxBuffer اضافه می شود و rxIndex افزایش می یابد .

.5-3-6 معرفی تابع reseiveSetting
این تابع به منظور پردازش دستورات تنظیماتی است که از طریق UART دریافت م ی شود. بر اساس دستورات دریافتی، این تابع تنظیمات مختلف ی را اعمال می کند مانند فعال کردن حالت های مختلف، تنظیم سرعت استپر موتورها، تعیین نوع س ینماتیک، تنظیم تعداد پالسهای موتورها و طول مفاصل. این تابع یک پارامتر ورودی به نام code دارد. این پارامتر شامل دستورات تنظیماتی است که باید پردازش شوند.

void reseiveSetting(char *code)

- بررسی وضعیت AutoHoming

در اینجا تابع strstr بررس ی م یکند که آیا متغیر rxBuffer حاوی رشته "AutoHoming "است یا خیر. اگر بله، مقدار [0]homeState را به true تنظیم م ی کند و عملیات هومینگ بصورت خودکار برای همه محورها انجام می شود.

Home Joint1 | وضعیت | بررسی |

فصل ششم: برنامه نویسی کنترلر ربات اسکارا

143

در اینجا تابع strstr بررس ی م یکند که آیا متغیر rxBuffer حاوی رشته "1Joint " است یا خیر. اگر
بله، مقدار [1]homeState را به true تنظیم می کند و عملیات هومینگ بصورت دستی برای محور اول انجام می شود.
Home Joint2 | وضعیت | بررسی |

در اینجا تابع strstr بررس ی م یکند که آیا متغیر rxBuffer حاوی رشته "2Joint " است یا خیر. اگر
بله، مقدار [2]homeState را به true تنظیم می کند و عملیات هومینگ بصورت دستی برای محور دوم انجام می شود.
Home Z | وضعیت | بررسی |

در اینجا تابع strstr بررس ی م یکند که آیا متغیر rxBuffer حاوی رشته "3Joint " است یا خیر. اگر
بله، مقدار [3]homeState را به true تنظیم می کند و عملیات هومینگ بصورت دستی برای محور سوم انجام می شود.
- پردازش سایر دستورات تنظیمات

اگر متغیر rxBuffer حاوی ه یچ یک از رشته های باال نباشد، تابع به بخش دیگری از کد میرود. در اینجا، از دو تابع به نام extractNumFromCode برای استخراج اعداد از متغیر code استفاده می شود:
- متغیر setNum : شماره پارامتر که با استفاده از کاراکتر " P "استخراج م ی شود.
- متغیر value : مقدار پارامتر که با استفاده از کاراکتر "=" استخراج می شود.

فصل ششم: برنامه نویسی کنترلر ربات اسکارا

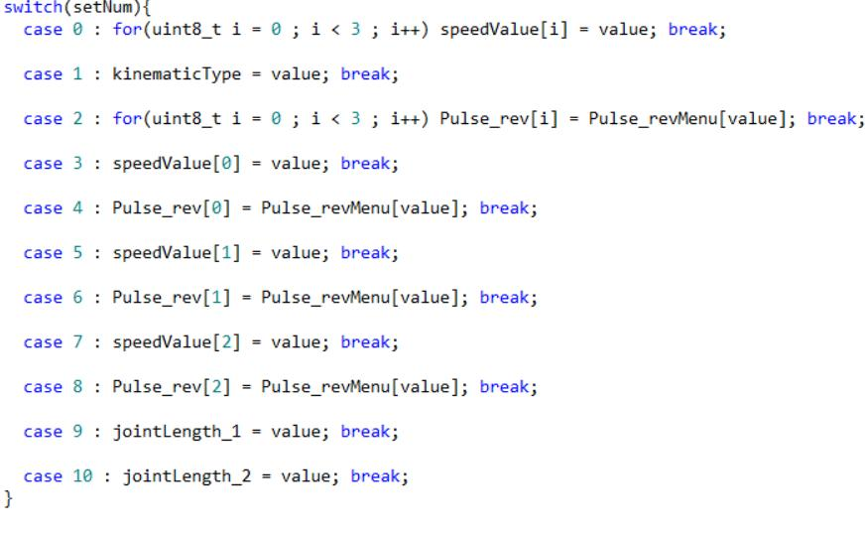
[picture p148: figure]

144

- اعمال تنظیمات بر اساس شماره پارامتر

این بخش از کد با استفاده از دستور سوئیچ کیس بر اساس مقدار setNum، تنظیمات مختلفی را اعمال می شود:
- اگر مقدار setNum برابر 0 باشد، پارامتر سرعت برای همه استپر موتورها تنظیم می شود.
- اگر مقدار setNum برابر 1 باشد، نوع سینماتیک )مستقیم یا معکوس( تنظیم می شود.
- اگر مقدار setNum برابر 2 باشد، پارامتر پالس بر دور برای همه استپر موتورها تنظیم می شود.
- اگر مقدار setNum برابر 3 باشد، پارامتر سرعت برای استپر موتور 1 تنظیم می شود.
- اگر مقدار setNum برابر 4 باشد، پارامتر پالس بر دور برای استپر موتور 1 تنظیم می شود.
- اگر مقدار setNum برابر 5 باشد، پارامتر سرعت برای استپر موتور 2 تنظیم می شود.
- اگر مقدار setNum برابر 6 باشد، پارامتر پالس بر دور برای استپر موتور 2 تنظیم می شود.
- اگر مقدار setNum برابر 7 باشد، پارامتر سرعت برای استپر موتور 3 تنظیم می شود.
- اگر مقدار setNum برابر 8 باشد، پارامتر پالس بر دور برای استپر موتور 3 تنظیم می شود.
- اگر مقدار setNum برابر 9 باشد، حداکثر طول بازوی اول تنظیم می شود.
- اگر مقدار setNum برابر 10 باشد، حداکثر طول بازوی دوم تنظیم می شود.

فصل ششم: برنامه نویسی کنترلر ربات اسکارا

145

.6-3-6 معرفی تابع reseiveMove
این تابع برای پردازش دستورات حرکتی استفاده می شود. در این تابع، مختصات X ، Y و Z از دستور دریافتی استخراج شده و تنظ یمات مربوط به موقعیت ها به روزرسانی م ی شوند . این تابع دارای یک پارامتر ورودی به نام code می باشد. این پارامتر شامل دستور حرکتی است که از طریق UART دریافت می شود.

void reseiveMove(char *code)

- تعر یف متغیرهای محلی و فعالسازی حالت Move

در اینجا، سه متغیر x ، y و z از نوع float تعریف می شوند که برای ذخیره مختصات X، Y و Z استفاده می شوند . همچنین متغیر moveMode به true تنظیم می شود که نشان می دهد ربات می تواند با دریافت دستور Move به موقعیت مورد نظر حرکت کند.

- استخراج مختصات X و Y و Z

در اینجا از تابع extractNumFromCode برای استخراج مقادیر مربوط به مختصات X ، Y و Z از رشته code استفاده می شود. این تابع به دنبال کاراکترهای X ، Y و Z م ی گردد و اعد اد بعد از آنها را استخراج می کند .

- بهروزرسان ی موقعیت های ثانویه

در این بخش، مقدار x به [1]xPosition و مقدار y به [1]yPosition اختصاص داده می شود. این مقادیر برای تنظ یم موقعیت جد ید ربات استفاده می شوند .

فصل ششم: برنامه نویسی کنترلر ربات اسکارا

146

.7-3-6 معرفی تابع reseiveCode این تابع برای پردازش دستورات مختلف ی استفاده م ی شود که ممکن است شامل پاک کردن موقعیت ها، توقف عملیات، تنظیم حالتهای حرکتی و بروزرسانی مختصات باشد. این تابع بر اساس دستور دریافتی، اقدامات متفاوتی انجام می دهد . این تابع دارای یک پارامتر ورودی به نام code می باشد. این پارامتر شامل دستور کد است که از طریق UART دریافت می شود.

void reseiveCode(char *code)

- تعر یف متغیرهای محلی

در اینجا سه متغیر x ، y و z از نوع float تعریف شده اند که برا ی ذخیره مختصات استفاده م ی شوند .

- بررسی وضعیت پاکسازی موقعیت ها

در اینجا تابع strstr بررس ی م یکند که آیا rxBuffer حاوی رشته "Clear Positions "است یا خیر.
اگر بله، مقدار PositionCounter به صفر تنظیم می شود که به معنای پاک کردن تمام موقع یتها است.
- بررسی وضعیت توقف برنامه

این بخش بررس ی م ی کند که آیا rxBuffer حاوی رشته " Pause "است یا خیر. اگر بله، مقدار متغیر

indexCodeState به صفر تنظیم می شود و مقادیر runPosition و runCode به false تنظیم می شوند
که به معنای توقف عملیات است.
- بررسی وضعیت بازگشت به موقعیت قبل ی

فصل ششم: برنامه نویسی کنترلر ربات اسکارا

147

این بخش بررس ی می کند که آیا rxBuffer حاوی رشته "pBack "است یا خیر. اگر بله، مقدار متغیر

indexCodeState به صفر تنظیم می شود و مقادیر runPosition و runCode به false تنظیم می شوند
که به معنای بازگشت به حالت قبلی است.
- بررسی و تنظیم حالت Position

اگر rxBuffer حاوی رشته "Position "باشد و متغیر runPosition به false تنظ یم شده باشد، آنرا به true تنظیم می کند . این به معنای فعال کردن حالت حرکت Position است.

- بررسی و تنظیم حالت Code

اگر rxBuffer حاوی رشته " Code "باشد و متغیر runCode به false تنظیم شده باشد، آنرا به true تنظیم می کند . این به معنای فعال کردن حالت حرکت Code است.

- استخراج مختصات X و Y و Z

در اینجا از تابع extractNumFromCode برای استخراج مقادیر مربوط به مختصات X ، Y ، Z و indexCode از رشته code استفاده می شود. این تابع به دنبال کاراکترهای X ، Y ، Z و I می گردد و اعداد بعد از آنها را استخراج می کند .

- بهروزرسان ی موقعیت های ثانویه

فصل ششم: برنامه نویسی کنترلر ربات اسکارا

148

در این جا اگر مقادیر x و y دارای عدد باشند یا NaN نباشند ، مقدار x به [1]xPosition و مقدار y
به [1]yPosition اختصاص داده می شود. این مقادیر برای تنظیم موقعیت جد ید ربات استفاده می شوند .

.8-3-6 معرفی تابع sendProgram
این تابع برای ارسال مختصات و زمان به وب سرور از طر یق UART استفاده م ی شود. دادهها در قالب
یک رشته فرمت دار تولید شده و از طریق UART ارسال می شوند . این تابع دارای چهار پارامتر ورودی x ، y ، z و t از نوع float می باشد .

void sendProgram(float x , float y , float z , float t)

- پاک کردن محتویات بافر

در اینجا از تابع memset برا ی پاک کردن محتویات buffer استفاده م ی شود و همه ی بایتهای آنرا
به صفر تنظیم م ی کند . حجم بافر 50 بایت است. اینکار به منظور اطمینان از اینکه بافر برای ذخیره سازی رشته جدید آماده باشد انجام می ش ود.
- فرمتدهی به رشته و ذخیره در بافر

این خط از تابع sprintf برا ی ایجاد یک رشته فرمتدار استفاده می کند و آن را در buffer ذخیره می کند . رشته تولید شده شامل اطالعات زیر می باشد.
- متغیر PositionCounter : شماره موقع یت فعل ی
- متغیر x : مقدار مختصات X
- متغیر y : مقدار مختصات Y
- متغیر z : مقدار مختصات Z
- متغیر t : مقدار زمان T

به عنوان مثال، اگر 12.3 = x ، 45.6 = y ، 78.9 = z ، 250 = t و 2 = PositionCounter باشد،
رشته تولید شده به شکل زیر خواهد بود.

Positions I3 = X12.3 Y45.6 Z78.9 T250

فصل ششم: برنامه نویسی کنترلر ربات اسکارا

149

- ارسال داده ها از طریق تابع IT_Transmit_UART_HAL

HAL_UART_Transmit_IT(&huart2, (uint8_t*)buffer, strlen(buffer)) ;

این خط از تابع IT_Transmit_UART_HAL برای ارسال داده های موجود در buffer از طریق UART استفاده م ی کند . پارامترهای ورود ی شامل کانال پورت سریال، بافر بسته اطالعاتی و طول بافر که با استفاده از تابع strlen محاسبه می شود.

.9-3-6 معرفی تابع sendRun
این تابع برا ی ارسال پیام "n\Run Positions "به وب سرور از طریق UART استفاده می شود. این پیام می تواند به منظور اعالم شروع یا ادامه عملیات به وب سرور استفاده شود. ارسال این پیام با استفاده از واحد وقفه انجام می شود که به میکروکنترلر اجازه می دهد تا عملیات ارسال را بدون بالک کردن پردازش های دیگر انجام دهد.

این خط از تابع IT_Transmit_UART_HAL برای ارسال پیام "n\Run Positions "از طر یق
UART استفاده می کند . پارامترهای ورودی شامل کانال پورت سریال، رشته " n\Run Positions "و طول رشته "n\Run Positions "که شامل 13 کاراکتر و یک کاراکتر پایان خط است که در مجموع 14 بایت طول دارد؛ طول رشته به تابع اطالع می دهد که چه مقدار داده باید ارسال شود.

.10-3-6 معرفی تابع sendPause این تابع برا ی ارسال پیغام توقف یا Pause به وب سرور از طریق UART استفاده می شود. این تابع
بسته به وضعیت فعلی )runPosition یا runCode)، پیغام مناسب را ارسال می کند و حالتها و متغیرهای مربوطه را بروزرسانی می کند .
- بررسی وضع یت runPosition

فصل ششم: برنامه نویسی کنترلر ربات اسکارا

150

این شرط بررس ی می کند که آیا runPosition فعال است یعنی برابر با true است یا خیر. اگر این
شرط برقرار باشد، به این معناست که ربات در حال اجرای برنامه است و دستور توقف برا ی وب سرور ارسال خواهد شد.
HAL_UART_Transmit_IT | تابع | طریق | از Positions Pause | پیغام | ارسال |

اگر runPosition فعال باشد، این خط از تابع IT_Transmit_UART_HAL برای ارسال پیام "n\Pause Positions "از طر یق UART استفاده می کند . پارامترهای ورودی شامل کانال پورت سریال، رشته "n\Pause Positions "و طول رشته " n\Pause Positions "که شامل 15 کاراکتر و یک کاراکتر پایان خط است که در مجموع 16 بایت طول دارد.

- غیرفعال کردن runPosition و ریست کردن متغیر indexCodeState

در اینجا، مقدار runPosition به false تنظیم م ی شود که به معنای غیرفعال کردن حالت Position است. همچنین متغیر indexCodeState به صفر تنظیم می شود که نشان دهنده این است که برنامه ربات متوقف شده و در حالت اولیه قرار گرفته است.

- بررسی وضع یت runCode

اگر شرط runPosition برقرار نباشد، این شرط بررس ی م یکند که آیا runCode فعال است یعنی برابر با true است یا خیر. اگر ا ین شرط برقرار باشد، به این معناست که ربات در حال اجرای برنامه می باشد و دستور توقف برای کدها ارسال خواهد شد.

فصل ششم: برنامه نویسی کنترلر ربات اسکارا

151

HAL_UART_Transmit_IT | تابع | طریق | از Code Pause | پیغام | ارسال |

اگر runCode فعال باشد، این خط از تابع IT_Transmit_UART_HAL برای ارسال پیام " Code n\Pause "از طریق UART استفاده می کند . پارامترهای ورود ی شامل کانال پورت سریال، رشته " Code n\Pause "و طول رشته "n\Pause Code "که شامل 10 کاراکتر و یک کاراکتر پایان خط است که در مجموع 11 بایت طول دارد.

- غیرفعال کردن runCode و ریست کردن متغیر indexCodeState

در اینجا، مقدار runCode به false تنظیم م ی شود که به معنای غیرفعال کردن حالت Code است. همچنین متغیر indexCodeState به صفر تنظیم می شود که نشان دهنده این است که برنامه ربات متوقف شده و در حالت اولیه قرار گرفته است.

.11-3-6 معرفی تابع sendClear این تابع برای ارسال پیغام پاکسازی یا Clear به وب سرور از طریق UART استفاده م ی شود. همچنین، این تابع متغیر PositionCounter را به صفر تنظ یم م ی کند تا تمام موقعیت های قبلی پاک شوند و شمارش از ابتدا شروع شود.

HAL_UART_Transmit_IT | طریق | از Positions Clear | پیغام | ارسال |

این خط از تابع IT_Transmit_UART_HAL برای ارسال پیام "n\Clear Positions "از طریق
UART استفاده م ی کند . پارامترهای ورود ی شامل کانال پورت سریال، رشته "n\Clear Positions "و طول رشته "n\Clear Positions "که شامل 15 کاراکتر و یک کاراکتر پایان خط است که در مجموع 16 بایت طول دارد.
- ریست کردن شمارنده موقعیت

فصل ششم: برنامه نویسی کنترلر ربات اسکارا

152

این خط مقدار PositionCounter را به صفر تنظیم می کند . این عمل به معنای پاکسازی تمام موقعیت های ثبت شده و شروع شمارش از ابتدا است.

.12-3-6 معرفی تابع sendOk
این تابع برا ی ارسال یک پیام "Ok "به وب سرور از طریق UART استفاده می شود. این پیام تاییدیه اتمام اجرای تمام موقعیت های ارسال شده از طرف وب سرور می باشد. ارسال این پیام با استفاده از واحد وقفه انجام می شود که به میکروکنترلر اجازه می دهد تا عملیات ارسال را بد ون بالک کردن پردازش های دیگر انجام دهد.

این خط از تابع IT_Transmit_UART_HAL برای ارسال پیام "n\Ok "از طریق UART استفاده
می کند . پارامترهای ورودی شامل کانال پورت سریال، رشته "n\Ok "و طول رشته " n\Ok "که شامل 2 کاراکتر و یک کاراکتر پایان خط است که در مجموع 3 بایت طول دارد.

.13-3-6 معرفی تابع sendSetting این تابع برا ی ارسال تنظیمات خاص به وب سرور از طریق UART استفاده می شود. این تابع یک پیغام فرمت دار ایجاد می کند که شامل شماره تنظیم ) setNum )و مقدار تنظیم )value )است و آنرا از طریق UART ارسال م ی کند . این تابع دارای دو پارامتر ورودی setNum و value از نوع int دارد.

- پاک کردن محتویات بافر

در اینجا از تابع memset برا ی پاک کردن محتویات buffer استفاده م ی شود و همه ی بایتهای آنرا
به صفر تنظیم م ی کند . حجم بافر 50 بایت است. اینکار به منظور اطمینان از اینکه بافر برای ذخیره سازی رشته جدید آماده باشد انجام می ش ود.
- فرمتدهی به رشته و ذخیره در بافر

این خط از تابع sprintf برا ی ایجاد یک رشته فرمتدار استفاده می کند و آن را در buffer ذخیره می کند . رشته تولید شده شامل اطالعات زیر می باشد.

فصل ششم: برنامه نویسی کنترلر ربات اسکارا

153

- متغیر setNum : شماره پارامتری که باید ارسال شود.
- متغیر value : مقدار پارامتری که باید ارسال شود.

به عنوان مثال، اگر 3 = setNum و 100 = value باشد، رشته تولید شده به شکل زیر خواهد بود.

Setting P3 = 100

- ارسال داده ها از طریق تابع IT_Transmit_UART_HAL

HAL_UART_Transmit_IT(&huart2, (uint8_t*)buffer, strlen(buffer)) ;

این خط از تابع IT_Transmit_UART_HAL برای ارسال داده های موجود در buffer از طریق UART استفاده م ی کند . پارامترهای ورود ی شامل کانال پورت سریال، بافر بسته اطالعاتی و طول بافر که با استفاده از تابع strlen محاسبه می شود.

.4-6 معرفی و بررسی کتابخانه Profile Motion

.5-6 معرفی و بررسی کتابخانه Setting Basic همانطور که قبال در بخش آموزش رابط کاربری کنترلر توضیح داده بودیم باید از چرخش روتاری انکودر برای افزایش و کاهش اعداد و از دکمه فشاری آن برای جابجا شدن بین ارقام استفاده می کردیم این تابع بدین منظور ایجاد شده است که پارامترهای عددی موجود در تنظیمات را کنترلر برای تنظیم مقادیر صحیح و اعشاری پارامترهای عددی مانند تنظیم سرعت و موقعیت این کتابخانه برای محاسبات مقادیر اعمال شده توسط هر پارامتر تنظیمات مثل پارامتر سرعت ایجاد شد است در این کتابخانه توابعی وجود دارد که با استفاده از آنها می توانید پارامتر های تنظیم عددی هر تنظیمات را انجام دهید.

.6-6 معرفی و بررسی کتابخانه Setting Advanced

.7-6 معرفی و بررسی کتابخانه Setting Program

.8-6 معرفی و بررسی کتابخانه Setting Homing

## 7 فصل هفتم: برنامه نویسی وب سرور کنترلر

فصل هفتم: برنامه نویسی وب سرور کنترلر

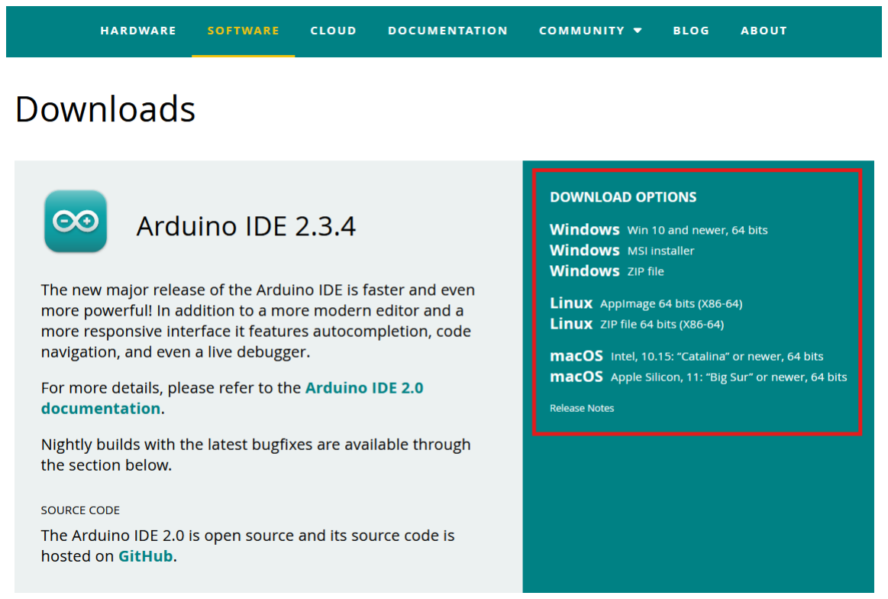
[picture p149: figure]

155

.1-7 پیکربندی ماژول 8266ESP در محیط IDE Arduino در مرحله اول باید آخرین نسخه IDE Arduino را بر رو ی کامپیوتر خود نصب کنید . می توانید از
طریق سایت cc.Arduino ، آخرین نسخه را متناسب با س یستم عامل خود دانلود کنید . کافی است در بخش Options Download ، س یستم عامل خود را انتخاب کنید و بر رو ی آن کلیک کنید .

شکل -7 -1 نصب آخرین نسخه IDE Arduino

پس از نصب آخرین نسخه آردوینو، برای شروع، باید قسمت manager board را با یک URL خاص
آپد یت کنید . نرم افزار آردوینو را باز کرده و مسیر Preferences > File را دنبال کنید . سپس URL زیر را در قسمت URLs Manager Board Additional در پایین صفحه وارد کنید .

http://arduino.esp8266.com/stable/package_esp8266com_index.json

فصل هفتم: برنامه نویسی وب سرور کنترلر

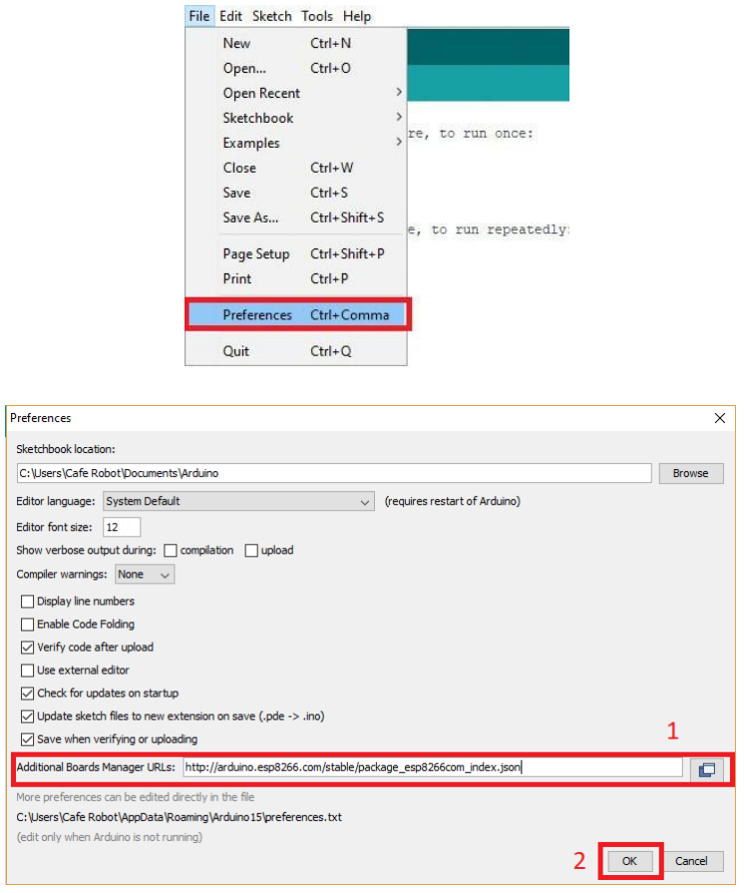
[picture p150: figure]

156

شکل -7 -2 جایگذاری URL ماژول 8266ESP در تنظیمات Preferences

سپس، گزینه ی OK را انتخاب کنید . پس از آن، از مسیر Manager Boards > Boards > Tools قسمت Manager Boards را باز کنید . اکنون باید گزینه های جد یدی به بردهای استاندارد آردوینو اضافه شده باشد. به همین دلیل، با نوشتن عبارت 8266ESP ، جستجوی خود را محدود کنید . در نهایت، بر روی نتیجه ی ظاهر شده مانند شکل 3-7 کل یک کرده و install را بزنید .

فصل هفتم: برنامه نویسی وب سرور کنترلر

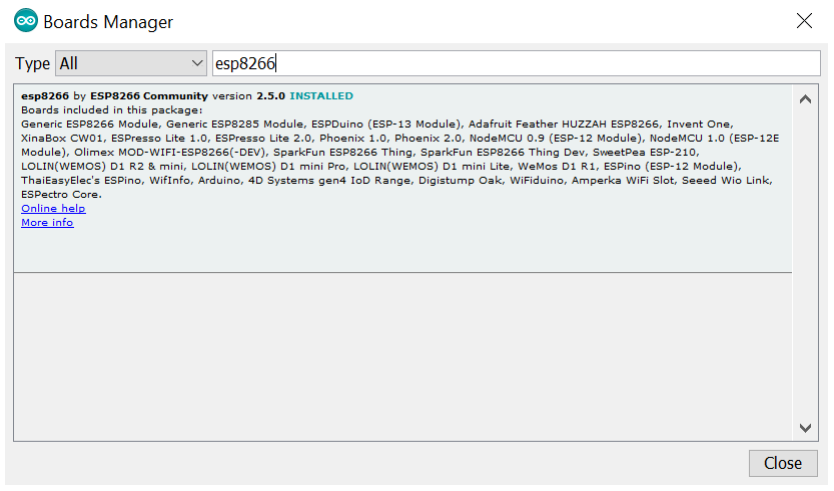
[picture p151: figure]
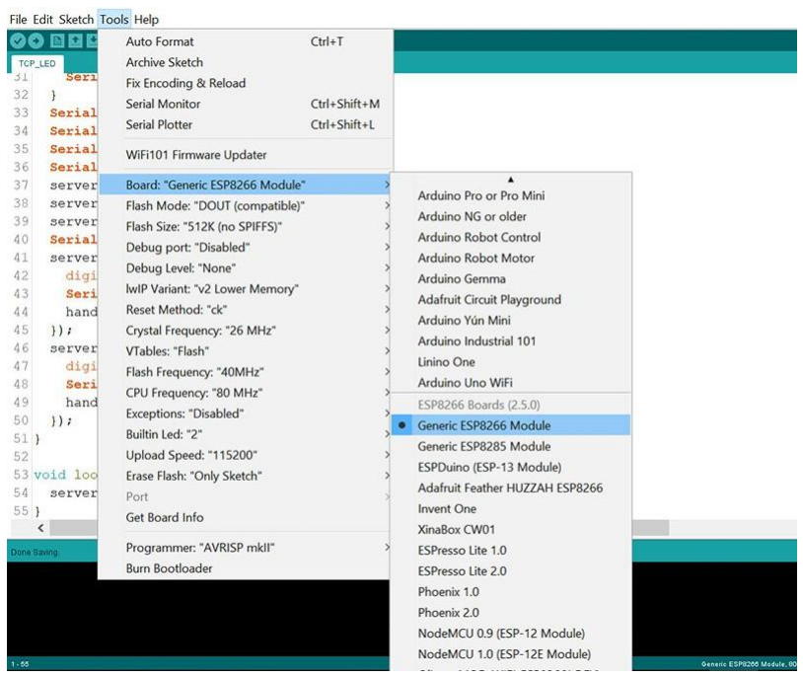
[picture p152: figure]

157

شکل -7 -3 نصب کتابخانه 8266ESP در محیط IDE Arduino

زمانی که نصب به پایان رس ید می توانید Manager Board را ببند ید . سپس برای آپلود کد و اجرای
آن باید از روشی که در فصل قبل در بخش معرفی ماژول 8266ESP توضیح داده شد برای پروگرام کردن ماژول استفاده نمایید. اما قبل از آن باید مطمئن شوید که برد 8266ESP در نرم افزار آردوینو به درست ی انتخاب شده باشد. برای اینکار به مسیر Board > Tools رفته و سپس مدل برد خود را رو ی Generic Module 8266ESP قرار ده ید . )دقت کنید که Speed Upload روی 115200 باشد(

شکل -7 -4 انتخاب نوع ماژول 8266ESP برای آپلود و اجرای کد

فصل هفتم: برنامه نویسی وب سرور کنترلر

158

.2-7 معرفی و بررسی کدهای آردوینو برای شروع برنامه نویسی در محیط آردوینو ، اول ین قدم شناخت کامل ساختار محیط برنامه نویسی است. ساختار محیط برنامه نویسی آردوینو از دو تابع اصلی تشکیل می شود که با هر بار ورود به نرم افزار آردوینو و ایجاد یک تب جد ید برای شروع برنامه نویسی با آنها مواجه خواهید شد .

.1-2-7 معرفی تابع setup

void setup() {
// put your setup code here, to run once
}

این تابع یکی از اساس ی ترین بخش های برنامه نویسی در آردوینو است که هنگام راه اندازی برد اجرا
شده و وظایف مختلفی را برا ی مقداردهی اولیه س یستم انجام می دهد . این وظایف شامل مقدارده ی اول یه پورت سریال، حافظه EEPROM ، س یستم فایل، راه انداز ی وا ی فای و تنظ یمات مربوط به سرور وب است.
- مقداردهی اول یه پورت سر یال

Serial.begin(115200);

1 | این دستور پورت سریال را با نرخ انتقال داده
115200 بیت بر ثانیه مقدارده ی اولیه م یکند .
- مقداردهی اول یه حافظه EEPROM

EEPROM.begin(512);

دستور فوق حافظه EEPROM را با اندازه 512 بایت مقداردهی اولیه می کند . از EEPROM برای ذخیره تنظیمات و داده هایی که نیاز است پس از ریست شدن دستگاه باقی بمانند استفاده می شود.
- مقداردهی اول یه سیستم فایل LittleFS

LittleFS.begin();

این دستور س یستم فایل LittleFS را مقداردهی اولیه می کند . LittleFS ، امکان ذخیره سازی فایل ها
را در حافظه فلش ماژول 8266ESP فراهم می کند . از این س یستم فایل م ی توان برا ی ذخیره تنظیمات، صفحات وب و داده های دیگر استفاده کرد.

1 Baud Rate

فصل هفتم: برنامه نویسی وب سرور کنترلر

159

- راه اندازی نقطه دسترسی وای فای

WiFi.softAP(wifiSSID, wifiPassword); Serial.println(WiFi.softAPIP());

1 | در این بخش 8266ESP به عنوان یک نقطه دسترس ی
تنظیم م ی شود. متغیرهای wifiSSID و
wifiPassword ، نام و رمز عبور شبکه وای فای ایجادشده را تع یین می کنند . سپس آدرس IP این نقطه دسترس ی در پورت سریال نمایش داده می شود تا بتوان به آن متصل ش د .
- مقداردهی اول یه سرور وب و تنظیم مسیرها

webServer.on("/", handleRoot); webServer.on("/Send", handleSendDataRequest); webServer.on("/Receive", handleReceiveDataRequest); webServer.begin();

در این بخش، وب سرور داخل ی رو ی 8266ESP راه اندازی شده و مسیرهای زیر برا ی آن تعریف می شوند . "/" نمایش صفحه اصلی وب سرور "Send/ " ارسال داده ها به صفحه وب "Receive/ " دریافت دستورات از صفحه وب در پایان دستور ()begin.webServer ، وب سرور را راهاندازی م ی کند .

- مقداردهی اول یه تنظیمات پیش فرض و ذخیره در EEPROM

int defaultSettings[] = {500,0,2,500,2,500,2,500,2,300,200}; for (int i = 0; i < sizeof(defaultSettings); i++) { saveToEEPROM(i, defaultSettings[i]);
}
در این بخش، یک آرایه از تنظیمات پیشفرض تعریف شده و مقدار هر یک از عناصر آن در حافظه EEPROM ذخیره می شود. این کار باعث می شود که پس از ریست شدن دستگاه، تنظیمات اولیه بارگذار ی شوند .

1 Access Point

فصل هفتم: برنامه نویسی وب سرور کنترلر

160

.2-2-7 معرفی تابع loop

void loop() {
// put your main code here, to run repeatedly
}

این تابع یکی از اساس ی ترین بخش های برنامه نویسی در آردوینو است و بدون آن، تداخل در عملکرد میکروکنترلر ایجاد می کند . حتی اگر در این قسمت برنامه ای هم نوشته نشده باشد، نیاز به آن خواهد بود. در این تابع برنامه اصلی نوشته می شود و کدهای نوشته شده به صورت نامحدود تکرار می شوند .

- مدیریت درخواست های وب سرور

webServer.handleClient();

این خط وظیفه پردازش تمام درخواستهایی که از سمت کالینت )مرورگر یا سایر دستگاهها( ارسال
می شوند را بر عهده دارد. هر بار که تابع loop اجرا می شود، بررس ی می کند که آیا درخواستی از کالینت دریافت شده است یا خیر. در صورت دریافت درخواست، آنرا پردازش کرده و پاسخ مناسب را ارسال می کند .
- بررسی ورودی های دریافتی از پورت سر یال

if (Serial.available() > 0)

این شرط بررس ی می کند که آیا داده ای از طریق پورت سر یال دریافت شده است یا خیر. اگر مقدار ()available.Serial بیشتر از صفر باشد، یعنی داده ای از طریق پورت سریال وارد شده است و می توان آن را خواند .

- خواندن داده های سریال و ذخیره آن در serialBuffer

serialByte = Serial.read();
serialBuffer += serialByte;

دستور ()read.Serial ، یک کاراکتر را از ورود ی سریال خوانده و در متغیر serialByte ذخیره می کند و در خط بعدی به انتهای serialBuffer اضافه می کند تا داده ها به صورت یک رشته کامل ذخیره شوند .

فصل هفتم: برنامه نویسی وب سرور کنترلر

161

- شناسایی انتهای داده در یافتی از سر یال و آماده ساز ی برای پردازش

if (serialByte == '\n')

هنگامی که serialByte برابر با 'n( '\کاراکتر پایان خط( باشد، یعنی یک دستور کامل از طریق سریال دریافت شده است. در این لحظه برنامه آماده پردازش این داده می شود.

- ذخیره دستور دریافتی و ارسال برای پردازش

webCommand = serialBuffer; processIncomingSerialData(serialBuffer);

مقدار serialBuffer( که حاوی داده ی کامل دریافتی است( در webCommand ذخیره می شود
تا یک نسخه از آن برای صفحه وب ارسال شود. سپس تابع processIncomingSerialData فراخوانی می شود تا داده های دریافتی در این تابع پردازش شده و اقدامات مناسب بر رو ی تابع های دریافتی انجام شود.
- پاک کردن بافر سریال

serialBuffer = "";

پس از پردازش داده ی دریافتی، بافر سریال خالی م ی شود تا برای دریافت داده های جد ید آماده باشد .

- مدیریت حافظه و جلوگیری از سر ر یز شدن بافر

trimDataBuffer();

1 | این تابع اضافه بار
احتمالی در بافر سریال را کنترل م ی کند . در صورتی که بافر سریال بیش از حد
طوالنی شود، بخش های قد یمی آن حذف می شوند تا از اشغال غیر ضروری حافظه جلوگیری شود.
- افزودن یک تأخ یر کوتاه برای بهبود پایداری برنامه

delay(10);
این تأخیر کوچک )10 میلی ثانیه( باعث کاهش بار پردازش ی پردازنده می شود. از دریافت داده های بیش از حد سریع جلوگیری کرده و به پردازش سریال زمان کافی م ی دهد .

1 Overflow

فصل هفتم: برنامه نویسی وب سرور کنترلر

162

.3-2-7 معرفی تابع processIncomingSerialData

// Process incoming serial data
void processIncomingSerialData(String Data);

این تابع وظیفه پردازش داده های دریافتی از پورت سریال را دارد و مشخص می کند که داده ورود ی مربوط به کدام بخش از برنامه است. بسته به نوع داده دریافتشده، یکی از توابع پردازشگر مناسب فراخوانی می شود.

- بررسی داده ورودی با آرگومان "Code"

if (Data.indexOf("Code") != -1) { handleCode(Data);
}

اگر این مقدار در داده ورودی وجود داشته باشد، تابع handleCode اجرا می شود.

- بررسی داده ورودی با آرگومان "Positions"

else if (Data.indexOf("Positions") != -1) { handlePositions(Data);
}

اگر مقدار "Positions "در داده ورود ی یافت شود، تابع handlePositions اجرا می شود.

- بررسی داده ورودی با آرگومان "Setting"

else if (Data.indexOf("Setting") != -1) { handleSetting(Data);
}

در صورت وجود "Setting "در داده، تابع handleSetting فراخوانی شده و تنظ یمات مربوطه اعمال می شوند .

فصل هفتم: برنامه نویسی وب سرور کنترلر

163

- بررسی داده ورودی با آرگومان "Ok"

else if (Data.indexOf("Ok") != -1) { processOkCommand();
}

در این حالت، تابع processOkCommand اجرا شده و دستور "Ok "پردازش می شود.

.4-2-7 معرفی تابع processOkCommand

// Process the "Ok" command
void processOkCommand();

این تابع بطور خاص برا ی مد یریت پیامهای "Ok "از سمت کنترلر طراحی شده است. وظیفه آن بررس ی وضعیت حرکت س یستم است و اقدام مناسب را بر اساس اینکه حرکت با استفاده از موقعیت های ذخیره شده یا با اس تفاده از کدهای حرکتی انجام م ی شود، انجام م ی دهد .

- بررسی حرکت با موقعیت های ذخیره شده

if (movingByPosition == true)

این بخش بررس ی می کند که آیا س یستم در حال حرکت با استفاده از موقعیت های ذخیرهشده است
یا خیر. اگر متغیر movingByPosition مقدار true داشته باشد، یعنی حرکت با موقعیت ها درحال انجام است.
- ارسال موقعیت ها به کنترلر

if (sendPositionCount < PositionCount) { sendPositionCount++;
sendPositionToController(sendPositionCount);
}

در صورتیکه حرکت با موقعیتها فعال باشد، این قسمت از کد بررس ی م ی کند که آیا تعداد موقعیت
های ارسالشده کمتر از تعداد کل موقعیت های ذخیره شده )PositionCount )است یا خیر. اگر هنوز موقعیت های بیشتری برای ارسال وجود داشته باشد، موقع یت بعد ی به کنترلر ارسال م یشود.

فصل هفتم: برنامه نویسی وب سرور کنترلر

164

- پایان حرکت با مختصات و ارسال پیام پا یان

else {
movingByPosition = false;
sendPositionCount = 1;
webCommand = "End positions move"; if (Serial) {
Serial.println("End");
}
}

اگر تمام موقعیت ها ارسال شده باشند، حرکت با موقعیت ها به پایان می رسد . در این صورت، متغیر movingByPosition به false تغییر داده می شود و شمارنده موقعیت های ارسال شده به مقدار اول یه 1 باز می گردد. سپس پیام "move positions End "به متغیر webCommand اختصاص دا ده می شود تا به صفحه وب ارسال شود و همچنین پیامی از نوع "End "به پورت سریال نیز ارسال می شود.

- بررسی حرکت با کدهای حرکتی

1

if (movingByCode == true)

در این بخش بررس ی می شود که آیا س یستم در حال حرکت با استفاده از دستورات کد است یا خیر.
اگر متغیر movingByCode مقدار true داشته باشد، یعنی س یستم در حال حرکت با کد است.
- ارسال خطوط کد به کنترلر

if (sendCodeCount < codeLineIndex) { sendCodeCount++;
sendCodeToController(sendCodeCount);
}

اگر حرکت با کدهای حرکتی فعال باشد، این قسمت از کد بررس ی می کند که آ یا هنوز خطوط کد بیشتری برای ارسال وجود دارد یا خیر. اگر تعداد خطوط ارسال شده کمتر از تعداد کل خطوط کد )codeLineIndex )باشد، خط کد بعد ی به کنترلر ارسال می شود.

1 Gcode

فصل هفتم: برنامه نویسی وب سرور کنترلر

165

- پایان حرکت با کد و ارسال پیام پایان

else {
movingByCode = false;
sendCodeCount = 1;
webCommand = "End code move"; if (Serial) {
Serial.println("End");
}
}

اگر تمام خطوط کد ارسال شده باشند، حرکت با کدها ی حرکتی به پایان می رسد . در این حالت، متغیر movingByCode به false تغییر داده می شود و شمارنده خطوط کد به مقدار اولیه 1 باز می گردد. همچنین پیام "move code End "به متغیر webCommand اختصاص داده می شود و پیامی از نوع "End "به پورت سریال ارسال می شود.

.5-2-7 معرفی تابع trimDataBuffer

// Trim unnecessary data from the input buffer
void trimDataBuffer();

این تابع برا ی محدود کردن طول داده های ذخیره شده در بافر سریال استفاده می شود. در ادامه بخش های مختلف این تابع را بررسی خواهیم کرد.

- بررسی طول بافر سریال

if (serialBuffer.length() > 200)

این شرط بررس ی می کند که آیا طول بافر سریال بیشتر از 200 کاراکتر است یا نه. اگر مقدار داده ها در این بافر بیش از 200 کاراکتر باشد، نیاز به حذف داده های اضافی داریم.

- حذف داده های اضافی از ابتدای بافر

serialBuffer.remove(0, serialBuffer.length() - 200);

این خط از کد، متد remove را روی serialBuffer فراخوانی می کند . این متد دو آرگومان دریافت م ی کند :

فصل هفتم: برنامه نویسی وب سرور کنترلر

166

آرگومان اول مشخص می کند که حذف داده ها از ابتدا ی رشته )serialBuffer )آغاز شود. آرگومان دوم مشخص می کند که چند کاراکتر باید حذف شود. مقدار آن برابر است با تعداد کاراکترهای اضافی )طول کلی منهای 200 کاراکتر آخر(. به این ترتیب، اگر بافر سریال مثالً 250 کاراکتر داشته باشد، مقدار 50 از ابتدای رشته حذف می شود و فقط 200 کاراکتر آخر باق ی م ی مانند .

.6-2-7 معرفی تابع handleReceiveDataRequest

// Handle incoming data request from the web server
void handleReceiveDataRequest();

این تابع مسئول پردازش درخواستهای دریافتی از کالینت )صفحه وب( است و بر اساس نوع داده ارسالشده، اقدامات مختلفی انجام می دهد . ماژول 8266ESP می تواند داده هایی مانند دستورات کنترلی، موقعیت ها، تنظیمات و پیام های خاص از رابط کاربری دریافت کند و بر اساس آن ها پاسخ مناسب به کنترلر و صفحه وب ارسال کند .

- تنظیم هدر CORS برا ی ارتباط از منابع مختلف

webServer.sendHeader("Access-Control-Allow-Origin", "*");

این خط باعث می شود که درخواستهای ارسالشده از دامنه های مختلف )CORS )مجاز باشند . این کار مخصوصاً زمانی که کالینتی از یک دامنه دیگر داده ارسال می کند ، مفید است.

- پردازش درخواست با آرگومان "code"

if (webServer.hasArg("code")) {
String codeCom = webServer.arg("code");
}

بررسی می کند که آیا درخواست شامل پارامتر "code "است یا خیر. درصورت وجود درخواست را دریافت و در متغیر codeCom ذخیره م ی کند .

فصل هفتم: برنامه نویسی وب سرور کنترلر

167

- کنترل دستورات مربوط به "code"

if (codeCom.indexOf("Pause") != -1) { if (Serial) {
Serial.println("Code Pause");
}
}
else if (codeCom.indexOf("pBack") != -1) { if (Serial) {
Serial.println("Code pBack");
}
}
بررسی می کند که آیا مقدار codeCom شامل پارامتر "Pause "یا "pBack "است:
- اگر مقدار "Pause "باشد، "Pause Code "را در پورت سریال چاپ می کند .
- اگر مقدار "pBack "باشد، "pBack Code "را در پورت سریال چاپ می کند .
- فراخوانی تابع در یافت و ذخیره کدهای حرکتی

if (codeCom.indexOf("EndSendingCode") != -1) { webCommand = "End";
}
else {
handleCode(codeCom);
}

این شرط کدهای حرکتی دریافتی از صفحه وب را به تابع handleCode هدایت می کند و زمانی
که دستور "EndSendingCode( "پایان ارسال کدهای حرکتی( از طرف صفحه وب ارسال شد مقدار webCommand را برابر با "End "می کند یا به عبارت د یگه دستور "End "را به صفحه وب ارسال می کند . این پیام برای تایید عملکرد ماژول 8266ESP در صفحه وب کاربرد دارد.
- پردازش درخواست های با آرگومان "Positions"

else if (webServer.hasArg("Positions")) {
String positionCom = webServer.arg("Positions");
}

بررسی می کند که آیا درخواست شامل پارامتر "Positions "است یا خیر. درصورت وجود درخواست را دریافت و در متغیر positionCom ذخیره می کند .

فصل هفتم: برنامه نویسی وب سرور کنترلر

168

- کنترل دستورات مربوط به "Positions"

if (positionCom.indexOf("Clear") != -1) { if (Serial) {
Serial.println("Positions Clear");
}
}
else if (positionCom.indexOf("Pause") != -1) { if (Serial) {
Serial.println("Positions Pause");
}
}
else if (positionCom.indexOf("pBack") != -1) { if (Serial) {
Serial.println("Positions pBack");
}
}

مشابه بخش code ، بررس ی می شود که آ یا دستورات خاصی )مانند Clear ، Pause ، pBack )در مقدار "Positions "وجود دارد یا خیر. درصورتی هرکدام از این دستورات وجود داشت، دستور مربوطه را برای کنترلر از طریق پورت سریال ارسال می کند .

- فراخوانی تابع پردازش موقعیت ها

handlePositions(positionCom);

مقدار دریافت شده پردازش شده و در نهایت به تابع handlePositions ارسال می شود.

- پردازش درخواست با آرگومان "move"

else if (webServer.hasArg("move")) { String moveCom = webServer.arg("move"); if (Serial) {
Serial.println("Move = " + moveCom);
}
}
بررسی می کند که آیا درخواست شامل پارامتر "move "است یا خیر. درصورت وجود، داده های ارسال شده را دریافت و در متغیر moveCom ذخیره م ی کند . سپس مقدار moveCom را برای کنترلر از طریق سریال ارسال م ی کند .

فصل هفتم: برنامه نویسی وب سرور کنترلر

169

- پردازش درخواست با آرگومان "setting"

else if (webServer.hasArg("setting")) { String settingCom = webServer.arg("setting");

handleSetting(settingCom);
if (Serial) {
Serial.println(settingCom); }
}

بررسی می کند که آ یا درخواست شامل پارامتر "setting "است یا خیر. درصورت وجود، داده های دریافتی را داخل متغیر settingCom ذخیره م ی کند و تابع handleSetting را فراخوانی می کند . سپس یک نسخه از داده های دریافتی را نیز توسط سریال برای کنترلر ارسال می کند .

- پردازش درخواست با آرگومان "BackEnd"

else if (webServer.hasArg("BackEnd")) { String backEndCom = webServer.arg("BackEnd");

if (backEndCom.indexOf("Refresh") != -1) { isResendSettingActive = true;
}
}

بررسی می کند که آ یا درخواست شامل پارامتر "BackEnd "است یا خیر. درصورت وجود، داده های دریافتی را در متغیر backEndCom ذخیره می کند . اگر در داده های دریافتی پارامتر "Refresh "وجود داشته باشد متغیر isResendSettingActive فعال می شود.

- مدیریت درخواست های نامعتبر

else {
webServer.send(400, "text/plain", "No command received."); }

در طول اجرای تابع، ابتدا بررس ی می شود که آیا درخواست دریافتی شامل یکی از پارامتر

های "code "،" Positions "،" move "،" setting "یا "BackEnd "هست یا خیر. اگر هیچ
یک از این پارامترها در درخواست موجود نباشد، برنامه وارد این بخش م ی شود.

فصل هفتم: برنامه نویسی وب سرور کنترلر

170

در این بخش، سرور یک پاسخ HTTP با کد خطای 400 و متن ".received command No"
به کال ینت ارسال می کند . این مقدار نشان می دهد که درخواست کالینت نامعتبر بوده است و شامل هیچ یک از پارامترهای شناخته شده برای سرور نیست.

.7-2-7 معرفی تابع handleSendDataRequest

// Handle sending data to the web server
void handleSendDataRequest();

این تابع مسئول ارسال داده ها از سرور )ماژول 8266ESP )به کالینت )صفحه وب( است. داده های ارسالی شامل اطالعاتی هستند که باید در پاسخ به درخواستهای کالینت ارسال شوند .

- ارسال هدر برا ی اجازه دسترسی از منابع دیگر )CORS)

webServer.sendHeader("Access-Control-Allow-Origin", "*");

این خط هدر CORS را تنظ یم م ی کند تا اجازه دسترس ی به سرور از هر دامنه ای )"*"( را بدهد .
این کار معموالً برای ارتباط ب ین کالینت های مختلف )مثال مرورگر و سرور( انجام می شود.
- بررسی نیاز صفحه وب به بازیابی یا ارسال مجدد تنظ یمات یا موقعیت های ذخ یره شده

if (isResendSettingActive) {
webCommand = getResentSettingData();
}
else if (isResendPositionActive) { webCommand = getResentPositionsData();
}

این بخش بررس ی می کند که آیا باید داده های تنظیمات یا موقعیت های ذخیره شده در ماژول
1 | 8266ESP را به صفحه وب ارسال کند یا خیر. درصورت تازه سازی
صفحه وب عمل بازیابی تنظیمات و
موقعیت ها مورد نیاز است.
اگر isResendSettingActive فعال باشد )صفحه وب نیاز به بازیابی تنظیمات داشته باشد(، مقدار webCommand برابر با خروجی تابع getResentSettingData می شود تا تنظیمات به صفحه وب ارسال شود.

1 Refresh

فصل هفتم: برنامه نویسی وب سرور کنترلر

171

اگر isResendPositionActive فعال باشد )صفحه وب ن یاز به بازیابی موقع یت ها داشته باشد( مقدار webCommand برابر با خروجی تابع getResentPositionsData می شود تا موقعیت ها به صفحه وب ارسال شود.

- ارسال پاسخ به صفحه وب و برسی عدم تکرار در ارسال

if (lastSentData != webCommand || webCommand == "End code move" || webCommand == "End positions move" || webCommand == "End") { lastSentData = webCommand;
webServer.send(200, "text/plain", webCommand);
webCommand = " ";
}
else {
webServer.send(200, "text/plain", " ");
}

اگر مقدار جد ید webCommand با مقدار آخرین داده ارسالشده )lastSentData )متفاوت باشد

یا مقدار خاصی مثل "move code End "یا "move positions End "یا "End "باشد :
مقدار lastSentData برابر با webCommand قرار م یگیرد. )برا ی برس ی عدم تکرار در ارسال داده( و مقدار webCommand به کالینت )صفحه وب( ارسال می شود. سپس مقدار webCommand پاک می شود. اگر هیچ تغییری در داده ها رخ نداده باشد رشته خالی به صفحه وب ارسال م یشود.

.8-2-7 معرفی تابع handleCode

// Process the Code command
void handleCode(String codeData);

این تابع مسئول پردازش دستورات حرکت ی دریافتی از سمت کالینت )صفحه وب( یا کنترلر است.

- بررسی دستور "Run( "اجرای حرکت(

if (codeData.indexOf("Run") != -1) {
if (codeLineIndex > 0 && movingByCode != true) { movingByCode = true;
sendCodeToController(sendCodeCount);
}
}

فصل هفتم: برنامه نویسی وب سرور کنترلر

172

اگر دستور "Run "در codeData وجود داشته باشد، همچنین اگر داده ای )کد حرکت ی( برای اجرا وجود داشته باشد )0 < codeLineIndex )و آیا اگر در حال حاضر حرکتی در حال اجرا نباشد

)true != movingByCode )در این صورت، حالت حرکت فعال می شود ) = movingByCode
true )و اولین دستور حرکت ی به کنترلر ارسال م ی شود. )تابع sendCodeToController فراخوانی می شود(
- بررسی دستور "Pause( "مکث یا توقف حرکت(

else if (codeData.indexOf("Pause") != -1) { movingByCode = false;
}

اگر دستور "Pause "در codeData وجود داشته باشد، متغیر movingByCode مقدار false
می گیرد. این باعث می شود حرکت متوقف شود بدون اینکه داده های حرکتی فراموش یا پاک شوند .
- بررسی دستور "pBack( "بازگشت به اولین گام(

else if (codeData.indexOf("pBack") != -1) { movingByCode = false;
sendCodeCount = 1;
}

اگر دستور "pBack "در codeData وجود داشته باشد، متغیر movingByCode غ یرفعال شده
و مقدار sendCodeCount برابر 1 می شود. بدین ترتیب حرکت متوقف شده و برنامه حرکت از سر گرفته می شود.
- بررسی دستور "Send( "ارسال داده های حرکتی به ماژول 8266ESP )

else if (codeData.indexOf("Send") != -1) { webCommand = "Send";
}

اگر دستور "Send "در codeData وجود داشته باشد، مقدار webCommand برابر "Send "قرار می گیرد تا به صفحه وب اطالع داده شود که ارسال داده ها در حال انجام است.

فصل هفتم: برنامه نویسی وب سرور کنترلر

173

- بررسی دستور "Clear( "پاک کردن داده های حرکتی(

else if (codeData.indexOf("Clear") != -1) { codeLineIndex = 0;
sendCodeCount = 1;
movingByCode = false;
for (int i = 0; i <= 1500; i++) { CodeX[i] = NAN;
CodeY[i] = NAN;
CodeZ[i] = NAN;
}
}

اگر دستور "Clear "در codeData وجود داشته باشد، مقدار codeLineIndex صفر شده و شمارنده sendCodeCount روی مقدار اولیه )1( تنظیم م ی شود. اگر حرکت با کدها فعال باشد آن را غیرفعال می کند . )false = movingByCode )همچنین آرایه های CodeX ، CodeY و CodeZ پاک می شوند و مقدار NAN می گیرند . این دستور برای پاک سازی کامل داده های حرکتی ذخیره شده استفاده می شود.

- پردازش داده های حرکتی

else {
codeLineIndex = extractValueFromCode(codeData, "("); CodeX[codeLineIndex] = extractValueFromCode(codeData, "X"); CodeY[codeLineIndex] = extractValueFromCode(codeData, "Y"); CodeZ[codeLineIndex] = extractValueFromCode(codeData, "Z"); }

اگر codeData هیچ کدام از دستورات باال را شامل نشود، فرض می شود که یک دستور حرکتی
جد ید دریافت شده است. مقدار codeLineIndex از کد استخراج شده و مختصات X ، Y و Z در آرایه های مربوطه ذخیره می شوند . این مختصات بعداً برا ی اجرای حرکت پردازش خواهند شد .

فصل هفتم: برنامه نویسی وب سرور کنترلر

174

.9-2-7 معرفی تابع handlePositions

// Process the Position command (includes movement and delays) void handlePositions(String PositionData);

این تابع وظیفه پردازش و مد یریت داده های موقع یتی دریافتشده از صفحه وب و کنترلر را بر عهده دارد. این تابع بررس ی می کند که آیا دستور خاصی )مانند اجرای حرکت، توقف، پاک سازی داده ها و غیره ( در داده های دریافتشده وجود دارد و سپس اقدامات الزم را انجام م ی دهد .

- بررسی دستور Run( اجرا ی حرکت(

if (PositionData.indexOf("Run") != -1) {
if (PositionCount > 0 && movingByPosition != true) { movingByPosition = true;
sendPositionToController(sendPositionCount);
}
}

اگر داده های ورود ی )PositionData )شامل دستور"Run "باشد، موقعیتی برا ی اجرا موجود باشد )0<PositionCount )و فرآیند حرکت موقعیت ها در حال اجرا نباشد ، ) movingByPosition true )!= مقدار movingByPosition به true تغییر می یابد )فعال ساز ی حرکت بر اساس موقعیت ها( سپس اولین موقع یت برای اجرا به کنترلر ارسال می شود. این مکانیزم اجازه می دهد که حرکت از اولین موقعیت ثبت شده آغاز گردد، مشروط بر آنکه موقع یتی برای اجرا موجود باشد.

- بررسی و اجرا ی دستور "Pause( "مکث یا توقف حرکت(

else if (PositionData.indexOf("Pause") != -1) { movingByPosition = false;
}

اگر دستور "Pause "در داده های دریافتی موجود باشد، مقدار movingByPosition برابر false قرار می گیرد. این عملیات باعث توقف حرکت جاری می شود، اما داده های مربوط به موقعیت های ذخیره شده پاک نخواهند شد . به محض دریافت دستور "Run "مجدداً اجرا ی حرکت از موقعیت فعلی ادامه خواهد یافت.

فصل هفتم: برنامه نویسی وب سرور کنترلر

175

- بررسی و اجرا ی دستور "pBack( "بازگشت به اول ین موقعیت(

else if (PositionData.indexOf("pBack") != -1) { movingByPosition = false;
sendPositionCount = 1;
}

اگر دستور "pBack "در داده های دریافتی موجود باشد، مقدار movingByPosition برابر false شده و مقدار sendPositionCount به 1 تغ ییر می یابد . این فرمان حرکت را متوقف کرده و شمارنده موقعیت را به مقدار اول یه تنظیم می کند . در نتیجه در اجرای بعد ی، س یستم حرکت را از اولین موقعیت ذخیره شده مجدداً آغاز خواهد کرد.

- بررسی و اجرا ی دستور "Clear( "پاک سازی داده های موقعیت(

else if (PositionData.indexOf("Clear") != -1) { PositionCount = 0;
sendPositionCount = 1;
movingByPosition = false;
for (int i = 0; i < 100; i++) { PositionsX[i] = NAN;
PositionsY[i] = NAN;
PositionsZ[i] = NAN;
PositionsDelay[i] = NAN;
}
}

اگر دستور "Clear "در داده های دریافتی موجود باشد، مقاد یر زیر تنظیم مجدد می شوند :
- 0 = PositionCount تعداد موقع یتهای ذخیره شده صفر می شود.
- 1 = sendPositionCount شمارنده ارسال موقعیت ها به مقدار اولیه تنظیم می شود.
- false = movingByPosition حرکت بر اساس موقعیت ها متوقف می شود.
- یک حلقه تمام مقادیر مربوط به مختصات موقعیت های ذخ یره شده را پاک م ی کند .

فصل هفتم: برنامه نویسی وب سرور کنترلر

176

- پردازش و ذخیره موقعیت های جدید

else {
PositionCount = extractValueFromCode(PositionData, "I"); PositionsX[PositionCount] = extractValueFromCode(PositionData, "X");
PositionsY[PositionCount] = extractValueFromCode(PositionData, "Y");
PositionsZ[PositionCount] = extractValueFromCode(PositionData, "Z");
PositionsDelay[PositionCount] = extractValueFromCode(PositionData, "T");
if (Serial) {
Serial.println("++");
}
}

اگر ورود ی دریافتی هیچ کدام از دستورات قبلی )Run ، Pause ، pBack و غیره( را شامل نشود،
س یستم فرض می کند که دادههای موقعیتی جد ید دریافت شدهاند . مقدار PositionCount از داده های ورودی استخراج شده و مختصات X ، Y و Z همراه با مقدار زمان تأخیر )T )در آرایه های مربوطه ذخیره می شود. در نهایت، یک پیام تأیید "++" از طریق پورت سریال ارسال م ی شود که نشان می دهد داده های جد ید با موفقیت ذخیره شده اند . این بخش مسئول دریافت و ثبت موقع یت های جد ید جهت اجرا در آینده است. همچنین با استفاده از تابع extractValueFromCode ، مختصات و اطالعات اضافی از داده های ورودی استخراج شده و در آرایه های مناسب ذخیره می شوند .

.10-2-7 معرفی تابع handleSetting

// Process the Setting command
void handleSetting(String settingData);

این تابع وظیفه پردازش داده های تنظیماتی دریافت شده را بر عهده دارد و این داده ها را در حافظه EEPROM ذخیره می کند .

- تعر یف متغیرهای محلی

int address;
int value;

فصل هفتم: برنامه نویسی وب سرور کنترلر

177

دو متغیر address و value از نوع int تعریف شده اند . متغیر address نشاندهنده آدرس حافظه EEPROM است که مقدار تنظیمی در آن ذخیره خواهد شد و متغیر value مقدار تنظیماتی است که از داده های ورود ی استخراج م ی شود و باید در EEPROM ذخیره گردد.

- استخراج آدرس و مقدار از settingData

address = extractValueFromCode(settingData, "P");
value = extractValueFromCode(settingData, "=");

از داده های تنظیماتی )settingData )مقدار مربوط به پارامتر "P "استخراج می شود و در متغیر address ذخیره می گردد. مقدار "P "معموالً نشاندهنده آدرس پارامتر تنظیمات است که باید مقدار تنظیمی با این آدرس داخل حافظه EEPROM ذخیره شود. مقدار موجود بعد از عالمت تساوی از داده های ورودی استخراج و در متغیر value ذخیره م ی شود. این مقدار نشاندهنده مقدار تنظیمی جد ید است که باید در س یستم اعمال با ادرس تایین شده در باال ذخیره گردد.

- ذخیره مقدار در EEPROM

saveToEEPROM(address, value);

تابع saveToEEPROM مسئول ذخیره داده ها در حافظه EEPROM مطابق با آدرس و مقدار تنظیمی که به آ ن ارسال م ی شود است.

.11-2-7 معرفی تابع sendPositionToController

// Send a Position to the Controller
void sendPositionToController(int lineIndex);

این تابع برای ارسال موقعیت های ذخیره شده به کنترلر استفاده می شود.

- تعر یف بافر برای ارسال داده ها

char sendBuffer[50];

یک آرایه از نوع char به نام sendBuffer با ظرفیت 50 کاراکتر تعریف شده است. این بافر برای فرمت بند ی و ذخیره داده های موقع یت قبل از ارسال به کنترلر استفاده می شود.

فصل هفتم: برنامه نویسی وب سرور کنترلر

178

- اعمال تأخ یر قبل از ارسال موقعیت )در صورت نیاز(

if (lineIndex > 0 && PositionsDelay[lineIndex] > 0) { delay(PositionsDelay[lineIndex - 1]);
}

اگر مقدار lineIndex بزرگتر از صفر باشد )یعنی حداقل یک موقعیت معتبر وجود داشته باشد( همچنین اگر مقدار تأخیر [lineIndex[PositionsDelay بزرگ تر از صفر باشد. )برای موقعیت مورد نظر تاخیر ثبت شده باشد(، تابع delay مقدار تأخ یر مشخص شده برای هر موقع یت را قبل از ارسال موقعیت بعد ی به کنترلر، اعمال می کند .

- فرمتبندی داده های موقعیت و ذخ یره در sendBuffer

sprintf(sendBuffer, "Position I%d = X%.2f Y%.2f Z%.2f", lineIndex, PositionsX[lineIndex], PositionsY[lineIndex], PositionsZ[lineIndex]);

مقادیر موقعیت مورد نظر برا ی ارسال در قالب یک رشته متنی توسط )sprintf )فرمتبند یشده
و در متغیر sendBuffer ذخیره می شوند .
- ارسال داده های موقعیت از طریق پورت سر یال

if (Serial) {
Serial.println(sendBuffer);
}

در صورت فعال بودن پورت سریال، مقدار ذخیره شده در sendBuffer به پورت سریال ارسال می شود.

.12-2-7 معرفی تابع sendCodeToController

// Send a Code line to the Controller
void sendCodeToController(int lineIndex);

این تابع وظیفه ارسال کدهای حرکتی به کنترلر اصلی را بر عهده دارد. این تابع از کدهای حرکتی ذخیره شده در آرایه های CodeX ، CodeY و CodeZ استفاده کرده و در قالب یک رشته فرمت بند ی شده، اطالعات را به پورت سریال ارسال می کند .

فصل هفتم: برنامه نویسی وب سرور کنترلر

179

- تعر یف بافر برای ذخ یره داده ها

char sendBuffer[100];
char tempBuffer[20];

sendBuffer یک آرایه 100 بایتی است که رشته نهایی ارسالی را در خود ذخیره می کند . tempBuffer یک آرایه موقت 20 بایتی است که برای ذخیره هر بخش از داده ها قبل از اضافه شدن به sendBuffer استفاده م ی شود.

- نوشتن شناسه خط )Index )در sendBuffer

int offset = snprintf(sendBuffer, sizeof(sendBuffer), "Code I%d=", lineIndex);

مقدار lineIndex که شماره خط دستورات حرکتی را نشان می دهد ، به صورت "=d%I Code"
در sendBuffer ذخیره م یشود. همچنین متغیر offset تعریف شده و تعداد کاراکترهایی که در sendBuffer ذخیره شده اند در آن قرار می گیرد.
- افزودن مقدار X به sendBuffer

if (!isnan(CodeX[lineIndex])) {
offset += snprintf(tempBuffer, sizeof(tempBuffer), " X%.2f", CodeX[lineIndex]);
strncat(sendBuffer, tempBuffer, sizeof(sendBuffer) - offset -1);
}

ابتدا بررس ی می شود که مقدار [lineIndex[CodeX نامعتبر )NaN )نباشد ، یعنی دارای مقدار باشد . اگر شرط برقرار بود مقدار X با دو رقم اعشار در tempBuffer ذخیره م ی شود. سپس تعداد کاراکتر های ایجاد شده در tempBuffer نیز به متغیر offset اضافه می شود. سپس مقدار tempBuffer به sendBuffer اضافه می شود.

فصل هفتم: برنامه نویسی وب سرور کنترلر

180

- افزودن مقدار Y به sendBuffer

if (!isnan(CodeY[lineIndex])) {
offset += snprintf(tempBuffer, sizeof(tempBuffer), " Y%.2f", CodeY[lineIndex]);
strncat(sendBuffer, tempBuffer, sizeof(sendBuffer) - offset -1);
}

مانند قسمت قبل ابتدا بررس ی می شود که مقدار [lineIndex[CodeY نامعتبر )NaN )نباشد ، یعنی دارا ی مقدار باشد . اگر شرط برقرار بود مقدار Y با دو رقم اعشار در tempBuffer ذخیره م ی شود. سپس تعداد کاراکتر های ایجاد شده در tempBuffer نیز به متغیر offset اضافه می شود. سپس مقدار

tempBuffer به sendBuffer اضافه می شود.

- افزودن مقدار Z به sendBuffer

if (!isnan(CodeZ[lineIndex])) {
snprintf(tempBuffer, sizeof(tempBuffer), " Z%.2f", CodeZ[lineIndex]);
strncat(sendBuffer, tempBuffer, sizeof(sendBuffer) - offset -1);
}
ابتدا بررس ی می شود که مقدار [lineIndex[CodeZ نامعتبر )NaN )نباشد یعنی دارای مقدار باشد . اگر شرط برقرار بود مقدار Z با دو رقم اعشار در tempBuffer ذخیره م ی شود . سپس تعداد کاراکتر های ایجاد شده در tempBuffer نیز به متغیر offset اضافه م ی شود . سپس مقدار tempBuffer به

sendBuffer اضافه می شود

- ارسال فرم آماده شده حرکتی از طر یق پورت سر یال برای کنترلر

if (Serial) {
Serial.println(sendBuffer);
}

اگر پورت سریال فعال باشد، مقدار نهایی sendBuffer برای کنترلر از طریق ارتباط سریال ارسال می شود.

فصل هفتم: برنامه نویسی وب سرور کنترلر

181

.13-2-7 معرفی تابع getResentSettingData

// Send data back to the web
String getResentSettingData();

این تابع وظیفه خواندن مقادیر تنظیمات ذخیره شده در EEPROM و ارسال آن ها به صفحه وب به صورت رشته فرمت بند ی شده را بر عهده دارد. این تابع معموال در راه انداز ی و یا بازیابی صفحه وب کاربرد دارد.

- تعر یف بافر برای ذخ یره داده های تنظیمات

char sendBuffer[40];

sendBuffer یک آرایه 40 بایتی از نوع char است که برا ی نگهداری رشته نهایی داده قبل از ارسال استفاده می شود. این بافر حداکثر 40 کاراکتر را می تواند در خود نگه دارد.

- خواندن تنظ یمات از EEPROM و قرار دادن آن در خروجی تابع

if (settingResendIndex < 11) {
settingResendIndex++;
sprintf(sendBuffer, "Setting P%d =%d \n", (settingResendIndex -1), readFromEEPROM(settingResendIndex - 1));
return sendBuffer;
}

بررسی م ی کند اگر مقدار settingResendIndex کوچکتر از 11 باشد . )یعنی هر 10 پارامتر تنظیمات ارسال شده باشند( مقدار settingResendIndex را یک واحد افزایش می دهد . همچنین مقدار ذخیره شده در EEPROM برای آدرس 1 - settingResendIndex خوانده شده و در قالب یک رشته فرمت بندی می شود. رشته تنظیمات ساخته شده در sendBuffer را به عنوان خروجی تابع بر می گرداند .

- بررسی اتمام ارسال تنظ یمات

else {
settingResendIndex = 0;
isResendSettingActive = false; isResendPositionActive = true; return " ";

فصل هفتم: برنامه نویسی وب سرور کنترلر

182

}
وقتی تمام تنظیمات ارسال شد )مقدار settingResendIndex به 11 برسد(:
- مقدار settingResendIndex ریست می شود تا در آینده مجدداً از ابتدا تنظیمات ارسال شوند .
- مقدار isResendSettingActive غیرفعال )false )م ی شود، به این معنی که فرایند ارسال مجدد تنظیمات به صفحه وب به پایان رس یده است.
- مقدار isResendPositionActive فعال )true )می شود، به این معن ی که پس از تنظیمات، ارسال مجدد موقعیت ها شروع شود.
- یک رشته خالی برم ی گرداند که نشاندهنده پایان ارسال داده های تنظیمات است.

.14-2-7 معرفی تابع getResentPositionsData

// Send data back to the web
String getResentPositionsData();

این تابع وظیفه ارسال مجدد موقعیت های ذخیره شده به صفحه وب را بر عهده دارد. این تابع معموالً در فرآیند بازیابی یا راه اندازی مجدد صفحه وب کاربرد دارد.

- تعر یف یک بافر برای ذخیره داده ها

char buffer[50];

یک آرایه 50 بایتی از نوع char با نام buffer تعر یف شده است که برای ذخیره اطالعات موقعیت های حرکتی قبل از ارسال استفاده می شود.

- بررسی مقدار PositionResendIndex و ارسال اطالعات موقعیت

if (PositionResendIndex < PositionCount) { PositionResendIndex++;
sprintf(buffer, "Positions I%d = X%.2f Y%.2f Z%.2f T%.2f\n", PositionResendIndex, PositionsX[PositionResendIndex], PositionsY[PositionResendIndex], PositionsZ[PositionResendIndex], PositionsDelay[PositionResendIndex]);
return buffer;
}

فصل هفتم: برنامه نویسی وب سرور کنترلر

183

بررسی می کند اگر مقدار PositionResendIndex کوچکتر از PositionCount باشد یعنی هنوز موقعیت هایی برای ارسال وجود داشته باشد ، ابتدا مقدار PositionResendIndex را یکی افزایش می دهد )به موقعیت بعد ی م یرود(. سپس رشته ای را با قالب مشخص شامل شماره موقعیت، مقادیر X ، Y ، Z و تأخیر T برای هر موقعیت تولید می کند . این رشته را به عنوان خروجی تابع با زم یگرداند .

- بررسی اتمام ارسال موقعیت ها

else {
PositionResendIndex = 0;
isResendPositionActive = false; return "Start";
}
اگر تمام موقع یتها ارسال شده باشند:
- مقدار PositionResendIndex ریست می شود تا در آینده دوباره از ابتدا ارسال انجام شود .
- مقدار isResendPositionActive غیرفعال )false )می شود، یعنی ارسال موقعیت ها متوقف می شود.
- مقدار "Start "را بر می گرداند که نشان دهنده شروع عملکرد صفحه وب می باشد .

.15-2-7 معرفی تابع extractValueFromCode

// Extract a numerical value from a Code & Positions string based on the given parameter
float extractValueFromCode(String Data, String parameter);
1 | این تابع برای استخراج مقدار عددی یک پارامتر مشخص از یک رشته
طراحی شده است. این تابع
معموالً در استخراج مقادیر موقعیت ها و کد های حرکت ی کاربرد دارد .
- دریافت ورودی ها
این تابع دو ورود ی دریافت م یکند : Data رشته ای که شامل داده های متنی دستور است. )مثالً 8.9Z 34.7Y 12.5X) parameter پارامتر ی که مقدار آن باید استخراج شود. )مثالً X ، Y ، Z )

1 String

فصل هفتم: برنامه نویسی وب سرور کنترلر

184

- جستجوی محل قرارگیری پارامتر در رشته

int index = Data.indexOf(parameter);

از دستور indexOf استفاده شده است تا محل اولین وقوع parameter در رشته Data پیدا شود. اگر parameter در Data وجود داشته باشد، index مکان اول ین کاراکتر پارامتر را ذخیره م ی کند .

- استخراج مقدار عدد ی بعد از پارامتر

if (index != -1) {
return Data.substring(index + 1).toFloat();
}

بررسی می شود اگر مقدار index معتبر باشد )-1 =!(، یعنی parameter در Data یافت شده باشد . ابتدا (1 + index(substring.Data بخشی از رشته را که شامل مقدار عددی بعد از پارامتر است جدا می کند . سپس مقدار جدا شده توسط دستور toFloat به عدد float تبد یل شده و باز گردانده می شود.

- اگر پارامتر مورد نظر در داده وجود نداشته باشد

return NAN;

اگر مقدار -1 == index باشد )یعنی parameter در Data وجود نداشته باشد(، تابع مقدار
NAN را باز می گرداند . مقدار (Number A Not (NAN نشان دهنده این است که مقدار مورد نظر یافت نشده یا نامعتبر است.

.16-2-7 معرفی تابع saveToEEPROM

// Save a value to EEPROM
void saveToEEPROM(int address, int value);

این تابع برای ذخیره مقدار تنظیمات )value )در آدرس مشخص ی از حافظه EEPROM طراحی
شده است. این تابع ابتدا مقدار موجود در EEPROM را بررس ی کرده و در صورتی که مقدار قبالً در همان آدرس ذخیره شده باشد، از نوشتن مجدد جلوگیری می کند . در غیر این صورت، مقدار جد ید را ذخیره می کند .

فصل هفتم: برنامه نویسی وب سرور کنترلر

185

- بررسی مقدار ذخیره شده در EEPROM

if (readFromEEPROM(address) == value) { return;
}

دستور readFromEEPROM مقدار ذخیره شده در آدرس مشخص شده را خوانده و با مقدار جد ید )value )مقایسه می کند . اگر مقدار جد ید برابر مقدار فعل ی در EEPROM باشد، تابع بالفاصله تمام می شود )return )و از نوشتن مجدد داده ها جلوگیری م ی شود.

- محاسبه آدرس نهایی در EEPROM

address = address * 2;

هر مقدار int در EEPROM دو بایت فضا اشغال می کند . برای جلوگ یری از هم پوشانی داده ها، هر
آدرس در EEPROM در 2 ضرب می شود تا مکان درستی برای ذخیره سازی مقدار int مشخص شود.
- نوشتن مقدار در حافظه EEPROM
EEPROM.write(address, value & 0xFF); | // LSB
EEPROM.write(address + 1, (value >> 8) & 0xFF); // MSB

حافظه EEPROM در ماژول 8266ESP به صورت بایت به بایت عمل می کند . چون int دارای 16 ب یت است، باید در دو آدرس جداگانه ذخیره شود. بایت کم ارزش (LSB (: xFF0 & value فقط 8 بیت پایینی (LSB (را استخراج و ذخیره می کند . بایت پر ارزش (MSB (: xFF0) & 8 >> value (مقدار value ، 8 بیت به راست شیفت داده شده تا فقط 8 بیت باالیی (MSB (باقی بماند و ذخیره شود.

جدول -6 -1 مقدار value و نحوه ذخیره سازی
| | مقدار (int (value مقدار LSB( 8 بیت پایین( مقدار MSB( 8 بیت باال(
0x04 (4) | 0x01 (1) | 1025 (0x0401)
0x01 (1) | 0x02 (2) | 258 (0x0102)

فصل هفتم: برنامه نویسی وب سرور کنترلر

186

- ذخیره سازی نهایی در EEPROM

EEPROM.commit();

در برخی از بردها مانند 8266ESP و 32ESP ، نوشتن در EEPROM بالفاصله ذخیره نمیشود و نیاز به فراخوانی دستور ()commit.EEPROM دارد تا تغییرات در حافظه دائمی ثبت شوند .

.17-2-7 معرفی تابع readFromEEPROM

// Read a value from EEPROM
int readFromEEPROM(int address);

این تابع برای خواندن یک مقدار صحیح )int )ذخیره شده در حافظه EEPROM استفاده م ی شود.

- محاسبه آدرس نهایی در EEPROM

address = address * 2;

همانطور که می دانید هر مقدار int ، دو بایت فضا اشغال می کند . از آنجایی که EEPROM داده ها
را به صورت بایت به بایت ذخیره می کند ، آدرس هر int باید در دو آدرس متوال ی قرار گیرد. برا ی دسترس ی به مقدار صحیح ذخیره شده، آدرس اولیه در 2 ضرب م ی شود تا مکان دقیق داده مشخص شود.

جدول -6 -2 نحوه تغییر آدرس

| مقدار address مقدار نهایی 2 × address
0 | 0
2 | 1
4 | 2
- خواندن دو بایت از EEPROM
int lowByte = EEPROM.read(address); | // LSB
int highByte = EEPROM.read(address + 1); // MSB

دستور (address(read.EEPROM مقدار ذخیره شده در آدرس مشخص شده را می خواند . مقدار
int در دو آدرس ذخیره شده است، بنابراین بایت اول )LSB - کم ارزش ترین بایت( از آدرس اولیه خوانده می شود. بایت دوم )MSB - پرارزش ترین بایت( از آدرس بعد ی خوانده می شود.

فصل هفتم: برنامه نویسی وب سرور کنترلر

187

- ترکیب دو بایت برای باز یابی مقدار int
return (highByte << 8) | lowByte;

در این قسمت مقدار highByte را 8 بیت به چپ ش یفت می دهد تا در جایگاه 8 ب یت باال قرار
بگ یرد. مقدار lowByte را با عملگر | )OR )به مقدار highByte اضافه م ی کند تا مقدار کامل int
بازسازی شود.

.18-2-7 معرفی تابع handleRoot

// Manage the Webserver home requests void handleRoot();

این تابع وظیفه مد یریت درخواستهای صفحه اصلی وب سرور را بر عهده دارد.

- بررسی وجود فایل در LittleFS

if (!LittleFS.exists("/index.html")) { webServer.send(404, "text/plain", "File not found"); Serial.println("File not found");
return;
}
تابع ("html.index/("exists.LittleFS بررس ی م ی کند که آیا فایل html.index در
س یستم فایل LittleFS موجود است یا نه. اگر فایل وجود نداشته باشد ، سرور پاسخ 404 )Found Not ) ارسال میکند و پیغام "found not File "در مانیتور سریال نمایش داده م ی شود. سپس تابع با return از اجرا خارج م ی شود.
- باز کردن و ارسال فایل

File file = LittleFS.open("/index.html", "r"); webServer.streamFile(file, "text/html");
file.close();

ابتدا فایل html.index برای خواندن "r "باز م یشود. سپس محتوای فایل از طریق

("html/text ",file(streamFile.webServer به کال ینت ارسال می شود. در نهایت، فایل با
()close.file بسته م ی شود تا منابع حافظه آزاد شوند .

فصل هفتم: برنامه نویسی وب سرور کنترلر

188

.3-7 معرفی و بررسی کدهای HTML

.4-7 معرفی و بررسی کدهای Script Java

.5-7 معرفی و بررسی کدهای CSS
