ALiReZa4232/SCARA-Robot-Controller/استپرموتور/IMG_20241102_085508.jpg

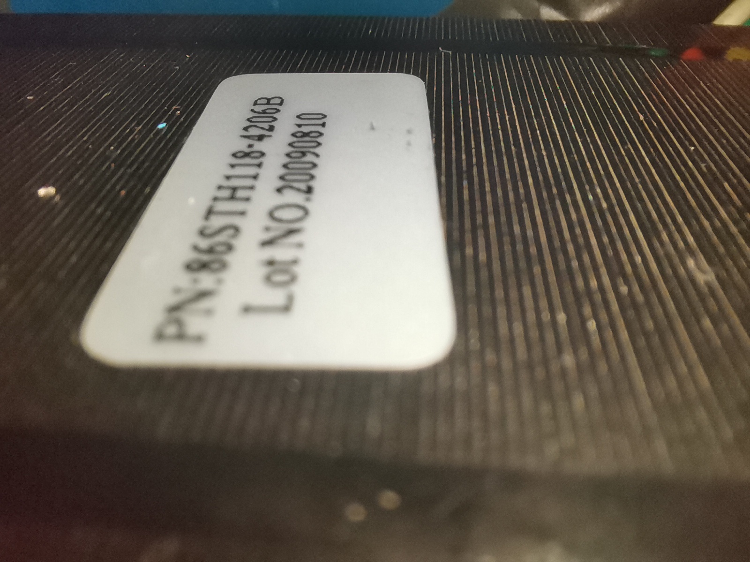
استپرموتور/IMG_20241102_085508.jpg
