ALiReZa4232/SCARA-Robot-Controller/استپرموتور/IMG_20241102_090846.jpg

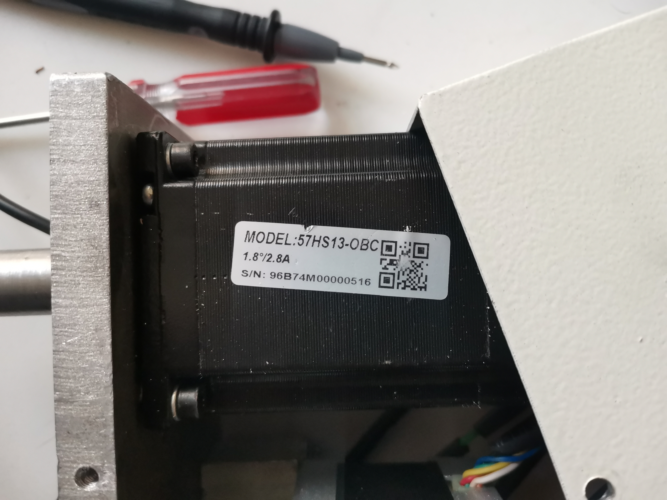
استپرموتور/IMG_20241102_090846.jpg
