ALiReZa4232/SCARA-Robot-Controller/تصاویر پروژه/IMG_20240221_141424.jpg

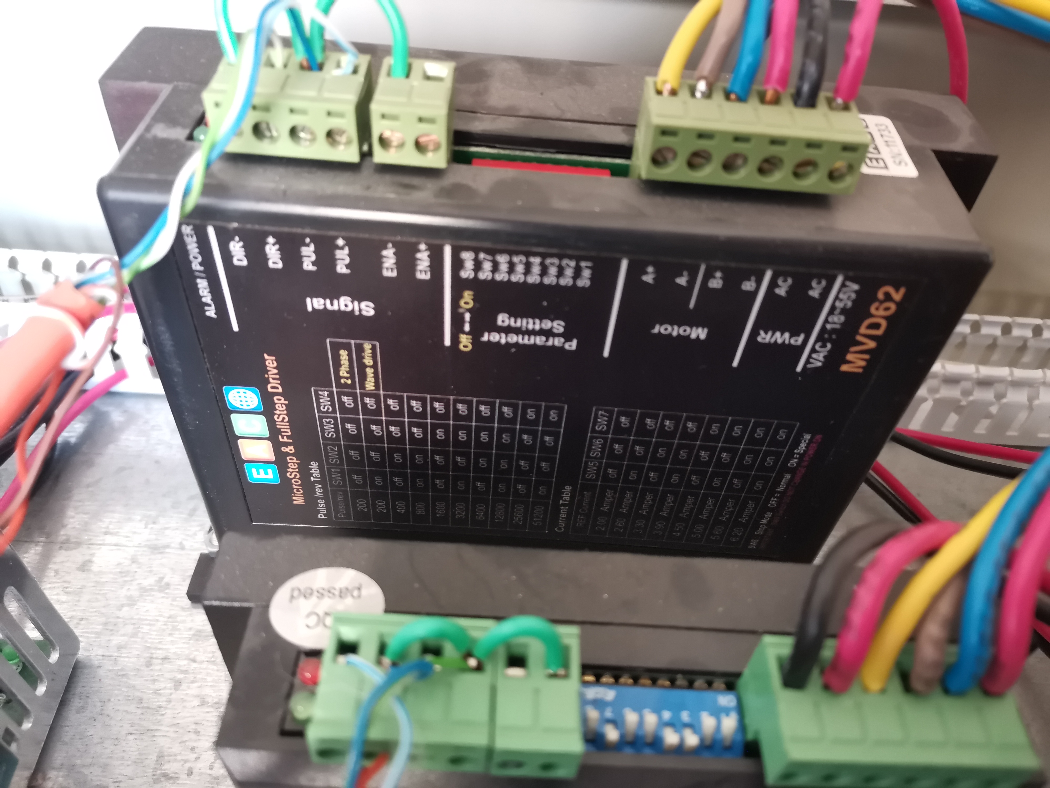
تصاویر پروژه/IMG_20240221_141424.jpg
