ALiReZa4232/SCARA-Robot-Controller/تصاویر پروژه/IMG_20240221_141428.jpg

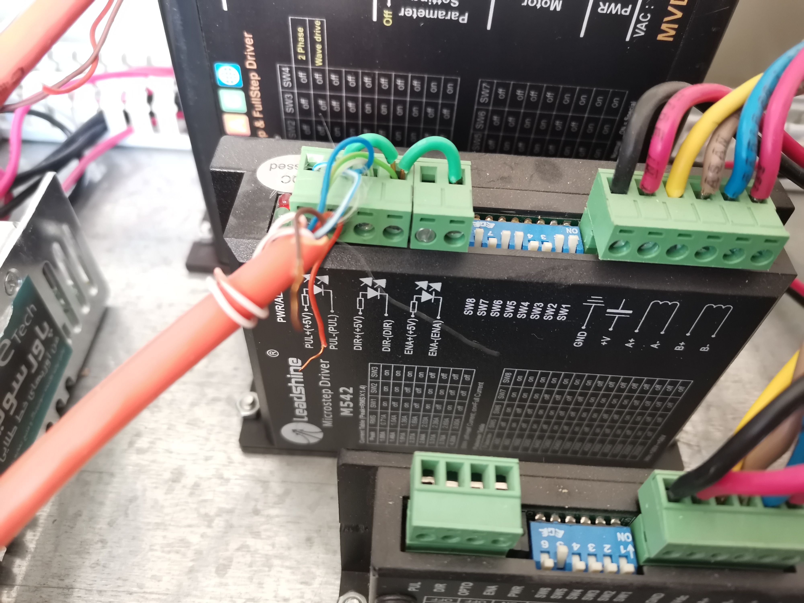
تصاویر پروژه/IMG_20240221_141428.jpg
