ALiReZa4232/SCARA-Robot-Controller/تصاویر پروژه/IMG_20240221_141432.jpg

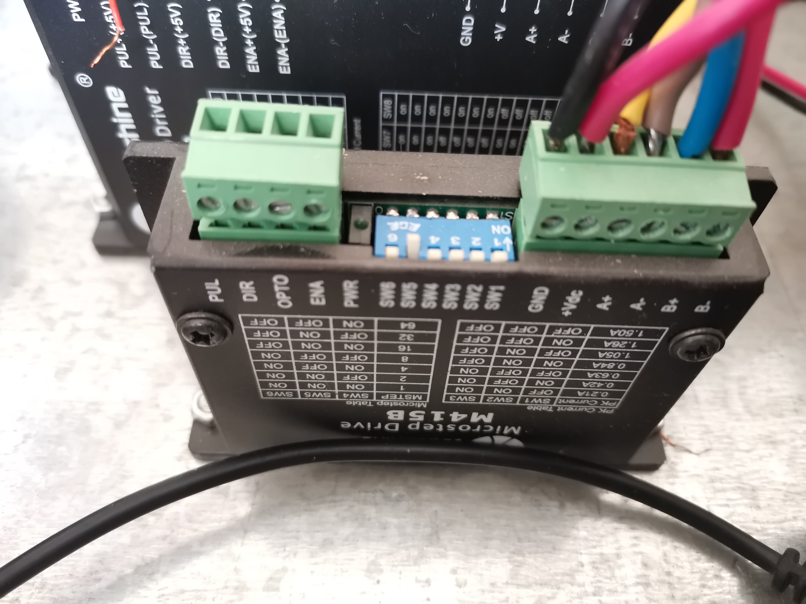
تصاویر پروژه/IMG_20240221_141432.jpg
