ALiReZa4232/SCARA-Robot-Controller/تصاویر پروژه/IMG_20241116_095925.jpg

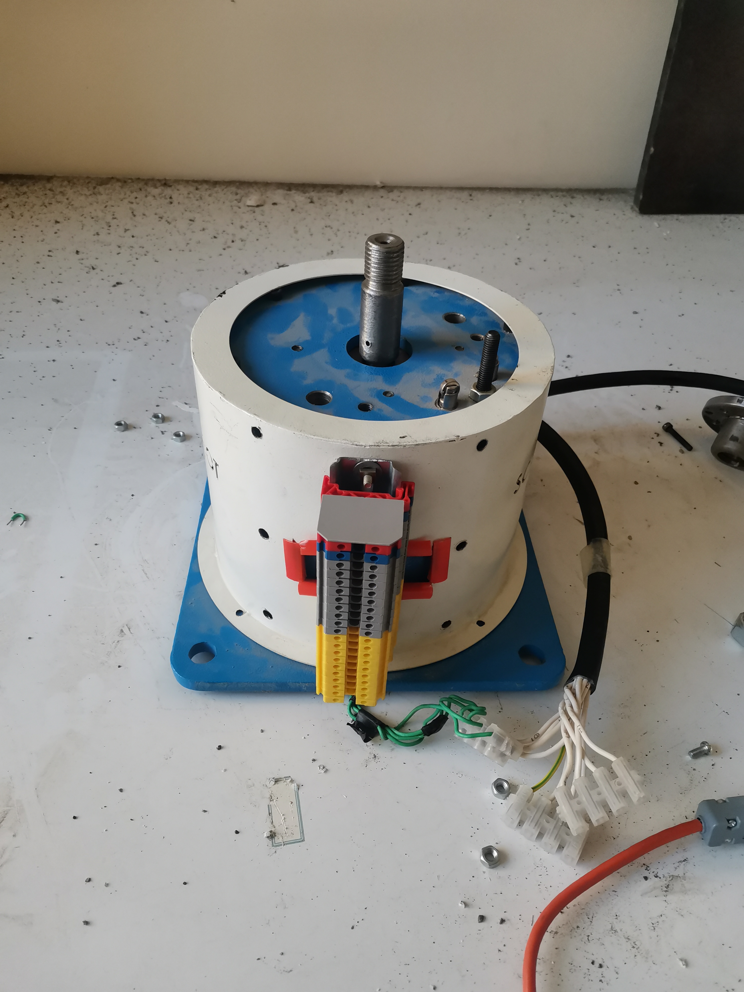
تصاویر پروژه/IMG_20241116_095925.jpg
