ALiReZa4232/SCARA-Robot-Controller/تصاویر پروژه/IMG_20241116_114157.jpg

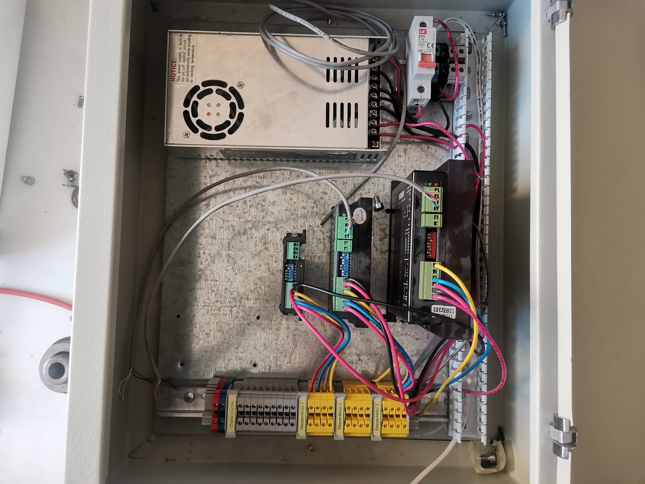
تصاویر پروژه/IMG_20241116_114157.jpg
