ALiReZa4232/SCARA-Robot-Controller/تصاویر پروژه/IMG_20241118_130505.jpg

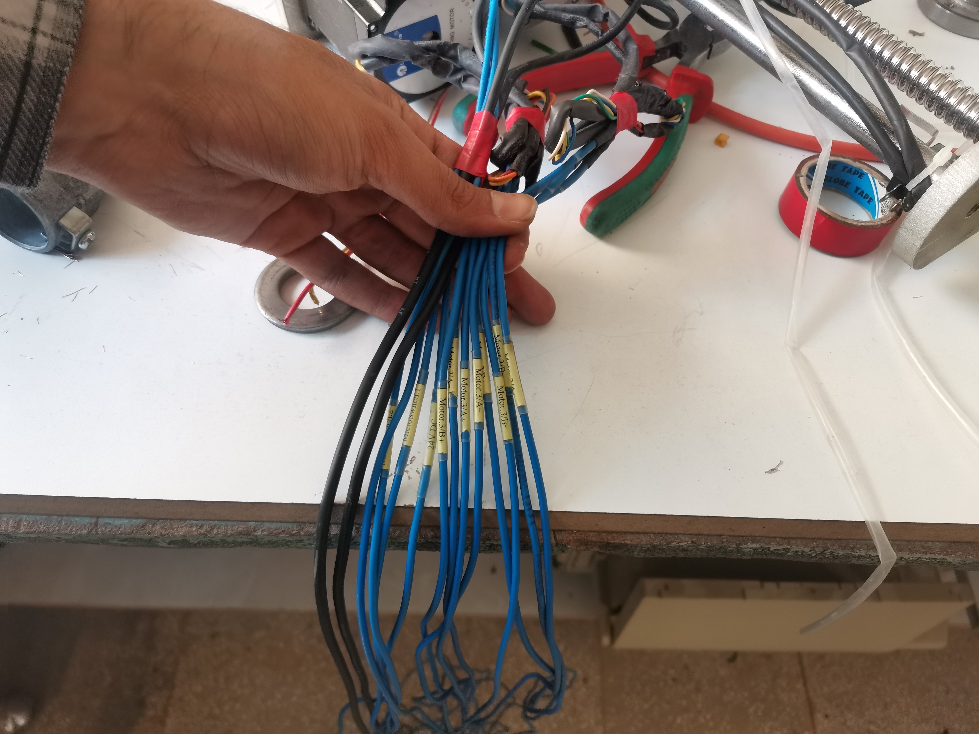
تصاویر پروژه/IMG_20241118_130505.jpg
