ALiReZa4232/SCARA-Robot-Controller/تصاویر پروژه/IMG_20241127_123937.jpg

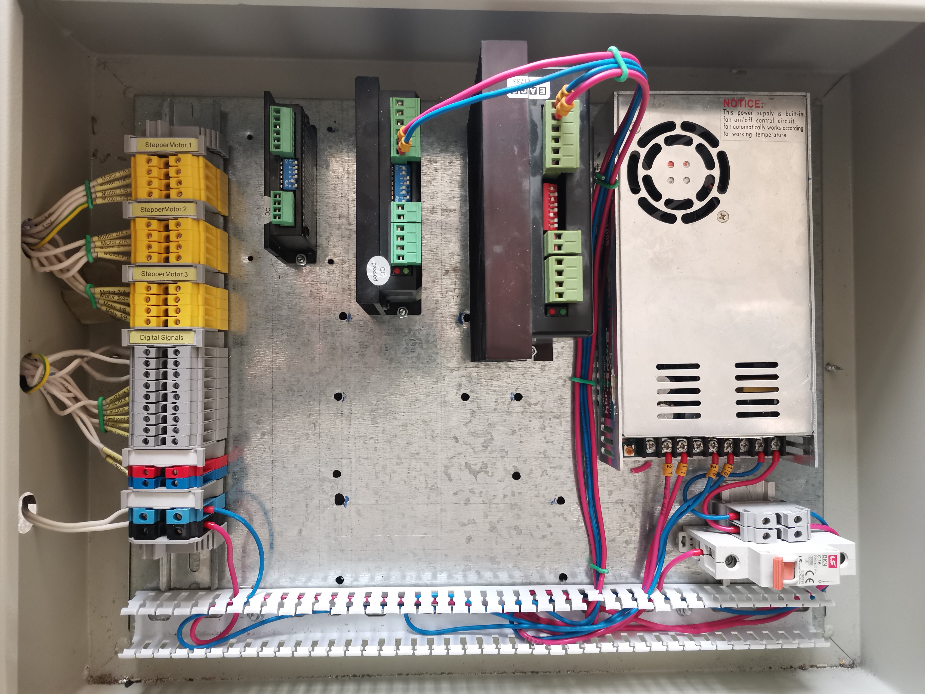
تصاویر پروژه/IMG_20241127_123937.jpg
