ALiReZa4232/SCARA-Robot-Controller/تصاویر پروژه/IMG_20250202_110822.jpg

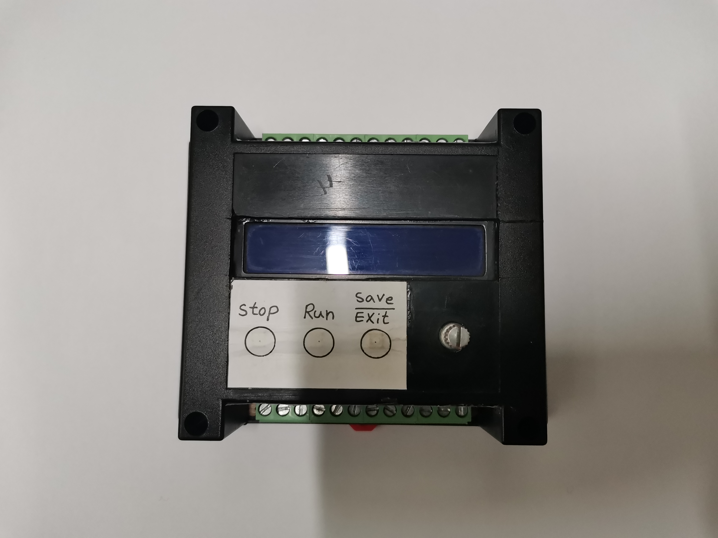
تصاویر پروژه/IMG_20250202_110822.jpg
