ALiReZa4232/SCARA-Robot-Controller/درایو استپرموتور/M415B.jpg

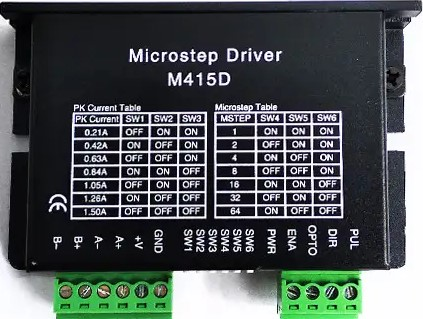
درایو استپرموتور/M415B.jpg
