ALiReZa4232/SCARA-Robot-Controller/درایو استپرموتور/M542.jpg

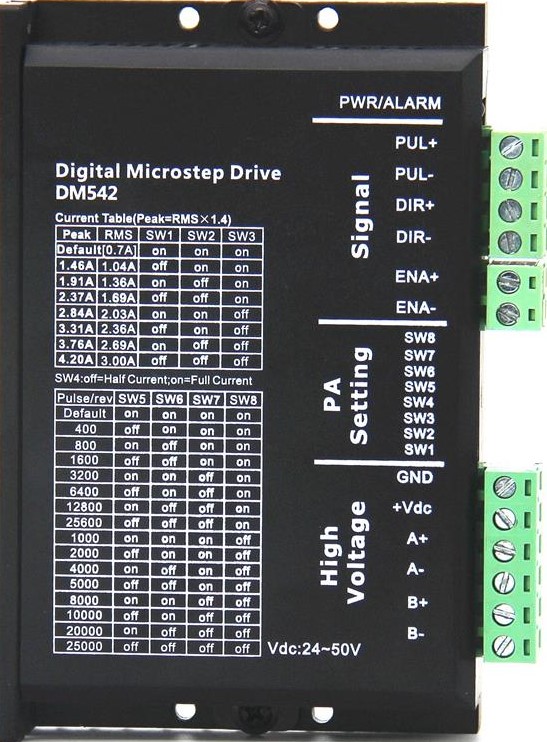
درایو استپرموتور/M542.jpg
