ALiReZa4232/SCARA-Robot-Controller/درایو استپرموتور/MVD62.jpg

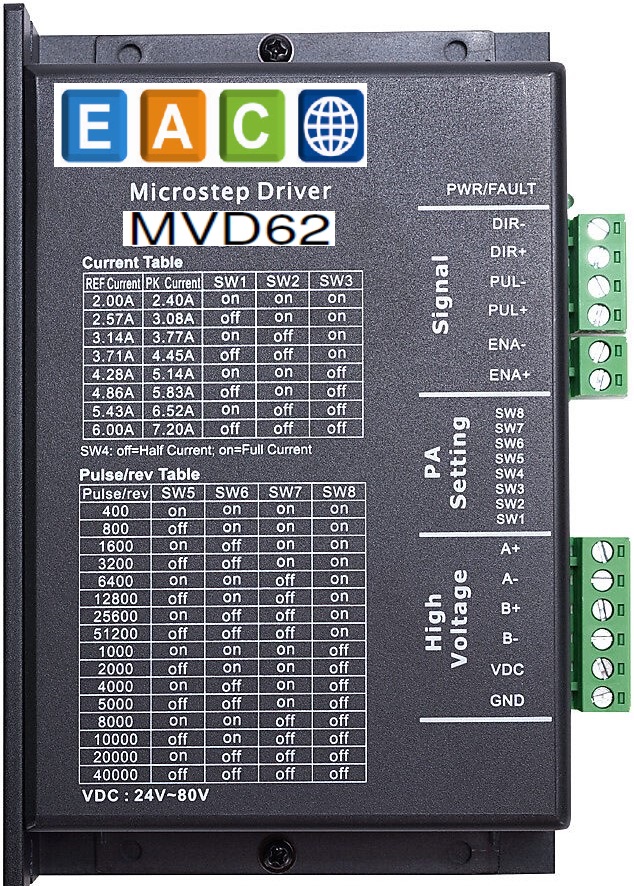
درایو استپرموتور/MVD62.jpg
