ALiReZa4232/SCARA-Robot-Controller/Stepper Controller Schematic.pdf

# Top Screw Terminals

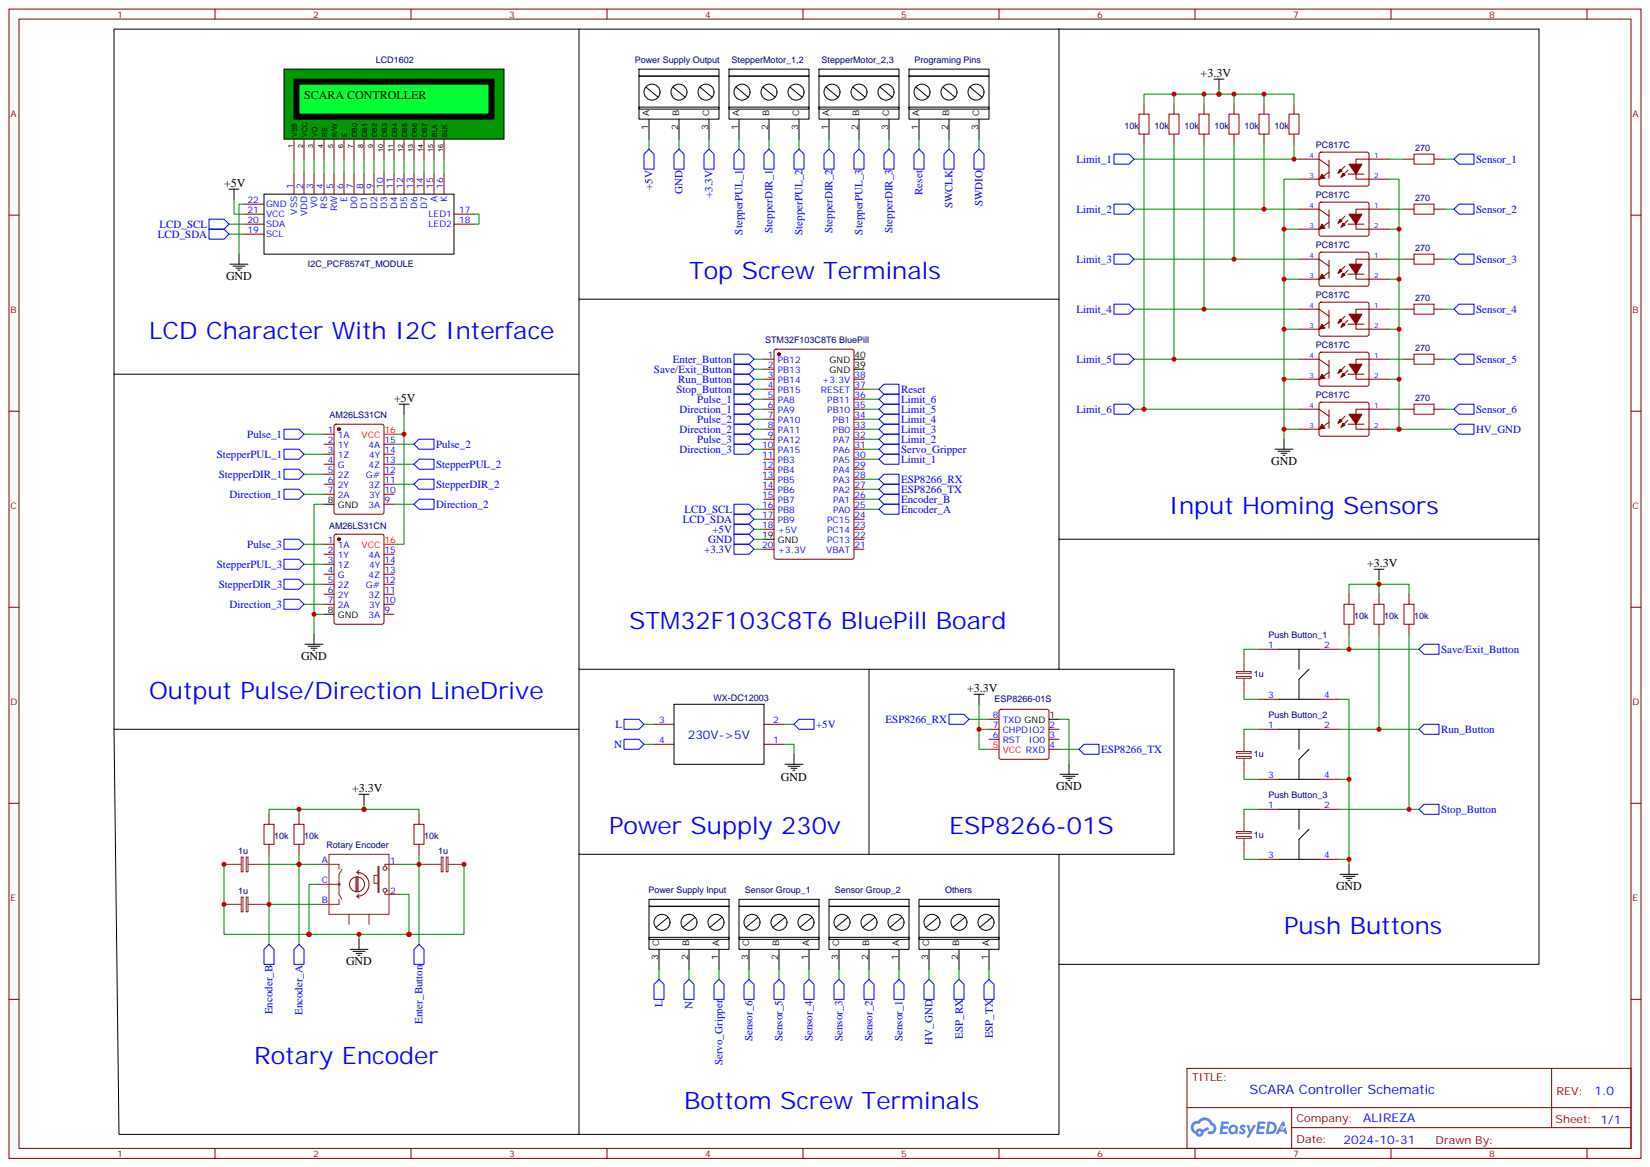
[picture p173: page 1]

GND
LCD Character With I2C Interface

Output Pulse/Direction LineDrive
