ALiReZa4232/SCARA-Robot-Controller/SCARA Wiring.pdf

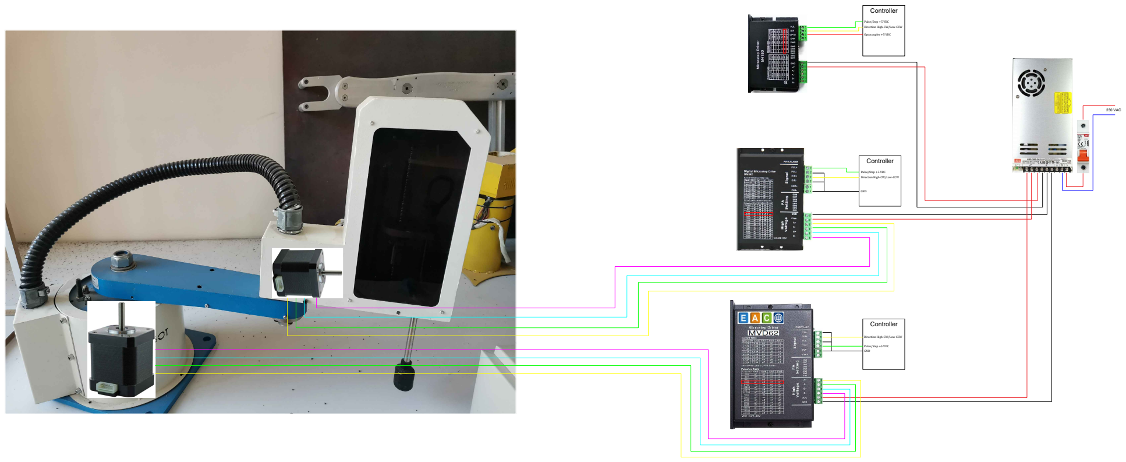
[picture p174: page 1]

230 VAC Controller Controller Controller Pulse/Step +5 VDC Direction High-CW/Low-CCW Optocoupler +5 VDC Pulse/Step +5 VDC Direction High-CW/Low-CCW GNDPulse/Step +5 VDC Direction High-CW/Low-CCW GND
