ALiReZa4232/SCARA-Robot-Controller/Controller Menu.pdf

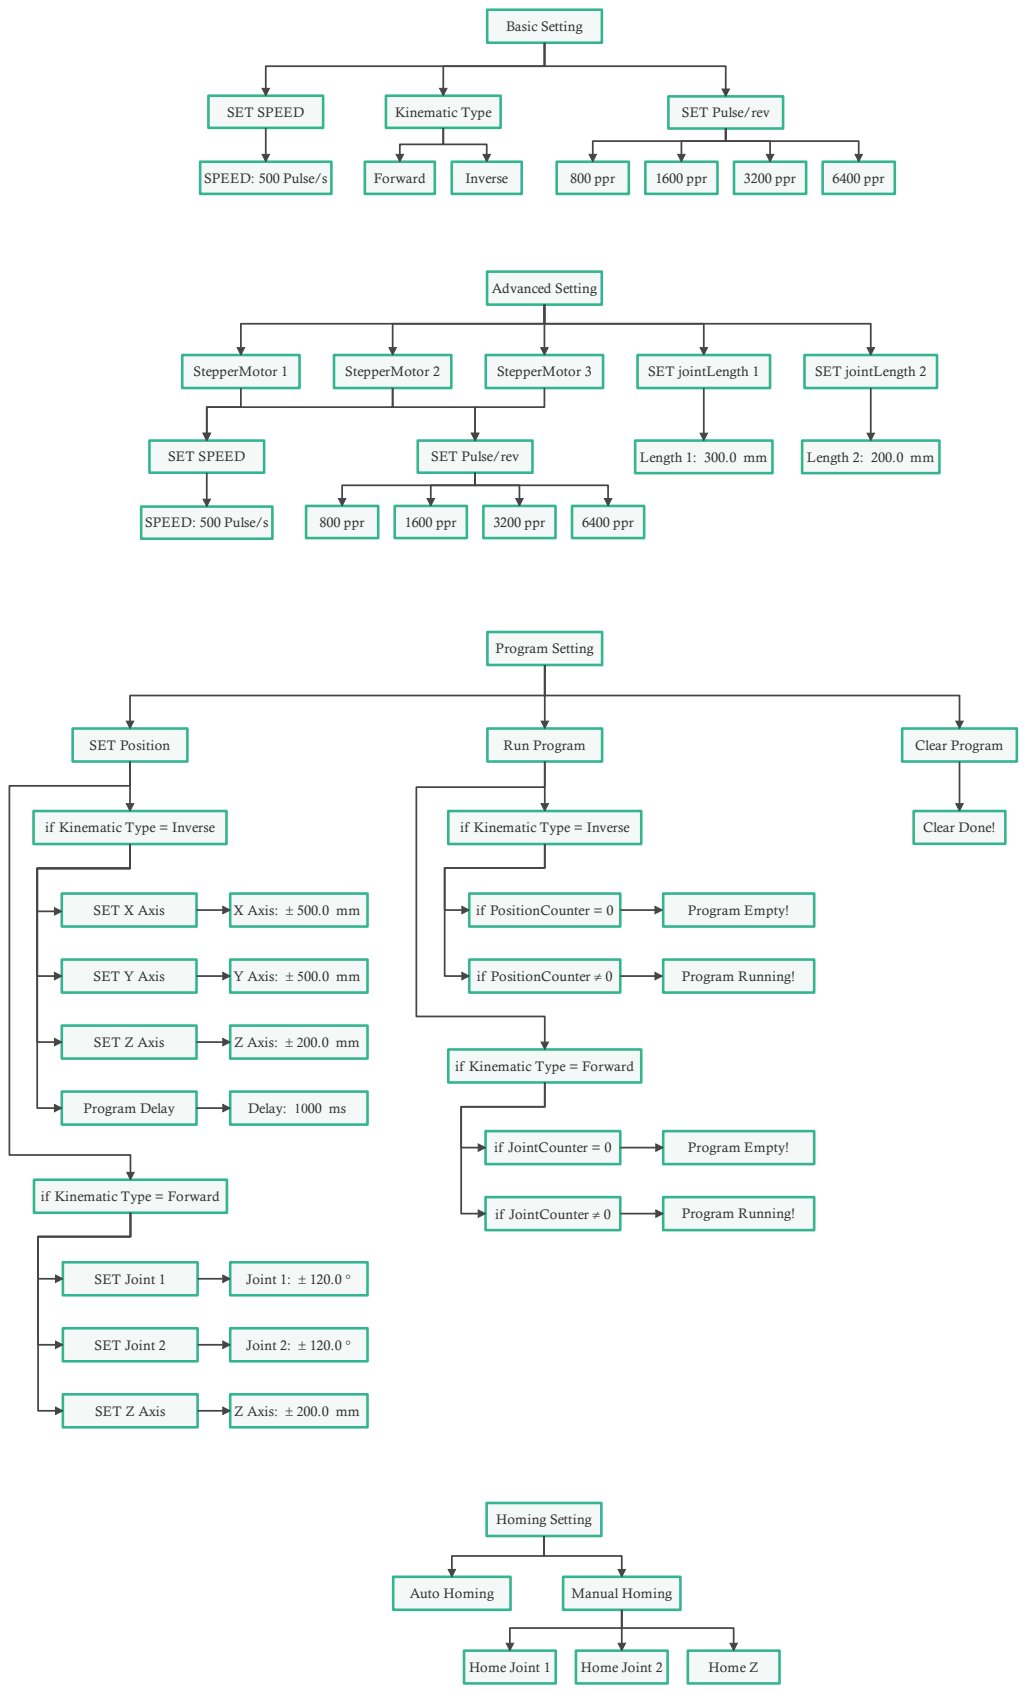
[picture p175: page 1]
Basic Setting; Advanced Setting; Program Setting; Homing Setting; Kinematic Type; StepperMotor 1; StepperMotor 2; StepperMotor 3; SET jointLength 1; SET jointLength 2; Forward; Inverse; Length 1: 300.0 mm; Length 2: 200.0 mm; SET SPEED; Run Program; Clear Program; Clear Done!; if JointCounter = 0; if PositionCounter = 0; if JointCounter ¹ 0; if PositionCounter ¹ 0; Program Empty!; Program Running!; Auto Homing; Manual Homing; Home Joint 1; Home Joint 2; Home Z; SPEED: 500 Pulse/s; 800 ppr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

SET Pulse/rev

if Kinematic Type = Inverse

if Kinematic Type = Forward
