ALiReZa4232/SCARA-Robot-Controller/(commit log)

2025-03-08 Create StepperMotor Datasheets
2025-05-05 Create استپر موتور
2025-05-05 پایان نامه
2025-05-05 کدهای کنترلر ربات اسکارا
2025-05-05 دیتاشیت استپرموتورهای ربات اسکارا
2025-05-05 دیتاشیت درایوهای استپرموتور
2025-05-05 مستندات پروفایل های کنترل حرکت
2025-05-05 تصاویر پروژه ربات اسکارا
2025-05-05 مدلسازی سینماتیکی ربات اسکارا
2025-05-05 کنترل از راه دور ربات اسکارا
2025-05-05 فلوچارت عملکرد منوی کنترلر
2025-05-05 سیم کشی داخلی ربات اسکارا
2025-05-05 شماتیک کنترلر ربات اسکارا
2025-05-05 لیست قیمت تجهیزات
2025-05-05 شبیه سازی در متلب
2025-05-05 تست کد در محیط برنامه نویسی کیل
2025-05-05 تست پروفایل حرکتی در محیط کیل
2025-05-05 ویرایش پنجم پایان نامه کنترلر ربات اسکارا
    برای دریافت فایل ورد پایان نامه لطفا به کتابخانه دانشکده شهید منتظری مراجعه بفرمایید
2025-05-05 وب سرور کنترلر
2025-05-05 محاسبات سینماتیک ربات اسکارا
2025-05-05 تصاویر ربات اسکارا
2025-05-05 دیتاشیت استپرموتورها
